AMSAT-NA/fox-plus/structure/3d_models/CommercialFrame/4.jpg

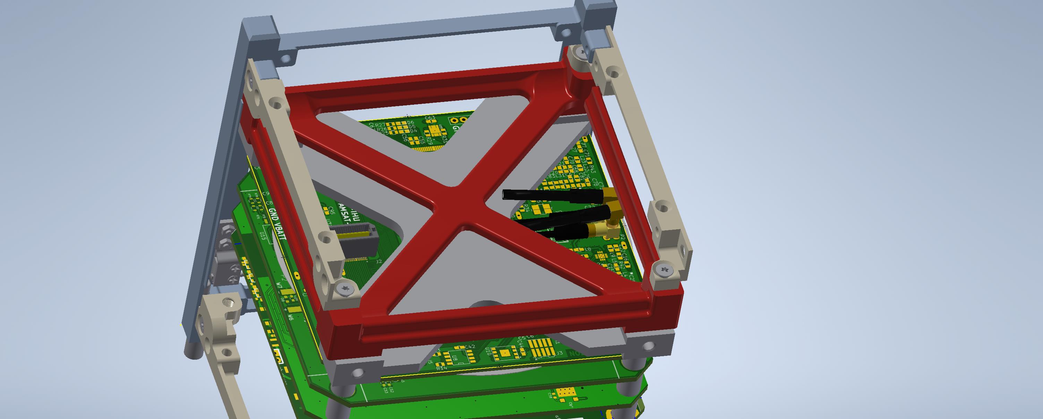
structure/3d_models/CommercialFrame/4.jpg
