AMSAT-NA/fox-plus/mechanical/README.md

# Fox-Plus Mechanical

This is the home for the Fox-Plus Mechanical Team. Here we store all mechanical models, drawings, spec sheets, presentations, and documents.

## Description

The Mechanical team is responsible for all mechanical aspects of the Fox-Plus line of Amateur Satellites. 

## Authors

Andrew Robinson
