AMSAT-NA/fox-plus/mechanical/presentations/FoxPlusA_Images.pptx

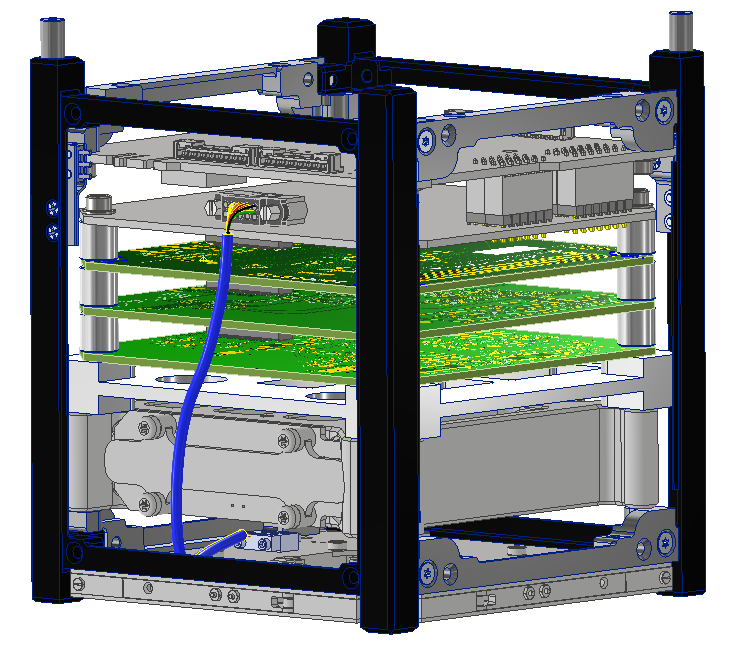
[picture p3: figure]

ISISpace 1U Frame

ISISpace Power Integration Unit (PIU)

FOX-ME-204 Power Signal Adapter (PSA)

LIHU

ICR

RXTX

FOX-ME-203 Mechanical Adapter

ISISpace Power Battery Pack (PBP)

ISISpace AntS

## Slide 2

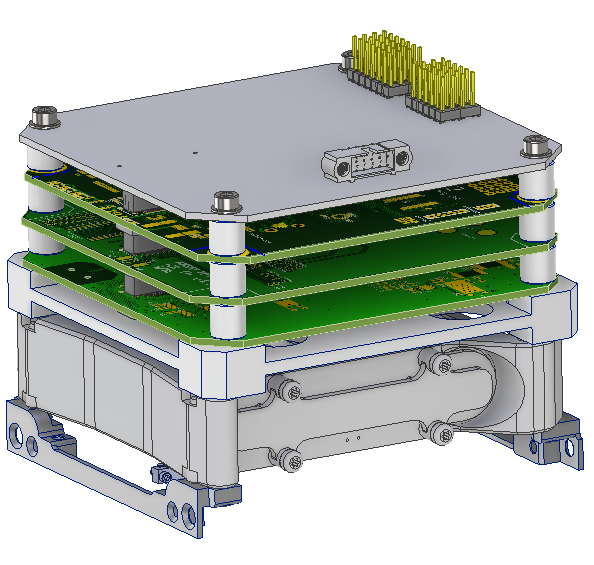
[picture p4: figure]
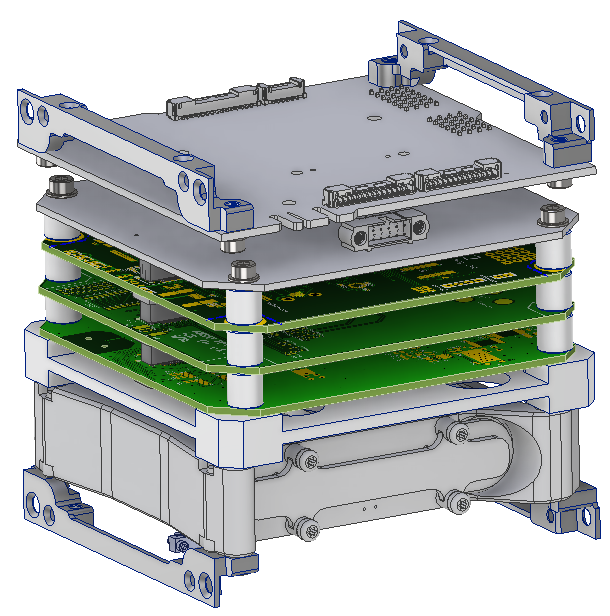
[picture p5: figure]
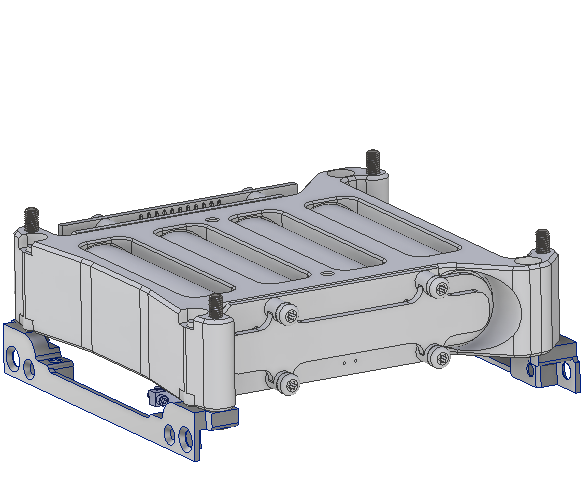
[picture p6: figure]
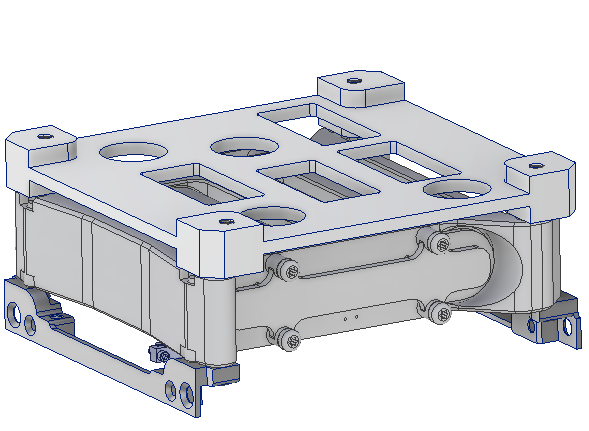
[picture p7: figure]

## Slide 3

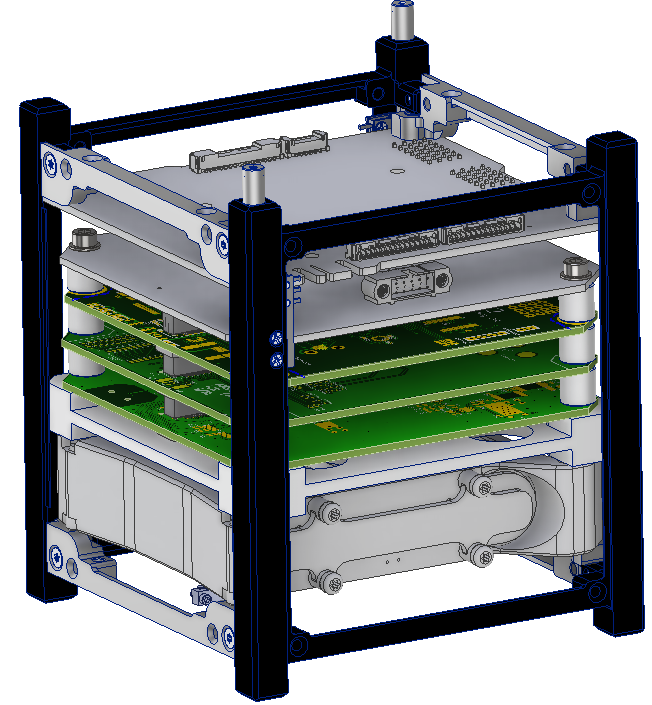
[picture p8: figure]
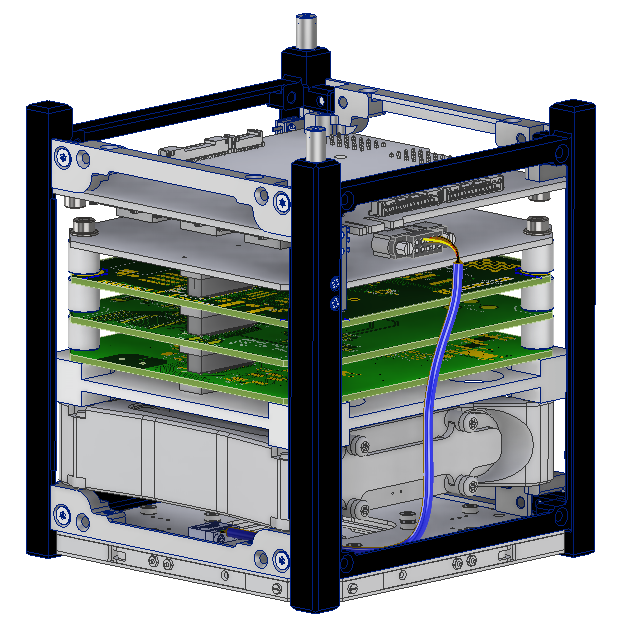
[picture p9: figure]

## Slide 4

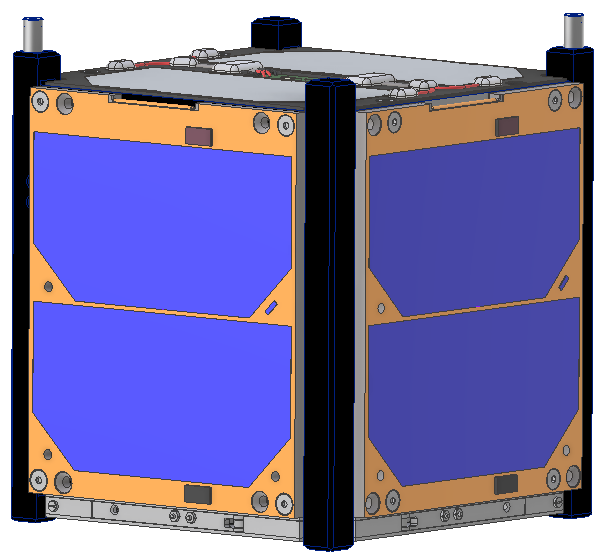
[picture p10: figure]

## Slide 5

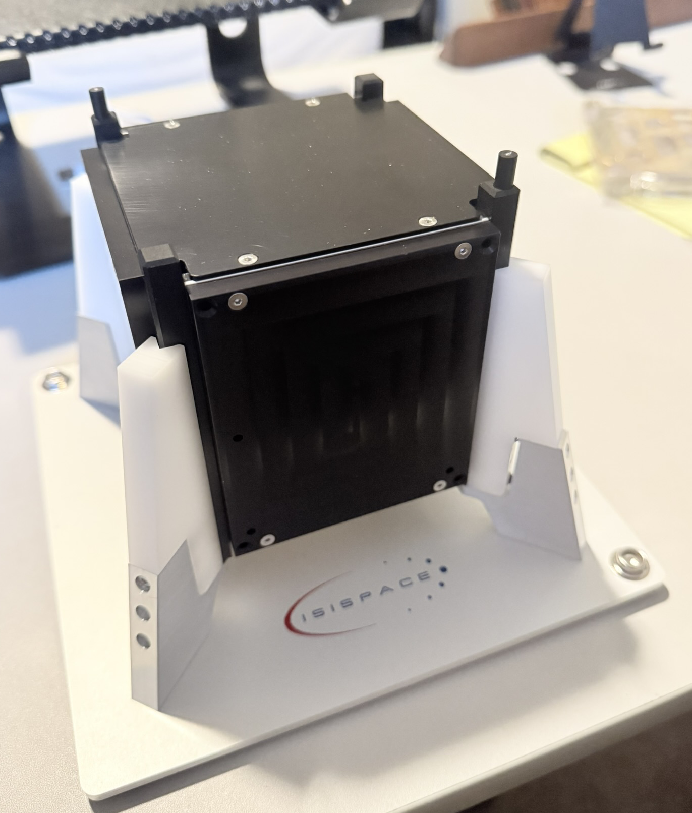
[picture p11: figure]
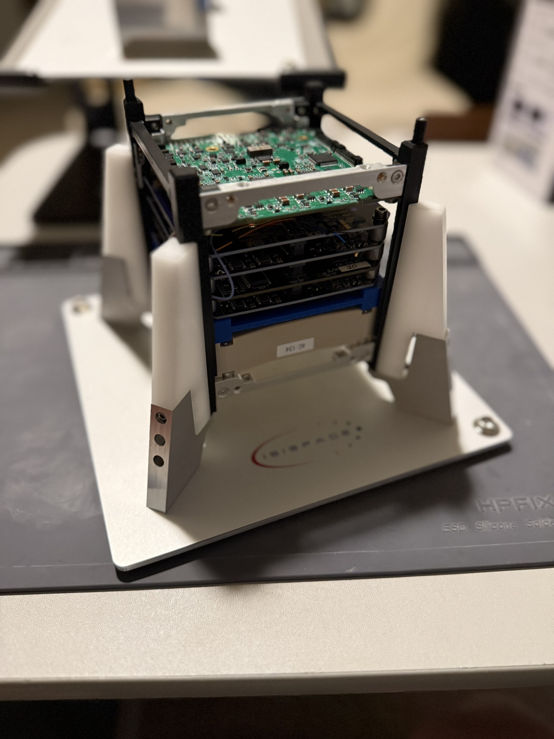
[picture p12: figure]

## Slide 6

## Slide 7

## Slide 8
