AMSAT-NA/fox-plus/mechanical/presentations/FoxPlusMechanical_20260218.pptx

## Fox Plus Mechanical

Topic: Umbilical Connector

Andrew Robinson
KA3WDW
18Feb2026

## Slide 2

FoxPlus-A Umbilical Concept

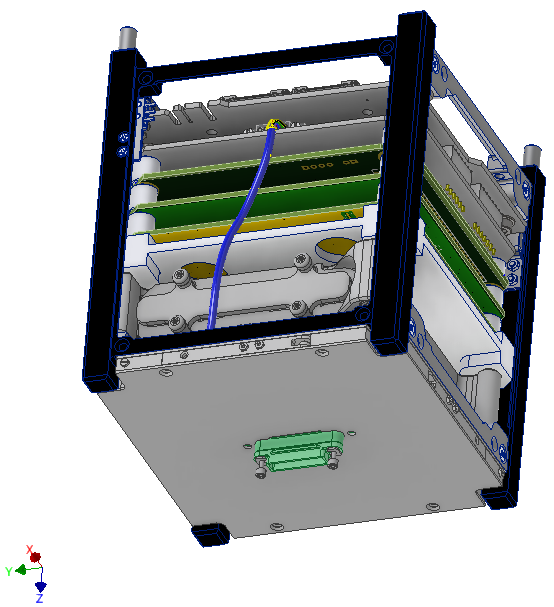
[picture p13: figure]

Harwin G125-3242696M5

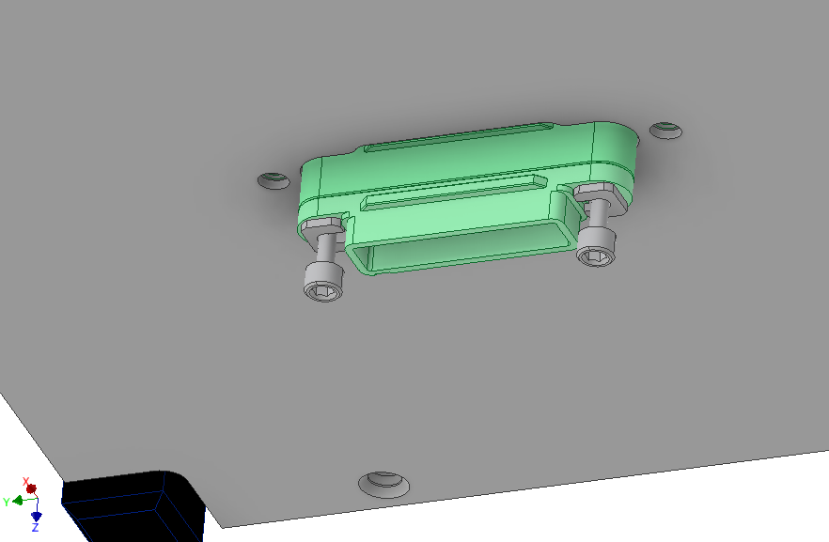
[picture p14: figure]

Harwin G125-2242696F1

## Slide 3

FoxPlus-A Umbilical Concept

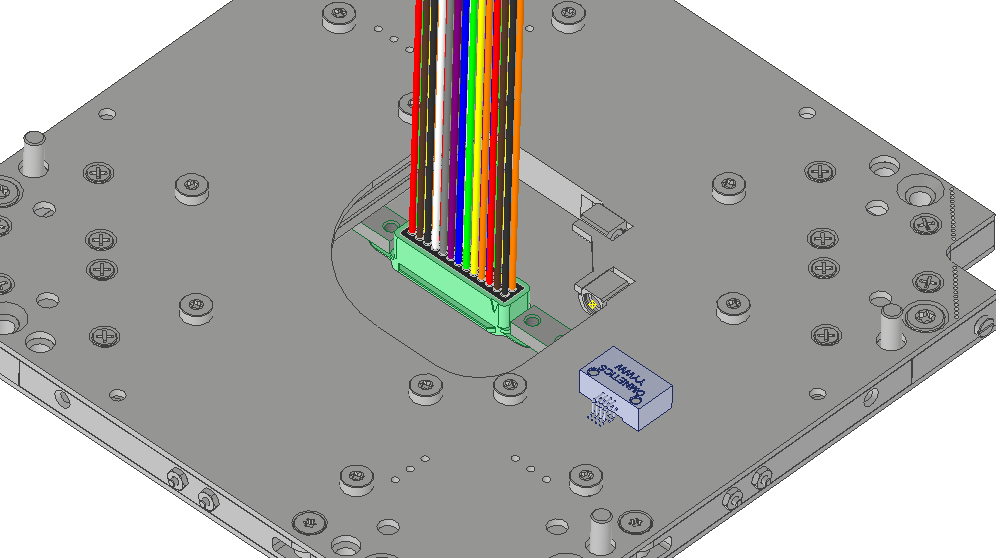
[picture p15: figure]

ISISpace AntS

## Slide 4

Umbilical Connector +Z-Face Protrusion

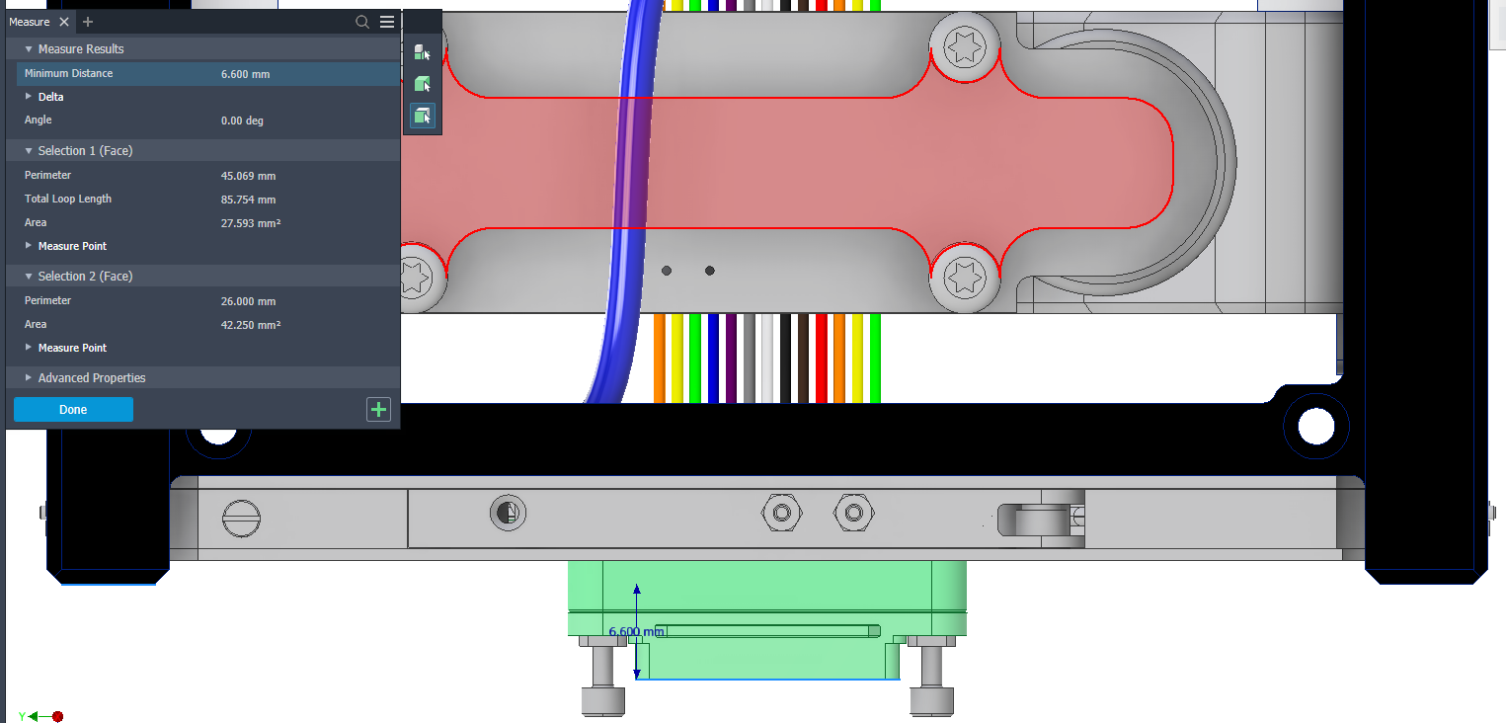
[picture p16: figure]

6.600 mm

## Slide 5

CubeSat Design Specification Rev. 14

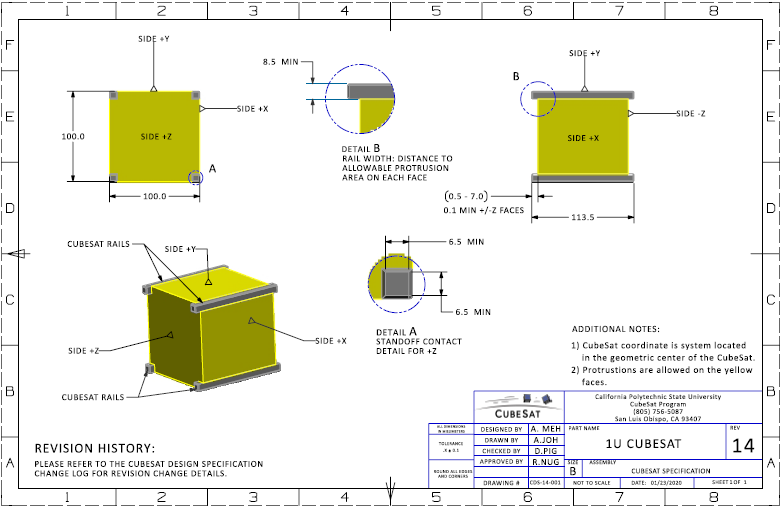
[picture p17: figure]

## Slide 6

Optional Connector – 34 Pin

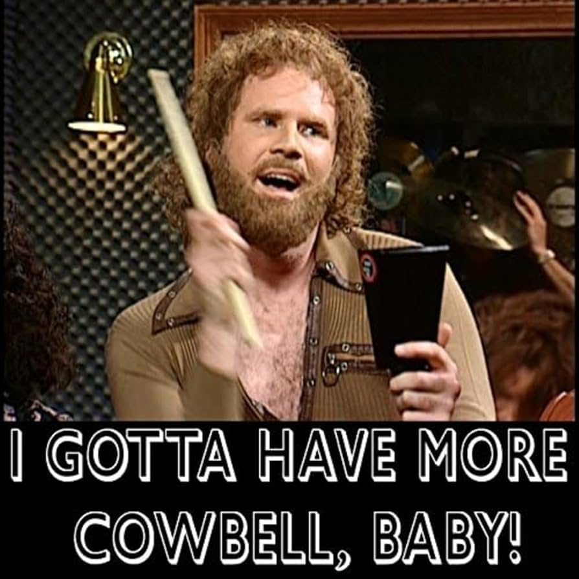
[picture p18: figure]
More Cowbell Decal "More Cowbell" Funny Bumper Sticker - Saturday Night Live SNL Skit Quote With Free Magnetizer Will Ferrell Novelty

PINS

Minor interference

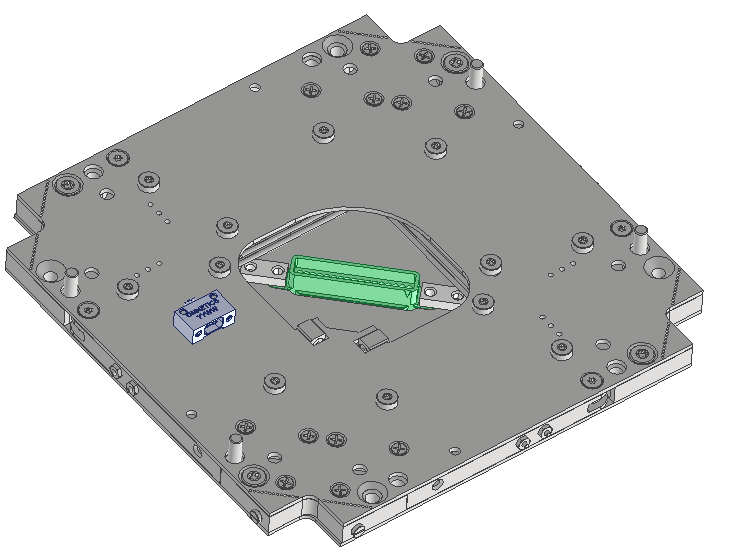
[picture p19: figure]
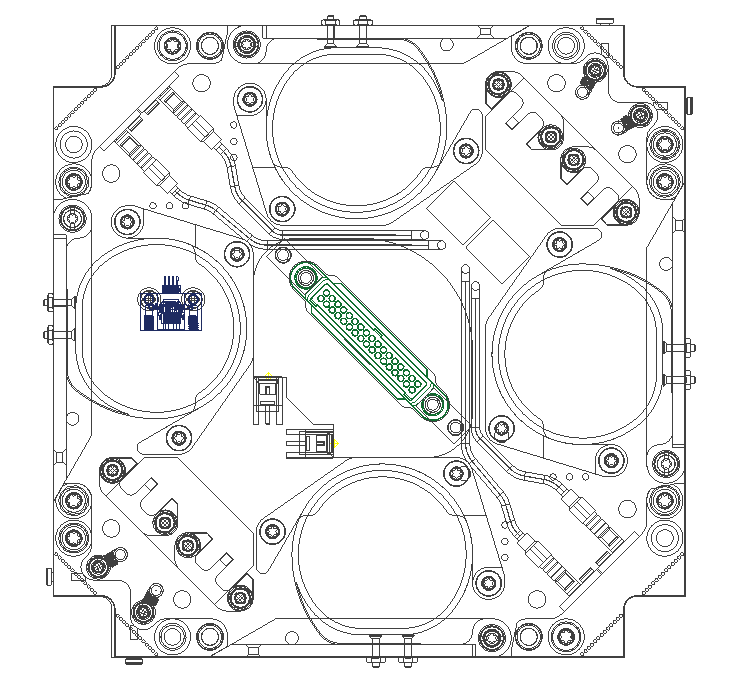
[picture p20: figure]

Harwin G125-3243496M5
