AMSAT-NA/fox-plus/mechanical/presentations/FoxPlusMechanical_20241211.pptx

## Fox+ Mechanical

Andrew Robinson
KA3WDW
11Dec2024

## Motivation

PC-104

CSKB

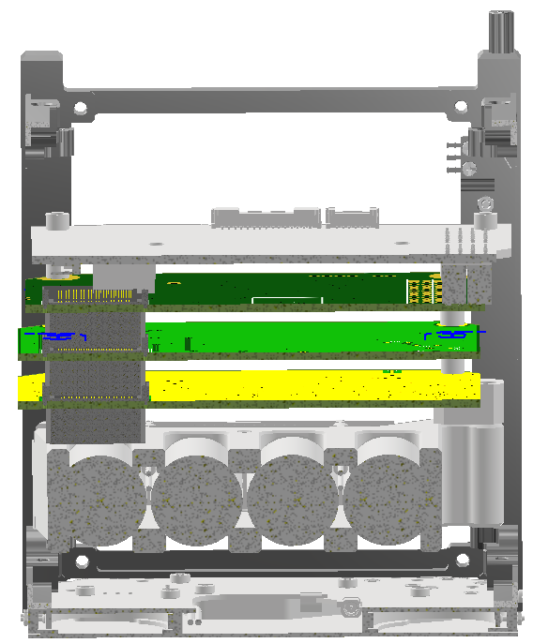
[picture p21: figure]

Unfavorable Alignment

X-Section

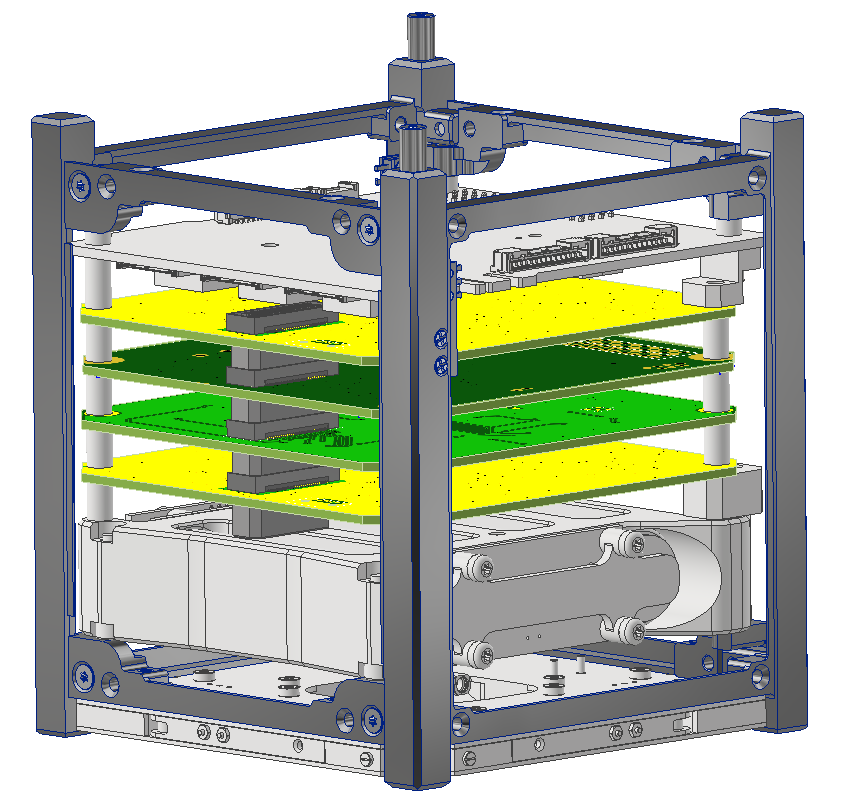
[picture p22: figure]

ISISpace PIU

Mate via PC-104 and CSKB

LIHU

REMOVED

## Idea

Is this correct?

Reposition PC-104 to mate with ISISpace EPS CSKB

95 mm

92 mm

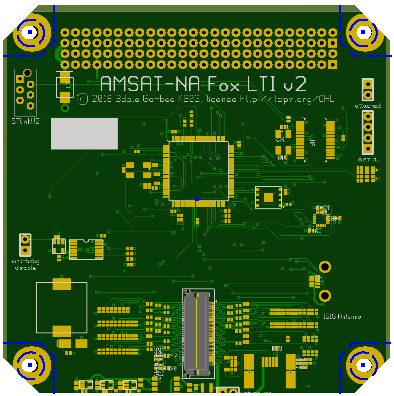
[picture p23: figure]
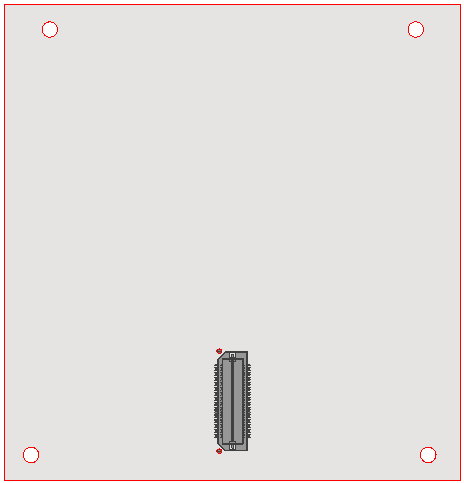
[picture p24: figure]

95 mm

TBD Modifications

96 mm

Maintain QxH location

ME-113 PCB

ISISpace PCB

Mounting thru holes (x4)
