AMSAT-NA/fox-plus/mechanical/presentations/FoxPlusMechanical_20241219.pptx

## Fox+ Mechanical

Andrew Robinson
KA3WDW
19Dec2024

## Slide 2

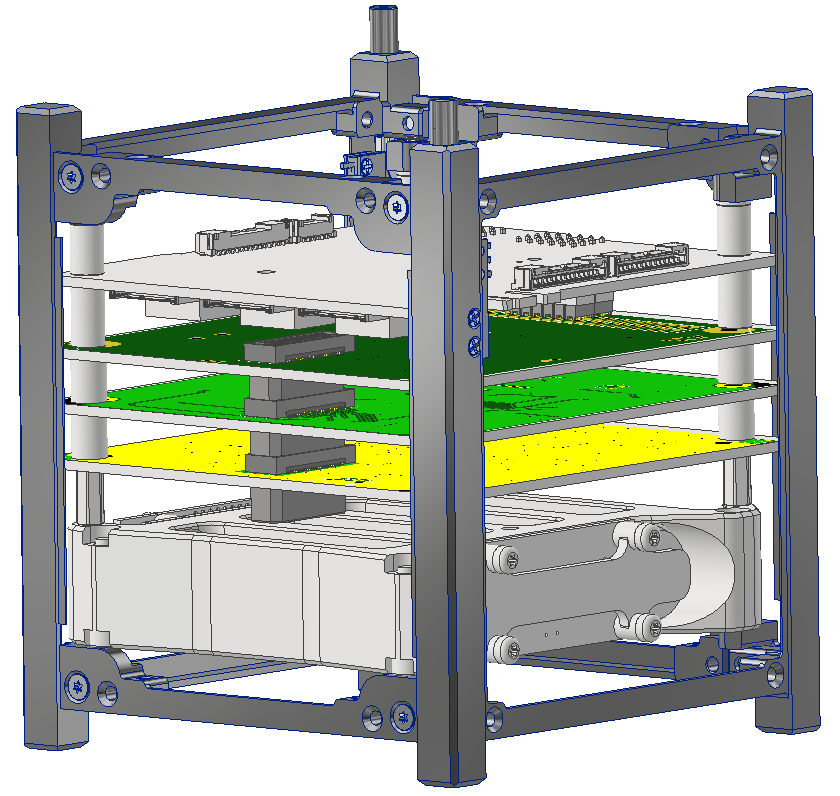
[picture p30: figure]

## Slide 3

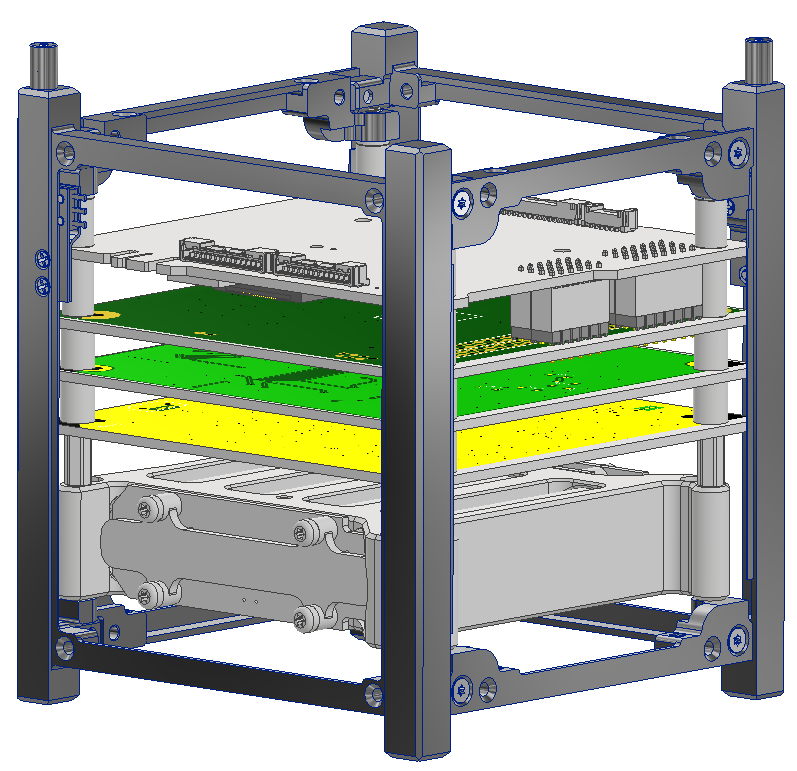
[picture p31: figure]

Only 9.761mm

(2) MTSW-107-08-L-D

(2) MTSW-106-08-L-D

## Slide 4

LIHU w/Header Pins

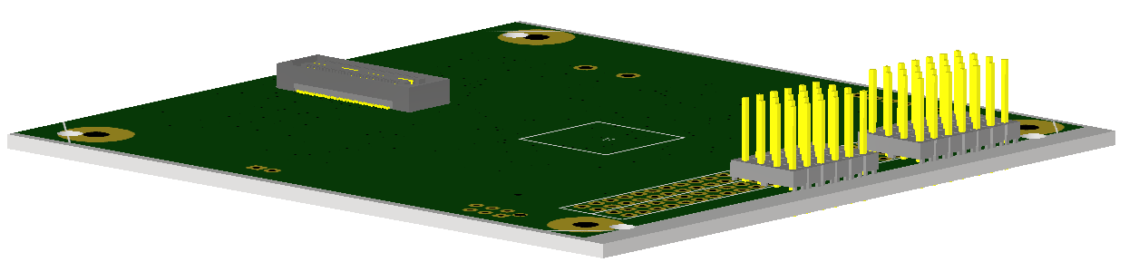
[picture p32: figure]

## Slide 5

Stack Up Hardware

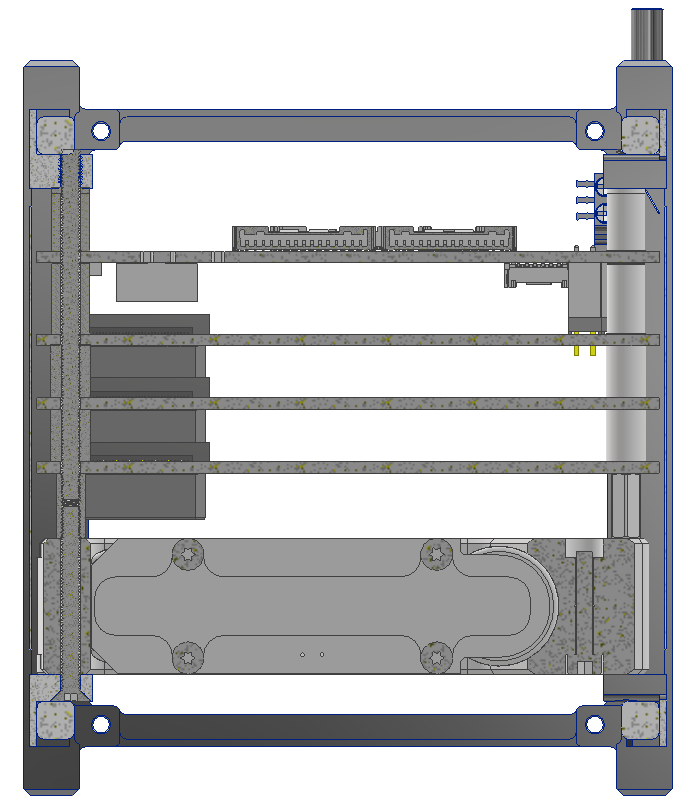
[picture p33: figure]

9mm Spacer + Shim (COTS)

M3 Threaded Rod (COTS + Machined to Length)

11mm Spacer (COTS)

FOX-ME-117-01 Spacers

M3x10mm Threaded Standoff (COTS)

(Made this 10mm instead of 8mm to enable sufficient thread engagement for M3x30 c’sunk and threaded rod)

M3x30mm C’Sunk Fastener (COTS)

X-Section View
