AMSAT-NA/fox-plus/mechanical/presentations/FoxPlusMechanical_20241221.pptx

## Fox+ Mechanical

Andrew Robinson
KA3WDW
21Dec2024

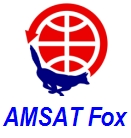
[picture p34: figure]

Topic: ISISpace EPS CSKB and LIHU PC-104 Alignment

## Slide 2

ISISpace EPS Board
(Transparent w/ outline)

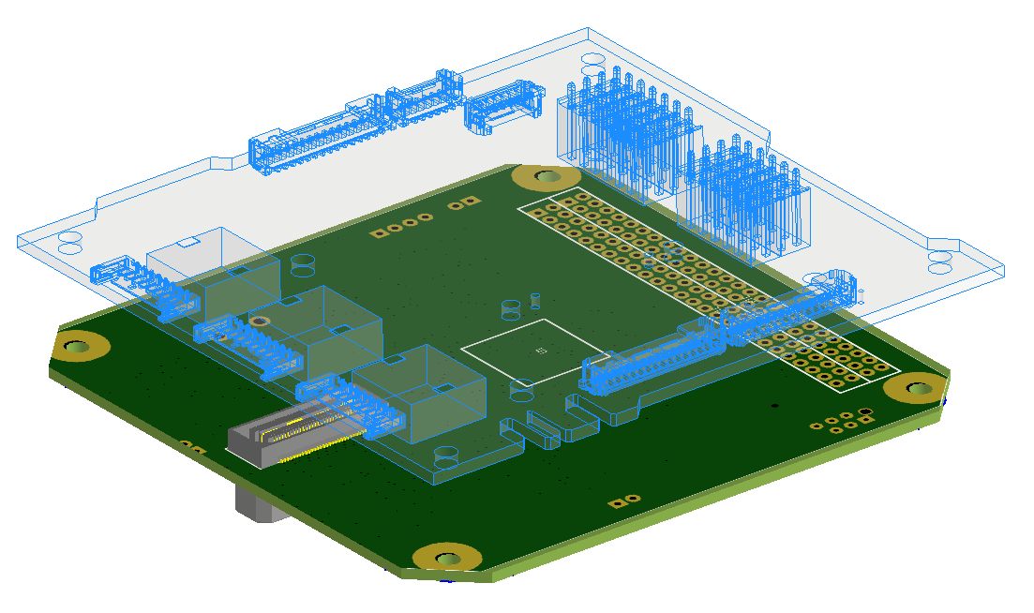
[picture p35: figure]

LIHU

## Slide 3

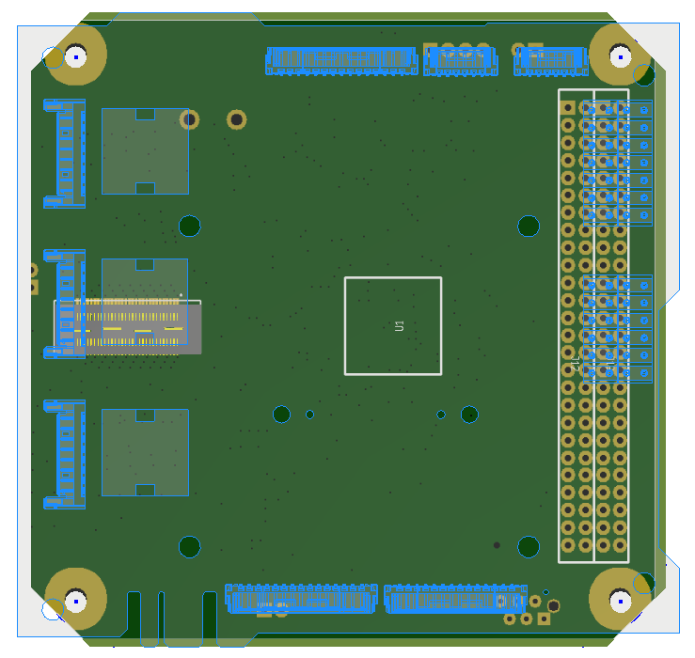
[picture p36: figure]

ISISpace EPS Board
(Transparent w/ outline)

LIHU

## Slide 4

92mm

Centered

The ISISpace EPS bolt holes must stay fixed (to align with the ISISpace frame) but the LIHU can slide to the left and to the right (by 2mm in each direction).

92mm

2mm

2mm

96mm

## Slide 5

LIHU Slid Right

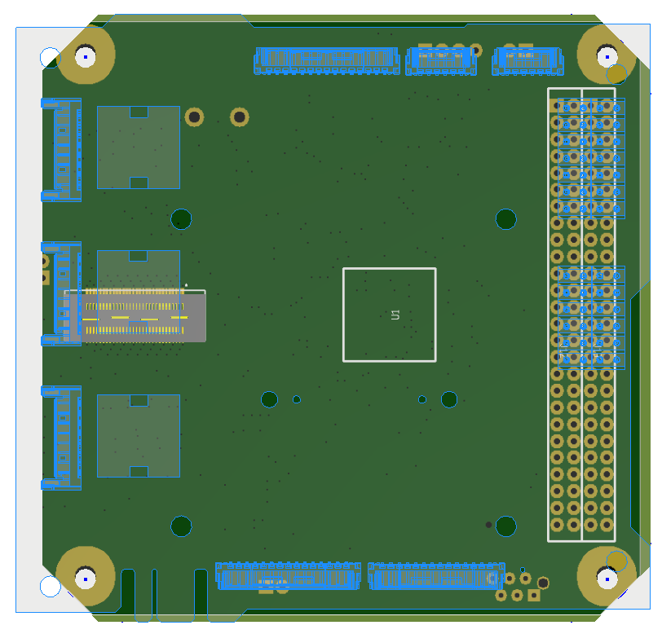
[picture p37: figure]

4mm

## Slide 6

LIHU Slid Left

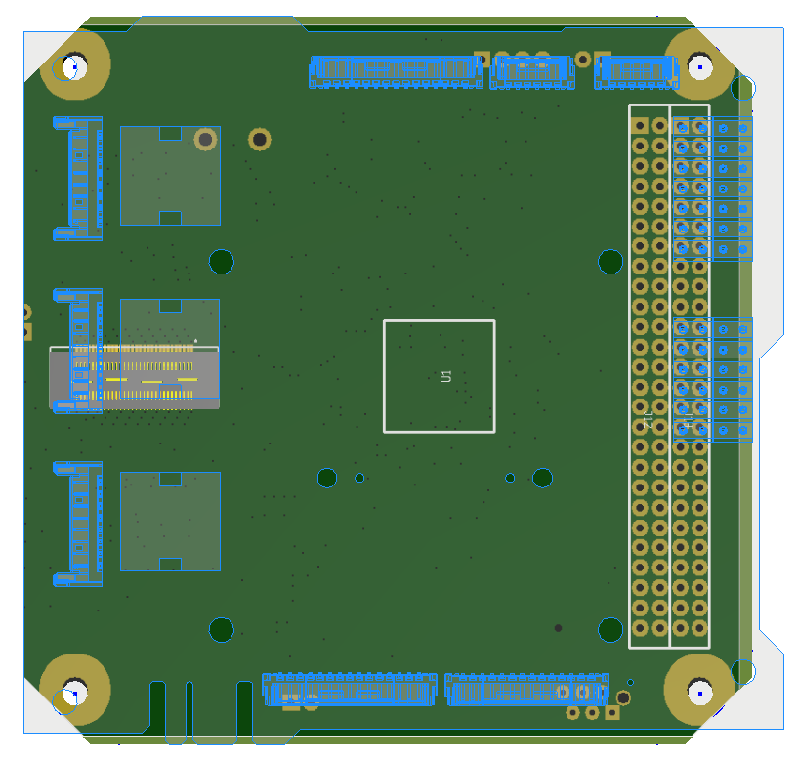
[picture p38: figure]

4mm
