AMSAT-NA/fox-plus/mechanical/presentations/FoxPlusMechanical_20250901.pptx

## Fox Plus Mechanical


Topic: Routing Cables Using Autodesk Inventor Cable and Harness

Andrew Robinson
KA3WDW
1Sept2025

## Slide 2

Model Screenshot


Note: Model currently Work In Progress (WIP)

Harwin M80-5301042 Connector on Power-Signal Adapter

Harwin M80-4611042 Connector

9 wires in user-defined “Segments” to route as desired

Omnetics A29100-009 Connector on AntS

Omnetics A28000-009 Connector

## Slide 3

Cable Drawing

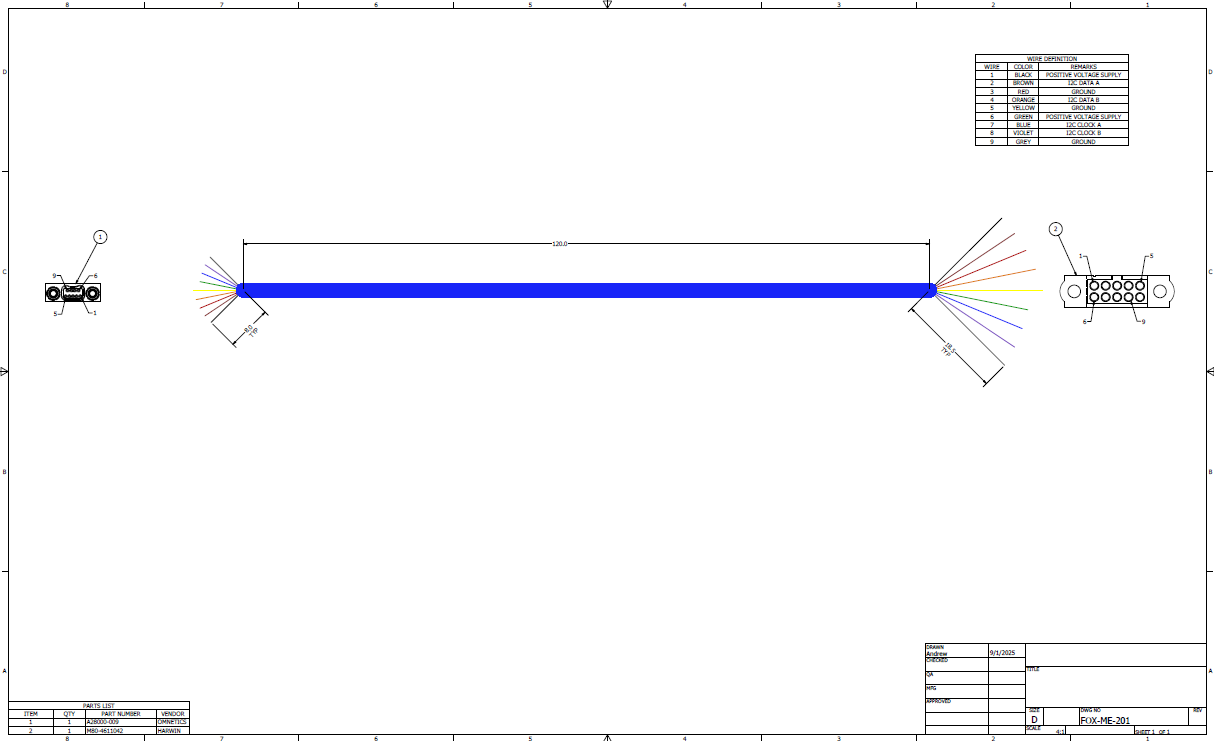
[picture p45: figure]

First cut at a drawing from cable layout

Wire details

Cable lengths

Connector
details

Connector
details

Model-driven BOM
