AMSAT-NA/fox-plus/block_diagram/high_level_block_diagram.pptx

## Fox-Plus-A High-Level Block Diagram

6 Solar
Panels

Power
Supply
Card

Battery
Card

Structure

70 cm
Antenna

Power bus

2 m
Antenna

Science
Payloads

IHU
Card

Magnetic Attitude
Control

RF TxRx
Card

Telemetry
