AMSAT-NA/fox-plus/weekly_engineering_meetings/2023-06-14/ASCENT-FOX+ Slide.odp

Fox-Plus A Block Diagram

1U Structure

Solar Panels

Power

Supply

Card

Battery

Card

6 Solar

Panels

70 cm

Antenna

Power bus

2 m

Antenna

Science

Payloads

IHU

Card

Passive

Magnetic Attitude

Control

Telemetry

RF TxRx

Card

## Slide 2

Fox-Plus-A

Minimum Viable Product

  - Commercial 1U frame (ISISpace)
  - Commercial EPS (ISISpace)
  - LTM
    - C&DH
    - TX/RX
  - RT-IHU (nice to have)
  - Passive attitude control (???)

## Slide 3

Recent Volunteers

## Slide 4

Job Jar

ICR EOL Replacement

Reaction Wheel Driver and Software

Fox-Plus A Launch Options Trade Study

ASCENT Leadership, Fox-Plus Leadership, and/or Volunteer Onboarding (share the fun!)

RT-IHU Board Checkout-Out Test Procedure

Golf-Tee Test Procedures

Thruster Working Group

Physical Golf-TEE Model

## Slide 5

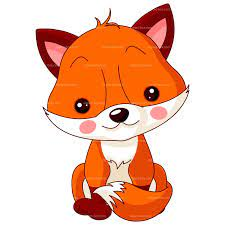
[picture p72: figure]

FOX+

What’s Happening?

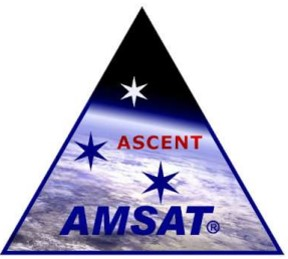
[picture p73: figure]

and

## Slide 6

GOLF-TEE

- Update CONOPS/PDR – Don Mills (present)
- Update SRS – Geoffrey Gentile (present)
- Radiation Research – Carl Wick

## Slide 7

Fox-Plus Systems Engineering

- Objective
  - Advance systems engineering tasks
- Team
  - Mike Moore (contacted)
- Current Activity
  - Frequency Coordination
  - Fox-Plus PDR
    - Jonathan action item: have posted ISISpace data sheets to AMSAT internal gitlab (yet another repository)

## Slide 8

Fox-Plus Structure

- Objective
  - Model the Fox-Plus stack
- Team
  - Thomas Wu (present)
  - Duane Moberg (present)
- Current Activity
  - Need to adapt Fox boards to 1U frame (Thomas, Duane)
  - Model the Fox-Plus stack with LTM and ISISpace EPS (Thomas, Duane)
  - Ordered with 5 – 6 month lead time: (Jonathan) – Our money finally made it to their bank!!!
    - 2 x 1U frame
    - 2 x assembly jig
    - 2 x EPS
    - 1 x Ground Power
    - 2 x Deployable Antenna

## Slide 9

Fox-Plus C&DH (aka IHU) Flight Software

- Objective
  - Fox-Plus flight software
- Team
  - Dave McCoy
  - Chris Grill (present)
  - Will Brozovic (contacted)
- Current Activity
  - Assemble prototype environment (Dave)
  - Bring up LTM (Chris)

## Slide 10

Fox-Plus C&DH (aka IHU) Hardware

- Objective
  - Order a whole stack of LTMs
- Team
  - Leandra MacLennan (present)
  - Arun Kumar
- Current Activity
  - Get me some LTM sets for development (Leandra)
    - Starting on LIHU BoM
  - Order ICR parts (Jonathan)
    - Done (almost)!
  - ICR Assembly (Arun Kumar)
    - Jonathan to pull together parts
  - RX/TX assembly
    - Assembling two more and dealing with EOL (Dan)

## Slide 11

ASCENT Structure

- Objective
  - Develop 3U space frame
- Team
  - Tom Karnauskas (contacted)
- Current Activity
  - Design 3U frame
    - Model cards in candidate frame (Tom)

## Slide 12

ASCENT Multi-Chan FM

- Objective
  - Develop multi-channel FM Transponder
- Team
  - Andrew Robinson
  - Joseph DiVerdi (present)
- Current Activity
  - Survey open source designs (Andrew)

## Slide 13

ASCENT SSTV TX

- Objective
  - Develop SSTV transmitter
- Team
  - Will Brozovic (contacted)
- Current Activity
  - Reviewing SSTV (Will)

## Slide 14

ASCENT SDR Plan B

- Objective
  - Develop SDR for Golf (i.e., five-and-dime)
- Team
  - Rich Gopstein (contacted)
  - Ray Roberge (present)
- Current Activity
  - Build of Linux for ZedBoard (Rich)
  - Design radio board (Ray & Rich)

## Slide 15

RT-IHU

- Objective
  - Assemble RT-IHU Payload
- Team
  - Heimir Sverrisson (present)
  - Cameron Castillo (present)
  - Chris Grill (present)
- Current Activities
  - AMCOM (Heimir)
  - Layout RT-IHU V1.2 (Cameron)
  - Reliable Debug Board (Chris)

## Slide 16

ASCENT PACSAT

- Objective
  - Develop digital packet communication payload
- Team (typically on this call)
  - Jim McCullers (present)

## Slide 17

ASCENT Deployable Solar Panels

- Objective
  - Develop deployable solar panels
- Team
  - Duane Moberg (present)
- Current Activity
  - Design solar panel and hinge solution
    - Result is a model of solar panels and hinges that fit in the pockets of the currently envisioned 3U structure.
    - Are we ready to prototype real hardware? Any luck getting cells?
    - If things are going to plan, we had a meeting with Mark Kanawati earlier today.

## Slide 18

ASCENT RF Chip Trade Study

- Objective
  - Identify AX5043 Replacement
  - Identify LNA Replacement
- Team
  - Dave Hartrum
- Current Activity

## Slide 19

ASCENT Environmental Sensors

- Objective
  - Identify environmental sensor for CubeSat Simulator use by KidzSat.
- Team
  - Joseph DiVerdi (present)
- Current Activity
