AMSAT-NA/fox-plus/weekly_engineering_meetings/2023-06-21/ASCENT-FOX+ Slide.odp

Fox-Plus A Block Diagram

1U Structure

Solar Panels

Power

Supply

Card

Battery

Card

6 Solar

Panels

70 cm

Antenna

Power bus

2 m

Antenna

Science

Payloads

IHU

Card

Passive

Magnetic Attitude

Control

Telemetry

RF TxRx

Card

## Slide 2

Fox-Plus-A

Minimum Viable Product

  - Commercial 1U frame (ISISpace)
  - Commercial EPS (ISISpace)
  - LTM
    - C&DH
    - TX/RX
  - RT-IHU (nice to have)
  - Passive attitude control (???)

## Slide 3

Job Jar

ICR EOL Replacement

ASCENT Leadership, Fox-Plus Leadership, and/or Volunteer Onboarding (share the fun!)

Fox-Plus A Launch Options Trade Study

Reaction Wheel Driver and Software

RT-IHU Board Checkout-Out Test Procedure

Golf-Tee Test Procedures

Thruster Working Group

Physical Golf-TEE Model

## Slide 4


FOX+

What’s Happening?


and

## Slide 5

GOLF-TEE

- Update CONOPS/PDR – Don Mills (present)
- Update SRS – Geoffrey Gentile (present)
- Radiation Research – Carl Wick

## Slide 6

Fox-Plus Systems Engineering

- Objective
  - Advance systems engineering tasks
- Team
  - Mike Moore (present)
- Current Activity
  - Frequency Coordination
  - Fox-Plus PDR
    - Jonathan action item: have posted ISISpace data sheets to AMSAT internal gitlab (yet another repository)

## Slide 7

Fox-Plus Structure

- Objective
  - Model the Fox-Plus stack
- Team
  - Thomas Wu (absent)
  - Duane Moberg (present)
- Current Activity
  - Model the Fox-Plus stack with LTM and ISISpace EPS (Thomas, Duane)
  - Ordered with 5 – 6 month lead time: (Jonathan) – Our money finally made it to their bank!!!
    - 2 x 1U frame
    - 2 x assembly jig
    - 2 x EPS
    - 1 x Ground Power
    - 2 x Deployable Antenna

## Slide 8

Fox-Plus C&DH (aka IHU) Flight Software

- Objective
  - Fox-Plus flight software
- Team
  - Dave McCoy (absent)
  - Chris Grill (absent)
  - Will Brozovic (absent)
- Current Activity
  - Assemble prototype environment (Dave)
  - Bring up LTM (Chris)

## Slide 9

Fox-Plus C&DH (aka IHU) Hardware

- Objective
  - Order a whole stack of LTMs
- Team
  - Leandra MacLennan (absent)
  - Arun Kumar
- Current Activity
  - Get me some LTM sets for development (Leandra)
    - Starting on LIHU BoM
  - Order ICR parts (Jonathan)
    - Done (almost)!
  - ICR Assembly (Arun Kumar)
    - Jonathan to pull together parts
  - RX/TX assembly
    - Assembling two more and dealing with EOL (Dan)

## Slide 10

ASCENT Structure

- Objective
  - Develop 3U space frame
- Team
  - Tom Karnauskas (present)
- Current Activity
  - Design 3U frame
    - Model cards in candidate frame (Tom)

## Slide 11

ASCENT Multi-Chan FM

- Objective
  - Develop multi-channel FM Transponder
- Team
  - Andrew Robinson (present)
  - Joseph DiVerdi (present)
- Current Activity
  - Survey open source designs (Andrew)

## Slide 12

ASCENT SSTV TX

- Objective
  - Develop SSTV transmitter
- Team
  - Will Brozovic (notified)
- Current Activity
  - Reviewing SSTV (Will)

## Slide 13

ASCENT SDR Plan B

- Objective
  - Develop SDR for Golf (i.e., five-and-dime)
- Team
  - Rich Gopstein (present)
  - Ray Roberge (present)
- Current Activity
  - Build of Linux for ZedBoard (Rich)
  - Design radio board (Ray & Rich)

## Slide 14

RT-IHU

- Objective
  - Assemble RT-IHU Payload
- Team
  - Heimir Sverrisson (present)
  - Cameron Castillo (present)
  - Chris Grill (absent)
- Current Activities
  - AMCOM (Heimir)
  - Layout RT-IHU V1.2 (Cameron)
  - Reliable Debug Board (Chris)

## Slide 15

ASCENT PACSAT

- Objective
  - Develop digital packet communication payload
- Team (typically on this call)
  - Jim McCullers (present)

## Slide 16

ASCENT Deployable Solar Panels

- Objective
  - Develop deployable solar panels
- Team
  - Duane Moberg (present)
- Current Activity
  - Design solar panel and hinge solution
    - Ordered prototype components

## Slide 17

ASCENT RF Chip Trade Study

- Objective
  - Identify AX5043 Replacement
  - Identify LNA Replacement
- Team
  - Dave Hartrum (present)
- Current Activity

## Slide 18

ASCENT Environmental Sensors

- Objective
  - Identify environmental sensor for CubeSat Simulator use by KidzSat.
- Team
  - Joseph DiVerdi (present)
- Current Activity
