AMSAT-NA/fox-plus/weekly_engineering_meetings/2023-06-28/ASCENT-FOX+ Slide.odp

Fox-Plus A Block Diagram

1U Structure

Solar Panels

Power

Supply

Card

Battery

Card

6 Solar

Panels

70 cm

Antenna

Power bus

2 m

Antenna

Science

Payloads

IHU

Card

Passive

Magnetic Attitude

Control

Telemetry

RF TxRx

Card

## Slide 2

Fox-Plus-A

Minimum Viable Product

  - Commercial 1U frame (ISISpace)
  - Commercial EPS (ISISpace)
  - LTM
    - C&DH
    - TX/RX
  - RT-IHU (nice to have)
  - Passive attitude control (???)

## Slide 3

Job Jar

ICR EOL Replacement

ASCENT Leadership, Fox-Plus Leadership, and/or Volunteer Onboarding (share the fun!)

Fox-Plus A Launch Options Trade Study

Reaction Wheel Driver and Software

RT-IHU Board Checkout-Out Test Procedure

Golf-Tee Test Procedures

Thruster Working Group

Physical Golf-TEE Model

## Slide 4


FOX+

What’s Happening?


and

## Slide 5

AMCOM

- Objective
  - Linux build (I think)
- Team
  - Heimir Sverrisson
- Current Activities
  - AMCOM (Heimir)

## Slide 6

ASCENT PACSAT

- Objective
  - Develop digital packet communication payload
- Team (typically on this call)
  - Jim McCullers

## Slide 7

ASCENT Deployable Solar Panels

- Objective
  - Develop deployable solar panels
- Team
  - Duane Moberg
- Current Activity
  - Design solar panel and hinge solution
    - Ordered prototype components

## Slide 8

ASCENT RF Chip Trade Study

- Objective
  - Identify AX5043 Replacement
  - Identify LNA Replacement
- Team
  - Dave Hartrum
- Current Activity

## Slide 9

ASCENT Environmental Sensors

- Objective
  - Identify environmental sensor for CubeSat Simulator use by KidzSat.
- Team
  - Joseph DiVerdi
- Current Activity

## Slide 10

ASCENT SSTV TX

- Objective
  - Develop SSTV transmitter
- Team
  - Will Brozovic
- Current Activity
  - Reviewing SSTV (Will)

## Slide 11

ASCENT SDR Plan B

- Objective
  - Develop SDR for Golf
- Team
  - Rich Gopstein
  - Ray Roberge
- Current Activity
  - Build of Linux for ZedBoard (Rich)
  - Design radio board (Ray & Rich)

## Slide 12

ASCENT Structure

- Objective
  - Develop 3U space frame
- Team
  - Tom Karnauskas
- Current Activity
  - Design 3U frame
    - Model cards in candidate frame (Tom)

## Slide 13

ASCENT Multi-Chan FM

- Objective
  - Develop multi-channel FM Transponder
- Team
  - Andrew Robinson
  - Joseph DiVerdi
- Current Activity
  - Survey open source designs (Andrew)

## Slide 14

RT-IHU

- Objective
  - Assemble RT-IHU Payload
- Team
  - Cameron Castillo
  - Chris Grill
- Current Activities
  - Layout RT-IHU V1.2 (Cameron)
  - Reliable Debug Board (Chris)

## Slide 15

Fox-Plus Systems Engineering

- Objective
  - Advance systems engineering tasks
- Team
  - Mike Moore
- Current Activity
  - Frequency Coordination
  - Fox-Plus PDR

## Slide 16

Fox-Plus Structure

- Objective
  - Model the Fox-Plus stack
- Team
  - Thomas Wu
  - Duane Moberg
- Current Activity
  - Model the Fox-Plus stack with LTM and ISISpace EPS (Thomas, Duane)
  - Ordered with 5 – 6 month lead time: (Jonathan) – Our money finally made it to their bank!!!
    - 2 x 1U frame
    - 2 x assembly jig
    - 2 x EPS
    - 1 x Ground Power
    - 2 x Deployable Antenna

## Slide 17

Fox-Plus C&DH (aka IHU) Hardware

- Objective
  - Order a whole stack of LTMs
- Team
  - Leandra MacLennan
  - Arun Kumar
- Current Activity
  - Get me some LTM sets for development (Leandra)
    - Starting on LIHU BoM
  - ICR Assembly (Arun Kumar)
    - Jonathan has all the parts and needs to kit them for Arun
  - RX/TX assembly
    - Assembling two more and dealing with EOL (Dan)

## Slide 18

GOLF-TEE

- Update CONOPS/PDR – Don Mills
- Update SRS – Geoffrey Gentile
- Radiation Research – Carl Wick
