AMSAT-NA/fox-plus/weekly_engineering_meetings/2023-05-03/ASCENT-FOX+ Slide.odp

Fox-Plus A Block Diagram

1U Structure

Solar Panels

Power

Supply

Card

Battery

Card

6 Solar

Panels

70 cm

Antenna

Power bus

2 m

Antenna

Science

Payloads

IHU

Card

Passive

Magnetic Attitude

Control

Telemetry

RF TxRx

Card

## Slide 2

Fox-Plus-A

Minimum Viable Product

  - Commercial 1U frame (ISISpace)
  - Commercial EPS (ISISpace)
  - LTM
    - C&DH
    - TX/RX
  - RT-IHU (nice to have)
  - Passive attitude control (???)

## Slide 3

Recent Volunteers

- Dr. Joseph DiVerdi
  - Team Lead and/or Hardware Design?
- Douglas Quagliana
  - Welcome back!
- Neil Heft
  - Reaction Wheel Driver

## Slide 4

Job Jar

Reaction Wheel Driver and Software (Neil?)

Fox-Plus A Launch Options Trade Study

ASCENT Leadership, Fox-Plus Leadership, and/or Volunteer Onboarding (share the fun!)

RT-IHU Board Checkout-Out Test Procedure

Golf-Tee Test Procedures

Thruster Working Group

## Slide 5


FOX+

What’s Happening?


and

## Slide 6

GOLF-TEE

- Update PDR – Don Mills
- Update SRS – Geoffrey Gentile
- Radiation Research – Carl Wick

## Slide 7

Fox-Plus Systems Engineering

- Objective
  - Advance systems engineering tasks
- Team
  - Mike Moore
- Current Activity
  - Frequency Coordination
  - Fox-Plus PDR

## Slide 8

Fox-Plus Structure

- Objective
  - Model the Fox-Plus stack
- Team
  - Thomas Wu
  - Duane Moberg
- Current Activity
  - Need to adapt Fox boards to 1U frame (Thomas, Duane)
  - Model the Fox-Plus stack with LTM and ISISpace EPS (Thomas, Duane)
  - Ordered with 5 – 6 month lead time: (Jonathan)
    - 2 x 1U frame
    - 2 x assembly jig
    - 2 x EPS
    - 1 x Ground Power
    - 2 x Deployable Antenna

## Slide 9

Fox-Plus C&DH (aka IHU) Flight Software

- Objective
  - Fox-Plus flight software
- Team
  - Dave McCoy
  - Chris Grill
  - Will Brozovic
- Current Activity
  - Assemble prototype environment (Dave)
  - Bring up LTM (Chris)

## Slide 10

Fox-Plus C&DH (aka IHU) Hardware

- Objective
  - Order a whole stack of LTMs
- Team
  - Leandra MacLennan
- Current Activity
  - Get me some LTM sets for development (Leandra)
    - Starting on LIHU BoM
  - Order ICR parts (Jonathan)
    - Done (almost)!
  - Order ICR boards (Jonathan)
    - Done
  - RX/TX assembly
    - Assembling two more and dealing with EOL (Dan)

## Slide 11

ASCENT Structure

- Objective
  - Develop 3U space frame
- Team
  - Tom Karnauskas
- Current Activity
  - Design 3U frame
    - Model cards in candidate frame (Tom)

## Slide 12

ASCENT Multi-Chan FM

- Objective
  - Develop multi-channel FM Transponder
- Team
  - Andrew Robinson
- Current Activity
  - Survey open source designs (Andrew)

## Slide 13

ASCENT SSTV TX

- Objective
  - Develop SSTV transmitter
- Team
  - Will Brozovic
- Current Activity
  - Reviewing SSTV (Will)

## Slide 14

ASCENT SDR Plan B

- Objective
  - Develop SDR for Golf (i.e., five-and-dime)
- Team
  - Rich Gopstein
  - Ray Roberge
- Current Activity
  - Build of Linux for ZedBoard (Rich)
  - Design radio board (Ray & Rich)
  - Obtain preliminary hardware (Jonathan)
    - Forwarded FMCOMMS3

## Slide 15

RT-IHU

- Objective
  - Assemble RT-IHU Payload
- Team
  - Zach Metzinger
  - Heimir Sverrisson
  - Cameron Castillo
  - Chris Grill
- Current Activities
  - Assemble V1.1 Development Boards (Zach)
    - Result is 5 more assembled V1.1 RT-IHU boards.
  - Flash Loader (Heimir)
    - Result is an updated flash loader to load the RT-IHU board
  - Layout RT-IHU V1.2 (Cameron)
  - Reliable Debug Board (Chris)

## Slide 16

ASCENT PACSAT

- Objective
  - Develop digital packet communication payload
- Team (typically on this call)
  - Jim McCullers

## Slide 17

ASCENT Deployable Solar Panels

- Objective
  - Develop deployable solar panels
- Team
  - Vincent Risalvato
  - Duane Moberg
- Current Activity
  - Design solar panel and hinge solution
    - Result is a model of solar panels and hinges that fit in the pockets of the currently envisioned 3U structure.
    - Are we ready to prototype real hardware? Any luck getting cells?
    - If things are going to plan, we had a meeting with Mark Kanawati earlier today.

## Slide 18

ASCENT RF Chip Trade Study

- Objective
  - Identify AX5043 Replacement
  - Identify LNA Replacement
- Team
  - Dave Hartrum
- Current Activity
