AMSAT-NA/fox-plus/weekly_engineering_meetings/2023-04-19/ASCENT-FOX+ Slide.odp

Fox-Plus A Block Diagram

1U Structure

Solar Panels

Power

Supply

Card

Battery

Card

6 Solar

Panels

70 cm

Antenna

Power bus

2 m

Antenna

Science

Payloads

IHU

Card

Passive

Magnetic Attitude

Control

Telemetry

RF TxRx

Card

## Slide 2

Fox-Plus-A

Minimum Viable Product

  - Commercial 1U frame (ISISpace???)
  - Commercial EPS (ISISpace?)
  - LTM
    - C&DH
    - TX/RX
  - RT-IHU (nice to have)
  - Passive attitude control

## Slide 3

Recent Volunteers

- Andrew Robinson - present
  - Hardware and/or RF?
  - Vendor Survey
- Geoffrey Gentile - present
  - Updating SRS
- Dr. Joseph DiVerdi
  - Team Lead and/or Hardware Design?
- Duane Moberg - present
  - Mechanical
  - Fox-Plus Structure
- Neil Heft
  - Reaction Wheel Driver and Slow-Scan Transmitter?
- Dave Lankinen
  - Board Layout?
- Will Brozovic - present
  - Flight Software, Slow-Scan Transmitter? IHU BoM?

## Slide 4

Job Jar

Fox-Plus A Research ISISpace Antenna Options

Fox-Plus A Launch Options Trade Study

ASCENT Design Multi-Channel FM Voice XCVR

Could be SDR or not

Slow-Scan Transmitter

New RF project

Test Procedures

I may have a volunteer coming

RT-IHU Board Checkout-Out Test Procedure

Reaction Wheel Driver and Software

Team Leadership (share the fun!)

## Slide 5


FOX+

What’s Happening?


and

## Slide 6

GOLF-TEE PDR

- Should this move to GOLF-TEE portion of this engineering meeting? - move to Golf presentation
- Objective
  - Coordinate updated PDR presentation.
  - Replace Ragnarok attitude determination and control system with commercial unit.
  - Other updates?
- Team
  - Don Mills
- Current Activity
  - Track down existing PDR examples and references

## Slide 7

Fox-Plus Systems Engineering

- Objective
  - Advance systems engineering tasks
- Team
  - Mike Moore
- Current Activity
  - List of Compliance Documents

## Slide 8

Fox-Plus Structure

- Objective
  - Model the Fox-Plus stack
- Team
  - Thomas Wu
  - Duane Moberg
- Current Activity
  - Need to adapt Fox boards to 1U frame (Thomas)
  - Model the Fox-Plus stack with LTM and ISISpace EPS
  - Trying to buy 1U frame and jig (Jonathan)
    - Having problems getting attention
    - NO LONGER LISTING FRAME AS AVAILABLE FOR SALE

## Slide 9

Fox-Plus EPS

- Objective
  - Buy the Fox-Plus EPS
- Team
  - Chris Grill
  - Jonathan Brandenburg – to review options
- Current Activity
  - Take ownership of the EPS options sheet after initial work
  - I think we’re almost there

## Slide 10

Fox-Plus C&DH (aka IHU) Flight Software

- Objective
  - Fox-Plus flight software
- Team
  - Dave McCoy
  - Chris Grill
- Current Activity
  - Assemble prototype environment (Dave)
  - Bring up LTM (Chris)

## Slide 11

Fox-Plus C&DH (aka IHU) Hardware

- Objective
  - Order a whole stack of LTMs
- Team
  - Leandra MacLennan
- Current Activity
  - Get me some LTM sets for development (Leandra)
    - Focusing on ICR – on to gerbers and such
    - Starting on LIHU
  - Order ICR parts (Jonathan)
    - I think I have all the parts ordered except the LOs
  - RX/TX assembly
    - Assembling two more and dealing with EOL (Dan)

## Slide 12

ASCENT Structure

- Objective
  - Develop 3U space frame
- Team
  - Tom Karnauskas
- Current Activity
  - Design 3U frame
    - Model cards in candidate frame (Tom)

## Slide 13

ASCENT SDR Plan B

- Objective
  - Develop SDR for Golf (i.e., five-and-dime)
- Team
  - Rich Gopstein
  - Ray Roberge
- Current Activity
  - Build of Linux for ZedBoard (Rich)
  - Design radio board (Ray & Rich)
  - Obtain preliminary hardware (Jonathan)
    - Received FMCOMMS3

## Slide 14

RT-IHU

- Objective
  - Assemble RT-IHU Payload
- Team
  - Zach Metzinger
  - Heimir Sverrisson
  - Cameron Castillo
  - Chris Grill
- Current Activities
  - Assemble V1.1 Development Boards (Zach)
    - Result is 5 more assembled V1.1 RT-IHU boards.
  - Flash Loader (Heimir)
    - Result is an updated flash loader to load the RT-IHU board
  - Layout RT-IHU V1.2 (Cameron)
  - Reliable Debug Board (Chris)

## Slide 15

ASCENT PACSAT

- Objective
  - Develop digital packet communication payload
- Team (typically on this call)
  - Jim McCullers

## Slide 16

ASCENT Deployable Solar Panels

- Objective
  - Develop deployable solar panels
- Team
  - Vincent Risalvato
- Current Activity
  - Design solar panel and hinge solution
    - Result is a model of solar panels and hinges that fit in the pockets of the currently envisioned 3U structure.
    - Are we ready to prototype real hardware? Any luck getting cells?
    - If things are going to plan, we had a meeting with Mark Kanawati earlier today.

## Slide 17

ASCENT RF Chip Trade Study

- Objective
  - Identify AX5043 Replacement
- Team
  - Dave Hartrum
- Current Activity
