AMSAT-NA/fox-plus/weekly_engineering_meetings/2023-02-08/ASCENT-FOX+ Slide.odp

Fox-Plus A Block Diagram

1U Structure

Solar Panels

Power

Supply

Card

Battery

Card

6 Solar

Panels

70 cm

Antenna

Power bus

2 m

Antenna

Science

Payloads

IHU

Card

Magnetic Attitude

Control

Telemetry

RF TxRx

Card

## Slide 2

Fox-Plus-A

Minimum Viable Product

  - Commercial 1U frame (ISISpace)
  - Commercial EPS (ISISpace?)
  - LTM
    - C&DH
    - TX/RX
  - RT-IHU (nice to have)
  - Passive attitude control

## Slide 3

Job Jar

Adapter for Fox boards in 1U frame

Build on previous work to adapt the Fox boards to the PC-104-based 1U frame

AX5043 Replacement

Find a replacement for the AX5043

Order 1U Frame

Order a 1U frame from ISISpace. What options?

## Slide 4

A

S

T

E

C

N


FOX+

What’s Happening?

and

## Slide 5

ASCENT Reaction Wheel

- Objective
  - Develop reaction wheels and motor control algorithms
- Team
  - Tom Davis
- Current Activity
  - Design Reaction Wheel controller board
- Keep in Mind
  - Possible Zero-G Flight

## Slide 6

Fox-Plus Systems Engineering

- Objective
  - Advance systems engineering tasks
- Team
  - Mike Moore
- Current Activity
  - Now moving on to high-level system design

## Slide 7

Fox-Plus Structure

- Objective
  - Buy the Fox-Plus Structure (and EPS)
- Team
  - Thomas Wu
- Current Activity
  - Select EPS so we can see how it fits into the 1U frame (Thomas)
  - We’re buying the structure ASAP (?)
  - Need to adapt Fox boards to 1U frame (?)

## Slide 8

Fox-Plus C&DH (aka IHU) Flight Software

- Objective
  - Fox-Plus flight software
- Team
  - Cameron Mahaffey
  - Dave McCoy
- Current Activity
  - Assemble prototype environment (Cameron & Dave)
  - Prototype slow scan transmitter (Cameron)
    - A slow scan transmitter developed on the TMS570 Launchpad using modified LTM build software stack

## Slide 9

Fox-Plus C&DH (aka IHU) Hardware

- Objective
  - Order a whole stack of LTMs
- Team
  - Leandra MacLennan
- Current Activity
  - Get me some LTM sets for development (Leandra)
    - Focusing on ICR
    - Picking up LIHU
  - One system on its way (Jonathan)
  - RX/TX assembly current by Dan

## Slide 10

ASCENT Structure

- Objective
  - Develop 3U space frame
- Team
  - Tom Karnauskas
- Current Activity
  - Design 3U frame
    - Looking into the options for an assembled frame

## Slide 11

ASCENT Deployable Solar Panels

- Objective
  - Develop deployable solar panels
- Team
  - Vincent Risalvato
- Current Activity
  - Design solar panel and hinge solution
    - Result is a model of solar panels and hinges that fit in the pockets of the currently envisioned 3U structure.
    - Are we ready to prototype real hardware? Any luck getting cells?

## Slide 12

ASCENT RF

- Objective
  - Develop radio-chip-based SDR
- Team
  - Mike Swiatkowski
- Current Activity
  - Design voice FM transponder board

## Slide 13

RT-IHU

- Objective
  - Assemble RT-IHU Payload
- Team
  - Zach Metzinger
  - Heimir Sverrisson
- Current Activities
  - Assemble V1.1 Development Boards (Zach)
    - Result is 5 more assembled V1.1 RT-IHU boards.
  - Flash Loader (Heimir)
    - Result is an updated flash loader to load the RT-IHU board

## Slide 14

ASCENT PACSAT

- Objective
  - Develop digital packet communication payload
- Team (typically on this call)
  - Bill Reed
  - Jim McCullers
