AMSAT-NA/fox-plus/weekly_engineering_meetings/2023-01-04/ASCENT-FOX+ Slide.odp

Fox-Plus A Block Diagram

1U Structure

Solar Panels

Power

Supply

Card

Battery

Card

6 Solar

Panels

70 cm

Antenna

Power bus

2 m

Antenna

Science

Payloads

IHU

Card

Magnetic Attitude

Control

Telemetry

RF TxRx

Card

## Slide 2

Job Jar

Prototype Slow-Scan Transmitter

Prototype a slow-scan transmitter using an embedded platform

LTM Hardware

Need somebody to manage the generation of additional LTM sets

## Slide 3

A

S

T

E

C

N


FOX+

What’s Happening?

and

## Slide 4

Fox-Plus Systems Engineering

- Objective
  - Advance systems engineering tasks
- Team
  - Mike Moore
- Current Activity
  - Begin working on power budget

## Slide 5

Fox-Plus Structure

- Objective
  - Fox-Plus Structure
- Team
  - Thomas Wu
  - Marwan Aylouche
- Current Activity
  - Research ISISpace component options for inclusion in 1U Fox-Plus (Thomas)
  - Model Fox boards plus EPS in ISISpace 1U frame (Marwan)

## Slide 6

Fox-Plus C&DH (aka IHU) Flight Software

- Objective
  - Fox-Plus flight software
- Team
  - Cameron Mahaffey
  - Dave McCoy
  - Chris Grill
- Current Activity
  - Assemble prototype environment
  - Identify Goals of Generalized LTM
    - Result is a list of desired changes in the LTM software better supporting the varying needs of different recipients.

## Slide 7

Fox-Plus C&DH (aka IHU) Hardware

- Objective
  - Fox-Plus LTM
- Team
  - TBD
- Current Activity
  - Get me some LTM sets for development
  - One system coming together now (Eric)

## Slide 8

ASCENT Structure

- Objective
  - Develop 3U space frame
- Team
  - Tom Karnauskas
- Current Activity
  - Design 3U frame
    - Looking into the options for an assembled frame

## Slide 9

ASCENT Deployable Solar Panels

- Objective
  - Develop deployable solar panels
- Team
  - Vincent Risalvato
- Current Activity
  - Design solar panel and hinge solution
    - Result is a model of solar panels and hinges that fit in the pockets of the currently envisioned 3U structure.
    - Are we ready to prototype real hardware? Any luck getting cells?

## Slide 10

ASCENT Reaction Wheel

- Objective
  - Develop reaction wheels and motor control algorithms
- Team
  - Tom Davis
- Current Activity
  - Design Reaction Wheel controller board
- Keep in Mind
  - Possible Zero-G Flight

## Slide 11

ASCENT RF

- Objective
  - Develop radio-chip-based SDR
- Team
  - Mike Swiatkowski
- Current Activity
  - Design voice FM transponder board

## Slide 12

ASCENT PACSAT

- Objective
  - Develop digital packet communication payload
- Team (typically on this call)
  - Bill Reed
  - Jim McCullers

## Slide 13

RT-IHU

- Objective
  - Assemble RT-IHU Payload
- Team
  - Zach Metzinger
  - Jim McCullers
  - Heimir Sverrisson
- Current Activities
  - Assemble V1.1 Development Boards (Zach)
    - Result is 5 more assembled V1.1 RT-IHU boards.
  - Assemble RT-IHU Breakout Board (Jim)
    - Result is two RT-IHU breakout boards
    - DONE!
  - Change connection on debug boards (Jim)
    - Result is 12 debug boards
    - DONE!!
  - Flash Loader (Heimir)
    - Result is an updated flash loader to load the RT-IHU board
