AMSAT-NA/fox-plus/weekly_engineering_meetings/2022-12-07/ASCENT-FOX+ Slide.odp

Fox-Plus A Block Diagram

1U Structure

Power

Supply

Card

Battery

Card

6 Solar

Panels

70 cm

Antenna

Power bus

2 m

Antenna

Science

Payloads

IHU

Card

MagneticAttitude

Control

Telemetry

RF TxRx

Card

## Slide 2

Status Board

a/o 7/13/2022

| Dev Sat
Flight Computer | Metzinger
Flight Software | McCoy, Grill, Severrisson
Flight TxRx | Swiatkowski
Structure | Karnauskas, Wu, Aylouche
Power Supply & Batts | Moravec
Sensors (various)
Ground System
Reaction Wheels | Davis
Deployable Solar Panels | Risalvato

| Dev Sat
Power Budget
CONOPS/PSAM/SRS | Moore
Thermal Budget
Link Budget
Launch Integration
Regulatory Approval
Operations
Vibration Test
Thermal & Vacuum Test
PACSAT | Reed, McCullers

## Slide 3

Job Jar

Design V/u FM Transponder

Design an analog U/v FM transponder using either novel design or based on simplifying Fox transceiver

Prototype Slow-Scan Transmitter

Prototype a slow-scan transmitter using an embedded platform

## Slide 4

A

S

T

E

C

N


FOX+

What’s Happening?

and

## Slide 5

RT-IHU (Zach Metzinger)

- Objective
  - Develop RT-IHU
- Current Activity
  - Assemble V1.1 Development Boards
    - Result is 5 more assembled V1.1 RT-IHU boards.

## Slide 6

ASCENT PACSAT (Bill Reed)

- Objective
  - Develop digital packet communication payload
- Current Activity
  - Team Lead

## Slide 7

ASCENT PACSAT (Jim McCullers)

- Objective
  - Software
- Current Activity
  - PACSAT
  - Assemble RT-IHU Breakout Board
    - Result is two RT-IHU breakout boards
    - Ordered headers
    - Hopefully progress this weekend
  - Change connection on debug boards
    - Result is 12 debug boards
    - DONE!!!

## Slide 8

ASCENT Structure (Tom Karnauskas)

- Objective
  - Develop 3U space frame
- Current Activity
  - Design 3U frame
    - Result is 3U open source frame (1st customer is Golf)
    - Sending model for evaluation by Prototyping shop

## Slide 9

Fox-Plus Structure (Thomas Wu)

- Objective
  - Fox-Plus Structure
- Current Activity
  - Research ISISpace component options

## Slide 10

Fox-Plus Systems Engineering (Mike Moore)

- Objective
  - Advance systems engineering tasks
- Current Activity
  - Begin working on power budget

## Slide 11

Fox-Plus RF (Mike Swiatkowski)

- Objective
  - Develop radio-chip-based SDR
- Current Activity
  - Examining existing Fox FM RF boards for end-of-life parts
    - Result is a list of components that require replacement and potential replacements.
    - Many EOL parts… likely can’t update the existing Fox-1 FM board
    - Next? SDR? Dual-conversion? Low-IF (from UK?)

## Slide 12

Fox-Plus Flight Software (Cameron Mahaffey)

- Objective
  - Fox-Plus flight software
- Current Activity
  - Get familiar with LTM materials (schematics, ICDs)
  - Get familiar with the flight software

## Slide 13

Fox-Plus Flight Software (Dave McCoy)

- Objective
  - Fox-Plus flight software
- Current Activity
  - Get familiar with flight software

## Slide 14

Fox-Plus Flight Software (Chris Grill)

- Objective
  - Fox-Plus flight software
- Current Activity
  - Identify Goals of Generalized LTM
    - Result is a list of desired changes in the LTM software better supporting the varying needs of different recipients.
  - RT-IHU Debug Cable
    - Result is a small board containing the debug circuitry and cabling for the TMS570

## Slide 15

Fox-Plus Flight Software (Heimir Sverrisson)

- Objective
  - Fox-Plus flight software
- Current Activity
  - Flash Loader
    - Result is an updated flash loader to load the RT-IHU board

## Slide 16

ASCENT Reaction Wheel (Tom Davis)

- Objective
  - Develop reaction wheels and motor control algorithms
- Current Activity
  - Clean up control algorithm code
    - Result is an algorithm on a prototype board controlling the wheels in a simulated pointing scenario.
  - Generate and update models
    - Results is Shapr3D models of the reaction wheel components, fixtures, and tools

## Slide 17

ASCENT Deployable Solar Panels (Vincent Risalvato)

- Objective
  - Develop deployable solar panels
- Current Activity
  - Design solar panel and hinge solution
    - Result is a model of solar panels and hinges that fit in the pockets of the currently envisioned 3U structure.
    - Are we ready to prototype real hardware? Any luck getting cells?

## Slide 18

Modeling (Marwan Aylouche)

- Objective
  - Develop Fox-Plus Models
- Current Activity
  - Develop models of commercial 1U structures?
    - Working with Thomas Wu, result are models of candidate commercial structures with Fox-1 boards?
