AMSAT-NA/fox-plus/weekly_engineering_meetings/2022-12-14/ASCENT-FOX+ Slide.odp

Fox-Plus A Block Diagram

1U Structure

Power

Supply

Card

Battery

Card

6 Solar

Panels

70 cm

Antenna

Power bus

2 m

Antenna

Science

Payloads

IHU

Card

MagneticAttitude

Control

Telemetry

RF TxRx

Card

## Slide 2

Job Jar

Prototype Slow-Scan Transmitter

Prototype a slow-scan transmitter using an embedded platform

## Slide 3

A

S

T

E

C

N


FOX+

What’s Happening?

and

## Slide 4

RT-IHU (Zach Metzinger)

- Objective
  - Develop RT-IHU
- Current Activity
  - Assemble V1.1 Development Boards
    - Result is 5 more assembled V1.1 RT-IHU boards.

## Slide 5

ASCENT PACSAT (Bill Reed)

- Objective
  - Develop digital packet communication payload
- Current Activity
  - Team Lead

## Slide 6

ASCENT PACSAT (Jim McCullers)

- Objective
  - Software
- Current Activity
  - PACSAT
  - Assemble RT-IHU Breakout Board
    - Result is two RT-IHU breakout boards
    - Ordered headers
    - Hopefully progress this weekend
  - Change connection on debug boards
    - Result is 12 debug boards
    - DONE!!!

## Slide 7

ASCENT Structure (Tom Karnauskas)

- Objective
  - Develop 3U space frame
- Current Activity
  - Design 3U frame
    - Looking into the options for an assembled frame

## Slide 8

Fox-Plus Structure (Thomas Wu)

- Objective
  - Fox-Plus Structure
- Current Activity
  - Research ISISpace component options for inclusion in 1U Fox-Plus

## Slide 9

Fox-Plus Systems Engineering (Mike Moore)

- Objective
  - Advance systems engineering tasks
- Current Activity
  - Begin working on power budget

## Slide 10

Fox-Plus RF (Mike Swiatkowski)

- Objective
  - Develop radio-chip-based SDR
- Current Activity
  - Design voice FM transponder board

## Slide 11

Fox-Plus Flight Software (Cameron Mahaffey)

- Objective
  - Fox-Plus flight software
- Current Activity
  - Get familiar with the flight software

## Slide 12

Fox-Plus Flight Software (Dave McCoy)

- Objective
  - Fox-Plus flight software
- Current Activity
  - Get familiar with flight software

## Slide 13

Fox-Plus Flight Software (Chris Grill)

- Objective
  - Fox-Plus flight software
- Current Activity
  - Identify Goals of Generalized LTM
    - Result is a list of desired changes in the LTM software better supporting the varying needs of different recipients.
  - RT-IHU Debug Cable
    - Result is a small board containing the debug circuitry and cabling for the TMS570

## Slide 14

Fox-Plus Flight Software (Heimir Sverrisson)

- Objective
  - Fox-Plus flight software
- Current Activity
  - Flash Loader
    - Result is an updated flash loader to load the RT-IHU board

## Slide 15

ASCENT Reaction Wheel (Tom Davis)

- Objective
  - Develop reaction wheels and motor control algorithms
- Current Activity
  - Design Reaction Wheel controller board

## Slide 16

ASCENT Deployable Solar Panels (Vincent Risalvato)

- Objective
  - Develop deployable solar panels
- Current Activity
  - Design solar panel and hinge solution
    - Result is a model of solar panels and hinges that fit in the pockets of the currently envisioned 3U structure.
    - Are we ready to prototype real hardware? Any luck getting cells?

## Slide 17

Modeling (Marwan Aylouche)

- Objective
  - Develop Fox-Plus Models
- Current Activity
  - Model Fox-Plus with ISISpace candidate components
  - Currently looking to reduce space required to mount AMSAT boards
