AMSAT-NA/fox-plus/weekly_engineering_meetings/2022-10-12/ASCENT-FOX+ Slide.odp

Fox-Plus A Block Diagram

1U Structure

6 Solar

Panels

Power

Supply

Card

Battery

Card

70 cm

Antenna

Power bus

2 m

Antenna

Science

Payloads

IHU

Card

MagneticAttitude

Control

Telemetry

RF TxRx

Card

## Slide 2

Status Board

a/o 7/13/2022

| Dev Sat
Flight Computer | Metzinger, Brandenburg
Flight Software | McCoy, Grill, Severrisson
Flight TxRx | Swiatkowski
Structure | Karnauskas, Wu, Aylouche
Power Supply & Batts | Moravec
Sensors (various)
Ground System
Reaction Wheels | Davis
Deployable Solar Panels | Risalvato

| Dev Sat
Power Budget | Moore
CONOPS/PSAM/SRS | Moore
Thermal Budget
Link Budget
Launch Integration
Regulatory Approval
Operations
Vibration Test
Thermal & Vacuum Test
PACSAT | Reed, McCullers

## Slide 3

Job Jar

Assemble RT-IHU Break-Out-Boards

I should let others have some fun. Have you wanted to use that inexpensive reflow oven you bought on Amazon? And maybe get some experience hand soldering some surface mount parts? It may sound intimidating but it’s not hard.

## Slide 4

A

S

T

E

C

N


FOX+

What’s Happening?

and

## Slide 5

Jonathan

- Flight Computer
  - A little hand assembly remaining
    - Zach is assembling remaining boards.
  - Debug cables
    - Will new cables make things easier? Depends on orientation.
  - Breakout boards
    - I’ve received the stencil. I should let others have some fun, too. Any volunteers?
- AX5043 Order
- Pacsat Dev Board Order
- Symposium Presentations
  - Helmholtz Cage (and Air Bearings)
  - Reaction Wheels?

## Slide 6

ASCENT PACSAT (Bill Reed)

- Objective
  - Develop digital packet communication payload
- Current Activity
  - Draft CONOPS
    - Result is a draft document for discussion. Document contains a high-level description of function, modes of operation and potentially a block diagram.

## Slide 7

ASCENT PACSAT (Jim McCullers)

- Objective
  - Software
- Current Activity
  - Assemble AX5043 board for prototyping
    - Result is a AX5043 board connecting to a SBC, potentially a Raspberry Pi, and programmed with sample software.

## Slide 8

ASCENT Structure (Tom Karnauskas)

- Objective
  - Develop 3U space frame
- Current Activity
  - Identify previous work
    - Result is a list of existing models previously created by Bob Davis that are relevant to the Golf frame.
  - Ready for 3D Modeling software?
    - Machine refresh for Inventor?
    - Use viewers for now?

## Slide 9

Fox-Plus Structure (Thomas Wu)

- Objective
  - Fox-Plus Structure
- Current Activity
  - Assemble a survey of commercial 1U space frames that could contain the Fox-1 board size.
    - Result is a list of commercially available 1U space frames with a concept of how existing Fox-1 boards would be assembled in each.

## Slide 10

Fox-Plus Systems Engineering (Mike Moore)

- Objective
  - Advance systems engineering tasks
- Current Activity
  - Draft Fox-Plus requirements specifications
    - Result is a draft SRS document, based on the Fox-1 SRSes, updated for the new modes expected on Fox-Plus.

## Slide 11

Fox-Plus RF (Mike Swiatkowski)

- Objective
  - Develop radio-chip-based SDR
- Current Activity
  - Examining existing Fox FM RF boards for end-of-life parts
    - Result is a list of components that require replacement and potential replacements.

## Slide 12

Fox-Plus Flight Software (Dave McCoy)

- Objective
  - Fox-Plus flight software
- Current Activity
  - ???

## Slide 13

Fox-Plus Flight Software (Chris Grill)

- Objective
  - Fox-Plus flight software
- Current Activity
  - Identify Goals of Generalized LTM
    - Result is a list of desired changes in the LTM software better supporting the varying needs of different recipients.
  - RT-IHU Debug Cable
    - Result is a small board containing the debug circuitry and cabling for the TMS570

## Slide 14

Fox-Plus Flight Software (Heimir Sverrisson)

- Objective
  - Fox-Plus flight software
- Current Activity
  - Flash Loader
    - Result is an updated flash loader to load the RT-IHU board

## Slide 15

ASCENT Reaction Wheel (Tom Davis)

- Objective
  - Develop reaction wheels and motor control algorithms
- Current Activity
  - Assemble remaining motors
    - Result is five more motors (I think it’s five)
  - Refine control algorithm
    - Result is an algorithm on a prototype board controlling the wheels in a simulated pointing scenario. Can it also detumble if necessary?

## Slide 16

ASCENT Deployable Solar Panels (Vincent Risalvato)

- Objective
  - Develop deployable solar panels
- Current Activity
  - Design solar panel and hinge solution
    - Result is a model of solar panels and hinges that fit in the pockets of the currently envisioned 3U structure.
    - Are we ready to prototype real hardware? Any luck getting cells?

## Slide 17

Modeling (Marwan Aylouche)

- Objective
  - Develop Fox-Plus Models
- Current Activity
  - Develop models of commercial 1U structures?
    - Working with Thomas Wu, result are models of candidate commercial structures with Fox-1 boards?

## Slide 18

Fox-Plus TBD (Pradipta Shrestha)

- Objective
  - TBD
- Current Activity
  - TBD
