AMSAT-NA/fox-plus/weekly_engineering_meetings/2022-10-05/ASCENT-FOX+ Slide.odp

Fox-Plus A Block Diagram

1U Structure

6 Solar

Panels

Power

Supply

Card

Battery

Card

70 cm

Antenna

Power bus

2 m

Antenna

Science

Payloads

IHU

Card

MagneticAttitude

Control

Telemetry

RF TxRx

Card

## Slide 2

Status Board

a/o 7/13/2022

| Dev Sat
Flight Computer | Metzinger, Brandenburg
Flight Software | McCoy, Grill , Severrisson
Flight TxRx | Koenig, Swiatkowski
Structure | Karnauskus
Power Supply & Batts | Moravec
Sensors (various)
Ground System
Reaction Wheels | Tom Davis
Deployable Solar Panels | Risalvato

| Dev Sat
Power Budget | Moore
CONOPS/PSAM | Moore
Thermal Budget
Link Budget
Launch Integration
Regulatory Approval
Operations
Vibration Test
Thermal & Vacuum Test
PACSAT | Bill Reed

## Slide 3

Job Jar

EPS ICD

Fox-Plus RF ICD

Golf Stack Modeling

Fox Stack Modeling

## Slide 4

A

S

T

E

C

N


FOX+

What’s Happening?

and

## Slide 5

Activities of Interest

- Flight Computer
  - A little hand assembly remaining
    - Zach has one board prepared. I’ll get it tomorrow.
  - Debug cables
    - I have the components. Need to do something with them.
    - Will see Zach tomorrow to discuss
  - Breakout boards
    - I have ordered a stencil. Thank you!

## Slide 6

ASCENT PACSAT (Bill Reed)

- Objective
  - Develop digital packet communication payload
- Current Activity
  - Develop CONOPS
- Question
  - Team activities?

## Slide 7

ASCENT PACSAT (Jim McCullers)

- Objective
  - TBD
- Current Activity
  - See above

## Slide 8

ASCENT Structure (Tom Karnauskas)

- Objective
  - Develop 3U space frame
- Current Activity
  - Identify previous work, requirements
  - Ready for 3D Modeling software?
    - Machine refresh for Inventory?
    - Use viewers for now?

## Slide 9

Fox-Plus TBD (Thomas Wu)

- Objective
  - Fox-Plus Structure
- Current Activity
  - Review existing 1-U structure from Fox

## Slide 10

Fox-Plus Systems Engineering (Mike Moore)

- Objective
  - Advance systems engineering tasks
- Current Activity
  - Fox-Plus requirements specifications
    - Version 0.3 by email

## Slide 11

Fox-Plus TBD (Pradipta Shrestha)

- Objective
  - TBD
- Current Activity
  - TBD

## Slide 12

Fox-Plus RF (Andrew Koenig)

- Objective
  - Develop FPGA-based SDR
- Current Activity
  - Inactive (for now)

## Slide 13

Fox-Plus RF (Mike Swiatkowski)

- Objective
  - Develop radio-chip-based SDR
- Current Activity
  - Examining existing RF boards for end-of-life parts

## Slide 14

Fox-Plus Flight Software (Dave McCoy)

- Objective
  - Fox-Plus flight software
- Current Activity
  - ???

## Slide 15

Fox-Plus Flight Software (Chris Grill)

- Objective
  - Fox-Plus flight software
- Current Activity
  - Generalize LTM
  - RT-IHU Debug Cable

## Slide 16

Fox-Plus Flight Software (Heimir Sverrisson)

- Objective
  - Fox-Plus flight software
- Current Activity
  - Flash Loader
  - Beginning to extend the Python host loader

## Slide 17

ASCENT Reaction Wheel (Tom Davis)

- Objective
  - Develop reaction wheels and motor control algorithms
- Current Activity
  - Refine motor control algorithms
  - Demonstrate four wheel prototype

## Slide 18

ASCENT Deployable Solar Panels (Vincent Risalvato)

- Objective
  - Develop deployable solar panels
- Current Activity
  - Provide information for ARDC update
  - Develop hinge solution
  - I need the artifacts!
