AMSAT-NA/fox-plus/weekly_engineering_meetings/2022-09-07/ASCENT-FOX+ Slide.odp

Fox-Plus A Block Diagram

1U Structure

6 Solar

Panels

Power

Supply

Card

Battery

Card

70 cm

Antenna

Power bus

2 m

Antenna

Science

Payloads

IHU

Card

MagneticAttitude

Control

Telemetry

RF TxRx

Card

## Slide 2

Status Board

a/o 7/13/2022

| Dev Sat
Flight Computer | Metzinger, Brandenburg
Flight Software | McCoy, Grill , Severrisson
Flight TxRx | Koenig, Swiatkowski
Structure | Karnauskus
Power Supply & Batts | Moravec
Sensors (various)
Ground System
Reaction Wheels | Tom Davis
Deployable Solar Panels | Risalvato

| Dev Sat
Power Budget | Moore
CONOPS/PSAM | Moore
Thermal Budget
Link Budget
Launch Integration
Regulatory Approval
Operations
Vibration Test
Thermal & Vacuum Test
PACSAT | Bill Reed

## Slide 3

A

S

T

E

C

N


FOX+

What’s Happening?

and

## Slide 4

Job Jar

Fox-Plus Structure

EPS ICD

Fox-Plus RF ICD

Golf Stack Modeling

Fox Stack Modeling

## Slide 5

Symposium!!!

launch.amsat.org

Don’t have to be a member on the site

A guest can be added to banquet as a separate transaction

## Slide 6

Activities of Interest

- 3D modeling software
  - Inventor
- Flight Computer
  - A little hand assembly remaining
  - Debug cables
  - Breakout boards

## Slide 7

Fox-Plus RF (Andrew Koenig)

- Objective
  - Develop FPGA-based SDR
- Current Activity
  - CaribouLite delayed
  - Investigating audio DAC/ADC

## Slide 8

Fox-Plus RF (Mike Swiatkowski)

- Objective
  - Develop radio-chip-based SDR
- Current Activity
  - Trade study of transceiver chips and amplifiers
  - Examining existing RF boards for end-of-life parts

## Slide 9

Fox-Plus Flight Software (Dave McCoy)

- Objective
  - Fox-Plus flight software
- Current Activity
  - ???

## Slide 10

Fox-Plus Flight Software (Chris Grill)

- Objective
  - Fox-Plus flight software
- Current Activity
  - Generalize LTM
  - RT-IHU Debug Cable

## Slide 11

Fox-Plus Flight Software (Heimir Sverrisson)

- Objective
  - Fox-Plus flight software
- Current Activity
  - Flash Loader
  - Beginning to extend the Python host loader

## Slide 12

ASCENT Reaction Wheel (Tom Davis)

- Objective
  - Develop reaction wheels and motor control algorithms
- Current Activity
  - Develop motor control algorithms
  - Assemble four wheel prototype

## Slide 13

ASCENT Deployable Solar Panels (Vincent Risalvato)

- Objective
  - Develop deployable solar panels
- Current Activity
  - Provide information for ARDC update
  - Develop hinge solution

## Slide 14

ASCENT PACSAT (Bill Reed)

- Objective
  - Develop digital packet communication payload
- Current Activity
  - Develop CONOPS

## Slide 15

ASCENT PACSAT (Jim McCullers)

- Objective
  - TBD
- Current Activity
  - Engage with Bill Reed

## Slide 16

ASCENT Structure (Tom Karnauskas)

- Objective
  - Develop 3U space frame
- Current Activity
  - Identify previous work, requirements
  - Ready for 3D Modeling software?

## Slide 17

Fox-Plus Systems Engineering (Mike Moore)

- Objective
  - Advance systems engineering tasks
- Current Activity
  - Fox-Plus requirements specifications

## Slide 18

Fox-Plus TBD (Pradipta Shrestha)

- Objective
  - TBD
- Current Activity
  - TBD

## Slide 19

Fox-Plus TBD (Thomas Wu)

- Objective
  - TBD
- Current Activity
  - TBD
