AMSAT-NA/fox-plus/weekly_engineering_meetings/2022-08-24/ASCENT-FOX+ Slide.odp

A

S

T

E

C

N


FOX+

What’s Happening?

and

## Slide 2

Fox-Plus A Block Diagram

1U Structure

6 Solar

Panels

Power

Supply

Card

Battery

Card

70 cm

Antenna

Power bus

2 m

Antenna

Science

Payloads

IHU

Card

MagneticAttitude

Control

Telemetry

RF TxRx

Card

## Slide 3

Status Board

a/o 7/13/2022

| Dev Sat
Flight Computer | Metzinger, Brandenburg
Flight Software | McCoy, Grill , Severrisson
Flight TxRx | Koenig, Swiatkowski
Structure | Reynoso, Karnauskus
Power Supply & Batts | Moravec
Sensors (various)
Ground System
Reaction Wheels | Tom Davis
GNC Algorithms | Almonte, Leonard
Deployable Solar Panels | Risalvato

| Dev Sat
Power Budget | Moore
CONOPS/PSAM | Moore
Thermal Budget
Link Budget
Launch Integration
Regulatory Approval
Operations
Vibration Test
Thermal & Vacuum Test
PACSAT | Bill Reed

## Slide 4

Job Jar

Fox-Plus Structure

Golf-Tee GNC Requirements

EPS ICD

Fox-Plus RF ICD

Golf Stack Modeling

Fox Stack Modeling

## Slide 5

Activities of Interest

- 3D modeling software
  - Solidworks
- Thermal modeling software
  - Thermal Desktop, Intel FORTRAN, AutoCAD, 3DS Max
- Flight Computer
  - For immediate development
  - V1.1 boards back from assembly house
  - A little hand assembly remaining

## Slide 6

ASCENT Reaction Wheel (Tom Davis)

- Objective
  - Develop reaction wheels and motor control algorithms
- Current Activity
  - Develop motor control algorithms
- Upcoming Activity
  - Assemble four wheel prototype

## Slide 7

ASCENT GNC (Peter Almonte)

- Objective
  - Develop MATLAB GNC simulation based on Carlos Montalvo
- Current Activity
  - Add simulated CubeSat

## Slide 8

ASCENT GNC (Matthew Leonard)

- Objective
  - Develop GOLF-TEE GNC algorithms
- Current Activity
  - Awaiting GNC requirements
- Upcoming Activity
  - ???

## Slide 9

ASCENT Deployable Solar Panels (Vincent Risalvato)

- Objective
  - Develop deployable solar panels
- Current Activity
  - Provide information for ARDC update
  - Develop hinge solution

## Slide 10

ASCENT PACSAT (Bill Reed)

- Objective
  - Develop digital packet communication payload
- Current Activity
  - Develop CONOPS

## Slide 11

ASCENT Structure (Tom Karnauskas)

- Objective
  - Develop 3U space frame
- Current Activity
  - Identify previous work, requirements

## Slide 12

Fox-Plus Systems Engineering (Mike Moore)

- Objective
  - Advance systems engineering tasks
- Current Activity
  - Fox-Plus requirements specifications

## Slide 13

Fox-Plus RF (Andrew Koenig)

- Objective
  - Develop SDR
- Current Activity
  - CaribouLite delayed
  - Investigating audio DAC/ADC

## Slide 14

Fox-Plus RF (Mike Swiatkowski)

- Objective
  - Develop radio-chip-based SDR
- Current Activity
  - Trade study of transceiver chips and amplifiers

## Slide 15

Mission Integration (Dan Gillies)

- Objective
  - Launch integration
- Current Activity
  - ???

## Slide 16

Fox-Plus Structure (Lucas Reynoso)

- Objective
  - Fox-Plus 1U structure (extensible)
- Current Activity
  - Knowledge transfer

## Slide 17

Fox-Plus Flight Software (Dave McCoy)

- Objective
  - Fox-Plus flight software
- Current Activity
  - ???

## Slide 18

Fox-Plus Flight Software (Chris Grill)

- Objective
  - Fox-Plus flight software
- Current Activity
  - Generalize LTM

## Slide 19

Fox-Plus Flight Software (Heimir Sverrisson)

- Objective
  - Fox-Plus flight software
- Current Activity
  - Bootloader
