AMSAT-NA/fox-plus/weekly_engineering_meetings/2022-07-27/ASCENT-FOX+ Slide.pptx

What’s Happening?

T

N

E

C

S

A

FOX+


and

## Slide 2

Block Diagram

1U Structure

6 Solar
Panels

Power
Supply
Card

Battery
Card

70 cm
Antenna

Power bus

2 m
Antenna

Science
Payloads

IHU
Card

MagneticAttitude
Control

RF TxRx
Card

Telemetry

## Slide 3

a/o 7/13/2022

| Dev Sat
Flight Computer | Metzinger, Brandenburg
Flight Software | McCoy, Grill , Severrisson
Flight TxRx | Koenig, Swiatkowski, Reed
Structure | Reynoso, Karnauskus
Power Supply & Batts | Moravec
Sensors (various)
Ground System
Reaction Wheels | Tom Davis
GNC Algorithms | Almonte, Leonard
Deployable Solar Panels | Risalvato

| Dev Sat
Power Budget | Moore
CONOPS/PSAM | Moore
Thermal Budget
Link Budget
Launch Integration
Regulatory Approval
Operations
Vibration Test
Thermal & Vacuum Test

Status Board

## Slide 4

ASCENT Reaction Wheel (Tom Davis)

ASCENT GNC (Peter Almonte, Matthew Leonard)

ASCENT Deployable Solar Panels (Vincent Risalvato)

ASCENT RF (Bill Reed)

ASCENT Structure (Tom Karnauskas)

Fox-Plus Systems Engineering (Mike Moore)

Fox-Plus RF (Andrew Koenig, Mike Swiatkowski)

Mission Integration (Dan Gillies)

Fox-Plus Structure (Lucas Reynoso)

Fox-Plus Flight Software (Dave McCoy, Chris Grill, Heimir Sverrisson)

Activities
