AMSAT-NA/fox-plus/weekly_engineering_meetings/2022-07-06/ASCENT-FOX+ Slide.pptx

What’s Happening?

T

N

E

C

S

A


FOX+

and

## Slide 2

Block Diagram

1U Structure

6 Solar
Panels

Power
Supply
Card

Battery
Card

70 cm
Antenna

Power bus

2 m
Antenna

Science
Payloads

IHU
Card

MagneticAttitude
Control

RF TxRx
Card

Telemetry

## Slide 3

| Dev Sat
Flight Computer | Metzinger, Brandenburg
Flight Software | McCoy, Grill , Severrisson
Flight TxRx | Koenig, Swiatkowski, Reed
Structure | Reynoso
Power Supply & Batts | Moravec
Sensors (various)
Ground System
Reaction Wheels | Tom Davis
GNC Algorithms | Almonte
Deployable Solar Panels | Risalvato

| Dev Sat
Power Budget | Moore
CONOPS/PSAM | Moore
Thermal Budget
Link Budget
Launch Integration
Regulatory Approval
Operations
Vibration Test
Thermal & Vacuum Test

Status Board

## Slide 4

ASCENT Reaction Wheel (T. Davis)

ASCENT Deployable Solar Panels (V. Risalvato)

ASCENT GNC (P. Almonte)

Fox-Plus Systems Engineering (M. Moore)

Fox-Plus Flight Software (D. McCoy, C. Grill, H. Sverrisson)

Fox-Plus RF (B. Reed, A. Koenig, M. Swiatkowski)

Fox-Plus Structure (L. Reynoso)

Mission Integration (D. Gillies)

Activities
