AMSAT-NA/fox-plus/weekly_engineering_meetings/2022-06-29/ASCENT-FOX+ Slide.pptx

What’s Happening?

T

N

E

C

S

A


FOX+

and

## Slide 2

Block Diagram

1U Structure

6 Solar
Panels

Power
Supply
Card

Battery
Card

70 cm
Antenna

Power bus

2 m
Antenna

Science
Payloads

IHU
Card

MagneticAttitude
Control

RF TxRx
Card

Telemetry

## Slide 3

ASCENT Reaction Wheel (T. Davis)

ASCENT Deployable Solar Panels (V. Risalvato)

ASCENT GNC (P. Almonte)

Fox-Plus Systems Engineering (M. Moore)

Fox-Plus Flight Software (B. Reed, D. McCoy, C. Grill, H. Sverrisson)

Fox-Plus RF (A. Koenig, M. Swiatkowski)

Fox-Plus Structure (L. Reynoso)

Mission Integration (D. Gillies)

Activities
