AMSAT-NA/fox-plus/weekly_engineering_meetings/2022-05-11/ASCENT-FOX+ Slide.pptx

What’s Happening?

T

N

E

C

S

A


FOX+

and

## Slide 2

Systems Engineering – Mike Moore
- CONOPS
- PSAM

RF System – Andrew Koenig
- Transceiver Concept

Reaction Wheel – Tom Davis
- Vibration Testing

Activities

## Slide 3

Daniel Gillies

Vincent Risalvato

Lucas Reynoso

Matthew Leonard

Tom Karnauskas (coming soon)

More New Faces!
