AMSAT-NA/fox-plus/systems_engineering/design/Fox-Plus-A Func Blk Diagram2.pdf

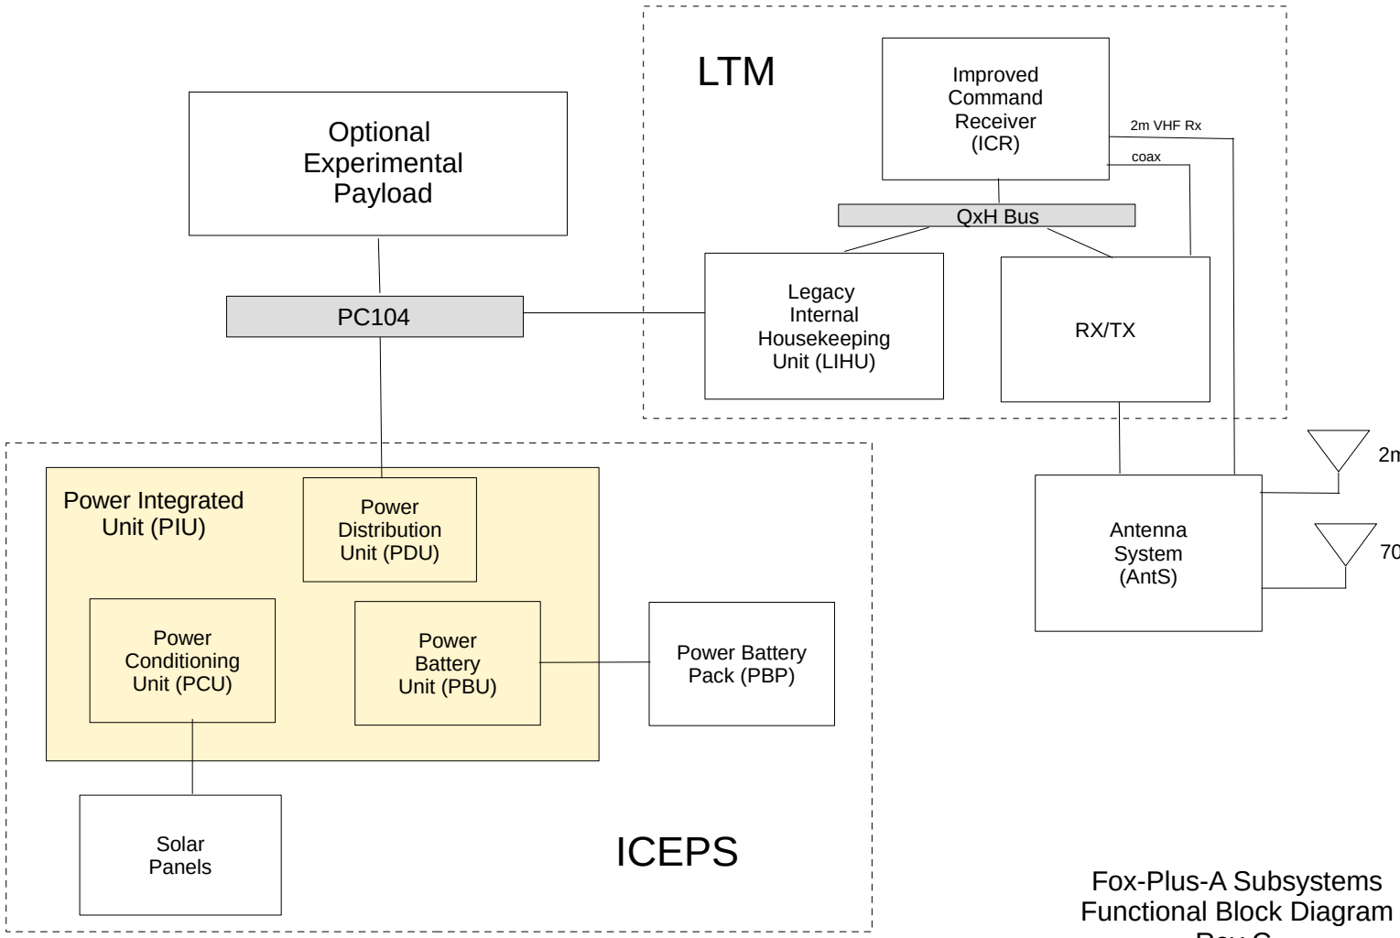
[picture p74: figure]
Power; Battery; Unit (PBU); Conditioning; Unit (PCU); Legacy; Internal; Housekeeping; Unit (LIHU); Solar; Panels; Antenna; System (AntS); ICEPS; Fox-Plus-A Subsystems; Functional Block Diagram; Improved; Command; Receiver (ICR); Power Battery; Pack (PBP); LTM; Power Integrated; Unit (PIU); Optional; Experimental; Payload; QxH Bus; Distribution; Unit (PDU); 2m VHF Rx; coax

70cm Antenna

2m Antenna

### Rev C

12/14/2023

# 1U Structure
