AMSAT-NA/fox-plus/cables & connectors/USB-C Interconnects r2.pdf

FoxPlus-A Umbilical Connector Last revision: 8/4/2026

USB-C Connector
Source | Desig | Sig Name | Termination | Pin# | Comments
EGSE | A1 | GND | PIU-J9 | 5,6,7,8,13 | Ground return
EGSE | B12 | GND | PIU-J9 | 5,6,7,8,13 | Ground return
EGSE | A4 | Batt+ | PIU-J9 | 1,2,3,4 | Batt+: : 2A max
EGSE | B9 | Batt+ | PIU-J9 | 1,2,3,4 | Batt+: : 2A max
EGSE | A5 | UART_RX | PIU-J9 | 9 | these UART signals to to the CSKB for i/f to IHU
EGSE | B8 | UART_TX | PIU-J9 | 10 | these UART signals to to the CSKB for i/f to IHU
EGSE | A6 | ENA_A | PSA-J8 | 4 | from J8, goes to K1 p3
EGSE | B7 | ENA_B | PSA-J8 | 10 | from J8, goes to K1 p10
EGSE | A7 | ENA_B | PSA-J8 | 10 | from J8, goes to K1 p10
EGSE | B6 | ENA_A | PSA-J8 | 4 | from J8, goes to K1 p3
EGSE | A8 | UART_TX | PIU-J9 | 10 | these UART signals to to the CSKB for i/f to IHU
EGSE | B5 | UART_RX | PIU-J9 | 9 | these UART signals to to the CSKB for i/f to IHU
EGSE | A9 | Batt+ | PIU-J9 | 1,2,3,4 | Batt+: : 2A max
EGSE | B4 | Batt+ | PIU-J9 | 1,2,3,4 | Batt+: : 2A max
EGSE | A12 | GND | PIU-J9 | 5,6,7,8,13 | Ground return
EGSE | B1 | GND | PIU-J9 | 5,6,7,8,13 | Ground return

Notes:
1) EGSE to USB-C is a DB-25 to USB-C connector.
2) PIU -J8 and J9 are ISISpace Molex connectors. See ISIS-ICEPS2-ICD Tables 4-4 & 4-5
3) PSA-J8 is currently a Harwin M80 connector. This may change.
Source | Desig | Sig Name | Termination | Pin# | Comments
PSA | J8 – 8 | ENAOUT_A | PIU-J10 | 4 | Active low. GND to activate
PSA | J8 – 9 | ENAOUT_B | PIU-J10 | 6 | Active low. GND to activate
PSA | J8 – 3 | Sep Sw A | Sep Sw A | - | Sep Switch on frame
PSA | J8 – 5 | Sep Sw B | Sep Sw B | - | Sep Switch on frame
