AMSAT-NA/fox-plus/PowerSig_Adapter/PC104 to CSKB_lite v1.2a.pdf

Power & Signals Used for FoxPlus-A (Sourced from ISIS EPS)

Signal Name | CSKB Light Pin# | FoxPlus Nom | Notes
5V_p | H2-25, 26 | v_sys | FoxP uses this as if unregulated voltage. It goes to the FP 5v regulator
3V3_p | H2-27,28 | v_3v3
GND | H2: 29-32, 39-42,44; H1: 27,28, 31,32, 39-42,44 | GND | ISIS CSKB Light grounds are not CSKB standard
Vbatt_p | H2: 45,46 | | Used for monitoring in FoxP
I2CSDA | H1: 41 | i2c1_sda | ISIS uses this as main comms with the EPS MCU
I2CSCL | H1: 43 | i2c1_scl
UART-Rx | H2: 21 | rx_3 | This is used for comms to LIHU via umbilical cable
UART-Tx | H2: 22 | tx_3
GPIO ABF[0] | H2: 50 | abf_placed | Low true. No power without this signal!
GPIOABF[1] | H2: 51 | abf_placed | Not used on v1.2 but should have been. Use this redundant signal on next version
