AMSAT-NA/fox-plus/block_diagram/Fox-Plus-A Func Blk Diagram3.pdf

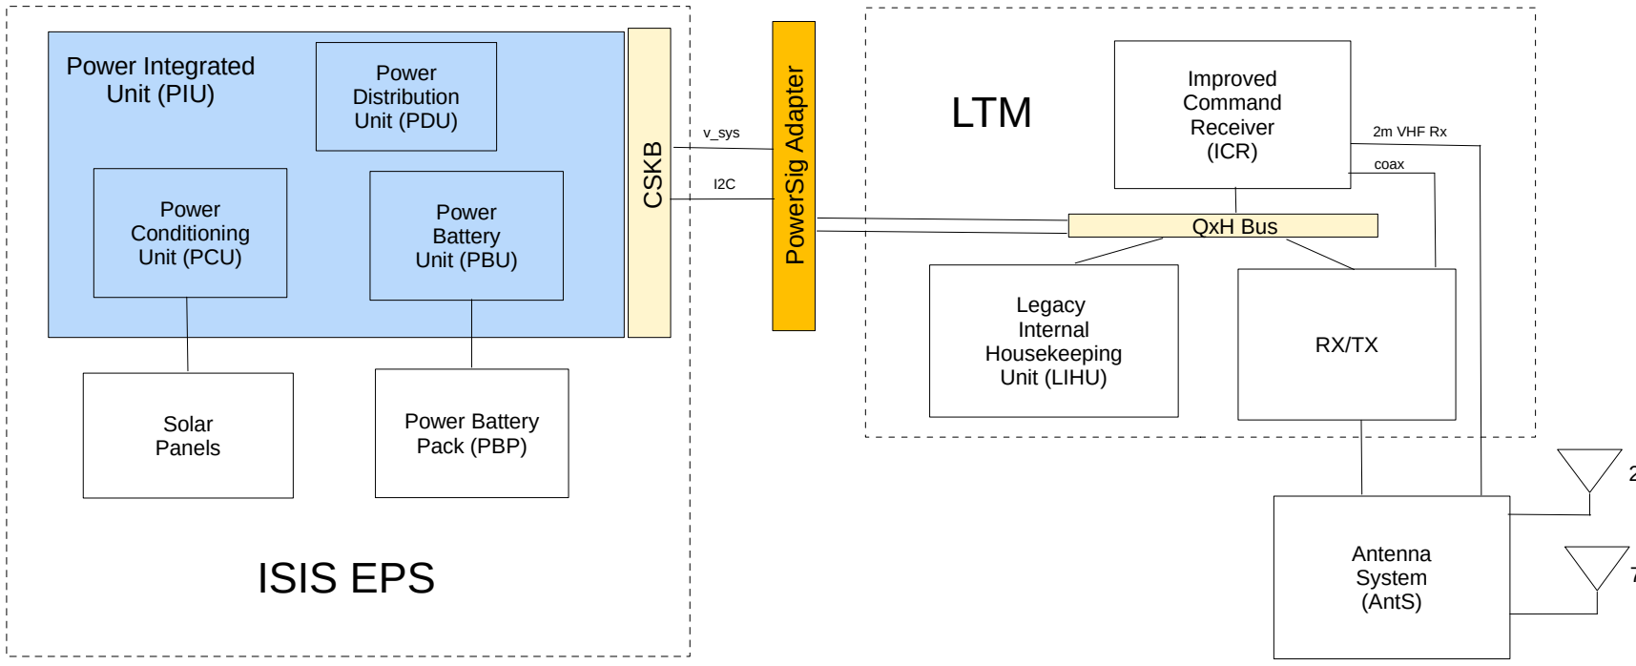
[picture p75: figure]
Power Battery Unit (PBU); Power Conditioning Unit (PCU); Legacy Internal Housekeeping Unit (LIHU); Solar Panels; Antenna System (AntS); ISIS EPS; Improved Command Receiver (ICR); Power Battery Pack (PBP); LTM; Power Integrated Unit (PIU); QxH Bus; Power Distribution; Unit (PDU); 2m VHF Rx; coax; erSig; pter; v_sys

70cm

2m

## Fox-Plus-A Subsystems Functional Block Diagram Rev D

08/27/2025

# Fox-Plus-A
