AMSAT-NA/fox-plus/presentations/2022-05 Hamvention/2022 Hamvention.pdf

# Fox+ and ASCENT

2022 HA MVE NT I ON

# Fox+

### - Vision

- Building on Fox
- LEO
- 1U+ → Increasing Size
- FM+ → Increasing Capability
- Open Source and Open Access
- Early Work
- Systems Engineering
- RF
- Structure

### - Shared with Golf

- Power System
- RF

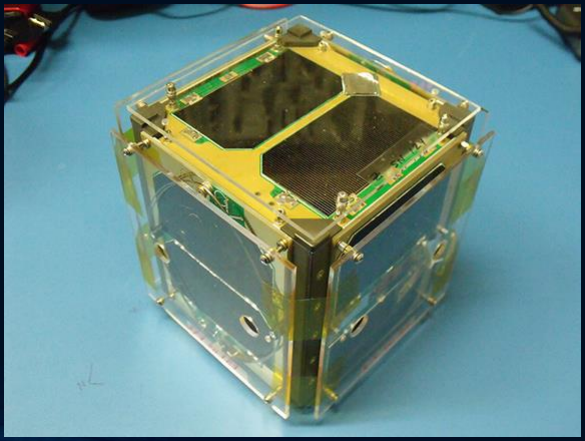
[picture p87: figure]
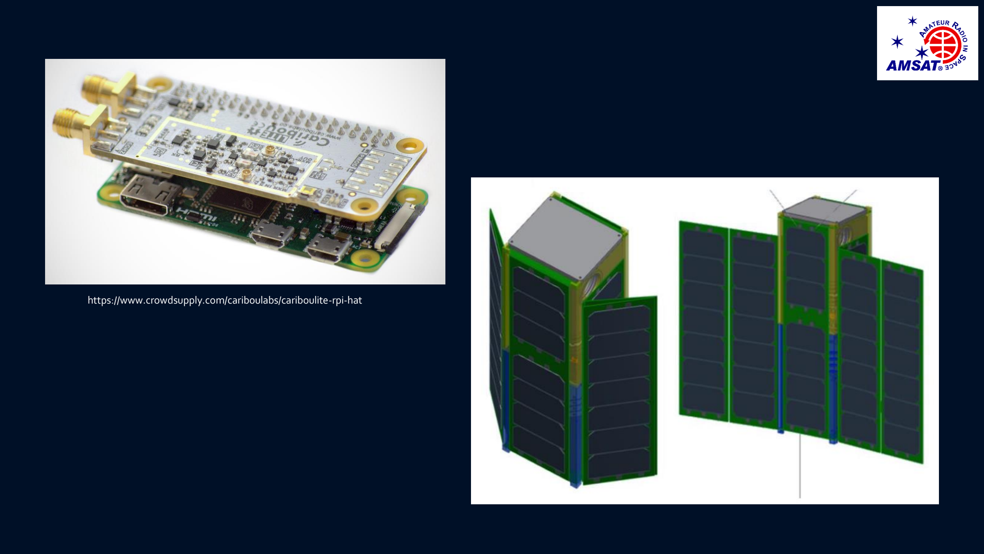
[picture p88: page 3]

https://www.crowdsupply.com/cariboulabs/cariboulite-rpi-hat

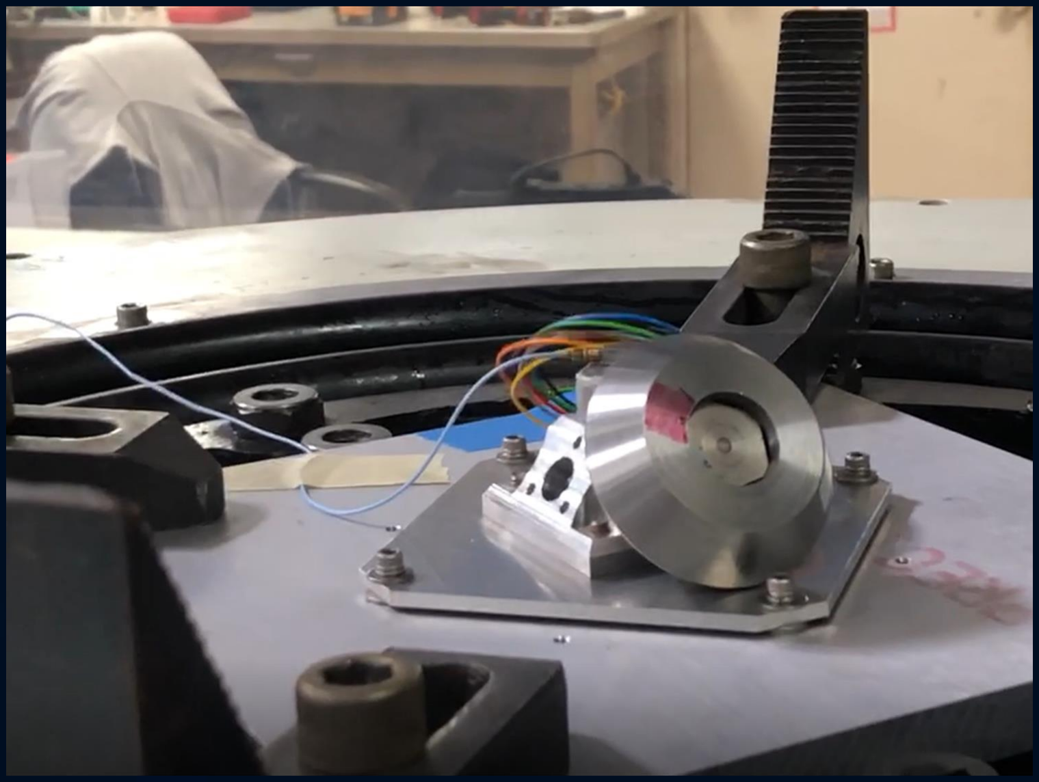
[picture p89: figure]

# ASCENT

### - Reaction Wheels

- Engineering
- Vibration Test

### - Deployable Solar Panels

- ARDC Grant

### - Open Source and Open Access

# Engineering Volunteers

### - Mechanical Engineering

### - RF Engineering

### - Flight Software Engineering

### - Stop by the Booth
