AMSAT-NA/fox-plus/mechanical/Drawings/Fox Mechanical List.xls

Sheet: Sheet1
Fox1 Mechanical Documents
P/N | Title | Status | Notes
FOX-ME-101 | 1U ENVELOPE | DRAFT 0.2, 2011-04-04 | uses old titleblock.
FOX-ME-102 | FOX-1A STOWED AND DEPLOYED
FOX-ME-103 | FOX-1A ASSEMBLY | DRAFT 0.1, 2012-08-15 | Did I place the +/-Y panels upside down?
FOX-ME-104
FOX-ME-105
FOX-ME-106
FOX-ME-107
FOX-ME-108
FOX-ME-109
FOX-ME-110
FOX-ME-111 | WALLS | DRAFT 0.3, 2012-08-15
FOX-ME-112 | FOX-1A PCB ASSEMBLY | DRAFT 0.3, 2012-08-15
FOX-ME-113 | FOX-1A PCB | DRAFT 0.5, 2012-08-15 | -10 ballast mounting? Sht1 pcb thickness should be reference. Sht1 yellow circle is almost invisible. Sht7 some holes not dim.
FOX-ME-114 | BATTERY ASSEMBLY | DRAFT 0.1, 2012-09-10 | Need to swap usb & mono?
FOX-ME-117 | PCB SPACER | DRAFT 0.1, 2012-08-02 | tooling radius not dim. Alodine?
FOX-ME-118 | PCB DELRIN MOUNT | DRAFT 0.3, 2012-08-10
FOX-ME-119 | X SIDE SOLAR PANEL | DRAFT 0.5, 2012-11-12 | swap label of holes? Mini-usb to square hole? Pcb thickness ref?
FOX-ME-120 | Z TOP/BOTTOM SOLAR PANEL | DRAFT 0.5, 2012-11-12 | Antenna Post hardware interferes with edge. Dick wants gold tape/plating. Need pcb thickness.
FOX-ME-121 | RAIL ENDS | DRAFT 0.1, 2012-08-15 | alodine/anodize. Dim the chamfers. -05 callout #0-80 tapped holes. -01 delete extra hole.
FOX-ME-122 | UTJ CELL ICD | DRAFT 0.1, 2012-07-18
FOX-ME-123 | PCB THREADED ROD | DRAFT 0.1, 2012-08-03
FOX-ME-124 | MAGNET |  | Not a priority so save for later.
FOX-ME-125 | HYSTERESIS ROD |  | Not a priority so save for later.
FOX-ME-126 | ANTENNA POST | DRAFT 0.1, 2012-08-15 | -01 BIG AL, -03 SM DELRIN, -05 SM AL. zoom in! "V" angle.
FOX-ME-127 | Y SIDE SOLAR PANEL | DRAFT 0.2, 2012-11-12
FOX-ME-128 | ANTENNA
FOX-ME-129 | ANTENNA STOP
FOX-ME-130 | SAFE RFB
FOX-ME-131 | RX SHIELD
FOX-ME-132 | TX SHIELD
FOX-ME-133 | CRYSTAL L STRIP
FOX-ME-134 | RX SHIM
FOX-ME-135 | HAT, THERMAL VACUUM BAKEOUT
FOX-ME-136 | PSU LEAD
FOX-ME-137 | PPOD CROSS-SECTION
FOX-ME-138 | JACKPOST
FOX-ME-139 | SOLAR PANEL COVER
FOX-ME-140 | VIBRATION ADAPTER
FOX-ME-141 | CENTRIFUGE ADAPTER
FOX-ME-142 | ISIS TESTPOD
FOX-ME-143 | 2U HAT, BAKEOUT
FOX-ME-144
FOX-ME-145
FOX-ME-146 | FOX-1B STOWED & DEPLOYED
FOX-ME-147 | FOX-1B ASSEMBLY
FOX-ME-148 | FOX-1B PCB STACK
FOX-ME-149 | FOX-1B PCB
FOX-ME-150
FOX-ME-151 | FOX-1C STOWED & DEPLOYED
FOX-ME-152 | FOX-1C ASSEMBLY
FOX-ME-153 | FOX-1C PCB STACK
FOX-ME-154 | FOX-1C PCB
FOX-ME-155
FOX-ME-156 | FOX-1D STOWED & DEPLOYED
FOX-ME-157 | FOX-1D ASSEMBLY
FOX-ME-158 | FOX-1D PCB STACK
FOX-ME-159 | FOX-1D PCB
FOX-ME-160
FOX-ME-161 | FOX-1E STOWED & DEPLOYED
FOX-ME-162 | FOX-1E ASSEMBLY
FOX-ME-163 | FOX-1E PCB STACK
FOX-ME-164 | FOX-1E PCB
FOX-ME-165
FOX-ME-166 | LT for DubSat-1
FOX-ME-167 | LT for DubSat-1 PCBs
FOX-ME-168 | PCB STANDOFF

Sheet: Fox Plus
Fox Plus Mechanical Documents
P/N | Title | Status | Notes
FOX-ME-201 | JUMPER ASSEMBLY | DRAFT 0.1, 10/14/2024
FOX-ME-202 | Assembly, FOX Plus Space Vehicle | DRAFT, 8/3/2025
FOX-ME-203 | Adapter, Mechanical | Not Started, 8/3/2025
FOX-ME-204 | Adapter, PCB | DRAFT, 8/31/2025
FOX-ME-205
FOX-ME-206
FOX-ME-207
FOX-ME-208
FOX-ME-209
FOX-ME-210
FOX-ME-211
FOX-ME-212
FOX-ME-213
FOX-ME-214
FOX-ME-215
FOX-ME-216
FOX-ME-217
FOX-ME-218
FOX-ME-219
FOX-ME-220
