AMSAT-NA/fox-plus/mechanical/Fox_Plus_SpaceVehicleCoordinateSystem.pptx

## Space Vehicle Coordinate System

Inventor
Views

Back

Zenith

Top

Right

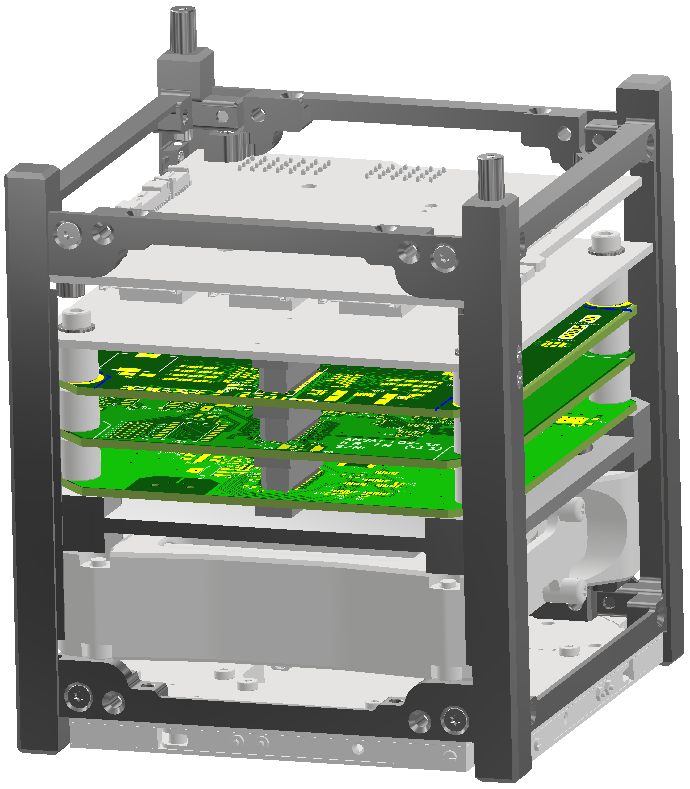
[picture p90: figure]

(0,0,0)

x

y

z

Y

Nadir

X

Z

## Refence Documents

- SBC = Satellite Body Coordinates
- CDS = Cubesat Design Specification

## Model Naming Convention
