AMSAT-NA/fox-plus/weekly_engineering_meetings/ASCENT-FOX+ Slide.pptx

What’s Happening?

T

N

E

C

S

A


FOX+

and
