AMSAT-NA/fox-plus/weekly_engineering_meetings/2022-05-18/ASCENT-FOX+ Slide.pptx

What’s Happening?

T

N

E

C

S

A


FOX+

and

## Slide 2

Reaction Wheel (T. Davis)

Deployable Solar Panels (V. Risalvato)

Systems Engineering (M. Moore)

RF (A. Koenig)

Mission Integration (D. Gillies)

Fox+ Structure (L. Reynoso)

Cntrl Algorithms, Structure (M. Leonard)

Activities

## Slide 3

Tom Karnauskas

More New Faces!

## Slide 4

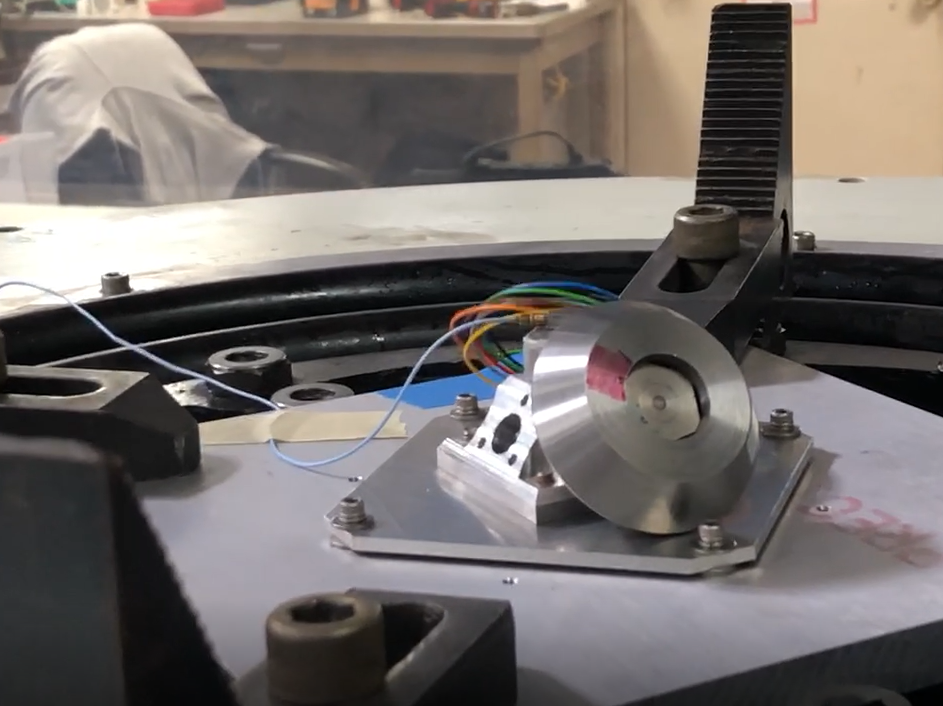
[picture p91: figure]
