AMSAT-NA/fox-plus/structure/3d_models/1U/Bat2 V3 decal bottom.png

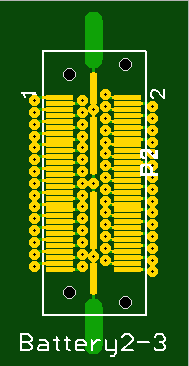
structure/3d_models/1U/Bat2 V3 decal bottom.png
