AMSAT-NA/fox-plus/structure/3d_models/1U/Camera_v7 SilkscreenSaysV3 decal top.png

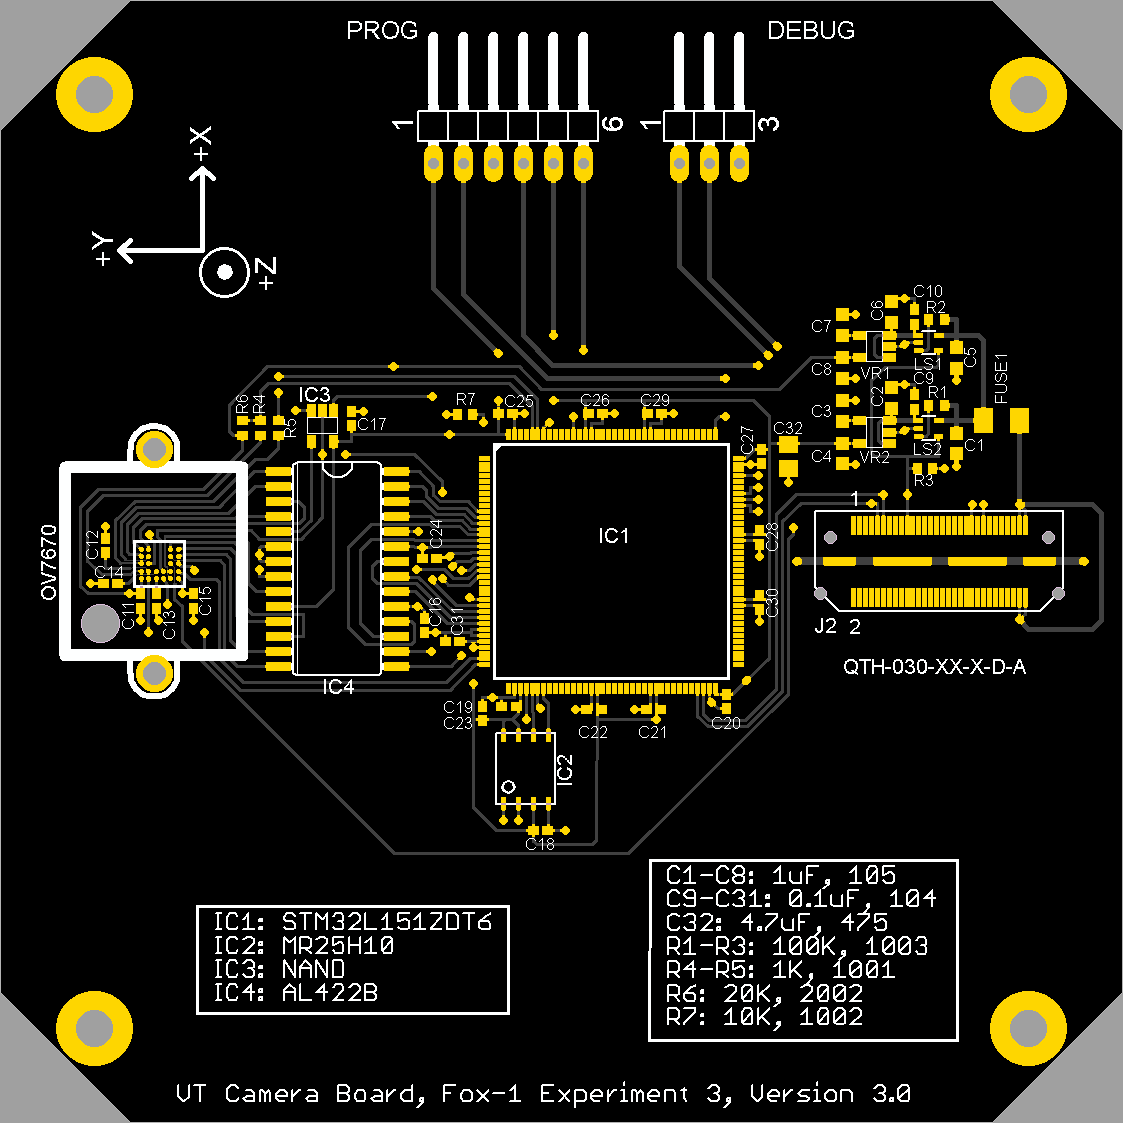
structure/3d_models/1U/Camera_v7 SilkscreenSaysV3 decal top.png
