AMSAT-NA/fox-plus/structure/3d_models/1U/cell.bmp

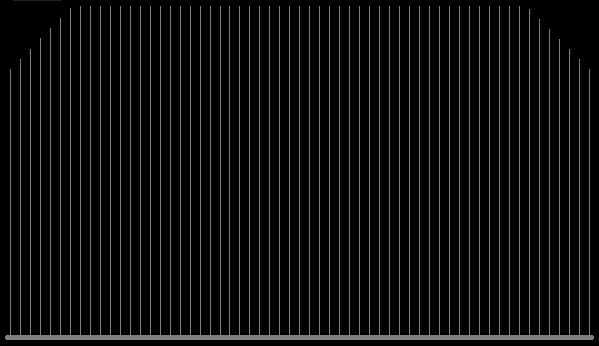
structure/3d_models/1U/cell.bmp
