AMSAT-NA/fox-plus/structure/3d_models/1U/Crystal L Strip.png

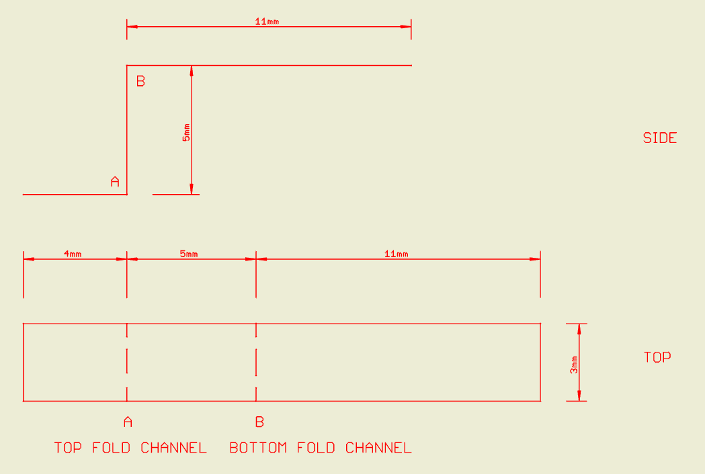
structure/3d_models/1U/Crystal L Strip.png
