AMSAT-NA/fox-plus/structure/3d_models/1U/Exp1 VUC top decal.PNG

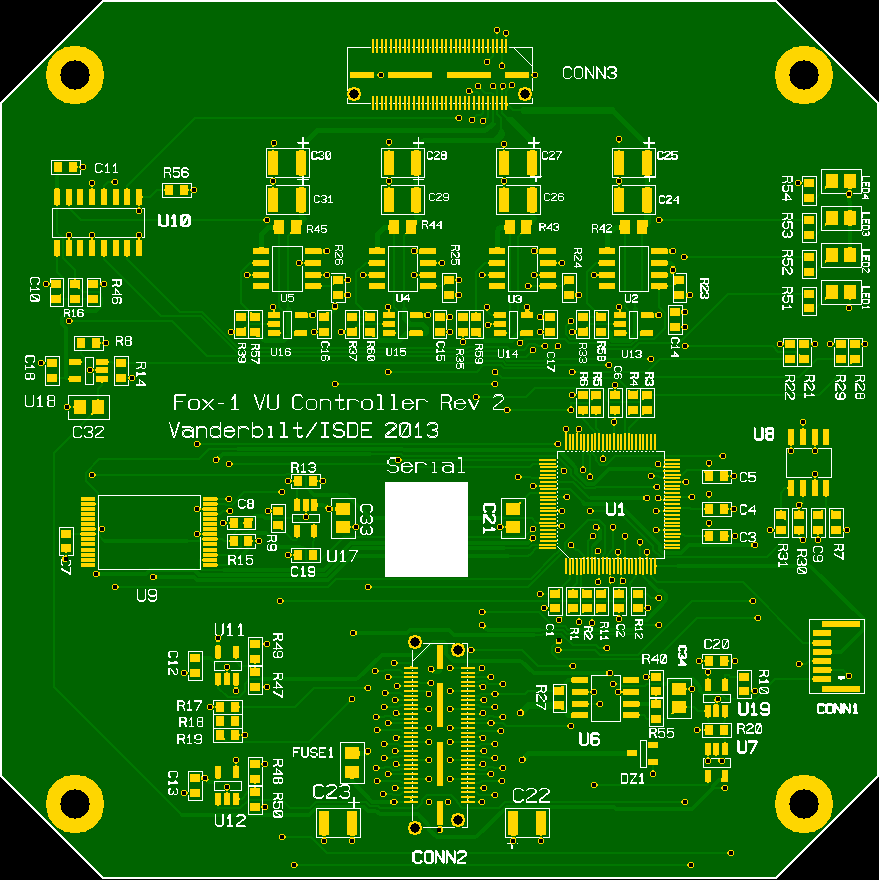
structure/3d_models/1U/Exp1 VUC top decal.PNG
