AMSAT-NA/fox-plus/structure/3d_models/1U/Exp2 LEP top decal.PNG

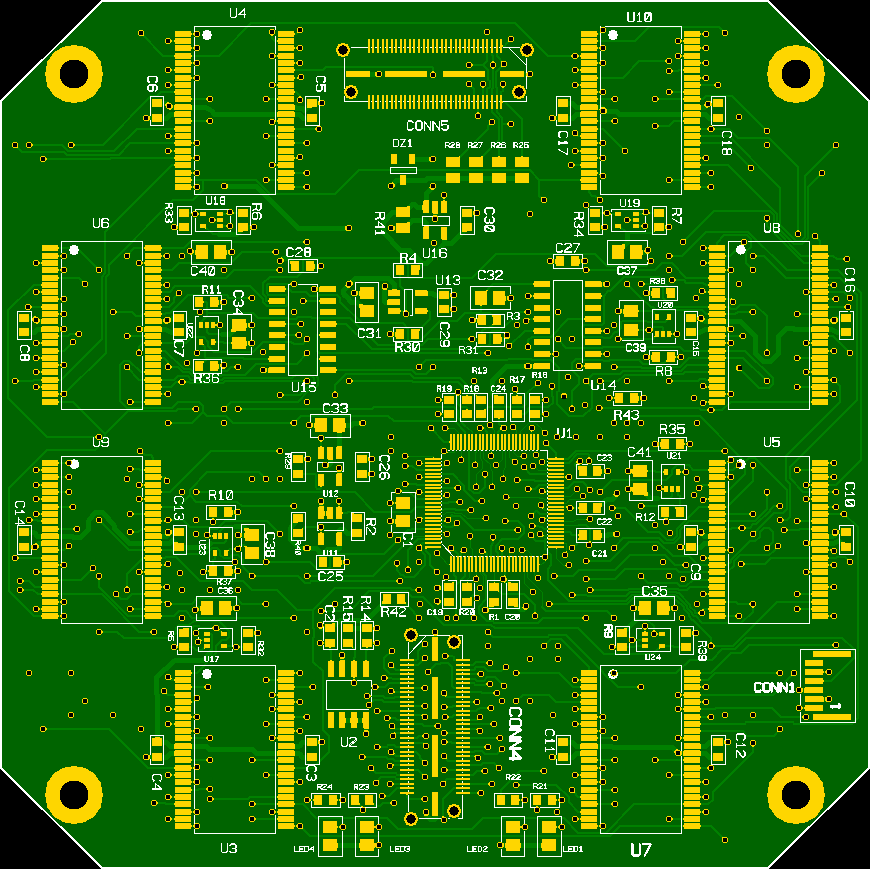
structure/3d_models/1U/Exp2 LEP top decal.PNG
