AMSAT-NA/fox-plus/structure/3d_models/1U/Exp4_V4 decal top.png

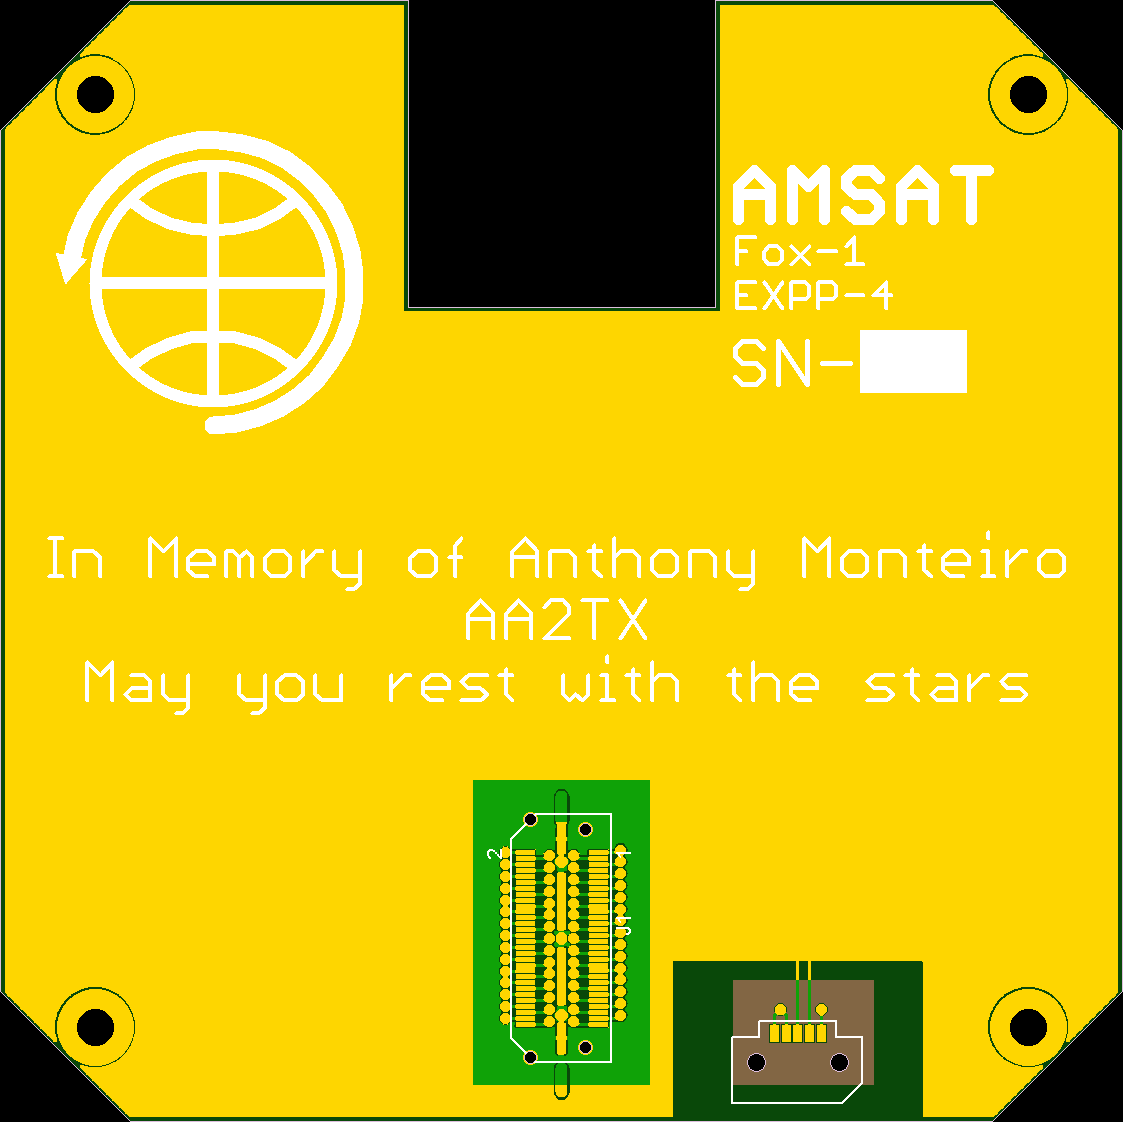
structure/3d_models/1U/Exp4_V4 decal top.png
