AMSAT-NA/fox-plus/structure/3d_models/1U/exp_v4 bottom.png

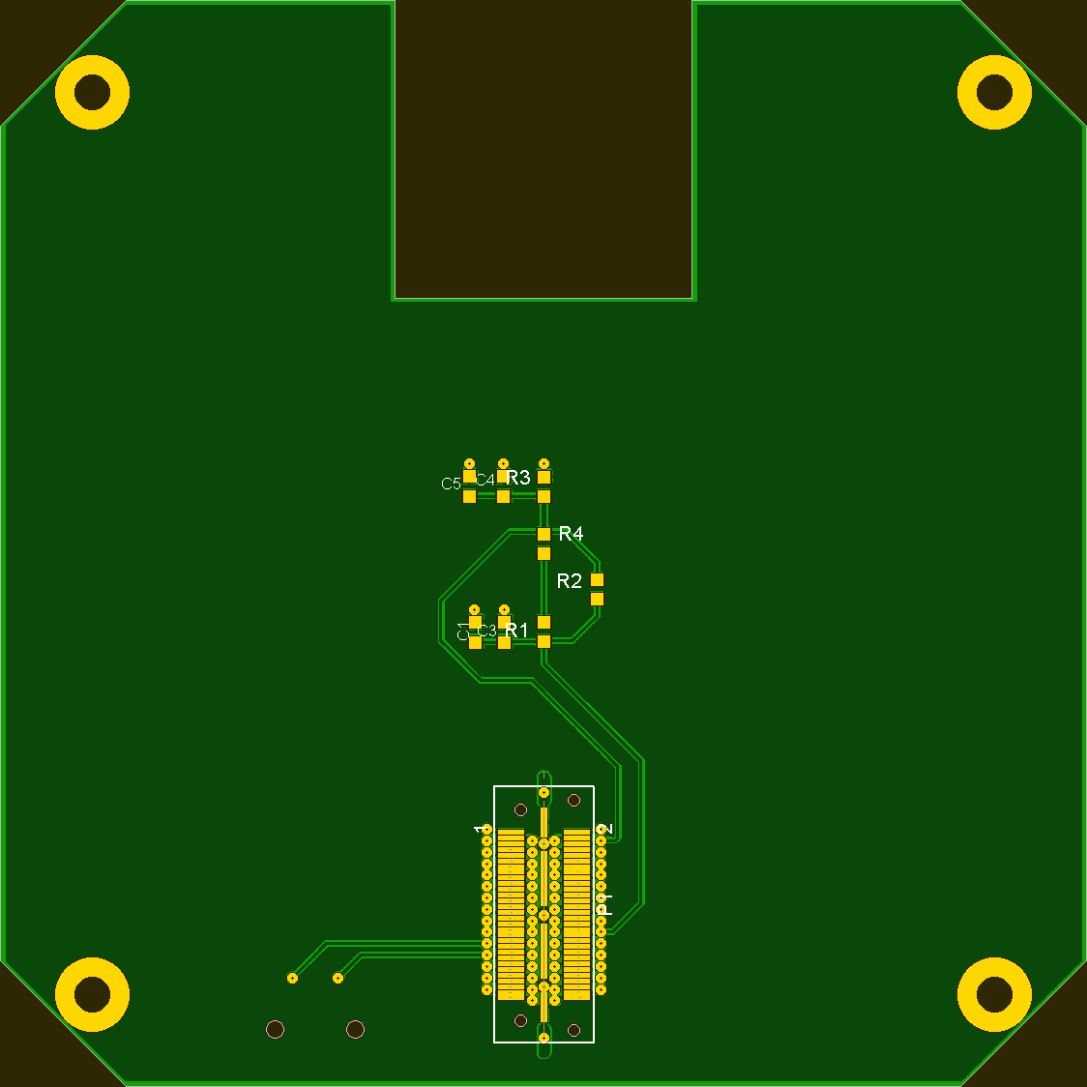
structure/3d_models/1U/exp_v4 bottom.png
