AMSAT-NA/fox-plus/structure/3d_models/1U/IHUv2_topdecal.PNG

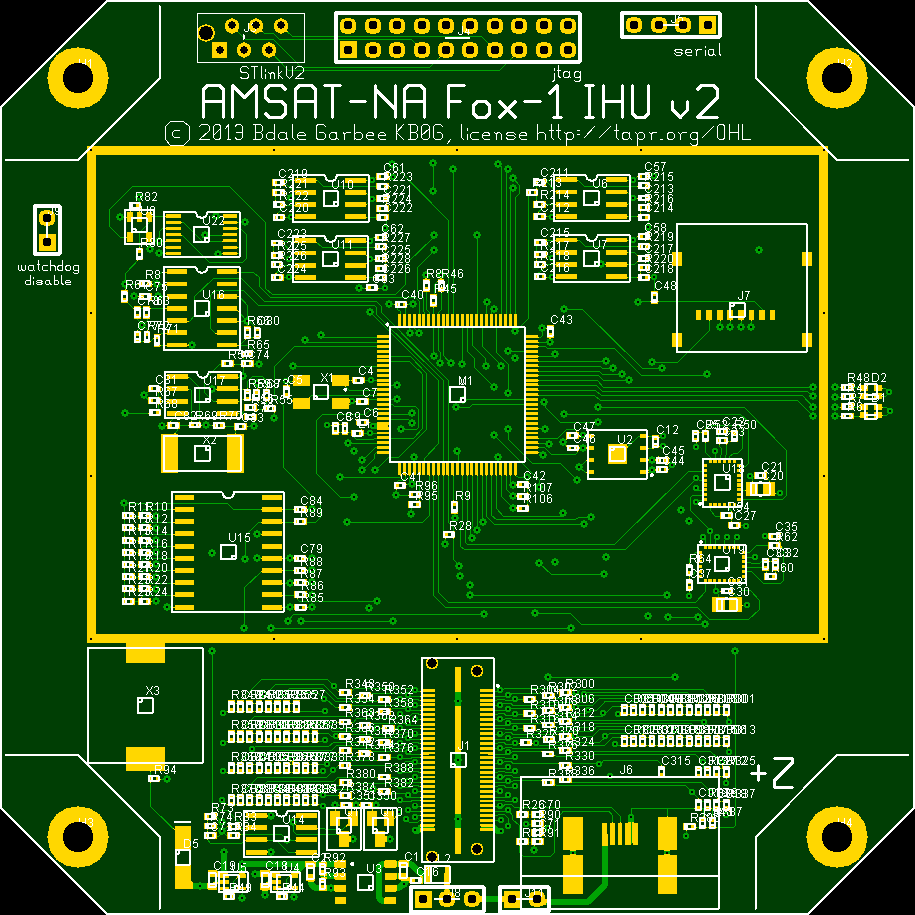
structure/3d_models/1U/IHUv2_topdecal.PNG
