AMSAT-NA/fox-plus/structure/3d_models/1U/lens_gear.PNG

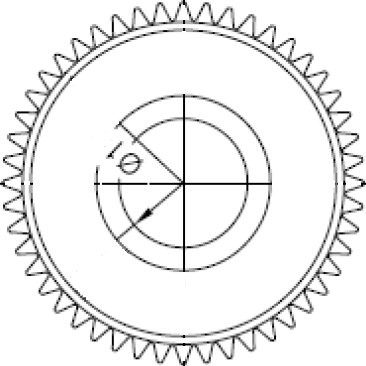
structure/3d_models/1U/lens_gear.PNG
