AMSAT-NA/fox-plus/structure/3d_models/1U/PSU bottom decal V1_07.png

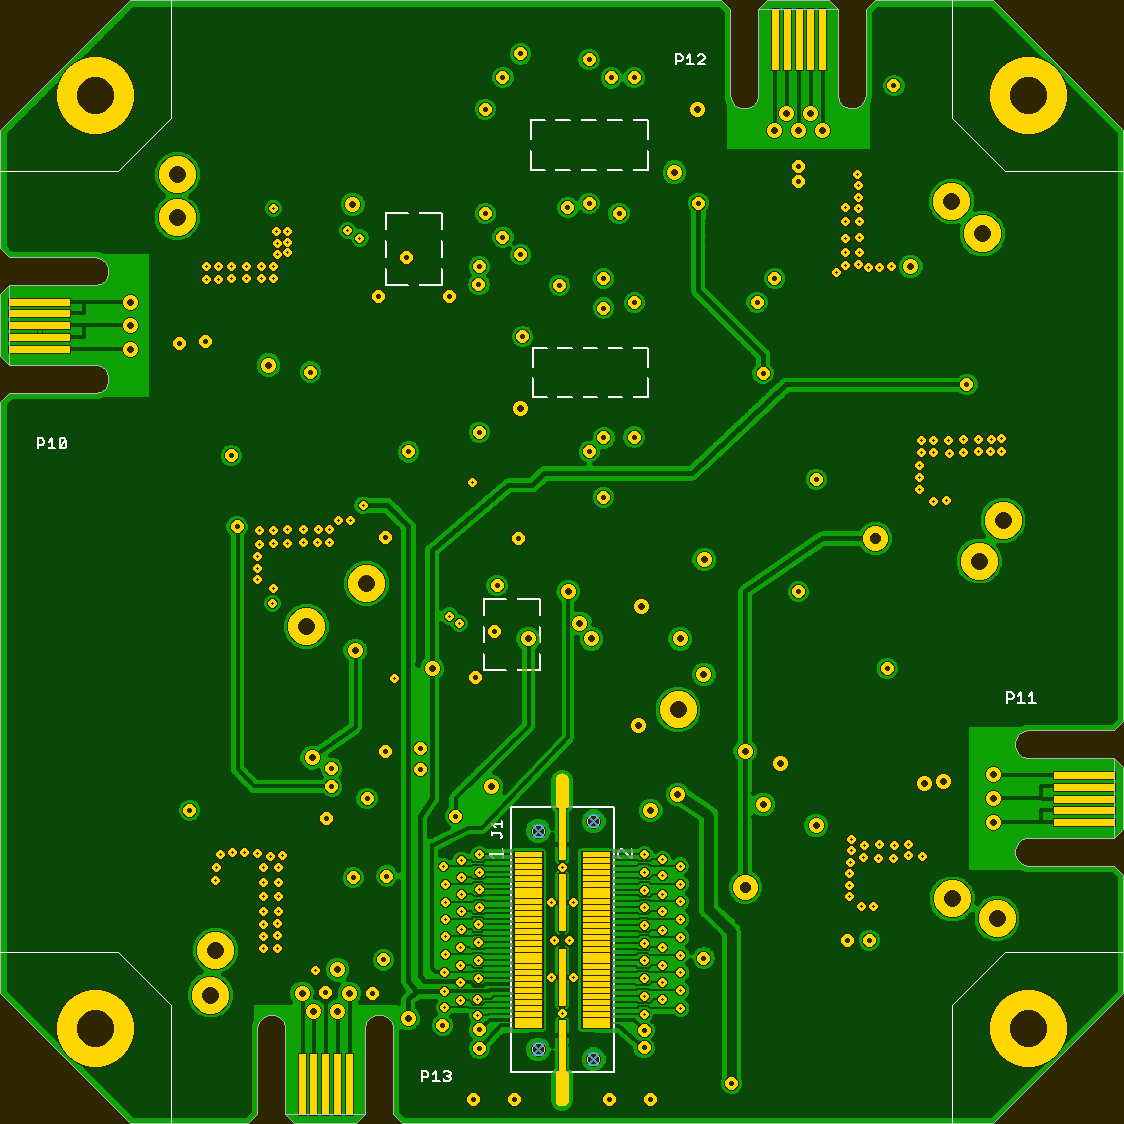
structure/3d_models/1U/PSU bottom decal V1_07.png
