AMSAT-NA/fox-plus/structure/3d_models/1U/PSU top decal V1_07.png

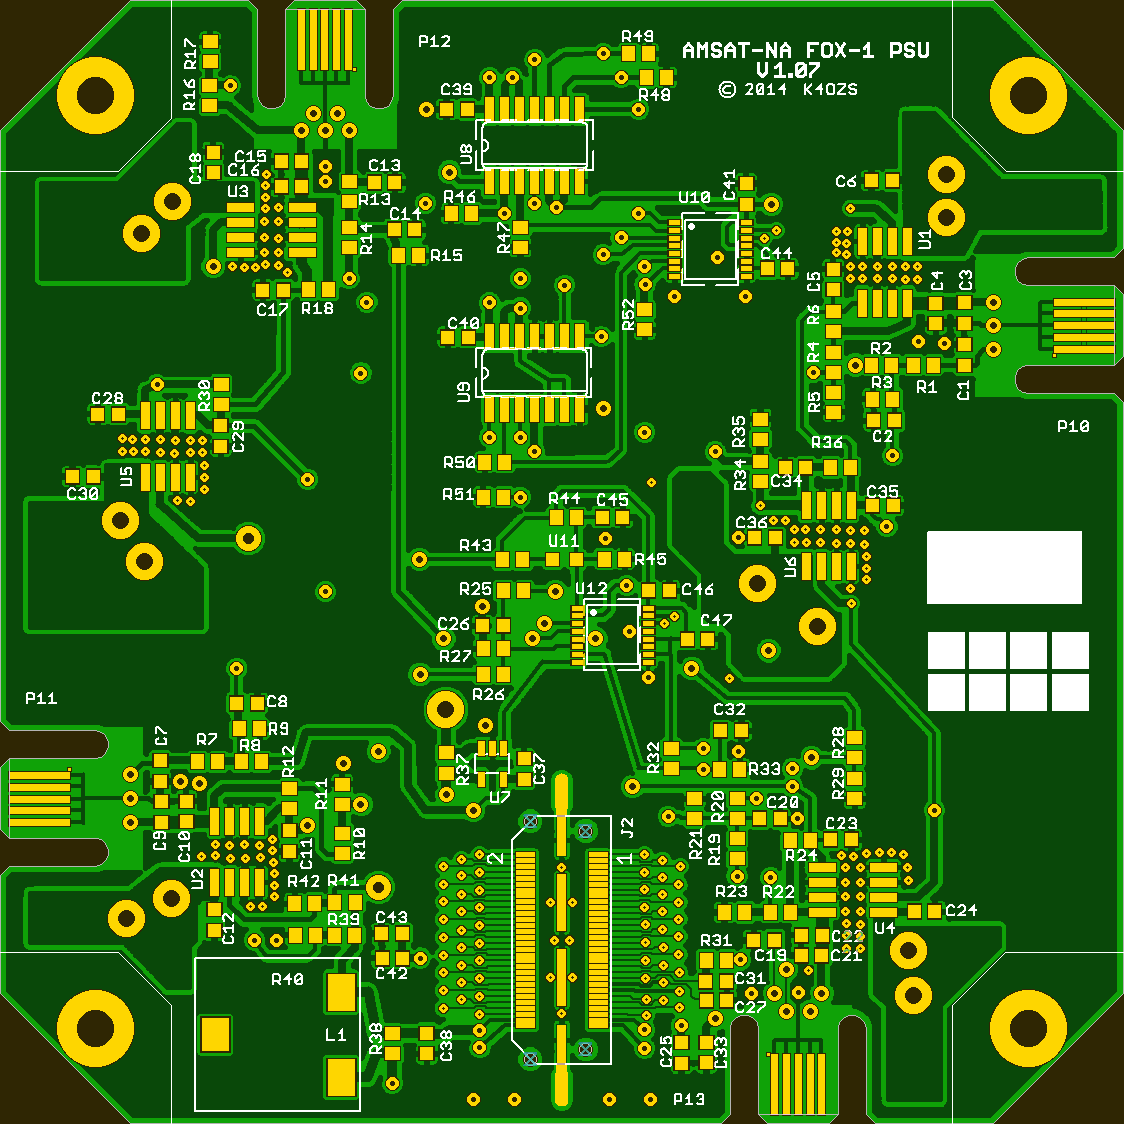
structure/3d_models/1U/PSU top decal V1_07.png
