AMSAT-NA/fox-plus/structure/3d_models/1U/RX shielded bottom.png

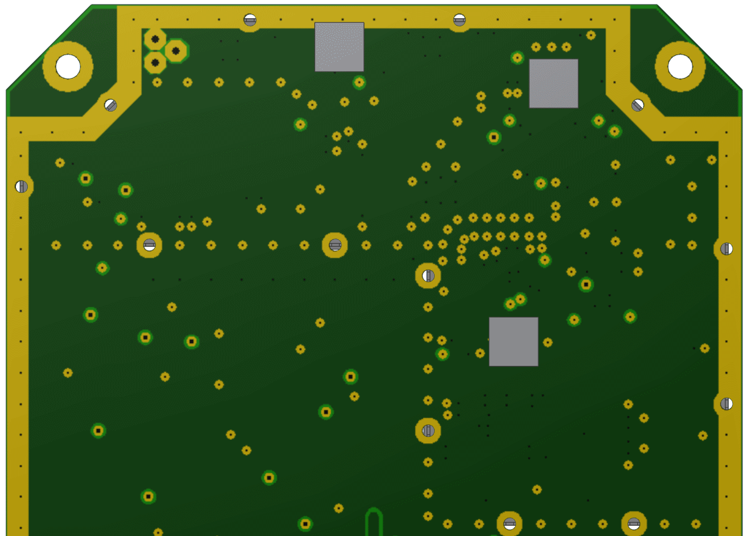
structure/3d_models/1U/RX shielded bottom.png
