AMSAT-NA/fox-plus/structure/3d_models/1U/RX V1.22 bottom decal.PNG

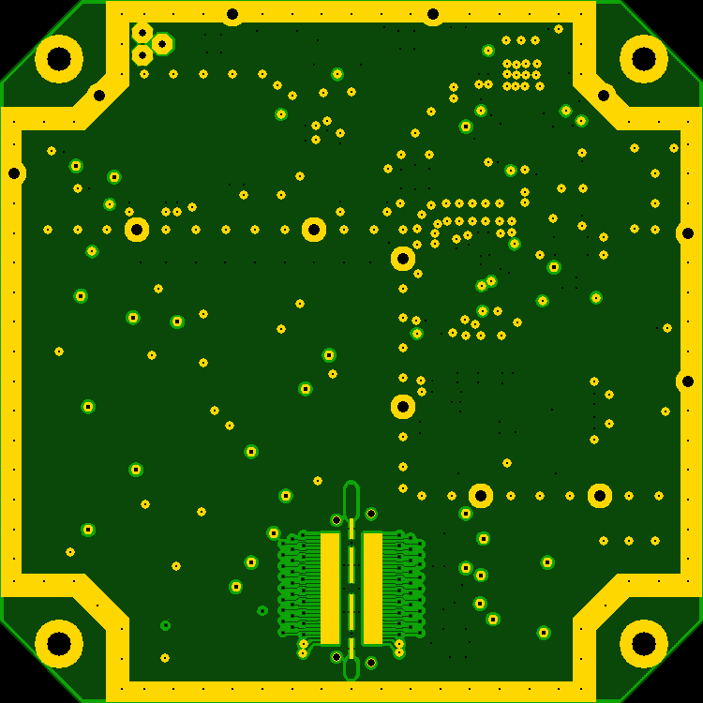
structure/3d_models/1U/RX V1.22 bottom decal.PNG
