AMSAT-NA/fox-plus/structure/3d_models/1U/TX V2.05 decal bottom.png

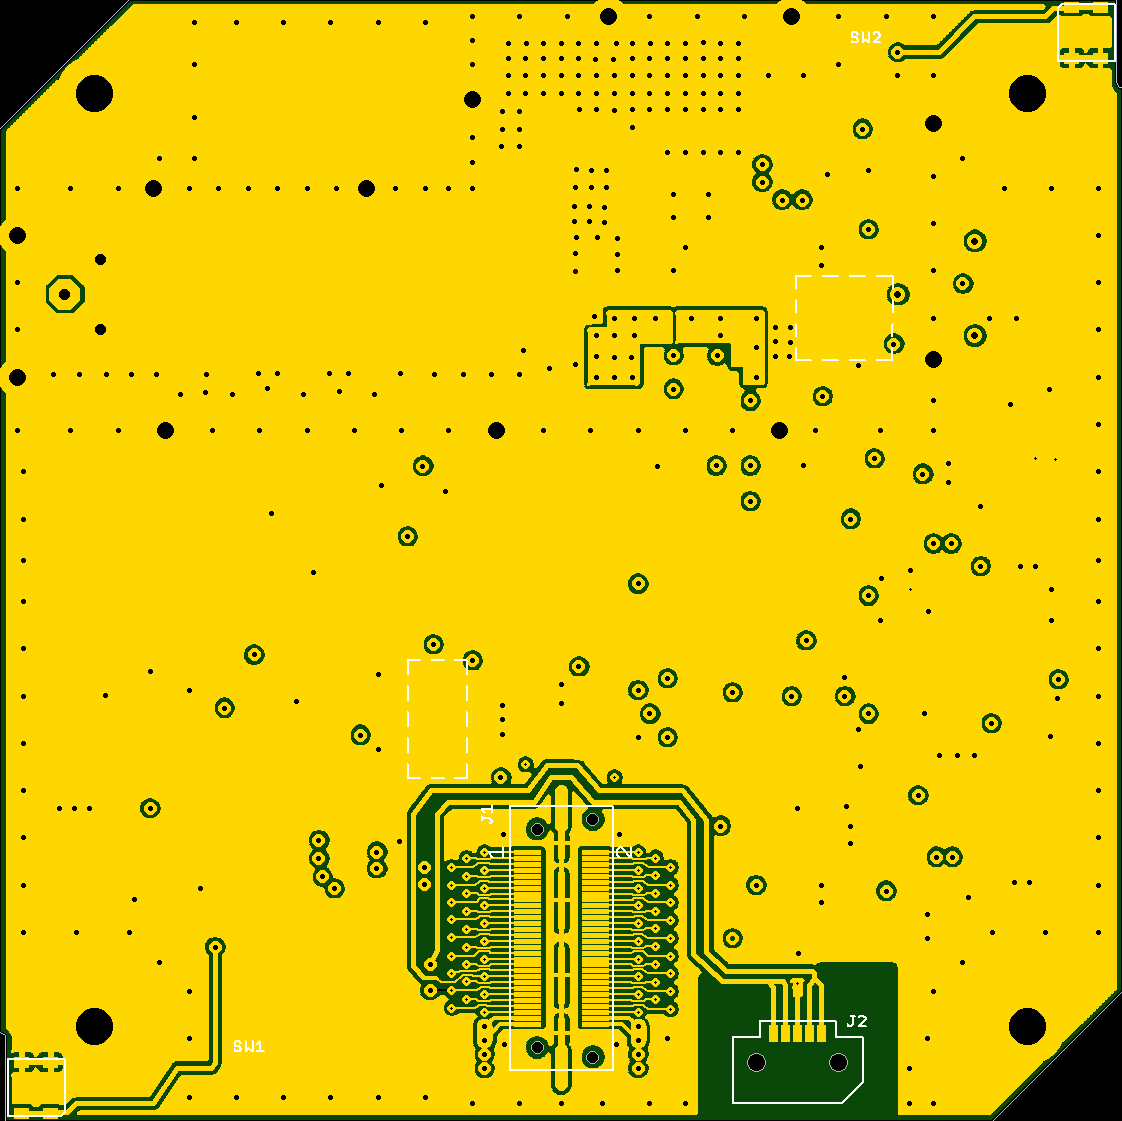
structure/3d_models/1U/TX V2.05 decal bottom.png
