AMSAT-NA/fox-plus/structure/3d_models/1U/X bottom decal.bmp

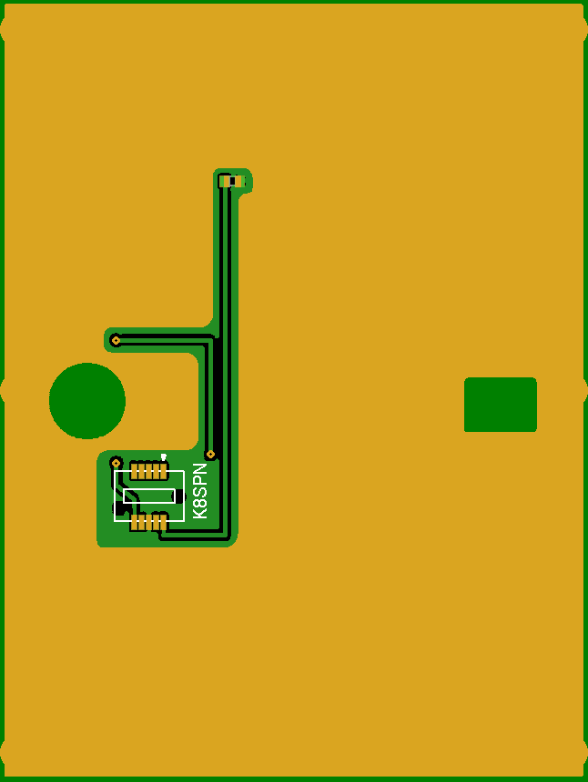
structure/3d_models/1U/X bottom decal.bmp
