AMSAT-NA/fox-plus/structure/3d_models/1U/Y bot decal rev1.PNG

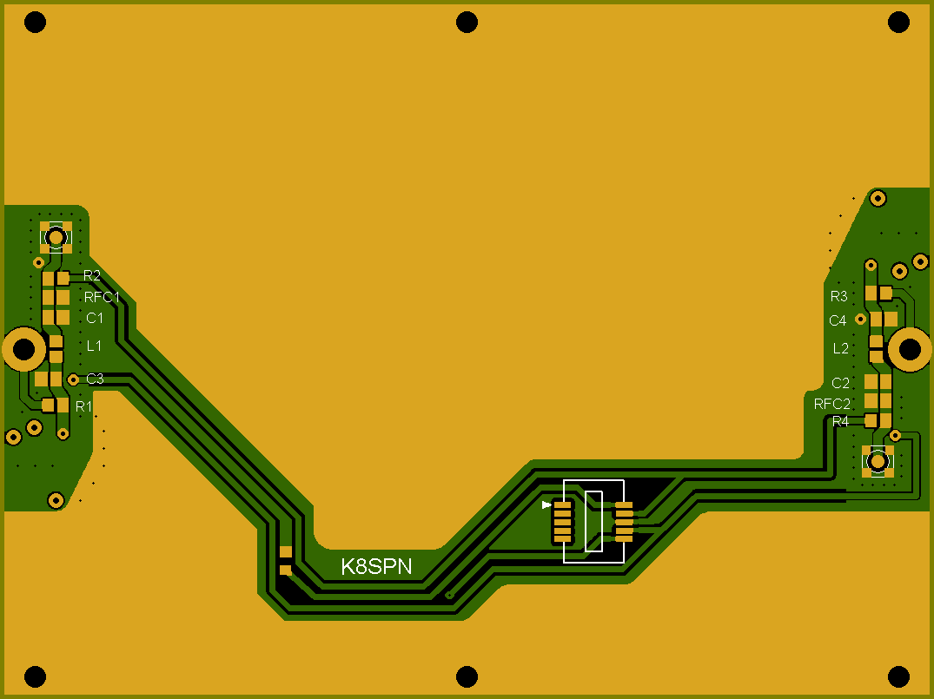
structure/3d_models/1U/Y bot decal rev1.PNG
