AMSAT-NA/fox-plus/structure/3d_models/1U/Y top decal rev1.PNG

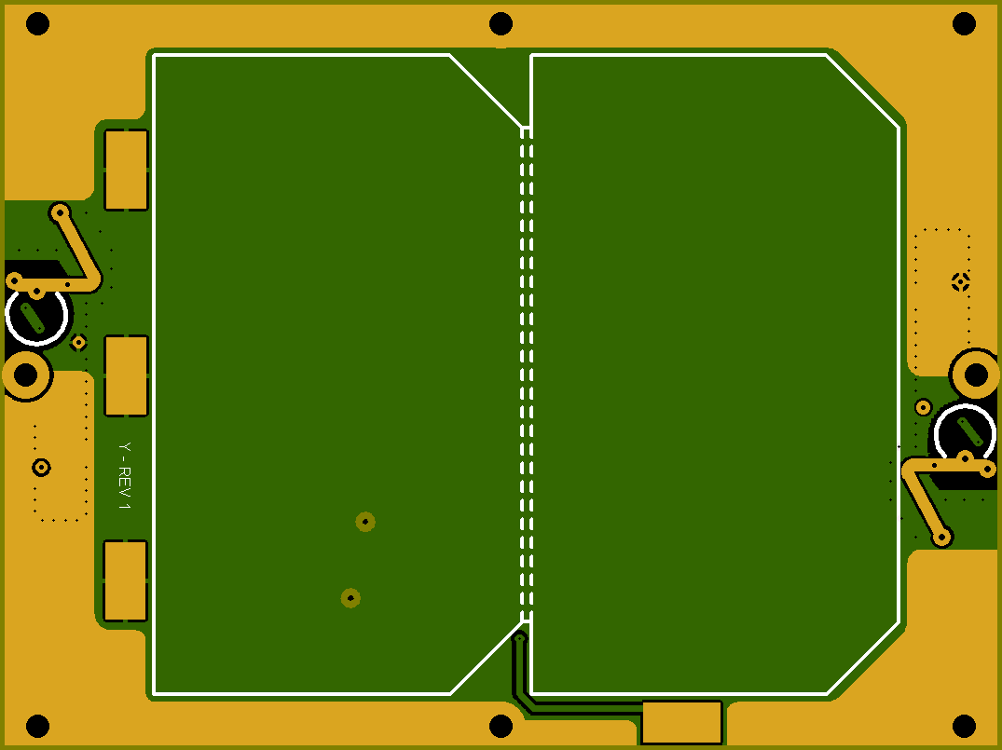
structure/3d_models/1U/Y top decal rev1.PNG
