AMSAT-NA/fox-plus/structure/3d_models/1U/Z bottom decal.bmp

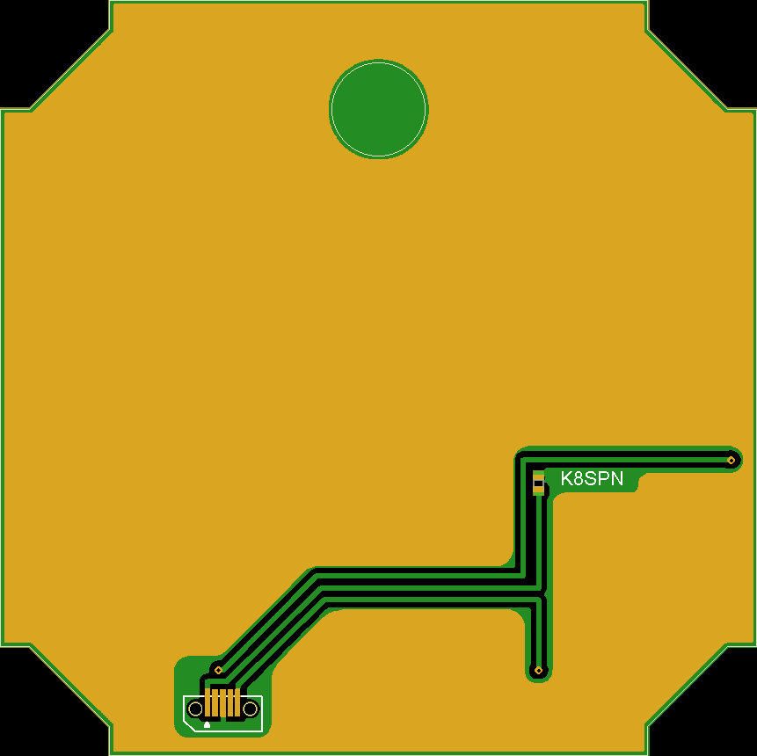
structure/3d_models/1U/Z bottom decal.bmp
