AMSAT-NA/fox-plus/structure/3d_models/CommercialFrame/1.jpg

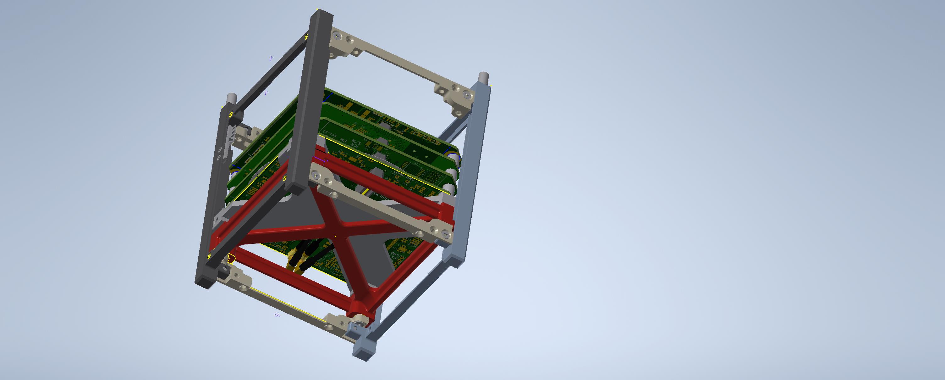
structure/3d_models/CommercialFrame/1.jpg
