AMSAT-NA/fox-plus/structure/3d_models/CommercialFrame/2.jpg

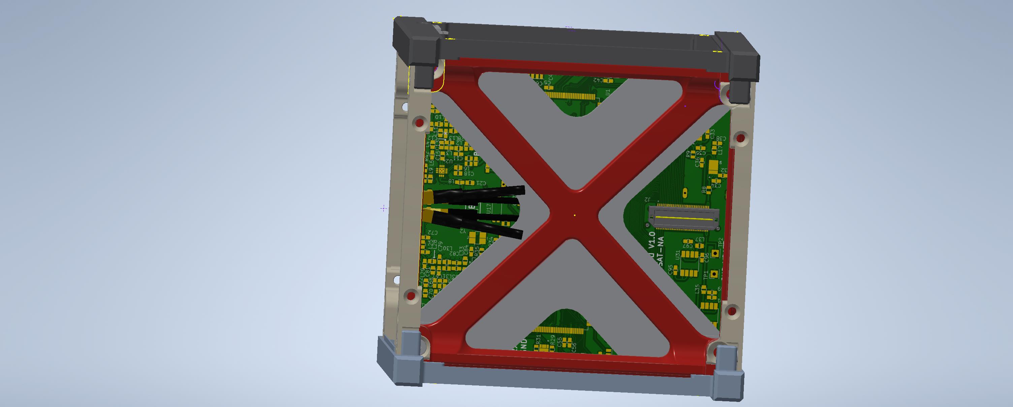
structure/3d_models/CommercialFrame/2.jpg
