AMSAT-NA/fox-plus/structure/3d_models/CommercialFrame/3.jpg

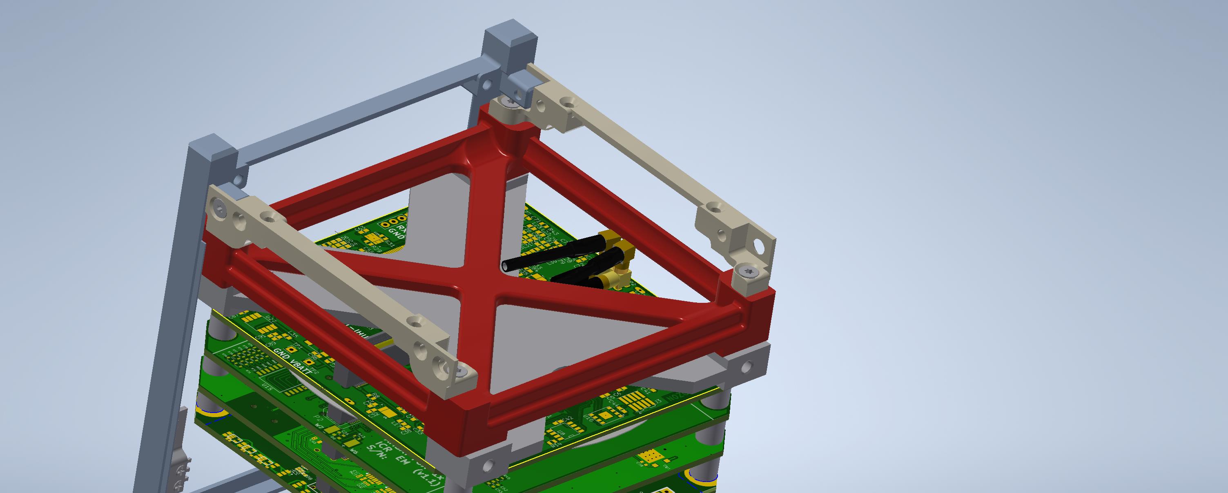
structure/3d_models/CommercialFrame/3.jpg
