AMSAT-NA/fox-plus/structure/Fox-Plus Model/2023-06-02/image.png

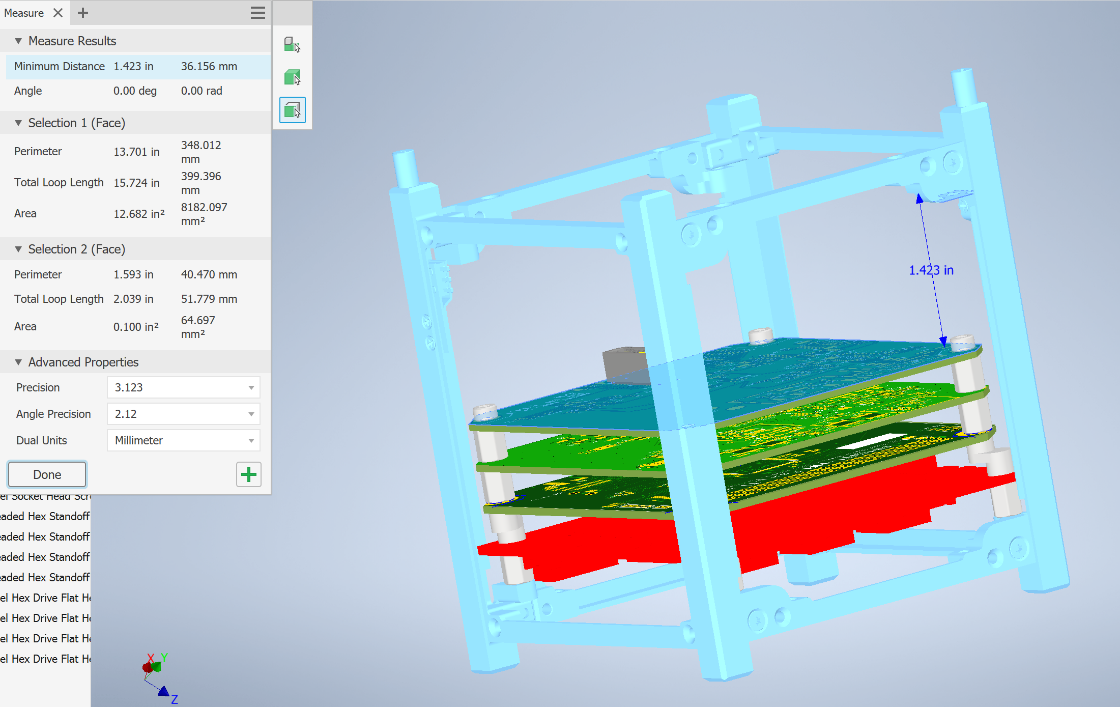
structure/Fox-Plus Model/2023-06-02/image.png
