AMSAT-NA/fox-plus/LTM/ICR FM v2.1 BOM (v1.5) ver LM Feb 15 2023.xls

Sheet: Board1
Component Designator | Value | Total QTY | Distributor | Distributor's Part Number | Manufacturer | Manufacturer's Part Number | Cost each for specified quantity | Total quantity cost | Buy quantity | Vendor quantity bin | Package | Notes | Stock Jan 25 2023 | Stock Feb 08 2023 | Stock Feb 14 2023 | Stock Feb 15 2023
C1, C2 | 8.2 pF ± 0.1 pF | 2 | Digikey | 399-8746-1-ND | Kemet | CBR06C829BAGAC | $0.33120 | $16.56 | 50 | 50 | 0603 | Ceramic COG/NPO; 250V | 3865
C3, C4, C24, C26, C29, C31, C33, C35, C37, C38, C39, C40, C43, C45, C46, C47, C50, C51, C56, C57, C62, C63, C67, C72, C73, C74 | 0.1 uF ± 5% | 26 | Digikey | 587-3468-1-ND | Taiyo Yuden | TMK107B7104KAHT | $0.01650 | $66.00 | 4000 | 4000 | 0603 | ±10%; 25V, X7R | 9167
C5, C6 | 1.5 pF ± 0.1 pF | 2 | Digikey | 712-1327-1-ND | Johnson Technology | 251R14S1R5BV4T | $0.10180 | $5.09 | 50 | 50 | 0603 | Ceramic COG/NPO; 250V | 79564
C8, C16 | 39 pF ± 1% | 2 | Digikey | 399-8824-1-ND | Kemet | CBR06C390FAGAC | $0.53860 | $26.93 | 50 | 50 | 0603 | Ceramic COG/NPO; 250V | 5377
C11 | 7 pF ± 0.1pF | 1 | Digikey | 399-8732-1-ND | Kemet | CBR06C709BAGAC | $0.33120 | $16.56 | 50 | 50 | 0603 | Ceramic COG/NPO; 250V | 1165
C13, C22 | 3.9 pF ± 0.25pF | 2 | Digikey | 399-C0603C399C5GACAUTO | Kemet | C0603C399C5GACAUTO | $0.17600 | $8.80 | 50 | 50 | 0603 | Ceramic COG/NPO 50V | 3515
C17, C18 | 6.8 pF ± 0.1pF | 2 | Digikey | 478-10274-1-ND | AVX Corporation | 06032U6R8BAT2A | $0.24240 | $12.12 | 50 | 50 | 0603 | Ceramic COG/NPO 200V | 4207
C19 | .001 uF ± 5% | 1 | Digikey | 490-1451-1-ND | MuRata Electronics North America | GRM1885C1H102JA01D | $0.02360 | $1.18 | 50 | 50 | 0603 | Ceramic COG/NPO 50V | 4796186
C20 | 12 pF ± 2% | 1 | Digikey | 712-1313-1-ND | Johanson Technology Inc. | 251R14S120GV4T | $0.23400 | $11.70 | 50 | 50 | 0603 | CAP CER 12PF 250V C0G/NP0 0603 | 73368
C21, C27, C32 | 24 pF ±1% | 3 | Digikey | 399-8798-1-ND | Kemet | CBR06C240FAGAC | $0.53860 | $26.93 | 50 | 50 | 0603 | Ceramic COG/NPO 50V | 26476
C23, C58, C64, C65, C71 | 1 uF ± 10% | 5 | Digikey | 311-1446-1-ND | YAGEO | CC0603KRX7R7BB105 | $0.04610 | $4.61 | 100 | 100 | 0603 | CAP CER 1UF 16V X7R 0603 | 10441159
C25 | 11 pF ± 1% | 1 | Digikey | 399-8787-1-ND | Kemet | CBR06C110FAGAC | $0.53860 | $26.93 | 50 | 50 | 0603 | CAP CER 11PF 250V C0G/NP0 0603 | 25254
C28, C30 | .002 uF ± 5% | 2 | Digikey | 490-1458-1-ND | MuRata Electronics North America | GRM1885C1H202JA01D | $0.04300 | $2.15 | 50 | 50 | 0603 | CAP CER 2000PF 50V C0G/NP0 0603 | 183604
C34, C66 | 10 uF ± 10% | 2 | Digikey | 1276-1948-1-ND | Samsung Electro-Mechanics | CL10B106MQ8NRNC | $0.41180 | $20.59 | 50 | 50 | 0603 | CAP CER 10UF 6.3V X7R 0603 | 2034
C36 | 47 pF ± 2% | 1 | Digikey | 399-8839-1-ND | KEMET | CBR06C470FAGAC | $0.53860 | $26.93 | 50 | 50 | 0603 | CAP CER 47PF 250V C0G/NP0 0603 | 25643
C41 | 10 pF ± 0.1pF | 1 | Digikey | 478-10285-1-ND | KYOCERA AVX | 06035A100FAT2A | $0.07900 | $3.95 | 50 | 50 | 0603 | CAP CER 10PF 50V C0G/NP0 0603 | 491342
C42, C44, C48, C49, C52, C55 | .01 uF ± 5% | 6 | Mouser | 81-GRM1885C1H103JA1D | MuRata Electronics North America | GRM1885C1H103JA01D | 0.05700 | $5.70 | 100 | 100 | 0603 | Multilayer Ceramic Capacitors MLCC - SMD/SMT .01UF 50V 5% 0603 |  | 692338
C53 | .33 uF ± 10% | 1 | Mouser | 81-GCM188R71C334KA7J | MuRata Electronics North America | GCM188R71C334KA37J |  | $0.00 | 50 | 50 | 0603 | ±10%; X7R; 16V; AEC-Q200; QTY 10 = $1.63 |  | no stock
C54 | .062 uF ± 5% | 1 | Mouser | 81-GRM31C5C1H623JA1K | MuRata Electronics North America | GRM31C5C1H623JA01K | 0.18400 | $18.40 | 100 | 100 | 0603 | Multilayer Ceramic Capacitors MLCC - SMD/SMT .062UF 50V 5% 1206 |  | 2985
C59, C60 | 180 pF ± 1% | 2 | Digikey | 399-C0603C181F5GAC7867CT-ND | Kemet | C0603C181F5GACTU | 0.55220 | $27.61 | 50 | 50 | 0603 | 180 pF ±1% 50V Ceramic Capacitor C0G, NP0 0603 (1608 Metric) |  |  |  | 14273
C61 | 100 pF ± 5% | 1 | Digikey | 399-16018-1-ND | Kemet | C0603C101J1GACAUTO | 0.04140 | $2.07 | 50 | 50 | 0603 | CAP CER 100PF 100V C0G/NP0 0603 | 56867
CX1c, P1c | VHF Antenna Cable, Inter-Board RF Cable | 1 | Digikey | J729-ND | Cinch Connectivity Solutions Johnson | 415-0066-012 | 16.83800 | $168.38 | 10 | 10 | NA | 12" MMCX coax plug cable, straight connector, male-male, RG-178, cut into two equal lengths | 577
D1 | LED (Green) | 1 | Mouser | 630-HSMG-C120 | Broadcom Limited | HSMG-C120 | 0.22600 | $22.60 | 100 | 100 |  | Standard LEDs - SMD GaP Green Grn |  | 44709
D2 | Small Signal Diode | 1 | Digikey | 112-BAS40-00-G3-08CT-ND | Vishay General Semiconductor - Diodes Division | BAS40-00-G3-08 | 0.14840 | $14.84 | 100 | 100 | NA | DIODE SCHOTTKY 40V 200MA SOT23-3 | 41176
F1, F2 | Ceramic Filter | 2 | Mouser | 81-SFECV10M7KA00-R0 | MuRata | SFECV10M7KA00-R0 |  | $0.00 |  |  |  | Ceramic Filters - SMD; Qty 10 = $15.50 |  | no stock
J1 | MMCX Female Jack | 1 | Digikey | CONMMCX002-SMD-ND | LINX Technologies, Inc. | CONMMCX002-SMD | 6.07000 | $60.70 | 10 | 10 |  | CONN MMCX RCPT R/A 50 OHM SMD |  |  | 3926
JP1 | 3-Pin Male Header | 1 | Digikey | A19340-ND | TE Connectivity AMP Connectors | 640453-3 | 0.30750 | $30.75 | 100 | 100 |  | CONN HEADER R/A 3POS 2.54MM |  |  | 1555
L1, L4, L5 | 82 nH ±2% | 3 | Coilcraft | 1515SQ-82NGEB | Coilcraft | 1515SQ-82NGEB | 1.29000 | $64.50 | 50 | 1 |  | air coil square inductor |  |  |  | 4015
L2, L3, L6 | 100 nH ±2% | 3 | Coilcraft | 0603HP-R10XGLU | Coilcraft | 0603HP-R10XGLU | 0.99000 | $49.50 | 50 | 1 |  | 0603 ceramic chip inductors |  |  |  | 9472
L7 | 270 nH | 1 | Digikey | 490-13392-1-ND | Murata | LQW18ANR27G80D | 0.12730 | $12.73 | 100 | 100 | 0603 | 270 nH Unshielded Wirewound Inductor 170 mA 2.3Ohm Max 0603 (1608 Metric) |  |  | 27075
P1 | QSH Connector | 1 | Digikey | SAM8180-ND | SAMTEC | QSH-030-01-L-D-A | 13.27520 | $331.88 | 25 | 25 |  | 60 Position Connector Receptacle, Center Strip Contacts Surface Mount Gold |  |  | 17843
P2 | QTH Connector | 1 | Mouser | 200-QTH03002LDA | SAMTEC | QTH-030-02-L-D-A | 10.30000 | $103.00 | 10 | 10 | N/A | +Z Top of ICR PCB Board to Board & Mezzanine Connectors 0.50 mm Q Strip High-Speed Ground Plane Terminal Strip |  | 4876
R1, R5, R6, R12 | SBT | 4 |  |  |  |  |  | $0.00
R2 | 24k | 1 | Digikey | P24.0KHCT-ND | Panasonic Electronic Components | ERJ-3EKF2402V | 0.02020 | $2.02 | 100 | 100 | 0603 | 24 kOhms ±1% 0.1W, 1/10W Chip Resistor 0603 (1608 Metric) Automotive AEC-Q200 Thick Film |  |  | 302592
R3, R19, R26, R27, R34, R37, R38 | 100k W | 7 | Digikey | YAG2120CT-ND | Yageo | AT0603FRE07100KL | 0.03480 | $17.40 | 500 | 500 | 0603 | 100 kOhms ±1% 0.1W, 1/10W Chip Resistor 0603 (1608 Metric) Anti-Sulfur, Automotive AEC-Q200, Moisture Resistant Thin Film |  |  | 44155
R4, R11, R42 | 0 W Jumper | 2 | Digikey | 311-270HRCT-ND | Yageo | RC0603FR-07270RL | 0.00345 | $3.45 | 1000 | 1000 | 0603 | 270 Ohms ±1% 0.1W, 1/10W Chip Resistor 0603 (1608 Metric) Moisture Resistant Thick Film - 0 ohm jumper or 270 ohm series resistor if employing a 5 dB L-Pad attenuator for the ceramic filter circuits. |  |  | 654341
R7 | 20k W | 1 | Digikey | MCT0603-20.0K-CFCT-ND | Vishay Beyschlag | MCT06030C2002FP500 | 0.05140 | $5.14 | 100 | 100 | 0603 | 20 kOhms ±1% 0.1W, 1/10W Chip Resistor 0603 (1608 Metric) Anti-Sulfur Thin Film |  |  | 48360
R8 | 68 W | 1 | Digikey | P68.0HCT-ND | Panasonic Electronic Components | ERJ-3EKF68R0V | 0.02020 | $2.02 | 100 | 100 | 0603 | 68 Ohms ±1% 0.1W, 1/10W Chip Resistor 0603 (1608 Metric) Automotive AEC-Q200 Thick Film |  |  | 460195
R9, R10 | 91 W | 2 | Digikey | P91.0HCT-ND | Panasonic Electronic Components | ERJ-3EKF91R0V | 0.02020 | $2.02 | 100 | 100 | 0603 | 91 Ohms ±1% 0.1W, 1/10W Chip Resistor 0603 (1608 Metric) Automotive AEC-Q200 Thick Film |  |  | 82601
R13 | 33k W | 1 | Digikey | YAG5959CT-ND | YAGEO | RT0603FRE0733KL | 0.02390 | $2.39 | 100 | 100 | 0603 | 33 kOhms ±1% 0.1W, 1/10W Chip Resistor 0603 (1608 Metric) Thin Film |  |  | 61558
R14 | 22k W | 1 | Digikey | YAG2126CT-ND | Yageo | AT0603FRE0722KL | 0.05760 | $5.76 | 100 | 100 | 0603 | 22 kOhms ±1% 0.1W, 1/10W Chip Resistor 0603 (1608 Metric) Anti-Sulfur, Automotive AEC-Q200, Moisture Resistant Thin Film |  |  | 120
R15 | 140 W | 1 | Digikey | 311-140HRCT-ND | Yageo | RC0603FR-07140RL | 0.00770 | $0.77 | 100 | 100 | 0603 | 140 Ohms ±1% 0.1W, 1/10W Chip Resistor 0603 (1608 Metric) Moisture Resistant Thick Film |  |  | 205951
R16 | 374k W | 1 | Digikey | P374KHCT-ND | Panasonic Electronic Components | ERJ-3EKF3743V | 0.02020 | $2.02 | 100 | 100 | 0603 | 374 kOhms ±1% 0.1W, 1/10W Chip Resistor 0603 (1608 Metric) Automotive AEC-Q200 Thick Film |  |  | 105544
R17 | 2.7k W | 1 | Digikey | YAG5955CT-ND | YAGEO | RT0603FRE072K7L | 0.02390 | $2.39 | 100 | 100 | 0603 | 2.7 kOhms ±1% 0.1W, 1/10W Chip Resistor 0603 (1608 Metric) Thin Film |  |  | 54908
R18 | 18k W | 1 | Digikey | 311-18.0KHRCT-ND | Yaego | RC0603FR-0718KL | 0.00770 | $0.77 | 100 | 100 | 0603 | 18 kOhms ±1% 0.1W, 1/10W Chip Resistor 0603 (1608 Metric) Moisture Resistant Thick Film |  |  | 823847
R20 | 887 kW | 1 | Digikey | P887KHCT-ND | Panasonic Electronic Components | ERJ-3EKF8873V | 0.02020 | $2.02 | 100 | 100 | 0603 | 887 kOhms ±1% 0.1W, 1/10W Chip Resistor 0603 (1608 Metric) Automotive AEC-Q200 Thick Film |  |  | 73218
R21 | 1 MW | 1 | Digikey | MCT0603-1.00M-CFCT-ND | Vishay Beyschlag | MCT06030C1004FP500 | 0.05140 | $5.14 | 100 | 100 | 0603 | 1 MOhms ±1% 0.1W, 1/10W Chip Resistor 0603 (1608 Metric) Anti-Sulfur Thin Film |  |  | 2151
R22 | 118 kW | 1 | Digikey | P118KHCT-ND | Panasonic Electronic Components | ERJ-3EKF1183V | 0.02020 | $2.02 | 100 | 100 | 0603 | 118 kOhms ±1% 0.1W, 1/10W Chip Resistor 0603 (1608 Metric) Automotive AEC-Q200 Thick Film |  |  | 55099
R23 | 576 kW | 1 | Digikey | P576KHCT-ND | Panasonic Electronic Components | ERJ-3EKF5763V | 0.02020 | $2.02 | 100 | 100 | 0603 | 576 kOhms ±1% 0.1W, 1/10W Chip Resistor 0603 (1608 Metric) Automotive AEC-Q200 Thick Film |  |  | 58067
R24, R25 | 100 kW | 2 | Digikey | P123902CT-ND | Panasonic Electronic Components | ERA-3AED104V | 0.10240 | $10.24 | 100 | 100 | 0603 | 100 kOhms ±0.5% 0.1W, 1/10W Chip Resistor 0603 (1608 Metric) Automotive AEC-Q200 Thin Film |  |  | 35000
R28 | 287 W | 1 | Digikey | 311-287HRCT-ND | Yaego | RC0603FR-07287RL | 0.00770 | $0.77 | 100 | 100 | 0603 | 287 Ohms ±1% 0.1W, 1/10W Chip Resistor 0603 (1608 Metric) Moisture Resistant Thick Film |  |  | 31391
R29 | 348 W | 1 | Mouser | 279-CPF0603F348RC1 | TE Connectivity / Neohm | CPF0603F348RC1 | 0.06300 | $6.30 | 100 | 100 | 0603 | Thin Film Resistors - SMD CPF 0603 348R 1% 50PPM |  | 1500
R30 | 715 W | 1 | Mouser | 279-CPF0603F715RC1 | TE Connectivity / Neohm | CPF0603F715RC1 | 0.06300 | $6.30 | 100 | 100 | 0603 | Thin Film Resistors - SMD CPF 0603 715R 1% 50PPM |  | 3432
R31 | 820 W | 1 | Mouser | 603-RT0603FRE07820RL | Yageo | RT0603FRE07820RL | 0.02300 | $2.30 | 100 | 100 | 0603 | Thin Film Resistors - SMD 1/10W 820 ohm 1% 50ppm |  | 31083
R32 | 1.54 kW | 1 | Mouser | 279-CPF0603F1K54C1 | TE Connectivity / Neohm | CPF0603F1K54C1 | 0.06300 | $6.30 | 100 | 100 | 0603 | Thin Film Resistors - SMD CPF 0603 1K54 1% 50PPM |  | 468
R33 | 3.65 kW | 1 | Mouser | 603-RT0603FRE073K65L | Yageo | RT0603FRE073K65L | 0.02300 | $2.30 | 100 | 100 | 0603 | Thin Film Resistors - SMD 1/10W 3.65K ohm 1% 50ppm |  | 2215
R35, R41, R47, R52, R55, R58, R60, R62, R64, R66, R68 | 10k W | 11 | Digikey | 118-CHP0603AFX-1002ELFCT-ND | Yageo | CHP0603AFX-1002ELF | 0.07776 | $77.76 | 1000 | 1000 | 0603 | 10 kOhms ±1% 0.333W, 1/3W Chip Resistor 0603 (1608 Metric) Anti-Sulfur, Automotive AEC-Q200, Moisture Resistant, Pulse Withstanding Thick Film |  |  | 14952
R36 | 169k W | 1 | Digikey | 311-169KHRCT-ND | Yaego | RC0603FR-07169KL | 0.00770 | $0.77 | 100 | 100 | 0603 | 169 kOhms ±1% 0.1W, 1/10W Chip Resistor 0603 (1608 Metric) Moisture Resistant Thick Film |  |  | 611802
R39 | 1k W | 1 | Digikey | MCT0603-1.00K-MFCT-ND | Vishay Beyschlag | MCT0603MC1001FP500 | 0.11290 | $11.29 | 100 | 100 | 0603 | 1 kOhms ±1% 0.1W, 1/10W Chip Resistor 0603 (1608 Metric) Anti-Sulfur, Automotive AEC-Q200 Thin Film |  |  | 38587
R40 | 47k W | 1 | Digikey | YAG3610CT-ND | Yageo | AC0603FR-0747KL | 0.01030 | $1.03 | 100 | 100 | 0603 | 47 kOhms ±1% 0.1W, 1/10W Chip Resistor 0603 (1608 Metric) Automotive AEC-Q200, Moisture Resistant Thick Film |  |  | 209466
R43 | 1.8M W | 1 | Digikey | P1.80MHCT-ND | Panasonic Electronic Components | ERJ-3EKF1804V | 0.01880 | $1.88 | 100 | 100 | 0603 | 1.8 MOhms ±1% 0.1W, 1/10W Chip Resistor 0603 (1608 Metric) Automotive AEC-Q200 Thick Film |  |  | 251196
R44 | 160k W | 1 | Digikey | P160KHCT-ND | Panasonic Electronic Components | ERJ-3EKF1603V | 0.02020 | $2.02 | 100 | 100 | 0603 | 160 kOhms ±1% 0.1W, 1/10W Chip Resistor 0603 (1608 Metric) Automotive AEC-Q200 Thick Film |  |  | 71262
R50, R54, R56, R59, R61, R63, R65, R67 | 4.42k W | 8 | Digikey | P4.42KHCT-ND | Panasonic Electronic Components | ERJ-3EKF4421V | 0.00907 | $9.07 | 1000 | 1000 | 0603 | 4.42 kOhms ±1% 0.1W, 1/10W Chip Resistor 0603 (1608 Metric) Automotive AEC-Q200 Thick Film |  |  | 136534
R69 | 165k W | 1 | Mouser | 279-RP73D1J165KBTDG | TE Connectivity Passive Product | RP73D1J165KBTDG | 0.94000 | $94.00 | 100 | 100 | 603 | Thin Film Resistors - SMD 165 kOhms .1% 15ppm .10 Watt 0603 |  | 36
R70, R87 | 301k W | 1 | Digikey | P301KHCT-ND | Panasonic Electronic Components | ERJ-3EKF3013V | 0.02020 | $2.02 | 100 | 100 | 0603 | 301 kOhms ±1% 0.1W, 1/10W Chip Resistor 0603 (1608 Metric) Automotive AEC-Q200 Thick Film |  |  | 95005
R71 TO R86 | DNP | 16 |  |  |  |  |  | $0.00 |  |  |  | Actual Command Channel address is SENSITIVE schematic information. {U17 Address selection via 0 ohm jumpers or DNPs)
RF1 | BPF RF Shield | 2 | Digikey | 903-1010-1-ND | Laird Technologies EMI | BMI-S-105 | 2.96080 | $74.02 | 25 | 25 |  | RF Shield Shield, 1-Piece 1.000" (25.40mm) X 1.500" (38.10mm) Vent Holes in Pattern Surface Mount |  |  | 3568
T1 | 4-Pin Test Point | 1 | Digikey | 732-5460-5-ND | Wurth | 61000421121 | 0.52704 | $65.88 | 125 | 125 |  | Connector Header Surface Mount 4 position 0.100" (2.54mm) - 4-Pin Test Point (initial testing only - then replaced with 0 ohm jumper) (in library) |  |  | 3609
U1 | Pwr Splitter | 1 | Mouser | 139-ADP-2-10 | Mini-Circuits | ADP-2-10+ | 17.86000 | $178.60 | 10 | 10 |  | Signal Conditioning PWR SPLTR CMBD / SURF MT/ RoHS |  | 619
U2 | VHF LNA | 1 | Digikey | 576-4341-1-ND | MicroChip Technologies | MICRF300YC6-TR |  | $0.00 |  |  |  | EOL - OBSOLETE
U3 | Rcvr L.O. | 1 | Mercury | VMQF326T25-135.135-2.5/-30+85 | Mercury United Electronics, Inc. | VMQF326T25 |  | $0.00 |  |  |  | SA636DK Local Oscillator (VCTCXO); On Hand - 1(1E) & 1(HS) Freqs; six 3.3V parts tested to only 2.5V |  |  |  | Choose Alternate part
U4 | FM Receiver | 1 | Mouser | 771-SA636DK/01-T | NXP Semiconductor/Phillips | SA636DK/01,118 |  | $0.00 |  |  |  | FM IF System |  | not available
U5 | Quad OP AMP | 1 | Digikey | 296-35226-1-ND | Texas Instruments | LM6144BIMX/NOPB | 6.98600 | $174.65 | 25 | 25 | SOIC-14 | General Purpose Amplifier 4 Circuit Rail-to-Rail 14-SOIC |  |  |  | 7036
U6 | Dual Input AND Gate | 1 | Digikey | 296-22344-1-ND | Texas Instruments | SN74LVC1G08IDCKREP | 1.56600 | $39.15 | 25 | 25 | SC70-5 | AND Gate IC 1 Channel SC-70-5 |  |  |  | 6291
U7 | LTC6994-1 | 1 | Mouser | 584-C6994IS6-1TRMPBF | Linear Technology/Analog Devices | LTC6994IS6-1#TRMPBF |  | $0.00 |  |  |  | Delay Block (SOT 23-6); Qty 10 = $38.40 |  | no stock
U8 | CMOS Osc. | 1 | Mouser | 774-CB3LV3I3M579545 | CTS Electronic Components | CB3LV-3I-3M579545 | 1.58000 | $47.40 | 30 | 10 |  | Standard Clock Oscillator 3.579545.0MHz 3.3V -40C +85C 50ppm NEW FOOTPRINT NEEDED? |  |  |  | 2970
U9 | Bell 202 Modem | 1 | Digikey | 2032-1021-ND | CML Microcircuits (USA), Inc. | MX614DW | 12.26440 | $306.61 | 25 | 25 | 16-SOIC | 1.8k Modem FSK 16-SOIC |  |  |  | 1321
U10 | Quad 2-Input NAND Gate | 1 | Digikey | 74VHC132MTCXCT-ND | Fairchild (ON Semiconductor) | 74VHC132MTCX | 0.48600 | $12.15 | 25 | 25 | TSSOP-14 | NAND Gate IC 4 Channel Schmitt Trigger 14-TSSOP |  |  |  | 9057
U11 | Load Mgr IC | 1 | Digikey | FPF2004CT-ND | Fairchild (ON Semiconductor) | FPF2004 |  | $0.00 |  |  |  | Advanced Load Management Switch |  |  |  | no stock
U12 | 3.3V LDO Regulator | 1 | Digikey | LT1963AES8-3.3#PBF-ND | Linear Technology | LT1963AES8-3.3PBF | 5.60480 | $140.12 | 25 | 25 | 8-SOIC | IC REG LINEAR 3.3V 1.5A 8SOIC |  |  |  | 8054
U13 | Temp Sensor | 1 | Digikey | 505-TMP36GRTZ-REEL7CT-ND | Analog Devices Inc. | TMP36GRTZ-REEL7 | 1.71000 | $42.75 | 25 | 25 | SOT23-5 | Temperature Sensor Analog, Local -40°C ~ 125°C 10mV/°C SOT-23-5 |  |  |  | 39
U15 | 12-Bit 8-Channel ADC | 1 | Digikey | 296-38856-1-ND | Texas Instruments | ADS7828E/2K5 | 5.97560 | $149.39 | 25 | 25 | 16-TSSOP | 12 Bit Analog to Digital Converter 8 Input 1 SAR 16-TSSOP |  |  |  | 19174
U16 | Decoder Oscillator | 1 | Digikey | LTC6906IS6#TRMPBFCT-ND | Linear Technology | LTC6906IS6#TRMPBF |  | $0.00 | 25 | 25 | TSOP-23-6 | Oscillator, Silicon IC 10kHz ~ 1MHz TSOT-23-6 |  | Can we use the LTC6907? |  | no stock
U17 | 212 Decoder | 1 | Newark | 53M7832 | Holtek | HT12D-20SOPLF |  | $0.00 |  |  |  | SOP20 package |  |  |  | EOL
U18 | FET Switch | 1 | Digikey | 296-19150-1-ND | Texas Instruments | SN74CB3T1G125DBVR | 0.77760 | $19.44 | 25 | 25 | SOT23-5 | IC BUS SWITCH 1 X 1:1 SOT23-5 |  |  |  | 34394
U19 | Inverter | 1 | Digikey | 296-11599-1-ND | Texas Instruments | SN74LVC1G04DBVR | 0.23760 | $5.94 | 25 | 25 | SOT23-5 | IC INVERTER 1CH 1-INP SOT23-5 |  |  |  | 82135
W1-W9 | PCB Test Points | 9 | Digikey | 36-5017CT-ND | Keystone Electronics | 5017 | 0.25260 | $126.30 | 500 | 500 | N/A | PC Test Point, Miniature Phosphor Bronze Silver Plating Surface Mount Mounting Type |  |  |  | 525576
X1 | Discriminator | 1 | EIS Ltd | PI#EIS160921E-6 | MuRata | CDSCB10M7GA096-R0 |  | $0.00 |  |  |  | Ceramic Discriminator |  |  |  | Choose an alternate part
 |  | 190

Sheet: Revision Date
Rev date
Feb 15 2023
