AMSAT-NA/fox-plus/mechanical/Documents/FoxPlusMEL.xlsx

 | Mission Name: |  | UNIT MASS | NUMBER OF UNITS |  |  |  |  |  | FLIGHT HARDWARE MASS |  |  | NOMINAL FLIGHT HARDWARE POWER |  |  |  | PEAK FLIGHT HARDWARE POWER |  |  |  | QUIESCENT
Level | Subassembly / Component | Dimensions | Unit Mass | Cold Units | Hot Units | Flight Units | Flight Spares | ETU/Qual Units | EM/EDU/Prototype | Total Mass | Contingency | Total Mass w/ Contingency | Unit Power | Total Power | Contingency | Total Power with Contingency | Unit Power | Total Power | Contingency | Total Power with Contingency | Total Power | Compostiion | Vendor | Part Number | Other Description
 |  | L x W x H | [g] |  |  |  |  |  |  | [g] | [%] | [g] | [W] | [W] | [%] | [W] | [W] | [W] | [%] | [W] | [W]
