AMSAT-NA/fox-plus/systems_engineering/bus_diagrams/Fox-Plus Bus.ods

Sheet: BUS
 | Fox-Plus Bus | 03/12/23
Fox-Plus QxH Connector |  |  |  |  |  |  |  | Fox-1E | Golf-Tee
Pin | Name | Type | Voltage | Source System | Load Z | Load System | Notes
1 | L1 | Digital |  | LIHU |  | EXP 1-4 | SPI Standard, IHU Master | SPI1 NSS | L1, LIHU, digi; Who’s in control - L1 line to RT-IHU
2 | TX_PA_CURRENT | Analog | 0 - 3.0 V | TX | 30 - 60 kΩ | IHU |  | / | /
3 | SCK1 | Digital | Note¹ | LIHU |  | EXP 1-4 | SPI Standard, IHU Master | SPI1 SCK, EXP 1-4 | /
4 | TX_TEMP | Analog | 0 - 3.0 V | TX | 30 - 60 kΩ | IHU | Thermistor Circuit | / | / Rx/Tx LT Power Amp
5 | MISO1 | Digital |  | LIHU, RX/TX, CAN control |  | EXP 1-4 | SPI Standard, IHU Master | SPI1 MISO, EXP 1-4 | / SPI bus Master In, Slave Out
6 | RX3 | Analog | N/A | EXP 4 | N/A | LIHU | LIHU Console Serial Rcv Chan; Mark High | Experiment 4 Thermistor, EXP 4 | RX3, Digi, LIHU RX Chan, ASYNC, Mark High
7 | MOSI1 | Digital |  | LIHU |  | RX/TX, CAN Control | MOSI1: SPI Bus Master Out, Slave Into RX-TX’s TLM modulator and CAN Control/Xcvr | SPI MOSI, EXP 1-4 | MOSI1: SPI Bus Master Out, Slave Into RX-TX’s TLM modulator and CAN Control/Xcvr
8 | VGA Control | Analog | 0 - 3.3 V | RX/TX |  | LIHU | RX/TX internally generated Voltage control from the LT Power Amp’s VGA | RX Temperature | /, copied from Golf-Tee as same
9 | RX2 (Available) | Digital | 3.0 V |  |  |  | Async, Mark High (Not Used) | Serial2 RXD | RX2, OBC’s Rcv Chan form ADAC flight Computer; ASYNC, Mark High
10 | RSSI | Analog | 0 - 3.0 V | ICR | 30 - 60 kΩ | LIHU | Received Signal Strength Indication | / | Analog Received Signal Strength Indicator (RSSI) from the ICR Cmd Rcvr
11 | TX2 (Available) | Digital | 3.0 V |  |  |  | Async, Mark High (Not Used) | Serial2 TXD, EXP 1-4
12 | TLM_Data | Digital | 0-3.3 | LIHU | RX/TX | RX/TX | Telemetry data to be transmitted by the RX/TX card on the TLM downlink channel. | Telemetry Data, analog? | Telemetry data to be transmitted by the RX/TX card on the TLM downlink channel.
13 | EXP1_Enable | Digital | 0 & 3 Volts |  |  | EXP 1 | HIGH = Enable EXP 1 | Experiment Enable 1
14 | TX3 (Available) | Digital | 0 & 3 Volts | LIHU |  |  | s | Not Used
15 | RO | Digital | 0 & 3 Volts | RT-IHU |  | LIHU | OBCs' Who's In-Control Coordination—R0 line from RT-IHU | Experiment Enable 2 | OBCs' Who's In-Control Coordination—R0 line from RT-IHU
16 | CMD_H/W_Bit_0 | Digital | 0 & 3 Volts |  |  |  | Hardware Command Bit #0 (LSB) | RX Command Data 0
17 | LO | Digital | 0 & 3 Volts | LIHU |  | RT-IHU | OBCs' Who's In-Control Coordination—L0 line to RT-IHU | Experiment Enable 3 | OBCs' Who's In-Control Coordination—L0 line to RT-IHU
18 | CMD_H/W_Bit_1 | Digital | 0 & 3 Volts |  |  | RT-IHU | Hardware Command Bit #1: HIGH = Primary and Secondary RT- IHU/DCT OBC OFF | RX Command Data 1 | Hardware Command Bit #1: HIGH = Primary and Secondary RT- IHU/DCT OBC OFF
19 | R1 | Digital | 0 & 3 Volts | RT-IHU |  | LIHU | OBCs' Who's In-Control Coordination—R1 line from RT-IHU | Experiment Enable 4 | OBCs' Who's In-Control Coordination—R1 line from RT-IHU
20 | CMD_H/W_Bit_2 | Digital | 0 & 3 Volts |  |  | LIHU | Hardware Command Bit #2: HIGH = LIHU OFF; LOW = LIHU ON | RX Command Data 2 | Hardware Command Bit #2: HIGH = LIHU OFF; LOW = LIHU ON
21 | Not Used |  |  |  |  |  |  | SER RXD | RX1: OBC's Serial Receive Channel from the SDR; ASYNC, Mark High
22 | CMD_H/W_Bit_3 | Digital | 0 & 3 Volts |  |  | OBCs and all Transmitters | Hardware Command Bit #3 (MSB): HIGH = Inhibit ALL transmitters | RX Command Data 3 | Hardware Command Bit #3 (MSB): HIGH = Inhibit ALL transmitters
23 | I2C1_SCK | Digital | 0 & 3 Volts | OBCs |  | Various | I2C Standard Bus #1 Clock (Bidirectional): in-control OBC Master | I²C1 SCL | I2C Standard Bus #1 Clock (Bidirectional): in-control OBC Master
24 | CMD_H/W_Strobe | Digital | 0 & 3 Volts |  |  | OBCs | HIGH = Command Data Valid | RX Command Strobe | HIGH = Command Data Valid
25 | I2CI_SDA | Digital | 0 & 3 Volts | OBCs |  | Various | I2C Standard Bus #1 Data (Bidirectional): in-control OBC Master | I²C1 SDA | I2C Standard Bus #1 Data (Bidirectional): in-control OBC Master
26 | RX/TX_CNTL | Digital | 0 & 3 Volts | OBCs |  | RX/TX | HIGH = LIHU Controls RF LOW = Standalone Analog Transponder | IHU RF Control | HIGH = the in-control OBC is functioning properly; LOW = NO operational OBC, therefore the LT's RX/TX functions "Autonomously" (i.e., the LT's transponder is enabled, but NO telemetry transmissions)
27 | TX1 (Available) |  |  |  |  |  |  | Not Used | OBCs Serial Transmit Channel to the SDR; ASYNC, Mark High
28 | SPI1_SS | Digital | 0 & 3 Volts | LIHU |  | RxTx | Slave select for SPI to modulator | Modulator SS | SPI1 Slave Select to RX/TX Card's TLM Modulator IC for register access
29 | LT_RF_PWR_CNTL | Digital | 0 & 3 Volts | OBCs |  | RX/TX | LT RF Pwr Output: Logic level High = High power TX (TLM and/or PB); Logic level Low = Low power TX (TLM and/or PB). | Solar Safe N: N.O. for Operation | LT RF Pwr Output: Logic level High = High power TX (TLM and/or PB); Logic level Low = Low power TX (TLM and/or PB).
30 | PB_Enable | Digital | 0 & 3 Volts | OBCs |  | RX/TX | Linear Transponder (LT) User Passband PB) Transmissions Enable Signal | RF TX Active: High = RF TX on | Linear Transponder (LT) User Passband PB) Transmissions Enable Signal
31 | Alert Signal | Digital |  | IHU |  | BATT |  | / | Alert_Inhibit: Inhibit, enable or cycle the CIU's power alert buzzer & LED (HIGH to Inhibit)
32 | TX_FWD_PWR | Analog |  | RX/TX |  | OBCs | LT Power Amplifier (FORWARD) Transmit Power | Tx Fwd Power | LT Power Amplifier (FORWARD) Transmit Power
33 | -Z Deploy Switch 1 | Switch | N/A | TX | N/A | PSU/BATT | N.O. when deployed | / | Bus_NC_33: Available
34 | CMD_Serial_ Data | Digital | 0 & 3 Volts | ICR |  | LIHU | Uplinked Software Commands Serial Data Stream | / | Uplinked Software Commands Serial Data Stream
35 | -Z Deploy Switch 2 | Switch | N/A | TX | N/A | PSU/BATT | N.O. when deployed | / | Bus_NC_35: Available
36 | I2C1_Reset | Digital | 0 & 3 Volts | OBCs |  | Various | An OBC pulsing this line high to low to high resets or power cycles any connected I2C1 and load management devices. | Not Used | An OBC pulsing this line high to low to high resets or power cycles any connected I2C1 and load management devices.
37 | I2C2_SCK | Digital | 0 & 3 Volts | OBCs |  | Various | I2C Bus #2 Clock (Bidirectional): in-control OBC Master | I²C2 SCL: I2C Standard, IHU Master | I2C Bus #2 Clock (Bidirectional): in-control OBC Master
38 | I2C2_Reset | Digital | 0 & 3 Volts | OBCs |  | Various | An OBC pulsing this line high to low to high resets or power cycles any connected I2C2 and load management devices. | Sensor Power: Power for analog telemetry sensors | An OBC pulsing this line high to low to high resets or power cycles any connected I2C2 and load management devices.
39 | I2C2_SDA | Digital | 0 & 3 Volts | OBCs |  | Various | I2C Bus #2 Data (Bidirectional): in-control OBC Master | I²C2 SDA | I2C Bus #2 Data (Bidirectional): in-control OBC Master
40 | TLM_Enable | Digital | 0 & 3 Volts | LIHU |  | Various | Enable Telemetry and/or Experiment Data transmission on the TLM Downlink channel. | Telemetry Enable | Enable Telemetry and/or Experiment Data transmission on the TLM Downlink channel.
41 | Bus_CANH | Digital | 2.5 or 4 V | OBCs and CAN Devices | 120 Ω resistor | OBCs and CAN Devices | System CAN Bus High Signals | +Z Thermistor | GOLF-Tee System CAN Bus High Signals; 120 ohm termination
42 | Modem_CXR_Valid | Digital | 0 & 3 Volts | ICR |  | LIHU | ICR CMD Channel Modem CXR vaild; High = valid command data detected on CMD channel (gated by RSSI level) | Modem Carrier Detect | ICR CMD Channel Modem CXR vaild; High = valid command data detected on CMD channel (gated by RSSI level)
43 | Bus_CANL | Digital | 2.5 or 4 V | OBCs and CAN Devices | 120 Ω resistor | OBCs and CAN Devices | System CAN Bus High Signals | -Z Thermistor | GOLF-Tee System CAN Bus High Signals; 120 ohm termination
44 | -Y Antenna Deploy | Analog | Vbatt | LIHU | 7 Ω resistor | PSU |  | / | Available; Bus_NC_44
45 | +Z CIC | Power | N/A | EXP 4 | N/A | PSU |  | / | Available; Bus_NC_45
46 | -Y Antenna Sensor | Switch | N/A | PSU | N.O. | LIHU | N.O. when deployed | / | Available; Bus_NC_46
47 | -Z CIC | Power | N/A | TX | N/A | PSU |  | / | Available; Bus_NC_47
48 | +Y Antenna Sensor | Switch | N/A | PSU | N.O. | LIHU | N.O. when deployed | / | OBC logic level manipulations to emulate the ETTUS E310 ONB line control actions. [RT-IHU access in v1.2]
49 | RT-IHU1_Console_TX | Digital | 0 & 3 Volts | RT-IHU1 |  |  | RT-IHU1 (Primary) Console Serial Transmit Channel; ASYNC, Mark High | Umbilical USBP | RT-IHU1 (Primary) Console Serial Transmit Channel; ASYNC, Mark High
50 | +Y Antenna Deploy | Analog | Vbatt | LIHU | 7 Ω resistor | PSU |  | / | GBT_CHGR_Attached: HIGH = GOLF Btry Tender (GBT) Charge Cable Attached. [RT-IHU access in v1.2]
51 | RT-IHU1_Console_RX | Digital | 0 & 3 Volts |  |  | LIHU | RT-IHU1 (Primary) Console Serial Receive Channel; ASYNC, Mark High | Umbilical USBM | RT-IHU1 (Primary) Console Serial Receive Channel; ASYNC, Mark High
52 | TX_PWR_RFLT | Analog | 0 to 3 Volts | RX/TX |  | OBCs via I2C2 | RX/TX PA (REFLECTED) Transmit Power; carried by Fox Plus Bus (Line #52) to the ICR card's A to D Converter and then on to the OBCs via the I2C2 bus. | Tx Reflected Power | RX/TX PA (REFLECTED) Transmit Power; carried by GOLF Bus (Line #52) to the ICR card's A to D Converter and then on to the OBCs via the I2C2 bus.
53 | Umbilical_Attached | Digital | 0 & 3 Volts | USB |  | LIHU | High = Umbilical Cable Attached (with USB +5V source) | Umbilical Power Active: HIGH = Running on Umbilical Port Power
54 | Not Used |  |  |  |  |  |  | /
55 | Solar Power A | Power | Vbatt | PSU |  | BATT |  | /
56 | Solar Power B | Power | Vbatt | PSU |  | BATT |  | /
57 | Vbatt | Power Bus | 3.3 - 4.2 VDC | BATT/PSU |  | ALL |  | /
58 | Vbatt | Power Bus | 3.3 - 4.2 VDC | BATT/PSU |  | ALL |  | /
59 | Vbatt | Power Bus | 3.3 - 4.2 VDC | BATT/PSU |  | ALL |  | /
60 | Vbatt | Power Bus | 3.3 - 4.2 VDC | BATT/PSU |  | ALL |  | /
 | Note¹ All SPI and I2C signals are 3.0 V levels |  |  | All Digital signals are 3.0 V CMOS logic levels high impedance load unless otherwise noted

Sheet: External +X
Pin | Nomenclature | Type | Voltage | Source System | Load Z | Bus Pin
1 | N/C
2 | +X Solar Panel Thermistor | Analog | N/A | N/A | N/A | N/A
3 | N/C
4 | N/C
5 | N/C
6 | +X Solar Panel Common |  |  |  |  | Ground Plane
7 | N/C
8 | N/C
9 | N/C
10 | +X Solar Panel CIC (+) | Power | N/A | N/A | N/A | N/A

Sheet: External -X
Pin | Nomenclature | Type | Voltage | Source System | Load Z | Bus Pin
1 | N/C
2 | -X Solar Panel Thermistor | Analog | N/A | N/A | N/A | N/A
3 | N/C
4 | N/C
5 | N/C
6 | -X Solar Panel Common |  |  |  |  | Ground Plane
7 | N/C
8 | N/C
9 | N/C
10 | -X Solar Panel CIC (+) | Power | N/A | N/A | N/A | N/A

Sheet: External +Y
Pin | Nomenclature | Type | Voltage | Source System | Load Z | Bus Pin
1 | N/C
2 | +Y Solar Panel Thermistor | Analog | N/A | N/A | N/A | N/A
3 | N/C
4 | +Y Antenna Sensor | Switch | N/A | PSU | N.O. | 48
5 | N/C
6 | +Y Solar Panel Common |  |  |  |  | Ground Plane
7 | N/C
8 | +Y Antenna Deploy | Analog | Vbatt | LIHU | 7 Ω resistor | 50
9 | N/C
10 | +Y Solar Panel CIC (+) | Power | N/A | N/A | N/A | N/A

Sheet: External -Y
Pin | Nomenclature | Type | Voltage | Source System | Load Z | Bus Pin
1 | N/C
2 | -Y Solar Panel Thermistor | Analog | N/A | N/A | N/A | N/A
3 | N/C
4 | -Y Antenna Sensor | Switch | N/A | PSU | N.O. | 46
5 | N/C
6 | -Y Solar Panel Common |  |  |  |  | Ground Plane
7 | N/C
8 | -Y Antenna Deploy | Analog | Vbatt | LIHU | 7 Ω resistor | 44
9 | N/C
10 | -Y Solar Panel CIC (+) | Power | N/A | N/A | N/A | N/A

Sheet: External +Z
Pin | Nomenclature | Type | Voltage | Source System | Load Z | Load System | Bus Pin
1 | Bus_CANH | Digital | 2.5 or 4 V | N/A | 120 Ω resistor | OBCs and CAN Devices | 41
2 | N/C
3 | +Z Solar Panel Common |  |  |  |  |  | Ground Plane
4 | N/C
5 | +Z CIC | Power | N/A | N/A | N/A | PSU | 45

Sheet: External -Z
Pin | Nomenclature | Type | Voltage | Source System | Load Z | Load System | Bus Pin
1 | Bus_CANL | Digital | 2.5 or 4 V | N/A | 120 Ω resistor | OBCs and CAN Devices | 43
2 | N/C
3 | -Z Solar Panel Common |  |  |  |  |  | Ground Plane
4 | N/C
5 | -Z CIC | Power | N/A | N/A | N/A | PSU | 47

Sheet: External TX
External Connection | Nomenclature | Type | Voltage/Power | Source System | Load Z | Bus Pin
Coaxial Cable | 2 meter Antenna ≈ 145.9 MHz | RF | 0 to +30 dBm | 2 meter Antenna | 50 Ω unbal. | N/A

Sheet: External RX
External Connection | Nomenclature | Type | Voltage/Power | Source System | Load Z | Bus Pin
Coaxial Cable | 70 cm RF Input 437 MHz | RF | -60 dBm to -140 dBm | 70 cm Antenna | 50 Ω unbal. | N/A

Sheet: External BATT1
External Connection | Nomenclature | Type | Voltage/Power | Source System | Load Z | Bus Pin
USB 1 | USB +5 VDC | Analog | 5 VDC | USB CONNECTOR | N/A | N/A
USB 2 | USB Data - (USBM) | Digital | 3.0 V CMOS logic | USB CONNECTOR | N/A | 51
USB 3 | USB Data + (USBP) | Digital | 3.0 V CMOS logic | USB CONNECTOR | N/A | 49
USB 4 | Ground |  |  | USB CONNECTOR | N/A | Ground Plane
RBF 1 | Solar Safe N | Analog | N/A | 3.5mm N.O. TS jack | N/A | 40

Sheet: RF ICD
Pin | Nomenclature | Type | Voltage | Source System | Load Z | Load System | Notes
2 | TX_PA_CURRENT | Analog | 0 - 3.0 V | TX | 30 - 60 kΩ | IHU | 0
4 | TX_TEMP | Analog | 0 - 3.0 V | TX | 30 - 60 kΩ | IHU | Thermistor Circuit
8 | VGA Control | Analog | 0 - 3.3 V | RX/TX | 0 | LIHU | RX/TX internally generated Voltage control from the LT Power Amp’s VGA
Pin | Nomenclature | Type | Voltage | Source System | Load Z | Load System | Notes
12 | TLM_Data | Digital | 0-3.3 | LIHU | RX/TX | RX/TX | Telemetry data to be transmitted by the RX/TX card on the TLM downlink channel.
26 | RX/TX_CNTL | Digital |  | OBCs | 0 | RX/TX | HIGH = LIHU Controls RF LOW = Standalone Analog Transponder
28 | SPI1_SS | Digital |  | LIHU | 0 | RxTx | Slave select for SPI to modulator
Pin | Nomenclature | Type | Voltage | Source System | Load Z | Load System | Notes
22 | CMD_H/W_Bit_3 | Digital |  | 0 | 0 | OBCs and all Transmitters | Hardware Command Bit #3 (MSB): HIGH = Inhibit ALL transmitters
Pin | Nomenclature | Type | Voltage | Source System | Load Z | Load System | Notes
10 | RSSI | Analog | 0 - 3.0 V | ICR | 30 - 60 kΩ | LIHU | Received Signal Strength Indication
30 | PB_Enable | Digital |  | OBCs |  | RX/TX | Linear Transponder (LT) User Passband PB) Transmissions Enable Signal
32 | TX_FWD_PWR | Analog | 0 | RX/TX | 0 | OBCs | LT Power Amplifier (FORWARD) Transmit Power
34 | CMD_Serial_ Data | Digital | 0 & 3 Volts | ICR | 0 | LIHU | Uplinked Software Commands Serial Data Stream
