AMSAT-NA/fox-plus/systems_engineering/bus_diagrams/LIHU FM v2.1 PC-104 Pin Assignments.ods

LIHU FM v2.1 PC-104 Pin Assignments
Connector / Pin# | Designator | Usage | Input / Output | Description
H1 / 20 | tlm4 | Telemetry line 4 | I | These 4 lines may be used to place analog voltages 0 – 3.3v to the A/D converter to be converted to digital signals and sent to ground stations as telemetry data
H1 / 21 | tlm3 | Telemetry line 3 | I
H1 / 22 | tlm2 | Telemetry line 2 | I
H1 / 23 | tlm1 | Telemetry line 1 | I
H1 / 27 | L1 | ? | ? | Unidentified at this time
H1 / 29 | I2c1_reset | I2C Reset | I | This line is normally High. When lowered and raised, all I2C devices reset
H1 / 39 | Tx3 | STx | O | UART line Transmit for possible use as umbilical
H1 / 40 | Rx3 | SRx | O | UART line Receive, mate with Stx
H1 / 41 | I2c1_sda | I2C Serial Data | I/O | Inter-Integrated Circuit (I2C) bus. Slower and less capable than CAN bus but may be used for direct connection to several I2C chips.
H1 / 43 | I2c1_sck | I2C Serial Clock | I
H1 / 51 | dminus | USB Negative | O | USB bus signals interface provided for optional Umbilical
H1 / 52 | dplus | USB Positive | O
H2 / 13 | umbilical attached | Umbilical Attached Input | I | High indicates umbilical attached to spacecraft or USB with power is in USB mini-B connector on LTM board
H2 / 14 | gpl04 | Digital Input | I | May be used for sensors to indicate deployables have been released LOW=stowed, HIGH = released
H2 / 15 | gpl03 |  | I
H2 / 16 | gpl02 | Digital Output | O | May be used to release antennas or other deployables
H2 / 17 | gpl01 |  | O
H2 / 27 | Vsys | LTM Power | I | Power for the LTM to be supplied by host platform. Vsys Range = 5.2 – 6 vdc
H2 / 28 | Vsys | LTM Power | I
H2 / 29 | GND | LTM Ground | I
H2 / 30 | GND | LTM Ground | I
H2 / 31
H2 / 32 | GND | LTM Ground | I
H2 / 51 | bus_canh | CAN Bus High | I/O | main data interface between LTM and host platform. 3.3v or 5v
H2 / 52 | bus_canl | CAN Bus Low | I/O
