AMSAT-NA/fox-plus/structure/3d_models/CommercialFrame/Design Data/GOST/en-US/PartsListTemplate.xls

Sheet: Лист 1
 | Формат | Зона |  | Поз. |  | Обозначение |  |  |  | Наименование |  |  |  | Кол. | Приме-чание
Подп. и дата
Инв. № дубл.
Взам. инв. №
Подп. и дата
 | Изм. |  | Лист |  | № докум |  | Подпись | Дата
Инв. № подл | Разраб. |  |  |  |  |  |  |  |  |  | Литера |  | Лист |  |  | Листов
 | Пров.
 | Н.контр
 | Утв.
 |  |  |  |  |  |  |  |  | Копировал |  |  | Формат А4

Sheet: Лист 2
 | Формат | Зона |  | Поз. |  | Обозначение |  |  |  | Наименование |  | Кол. | Приме-чание
Подп. и дата
Инв. № дубл.
Взам. инв. №
Подп. и дата
Инв. № подл
 | Изм. |  | Лист |  | № докум. |  | Подп. |  | Дата
 |  |  |  |  |  |  |  | Копировал |  |  | Формат А4
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
