AMSAT-NA/fox-plus/mechanical/Fabrication/FoxPlusFabricationTracker.xlsx

# | Part Number | Description | Vendor | Website | Order Number | Placed Order | QTY | Total Cost | Estimated Ship | Notes / Status
1 | FOX-ME-203 | Mechanical Adapter | eMachineShop | https://www.emachineshop.com/ | 380594 | 2025-08-27 | 3 | $579.11 | 2025-10-01
2 | N/A | Solar Array Panel, Side | Parts Badger | https://parts-badger.com/ | KG20807NZ | 2025-08-26 | 5 | $272.08 | 2025-09-08 | Received 11Sept2025
3 | N/A | Solar Array Panel, Top | Parts Badger | https://parts-badger.com/ | KG20845N | 2025-08-26 | 2 | $217.14 | 2025-09-25
4
5
6
7
8
9
10
