AMSAT-NA/fox-plus/systems_engineering/Compliance + Testing/Compliance Docs List.ods

Fox-Plus Compliance and Testing Requirements and Documents
Last update: | 04/17/23
This spreadsheet is intended to organize compliance and testing documents for Fox-Plus with descriptions
Checklist
Task Areas | Comments
 | Compliance Task Areas / Examples “Launch Compliance Task Areas”
Outgassing
Venting Analysis
Frequency Coordination
Mass Properties
Electrical Report
Orbital Debris Assessment Report
Materials List
Mission Readiness Review
Environmental Test Plan
CubeSat Acceptance Checklist (CAC) | dimensional verification
Missle Sys Prelaunch Safety Package | often required on USSF launches
Certification of Flight Worthiness
NOAA Imaging Approval Licensing
Battery Report
Vibration & Shock Test Report
Transmitter Survey
Day-in-the-Life (DITL) Test / Report
Thermal Vacuum – Bakeout Test / Report
Compliance Letter
Payload Readiness Review | often required on USSF launches
Compliance
Compliance Task Area | Document | Source Location(s) | Comments
 | NASA Standards and Test Documents | Note: these docs are only a sampling of what’s available on svn
CubeSat Acceptance Checklist (CAC) | cubesatdesignspecificationrev14_12022-02-09.pdf (https://github.com/AMSAT-NA/fox-plus/blob/main/systems_engineering/Compliance%20%2B%20Testing/cubesatdesignspecificationrev14_12022-02-09.pdf) | Svn > Golf-Tee\ Mechanical \ reference \ NASA
CubeSat Acceptance Checklist (CAC) | 1U++ CubeSat Checklist | Svn > Golf-Tee\ Mechanical \ reference \ NASA
Environmental Test Plan | NASA HDBK 7008 | Svn > Golf-Tee\ Mechanical \ reference \ NASA | Spacecraft Dynamic Environments Testing
Outgassing | NASA STD 6001B | Svn > Golf-Tee\ Mechanical \ reference \ NASA | Flamability, Offgassing Compatability & Test
Environmental Test Plan | NASA ENV GSFC-STD-7000B (2021).pdf (https://github.com/AMSAT-NA/fox-plus/blob/main/systems_engineering/Compliance%20%2B%20Testing/NASA%20ENV%20GSFC-STD-7000B%20(2021).pdf) | Svn > Golf-Tee\ Mechanical \ reference \ NASA | General Environmental Verification Standard (GEVS) for GSFC Flight Programs and Projects
Vibration & Shock Test Report | NASA STD 7001B | Svn > Golf-Tee\ Mechanical \ reference \ NASA | Payload VibroAcoustic Test Criteria
Orbital Debris Assessment Report | NASA NPR 8715 | Svn > Golf-Tee\ Mechanical \ reference \ NASA | Procedural Requirements for limiting Orbital Space Debris
Frequency Coordination | NASA Spectrum Guidance for Small Sat Missions | Svn > Golf-Tee\ Mechanical \ reference \ NASA
Frequency Coordination | FCC License DA-13-445A1.pdf (https://github.com/AMSAT-NA/fox-plus/blob/main/systems_engineering/Compliance%20%2B%20Testing/FCC%20License%20DA-13-445A1.pdf) | Svn > Golf-Tee\ Mechanical \ reference \ NASA
Payload Readiness Review | NASA Launch Services Program.pdf (https://github.com/AMSAT-NA/fox-plus/blob/main/systems_engineering/Compliance%20%2B%20Testing/NASA%20Launch%20Services%20Program.pdf) | Svn > Golf-Tee\ Mechanical \ reference \ NASA
Mass Properties | NASA VCLS ELaNa XX Mass Properties.xlsx | Svn > Golf-Tee\ Mechanical \ reference \ NASA
Payload Readiness Review | 2014-01-30_LSP-REQ-317_REV_B_Final.pdf | Svn > Golf-Tee\ launch | Launch Services Program Dispenser & CubeSat Requirements Doc
 | Fox 1E Procedures and Actuals
Thermal Vacuum – Bakeout Test / Report | RadFxSat-2 Bakeout manual log.xlsx | svn > Fox-1E\ Test \ Launch
Thermal Vacuum – Bakeout Test / Report | RadFxSat-2 Bakeout Test Procedure.docx | svn > Fox-1E\ Test \ Launch
Mission Readiness Review | RadFxSat-2 Launch Acceptance and Approval.docx | svn > Fox-1E\ Test \ Launch
Mass Properties | RadFxSat-2 mass measurements.xlsx | svn > Fox-1E\ Test \ Launch
Mass Properties | RadFxSat-2 Mass Properties Report.docx | svn > Fox-1E\ Test \ Launch
Vibration & Shock Test Report | RadFxSat-2 Random Vibration Test Procedure.docx | svn > Fox-1E\ Test \ Launch
Vibration & Shock Test Report | RadFxSat-2 shock.xlsx | svn > Fox-1E\ Test \ Launch
Vibration & Shock Test Report | RadFxSat-2 Shock Analysis.docx | svn > Fox-1E\ Test \ Launch
Venting Analysis | RadFxSat-2 Venting.xls | svn > Fox-1E\ Test \ Launch
Venting Analysis | RadFxSat-2 Venting Analysis Report.docx | svn > Fox-1E\ Test \ Launch
Thermal Vacuum – Bakeout Test / Report | RadFXSat-2 Bakeout Test Report.docx | svn > Fox-1E\ Test \ Launch
Mission Readiness Review | RadFXSat-2 Preflight Init Procedure pre-frame.docx | svn > Fox-1E\ Test \ Launch
Vibration & Shock Test Report | RadFXSat-2 SFT Subset for post-stack testing pre-frame.docx | svn > Fox-1E\ Test \ Launch
Vibration & Shock Test Report | RadFXSat-2 Vibration Test Report.docx | svn > Fox-1E\ Test \ Launch
 | ELaNa and Other
CubeSat Acceptance Checklist (CAC) | VCLS ELaNa XX CubeSat Description - RadFXSat-2.docx | svn > Fox-1E\ Test \ Launch
Materials List | Fox 1C Materials List | Svn > Golf-Tee\ Mechanical \ requirements
Payload Readiness Review | P-Pod_MKIIIRevE_UserGuide_CP_PPODUG-1.0-1_Rev1.pdf | Svn > Golf-Tee\ Mechanical \ requirements
Mass Properties | spec_dwgs_rev13cds.pdf | Svn > Golf-Tee\ Mechanical \ requirements
Radiation Testing | Fox_Radiation(Tony Monteiro).pdf
Radiation Testing | TID for CubeSat Components |  | Total Ionizing Dose (TID) for CS Components
