AMSAT-NA/fox-plus/structure/3d_models/1U/1U_CubeSat_Specficiation-A.SLDASM

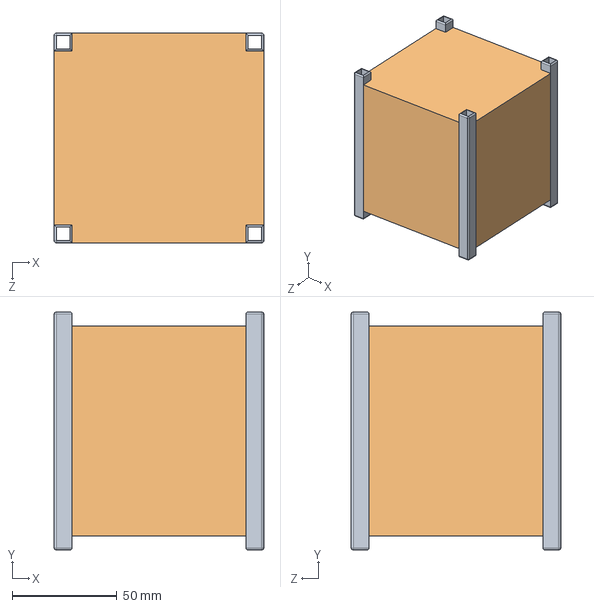
[picture p132: CAD file, 2022-09-29]
structure/3d_models/1U/1U_CubeSat_Specficiation-A.SLDASM
100.0 x 113.5 x 100.0 mm
1UEnvelopePt1_A x 4
1UEnvelopePt2_A
