AMSAT-NA/fox-plus/structure/3d_models/1U/Updated_PCB_Assembly.SLDASM

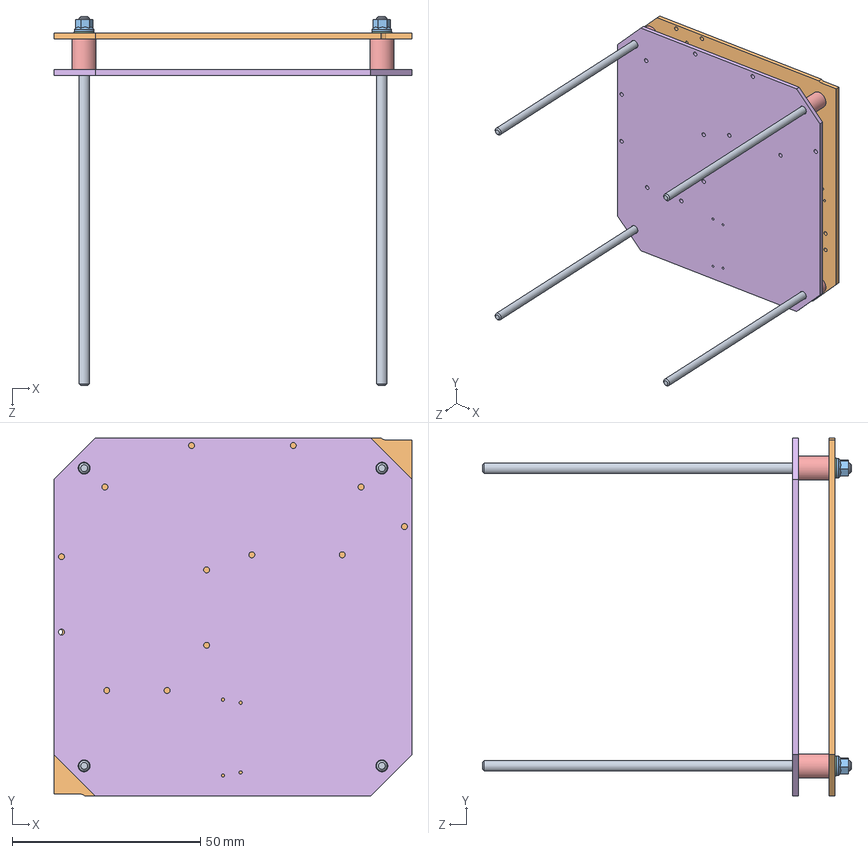
[picture p133: CAD file, 2022-09-02]
structure/3d_models/1U/Updated_PCB_Assembly.SLDASM
95.0 x 95.0 x 98.0 mm
threaded_rod x 4
PCB_TX
MS21043-04.ipt x 4
NAS620-4L.ipt x 4
standoff815mm.ipt x 4
PCB_RX.ipt
