AMSAT-NA/fox-plus/structure/3d_models/2U/2U_CubeSat_Specification.SLDASM

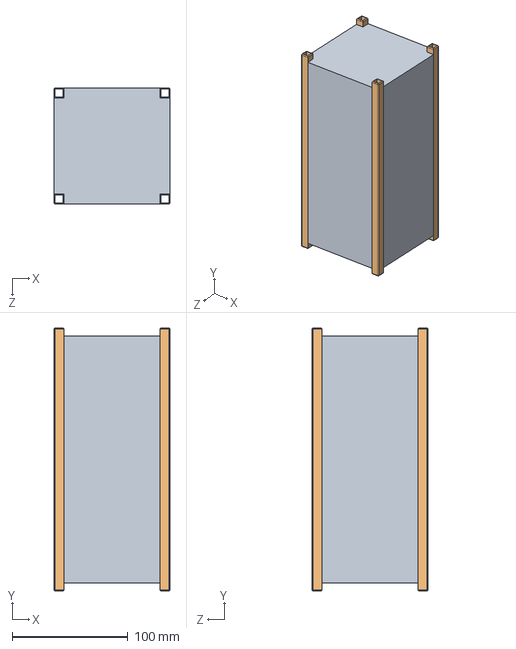
[picture p134: CAD file, 2022-09-02]
structure/3d_models/2U/2U_CubeSat_Specification.SLDASM
100.0 x 227.0 x 100.0 mm
2U_Volume
2U_RailSystem x 4
