AMSAT-NA/fox-plus/structure/3d_models/1.5U/1.5U_CubeSat_Specification.SLDASM

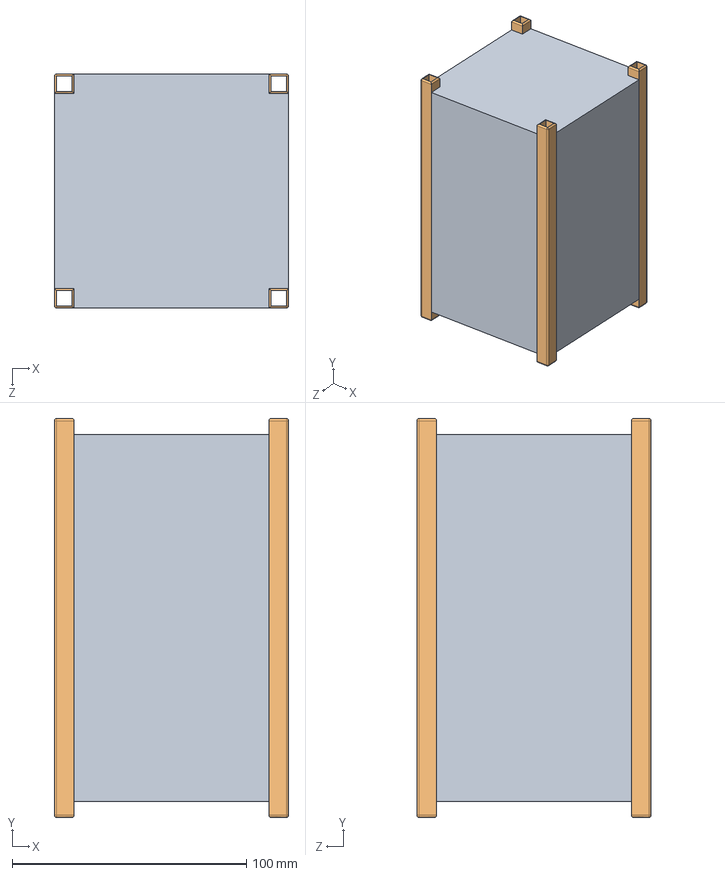
[picture p135: CAD file, 2022-09-02]
structure/3d_models/1.5U/1.5U_CubeSat_Specification.SLDASM
100.0 x 170.2 x 100.0 mm
1.5U_Volume
1.5U_RailSystem x 4
