AMSAT-NA/fox-plus/structure/3d_models/Hardware/shields_panelized.SLDASM

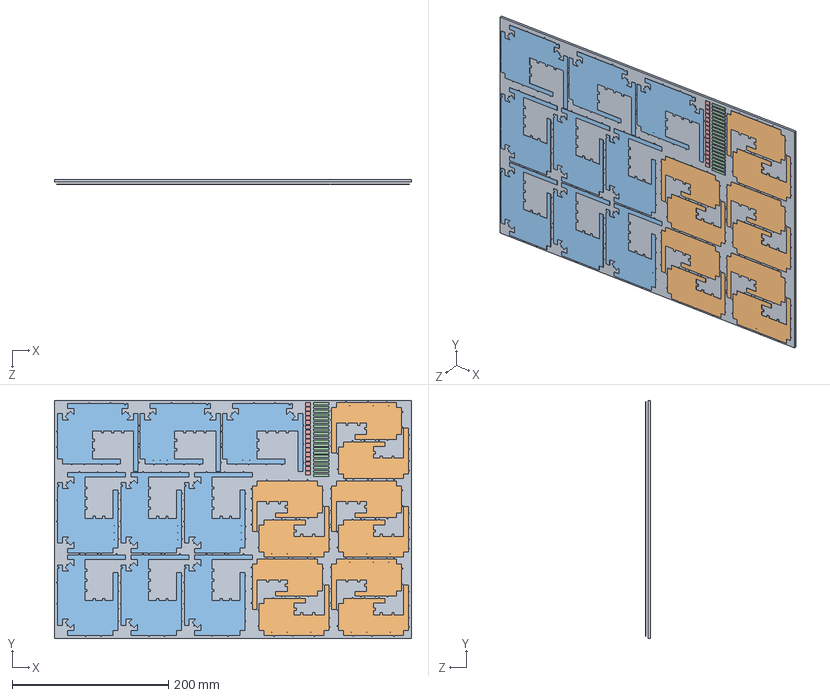
[picture p136: CAD file, 2022-09-02]
structure/3d_models/Hardware/shields_panelized.SLDASM
457.2 x 304.8 x 5.97 mm
Fotofab_panel_18x12in.ipt
tx_v2_04_cu_shield_no-folds.ipt x 10
rx_v1_23_cu_shield_no-folds.ipt x 9
Crystal_L_Strip_no-folds.ipt x 20
RX_Shim.ipt x 16
