AMSAT-NA/fox-plus/structure/3d_models/Hardware/SP_-X.SLDASM

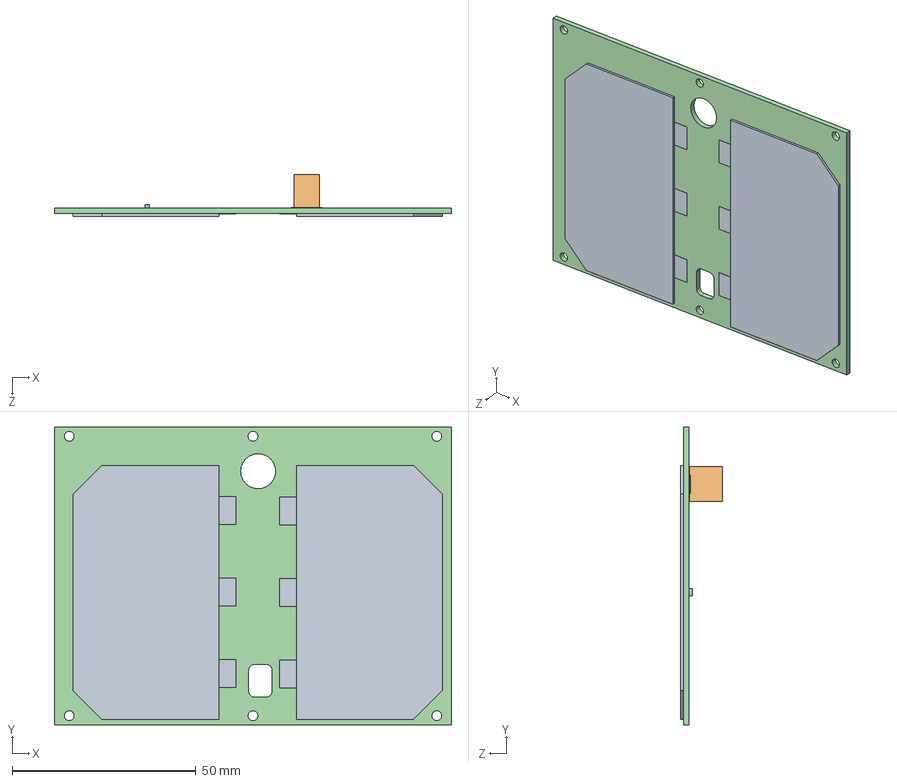
[picture p137: CAD file, 2022-09-02]
structure/3d_models/Hardware/SP_-X.SLDASM
108.0 x 81.0 x 11.4 mm
SpaceQuest_UTJ.ipt x 2
Samtec_MEC1-105-02-X-D-NP.ipt
Murata_NCP21XM472J03RA.ipt
SP_X.ipt
