AMSAT-NA/fox-plus/structure/3d_models/1U/FOX+1UAssembly.SLDASM

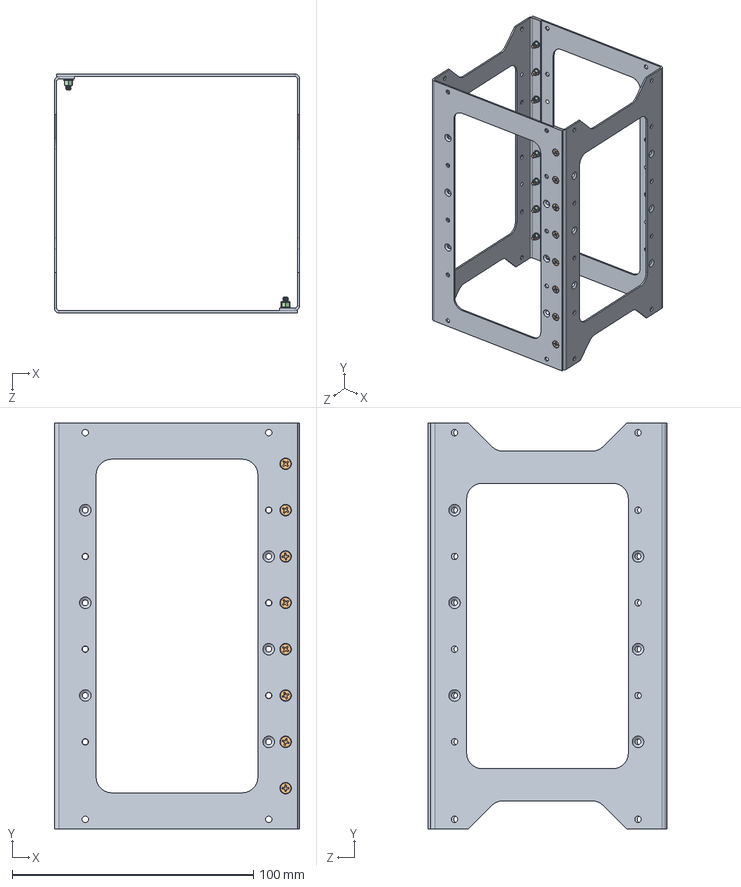
[picture p138: CAD file, 2022-09-02]
structure/3d_models/1U/FOX+1UAssembly.SLDASM
101.6 x 168.2 x 99.0 mm
1.5U - Fox+ x 2
93085A017_Mil. Spec. Stainless Steel Phillips Flat Head Screws x 16
90945A705_18-8 Stainless Steel Mil. Spec. Washer x 16
95307A800_Mil. Spec. Distorted-Thread Flange Locknut x 16
