AMSAT-NA/fox-plus/structure/3d_models/1.5U/92x92 RX PCB.SLDPRT

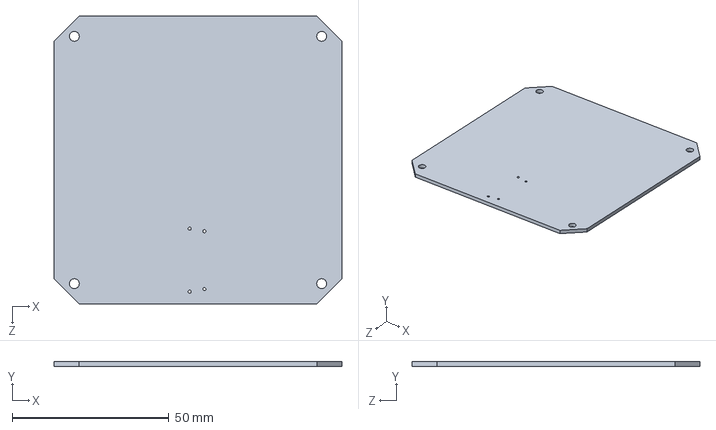
[picture p139: CAD file, 2022-09-02]
structure/3d_models/1.5U/92x92 RX PCB.SLDPRT
92.0 x 1.59 x 92.0 mm
