AMSAT-NA/fox-plus/structure/3d_models/2U/2U_Volume.SLDPRT

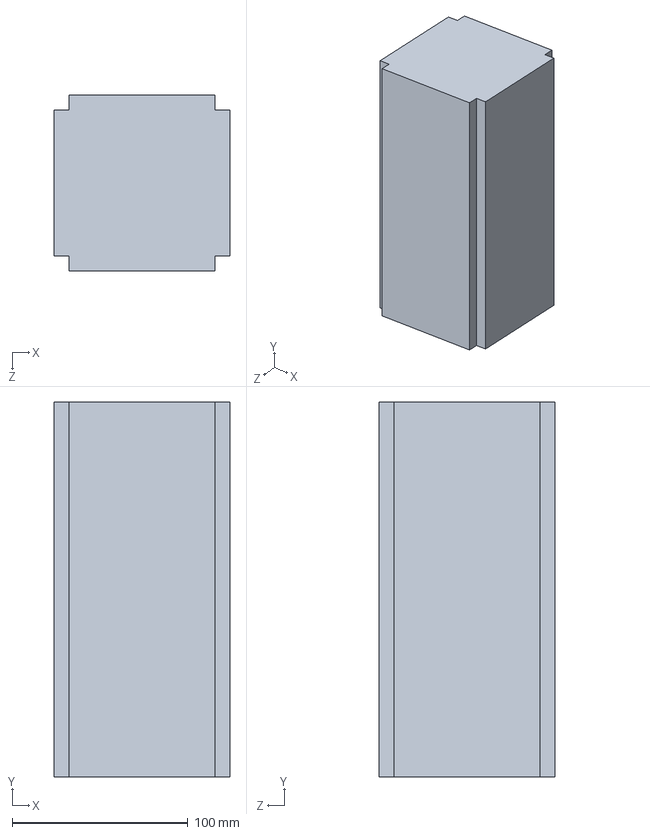
[picture p140: CAD file, 2022-09-02]
structure/3d_models/2U/2U_Volume.SLDPRT
100.0 x 213.5 x 100.0 mm
