AMSAT-NA/fox-plus/structure/3d_models/Hardware/delrin_pcb_mount4_magnet.SLDPRT

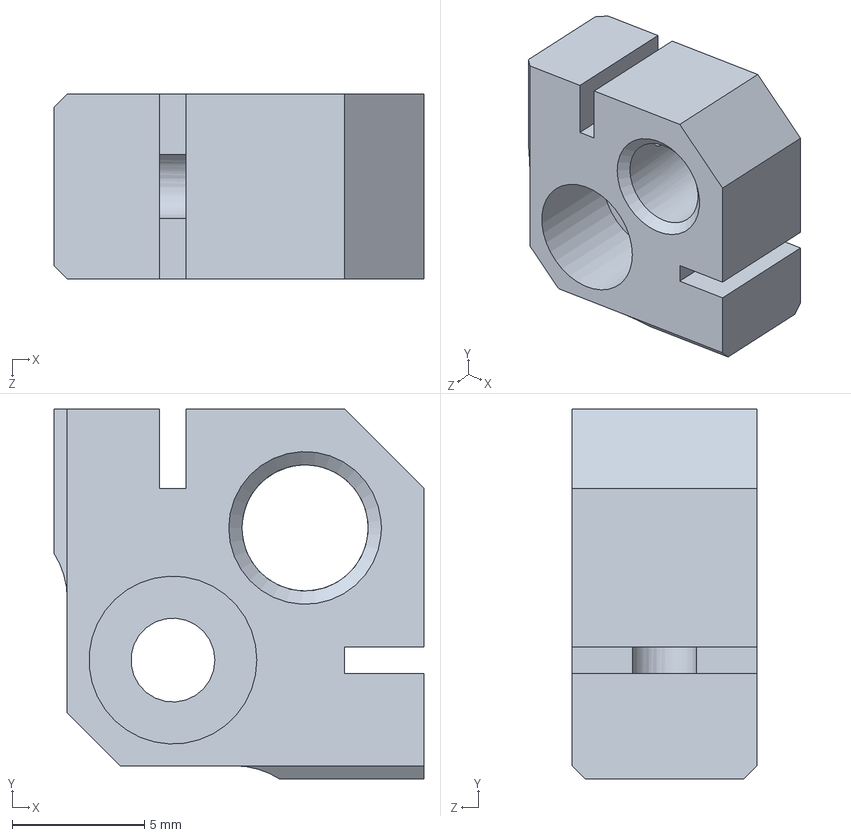
[picture p141: CAD file, 2022-09-02]
structure/3d_models/Hardware/delrin_pcb_mount4_magnet.SLDPRT
14.0 x 14.0 x 7.00 mm
