AMSAT-NA/fox-plus/structure/3d_models/PCB/92x75 RF Matrix (GOLF-ME-113).SLDPRT

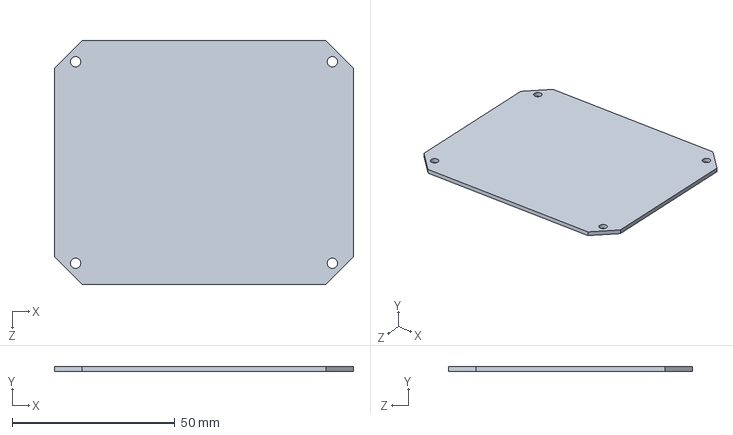
[picture p142: CAD file, 2022-09-02]
structure/3d_models/PCB/92x75 RF Matrix (GOLF-ME-113).SLDPRT
92.0 x 1.59 x 75.0 mm
