AMSAT-NA/fox-plus/structure/3d_models/2U/2U_RailSystem.SLDPRT

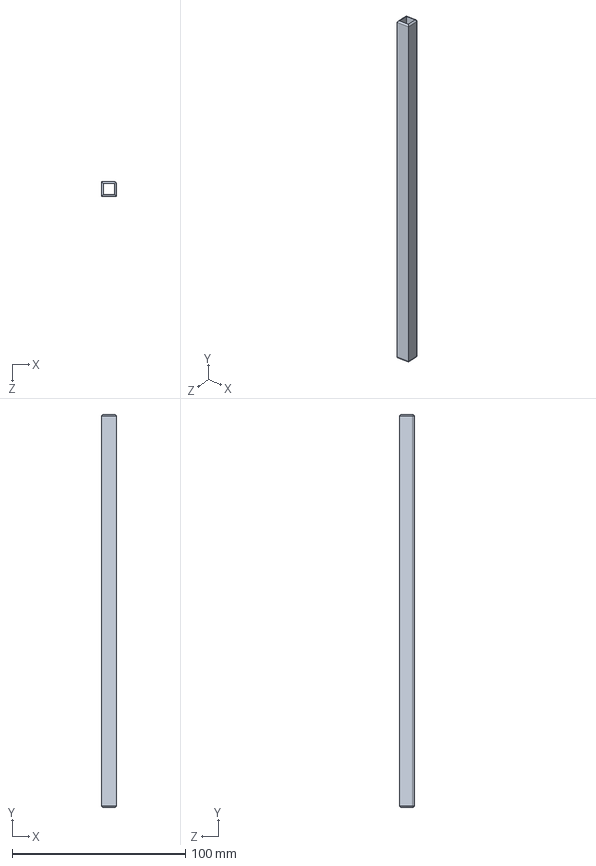
[picture p143: CAD file, 2022-09-02]
structure/3d_models/2U/2U_RailSystem.SLDPRT
8.50 x 227.0 x 8.50 mm
