AMSAT-NA/fox-plus/structure/3d_models/Hardware/battery_heater.SLDPRT

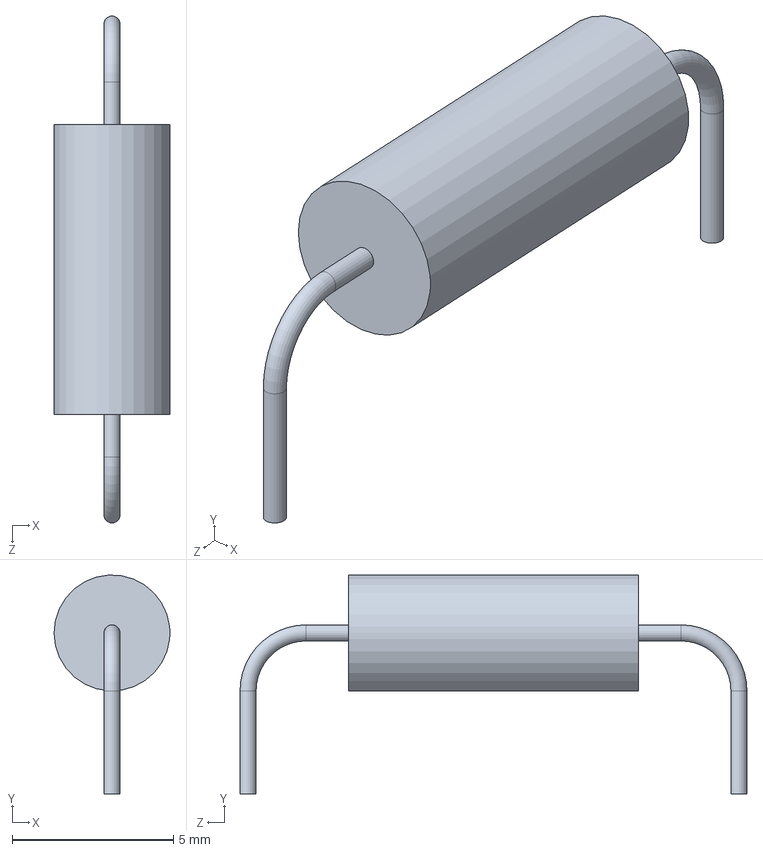
[picture p144: CAD file, 2022-09-02]
structure/3d_models/Hardware/battery_heater.SLDPRT
3.60 x 6.80 x 15.7 mm
