AMSAT-NA/fox-plus/structure/3d_models/PCB/95x95 TX PCB - No Connectors.SLDPRT

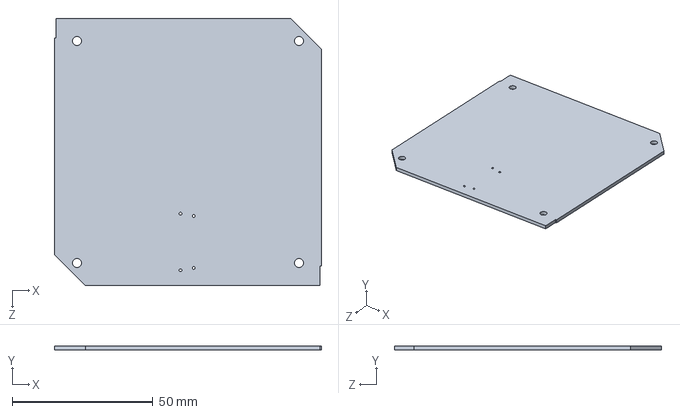
[picture p145: CAD file, 2022-09-02]
structure/3d_models/PCB/95x95 TX PCB - No Connectors.SLDPRT
95.0 x 1.59 x 95.0 mm
