AMSAT-NA/fox-plus/structure/3d_models/1.5U/1.5U_Volume.SLDPRT

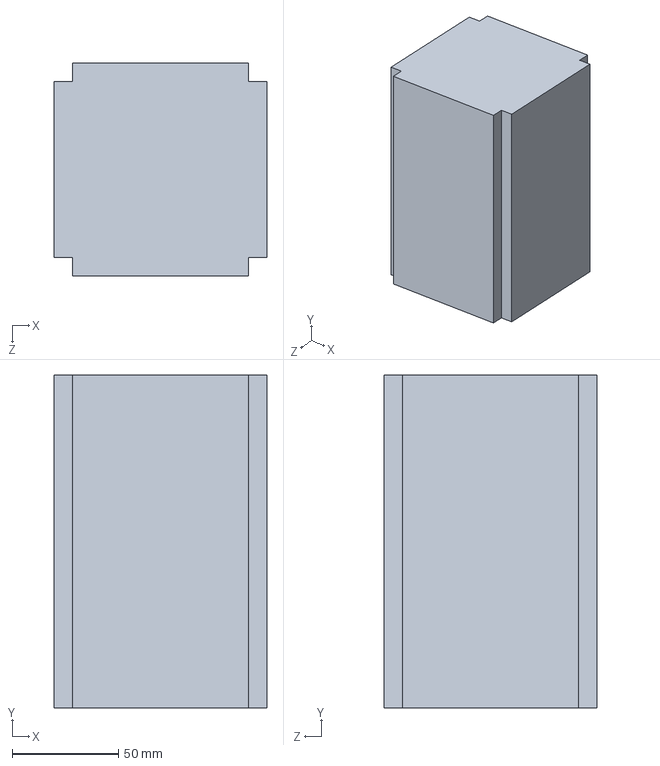
[picture p146: CAD file, 2022-09-02]
structure/3d_models/1.5U/1.5U_Volume.SLDPRT
100.0 x 156.7 x 100.0 mm
