AMSAT-NA/fox-plus/structure/3d_models/Hardware/signal_relay_panasonic_tx.SLDPRT

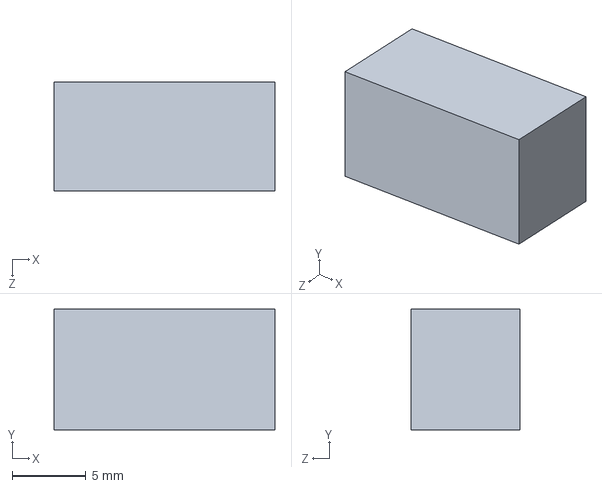
[picture p147: CAD file, 2022-09-02]
structure/3d_models/Hardware/signal_relay_panasonic_tx.SLDPRT
15.0 x 8.20 x 7.40 mm
