AMSAT-NA/fox-plus/structure/3d_models/1.5U/1.5U - Fox+.SLDPRT

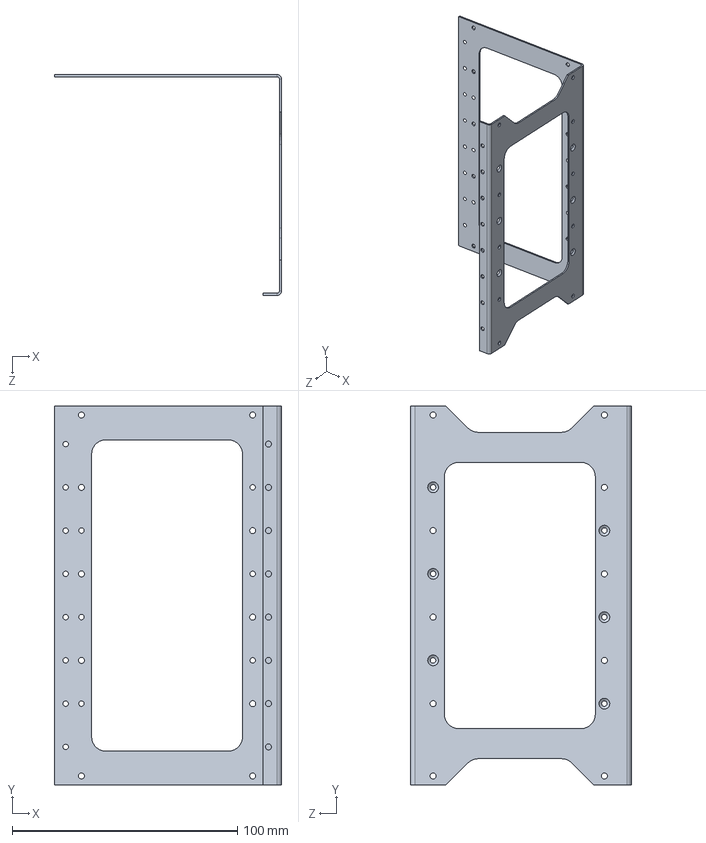
[picture p149: CAD file, 2022-09-02]
structure/3d_models/1.5U/1.5U - Fox+.SLDPRT
100.8 x 168.2 x 98.0 mm
