AMSAT-NA/fox-plus/structure/3d_models/1U/Crystal L Strip.dxf

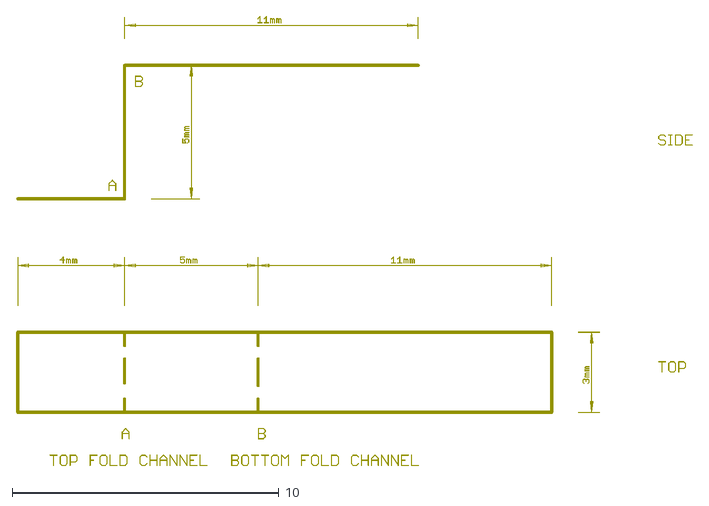
[picture p150: CAD file, 2022-09-02]
structure/3d_models/1U/Crystal L Strip.dxf
25.3 x 16.8
