AMSAT-NA/fox-plus/structure/3d_models/1.5U/1.5U_RailSystem.SLDPRT

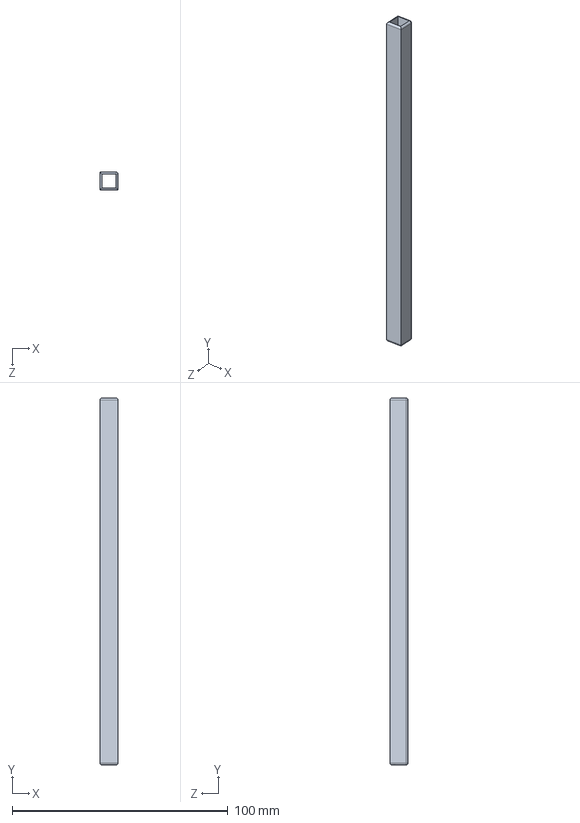
[picture p151: CAD file, 2022-09-02]
structure/3d_models/1.5U/1.5U_RailSystem.SLDPRT
8.50 x 170.2 x 8.50 mm
