AMSAT-NA/fox-plus/structure/3d_models/1U/1UEnvelopePt1_A.SLDPRT

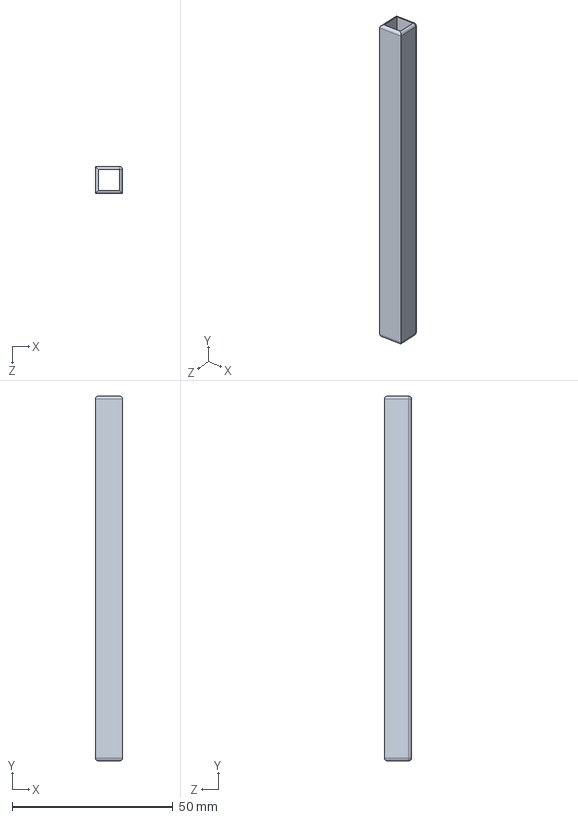
[picture p152: CAD file, 2022-09-02]
structure/3d_models/1U/1UEnvelopePt1_A.SLDPRT
8.50 x 113.5 x 8.50 mm
