AMSAT-NA/fox-plus/structure/3d_models/1U/kapton_wrap_battery.SLDPRT

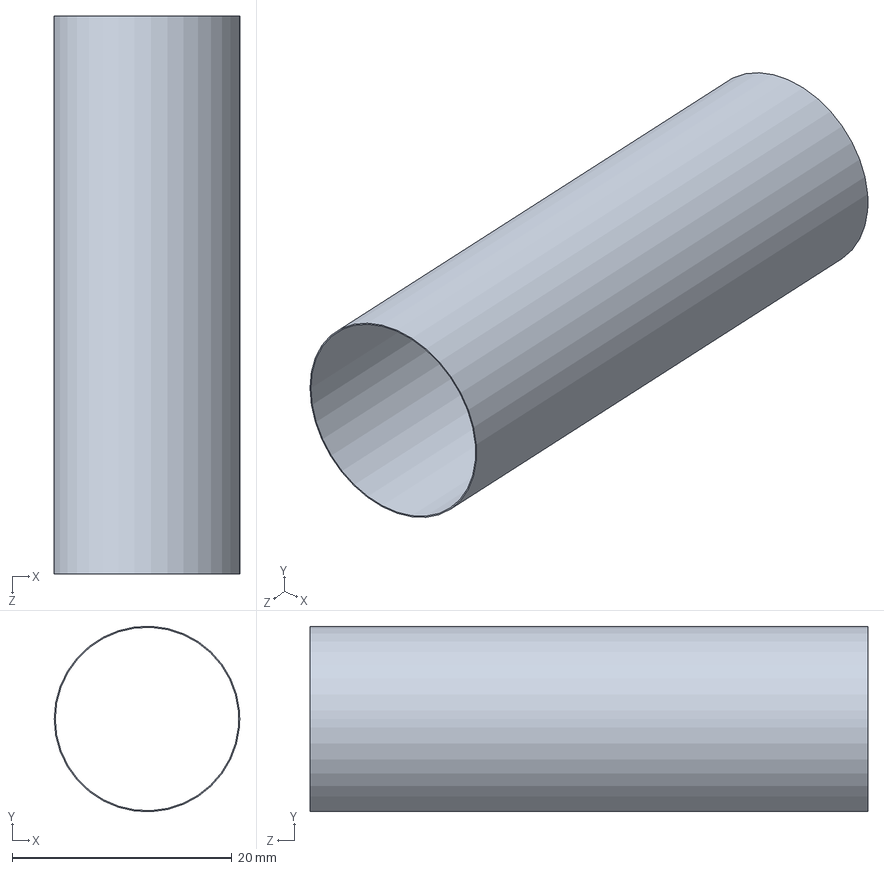
[picture p154: CAD file, 2022-09-02]
structure/3d_models/1U/kapton_wrap_battery.SLDPRT
16.9 x 16.9 x 50.8 mm
