AMSAT-NA/fox-plus/structure/3d_models/Hardware/shielded_power_inductor_CC1360.SLDPRT

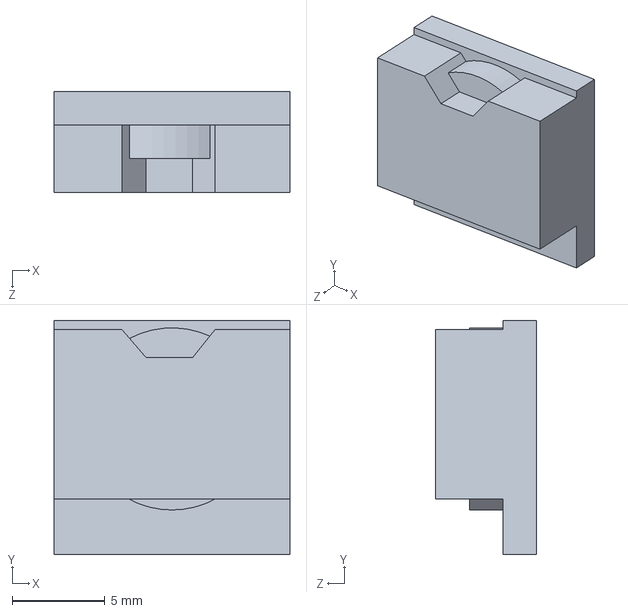
[picture p155: CAD file, 2022-09-02]
structure/3d_models/Hardware/shielded_power_inductor_CC1360.SLDPRT
12.7 x 12.6 x 5.45 mm
