AMSAT-NA/fox-plus/structure/3d_models/1U/FOX_ME_111_Walls.SLDPRT

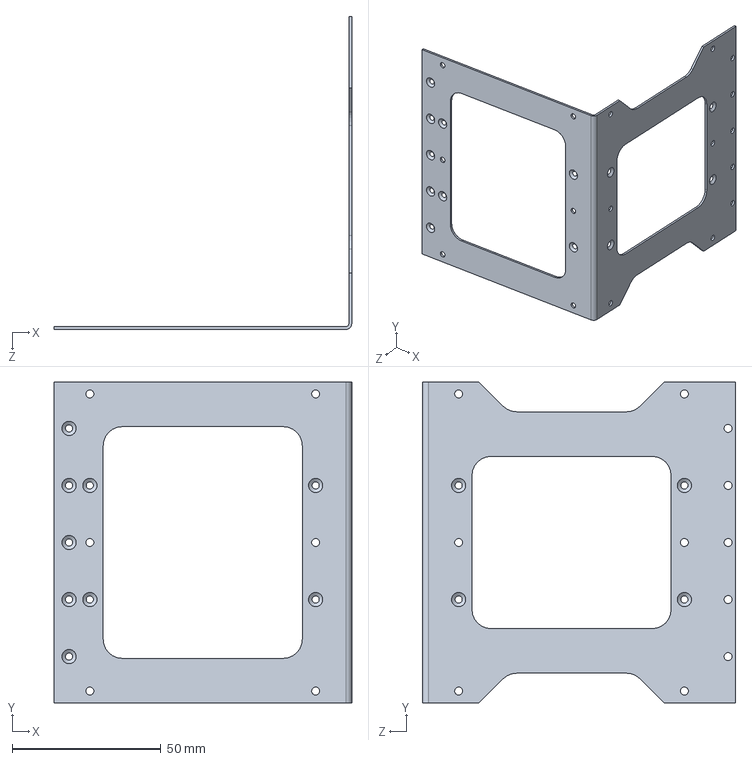
[picture p156: CAD file, 2022-09-02]
structure/3d_models/1U/FOX_ME_111_Walls.SLDPRT
100.2 x 108.0 x 105.4 mm
