AMSAT-NA/fox-plus/structure/3d_models/1U/threaded_rod.SLDPRT

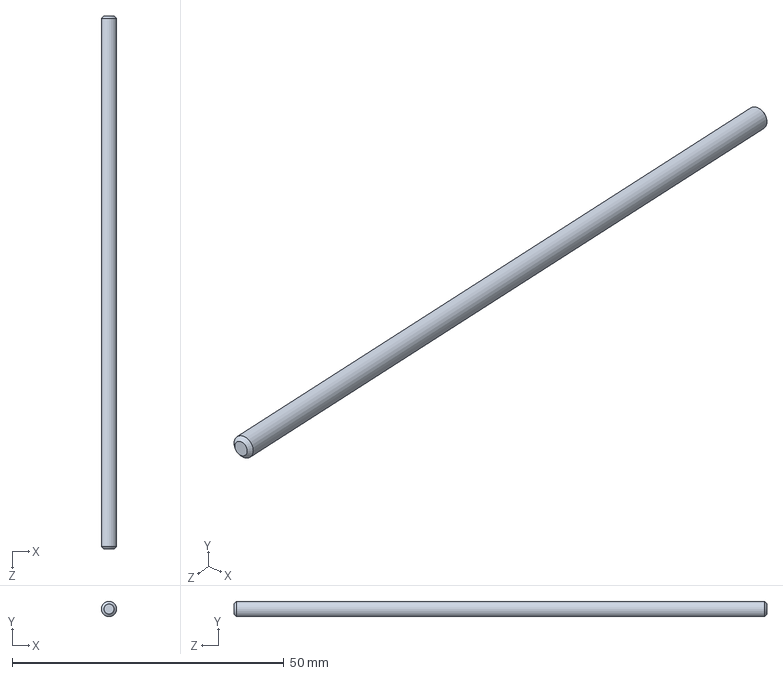
[picture p157: CAD file, 2022-09-02]
structure/3d_models/1U/threaded_rod.SLDPRT
2.84 x 2.84 x 98.0 mm
