AMSAT-NA/fox-plus/structure/3d_models/PCB/PCB_Batt2.SLDPRT

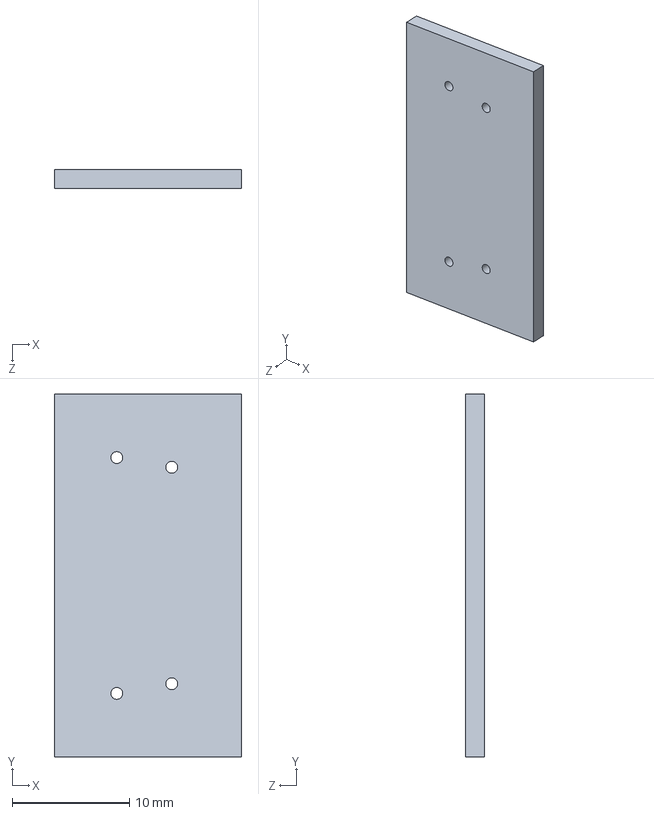
[picture p158: CAD file, 2022-09-02]
structure/3d_models/PCB/PCB_Batt2.SLDPRT
16.0 x 31.0 x 1.59 mm
