AMSAT-NA/fox-plus/structure/3d_models/1U/1UEnvelopePt2_A.SLDPRT

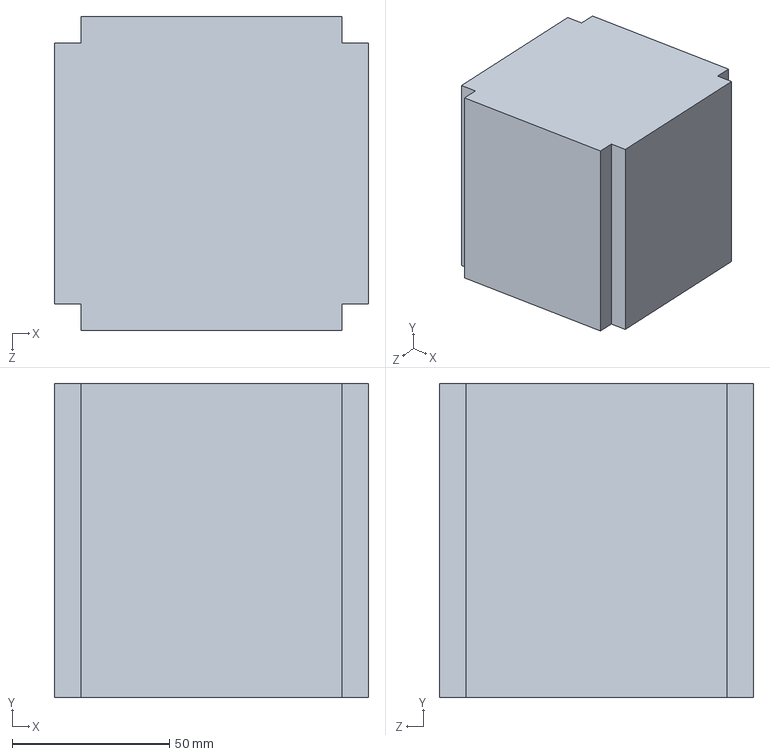
[picture p159: CAD file, 2022-09-02]
structure/3d_models/1U/1UEnvelopePt2_A.SLDPRT
100.0 x 100.0 x 100.0 mm
