AMSAT-NA/fox-plus/(list of files, cad)

Other CAD files:
structure/3d_models/1U/1U_CubeSat_Specification-broken.SLDASM
structure/3d_models/CommercialFrame/Templates/English/ANSI (in).dwg
structure/3d_models/CommercialFrame/Templates/Metric/ANSI (mm).dwg
structure/3d_models/CommercialFrame/Templates/Standard.dwg
structure/3d_models/1.5U/92x92 IHU PCB - No Connectors.SLDPRT
structure/3d_models/CommercialFrame/Templates/Metric/GOST.dwg
structure/3d_models/CommercialFrame/Templates/Metric/BSI.dwg
structure/3d_models/1U/PCB_TX.SLDPRT
structure/3d_models/CommercialFrame/Templates/Metric/JIS.dwg
structure/3d_models/CommercialFrame/Templates/Metric/ISO.dwg
structure/3d_models/PCB/92x92 PCB (GOLF-ME-113).SLDPRT
structure/3d_models/CommercialFrame/Templates/Metric/GB.dwg
structure/3d_models/CommercialFrame/Templates/Metric/DIN.dwg
structure/3d_models/PCB/95x95 Typical PCB.SLDPRT
structure/3d_models/PCB/PCB_TX.SLDPRT
structure/3d_models/PCB/PCB_Batt1.SLDPRT
structure/3d_models/1U/0805_generic.ipt
structure/3d_models/1U/1U_envelope.ipt
structure/3d_models/1U/84985A760_sep_spring.ipt
structure/3d_models/1U/84985A76_sep_spring.ipt
structure/3d_models/1U/90792A312_shimwasher.ipt
structure/3d_models/1U/90945A705_NAS620C2.ipt
structure/3d_models/1U/91240A003.ipt
structure/3d_models/1U/91772A065_1-72x3-16_pan.ipt
structure/3d_models/1U/91831A002.ipt
structure/3d_models/1U/91831A002_locknut_2-56.ipt
structure/3d_models/1U/91839A105.ipt
structure/3d_models/1U/92141A211_1-72_washer.ipt
structure/3d_models/1U/92196A066_shcs_1-72_1-4.ipt
structure/3d_models/1U/92200A077_2-56_1-4_shcs.ipt
structure/3d_models/1U/92200A079_2-56x3-8.ipt
structure/3d_models/1U/92217A350_washer_2.ipt
structure/3d_models/1U/92949A052_0-80_3-16_bhcs.ipt
structure/3d_models/1U/92949A054_0-80_1-4_bhcs.ipt
structure/3d_models/1U/92949A077_button_2-56_1-4.ipt
structure/3d_models/1U/93085A015_2-56x3-16Phillips100Flat.ipt
structure/3d_models/1U/93085A017_2-56_1-4_Phillips100Flat.ipt
structure/3d_models/1U/ANTENNA_STOP_WIRE.ipt
structure/3d_models/1U/C&K_HDT0004.ipt
structure/3d_models/1U/C&K_HDT0004_blade.ipt
structure/3d_models/1U/C&K_switch_KSU213WLFG.ipt
structure/3d_models/1U/CICgeneric.ipt
structure/3d_models/1U/CUI_audio_SJ1-42536-SMT.ipt
structure/3d_models/1U/Crystal_L_Strip.ipt
structure/3d_models/1U/Crystal_L_Strip_no-folds.ipt
structure/3d_models/1U/Emerson_UMC_128-0711-201.ipt
structure/3d_models/1U/FSI-105-06-L-S-AD.ipt
structure/3d_models/1U/Fotofab_panel_16x12in.ipt
structure/3d_models/1U/Fotofab_panel_18x12in.ipt
structure/3d_models/1U/LED_LTST-S270KFKT.ipt
structure/3d_models/1U/MMCX.ipt
structure/3d_models/1U/MS21042-02.ipt
structure/3d_models/1U/MiniUSB-B_Molex548190519.ipt
structure/3d_models/1U/Murata_NCP21XM472J03RA.ipt
structure/3d_models/1U/OMRON-D2JW_01K1A1.ipt
structure/3d_models/1U/PCB_Batt1.ipt
structure/3d_models/1U/PCB_Batt2.ipt
structure/3d_models/1U/PCB_Exp1.ipt
structure/3d_models/1U/PCB_Exp2.ipt
structure/3d_models/1U/PCB_Exp3.ipt
structure/3d_models/1U/PCB_Exp4.ipt
structure/3d_models/1U/PCB_GENERIC.ipt
structure/3d_models/1U/PCB_IHU.ipt
structure/3d_models/1U/PCB_PSU.ipt
structure/3d_models/1U/PCB_RX.ipt
structure/3d_models/1U/PCB_TX.ipt
structure/3d_models/1U/PSU_V107_holes.ipt
structure/3d_models/1U/Part2.ipt
structure/3d_models/1U/Pb_TX_bot.ipt
structure/3d_models/1U/RF shield simple corner.ipt
structure/3d_models/1U/RX_Shim.ipt
structure/3d_models/1U/RX_U7_MBC13917.ipt
structure/3d_models/1U/RX_tan_U10_SA607.ipt
structure/3d_models/1U/RX_tan_U7_MBC13917.ipt
structure/3d_models/1U/RX_tan_U9_SA601.ipt
structure/3d_models/1U/SP_-Z.ipt
structure/3d_models/1U/SP_X.ipt
structure/3d_models/1U/SP_Zplus.ipt
structure/3d_models/1U/SP_y.ipt
structure/3d_models/1U/SPgenericbody.ipt
structure/3d_models/1U/SPgenericbottom.ipt
structure/3d_models/1U/Samtec_FSI-105-06-D-L-AD.ipt
structure/3d_models/1U/Samtec_FSI-105-06-L-S-AD.ipt
structure/3d_models/1U/Samtec_MEC1-105-02-X-D-NP.ipt
structure/3d_models/1U/Samtec_QSH-030-01-L-D-A.ipt
structure/3d_models/1U/Samtec_QTH-030-02-L-D-A.ipt
structure/3d_models/1U/Samtec_TSM-104-04-L-SH-A.ipt
structure/3d_models/1U/SpaceQuest_UTJ.ipt
structure/3d_models/1U/SpaceQuest_UTJ_2.ipt
structure/3d_models/1U/SpaceQuest_interconnect.ipt
structure/3d_models/1U/SpaceQuest_interconnect_2.ipt
structure/3d_models/1U/SpaceQuest_interconnect_2_pad.ipt
structure/3d_models/1U/SpaceQuest_interconnect_3.ipt
structure/3d_models/1U/T1M-02-XX-S-RA.ipt
structure/3d_models/1U/Tant_Exp4_top.ipt
structure/3d_models/1U/Tant_TX_bot.ipt
structure/3d_models/1U/Tantalum_4x9.ipt
structure/3d_models/1U/Tantalum_4x9x1.ipt
structure/3d_models/1U/Tantalum_5x7x1.ipt
structure/3d_models/1U/Test sweep 2012.ipt
structure/3d_models/1U/Umbilicals_Tape.ipt
structure/3d_models/1U/Umbilicals_Tape_Safe.ipt
structure/3d_models/1U/Umbilicals_Tape_USB.ipt
structure/3d_models/1U/ant_length_stowed_full.ipt
structure/3d_models/1U/ant_length_stowed_short.ipt
structure/3d_models/1U/antenna9000.ipt
structure/3d_models/1U/antenna9000_2.ipt
structure/3d_models/1U/antenna9000_2deployed.ipt
structure/3d_models/1U/antenna9000_2free.ipt
structure/3d_models/1U/antenna9000_2stowed.ipt
structure/3d_models/1U/antenna_nitinol.ipt
structure/3d_models/1U/antenna_nitinol_longTX.ipt
structure/3d_models/1U/antenna_nitinol_shortRX.ipt
structure/3d_models/1U/antenna_nitinol_shortRXstow.ipt
structure/3d_models/1U/antenna_post_copper.ipt
structure/3d_models/1U/antenna_post_delrin.ipt
structure/3d_models/1U/antenna_rx_deploy.ipt
structure/3d_models/1U/antenna_shaft.ipt
structure/3d_models/1U/antenna_shaft_aluminum.ipt
structure/3d_models/1U/antenna_shaft_delrin.ipt
structure/3d_models/1U/antenna_stop.ipt
structure/3d_models/1U/antenna_stop_3.ipt
structure/3d_models/1U/antenna_stop_staple.ipt
structure/3d_models/1U/antenna_stop_staple2.ipt
structure/3d_models/1U/antenna_tx_deploy.ipt
structure/3d_models/1U/battery_A2.ipt
structure/3d_models/1U/battery_A_SanyoKR1700AU.ipt
structure/3d_models/1U/battery_cord_1x.ipt
structure/3d_models/1U/battery_cord_2x.ipt
structure/3d_models/1U/battery_heater.ipt
structure/3d_models/1U/battery_mount_1.ipt
structure/3d_models/1U/battery_tab_folded.ipt
structure/3d_models/1U/battery_tab_kapton.ipt
structure/3d_models/1U/battery_tab_straight.ipt
structure/3d_models/1U/burn_wire.ipt
structure/3d_models/1U/burn_wire_2.ipt
structure/3d_models/1U/camera_hole_filter.ipt
structure/3d_models/1U/camera_hole_tape.ipt
structure/3d_models/1U/camera_volume.ipt
structure/3d_models/1U/cameramount2.ipt
structure/3d_models/1U/cherry_switch.ipt
structure/3d_models/1U/cherry_switch_lever.ipt
structure/3d_models/1U/coax_tx.ipt
structure/3d_models/1U/emcore_21659-1.ipt
structure/3d_models/1U/epoxy_between-batteries.ipt
structure/3d_models/1U/epoxy_under-battery.ipt
structure/3d_models/1U/epoxy_under-battery_short.ipt
structure/3d_models/1U/hysteresis_cord.ipt
structure/3d_models/1U/hysteresis_rod.ipt
structure/3d_models/1U/kapton_battery_tab.ipt
structure/3d_models/1U/kapton_wrap_battery.ipt
structure/3d_models/1U/kaptonheater_OmegaKHLV102.ipt
structure/3d_models/1U/led_2wide.ipt
structure/3d_models/1U/lens.ipt
structure/3d_models/1U/magnet.ipt
structure/3d_models/1U/magnet_spacer.ipt
structure/3d_models/1U/mini-usb_molex_548190572.ipt
structure/3d_models/1U/mini_usb_molex_513870530.ipt
structure/3d_models/1U/nub.ipt
structure/3d_models/1U/nub_minusZ_3_no_switch.ipt
structure/3d_models/1U/nub_minusZ_3_plunger.ipt
structure/3d_models/1U/nub_minusZ_3_spring.ipt
structure/3d_models/1U/nub_minusZ_3_switch.ipt
structure/3d_models/1U/nub_minusZ_4_switch.ipt
structure/3d_models/1U/nub_minusZ_5_switch.ipt
structure/3d_models/1U/nub_minusZ_generic.ipt
structure/3d_models/1U/nub_minusZ_spring.ipt
structure/3d_models/1U/nub_minusZ_switch.ipt
structure/3d_models/1U/nub_plusZ_.ipt
structure/3d_models/1U/nub_plusZ_2.ipt
structure/3d_models/1U/nub_plusZ_3.ipt
structure/3d_models/1U/nub_plusZ_generic.ipt
structure/3d_models/1U/nub_plusZ_original.ipt
structure/3d_models/1U/pcb_thermostat.ipt
structure/3d_models/1U/piezo_sounder_PKLCS.ipt
structure/3d_models/1U/rx_coax.ipt
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
