AMSAT-NA/fox-plus/structure/Fox-Plus Model/2023-06-02/Assembling the 1U Frame.pptx

## Assembling the 1U Frame

Thomas Wu
05/26/2023

## Unscrew the side screws from each corner to remove the side frame

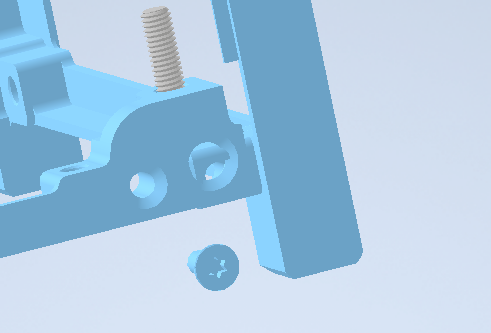
[picture p160: figure]

## Attach the 4 flat head screws to the bottom frame

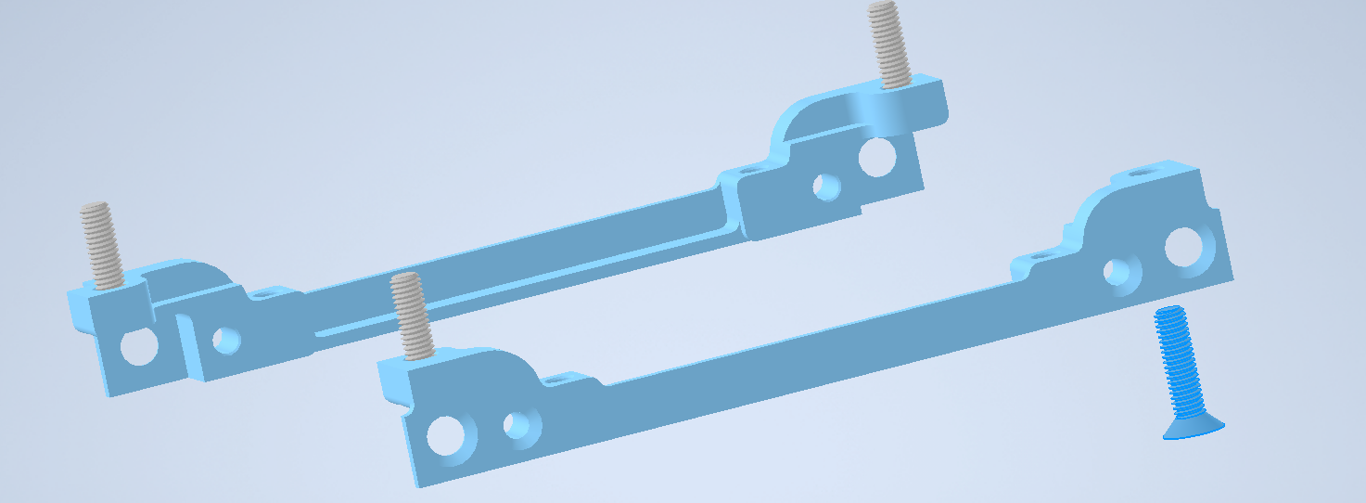
[picture p161: figure]

## Screw 4 standoffs to the flat head screws

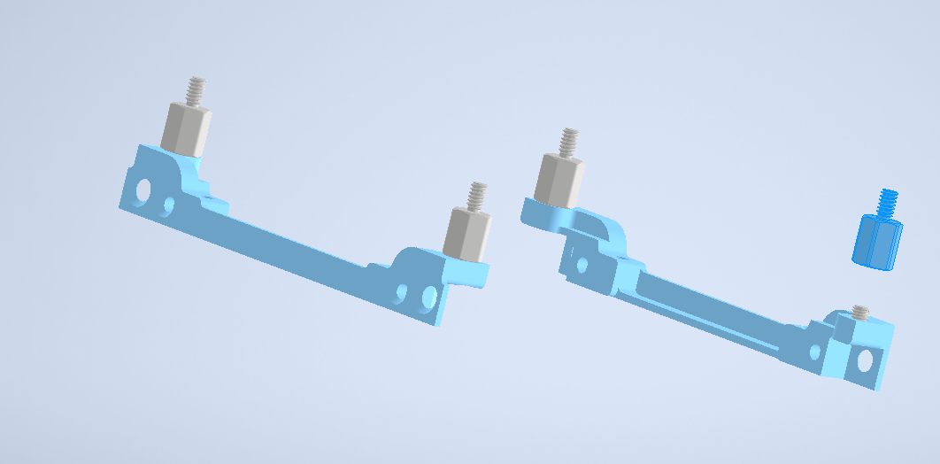
[picture p162: figure]

## Align the adapter standoffs and power board as shown in the picture (battery will go below the power board)

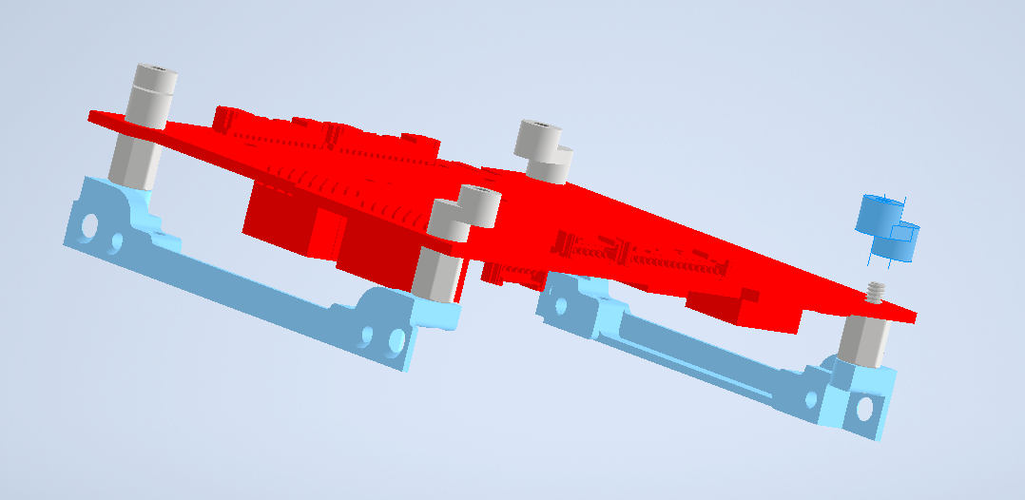
[picture p163: figure]

## Align LIHU and fasten with 4 standoffs

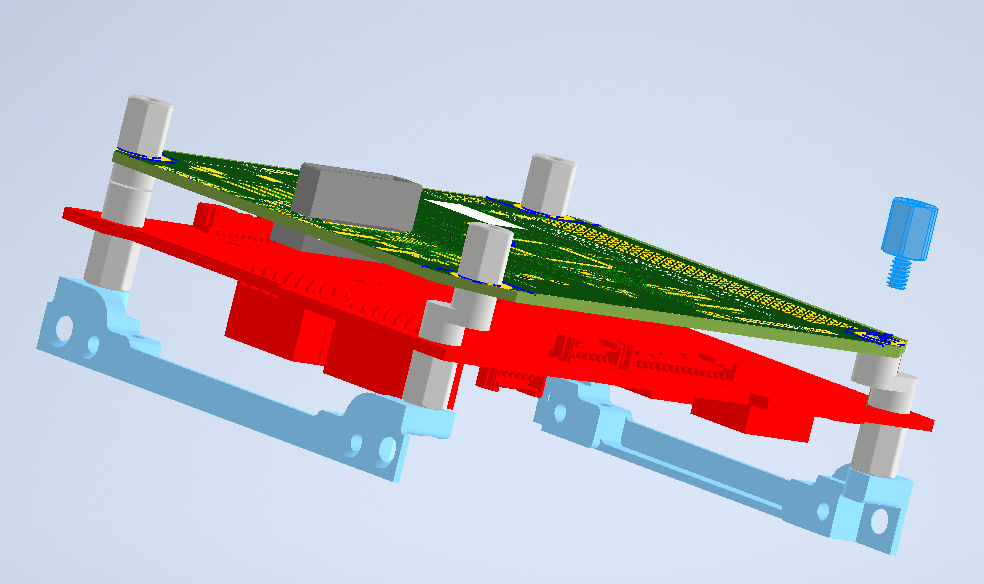
[picture p164: figure]

## Align LT RT-TX and again fasten with 4 standoffs

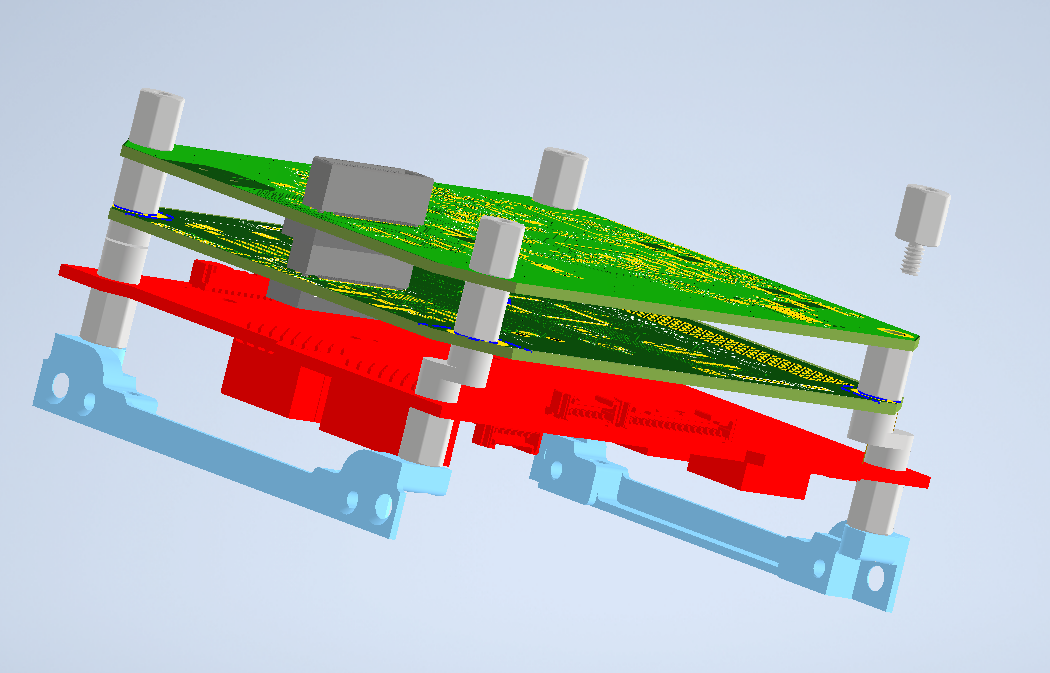
[picture p165: figure]

## Align LT ICR and fasten with 4 socket head screw

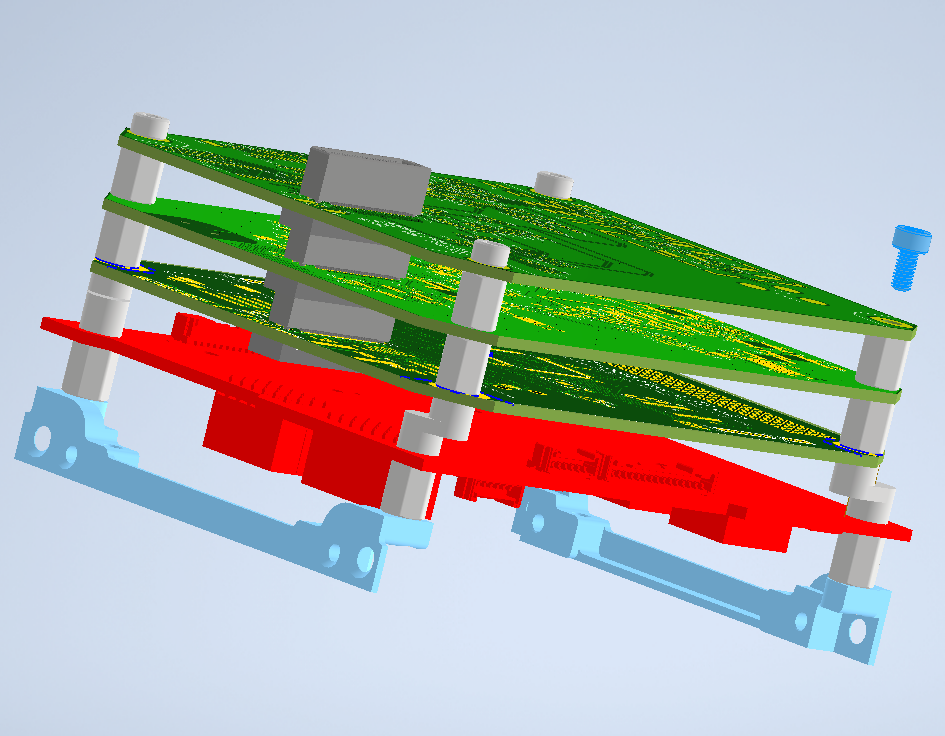
[picture p166: figure]

## Reattach the side frame and screw in the side screws

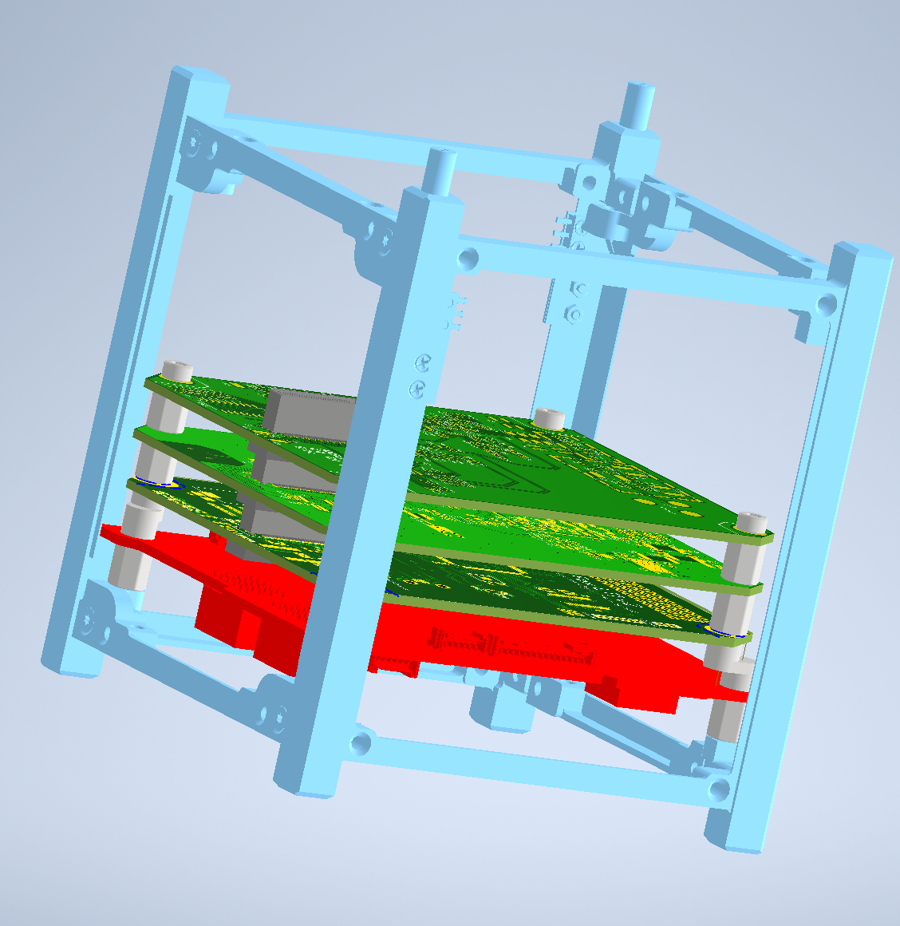
[picture p167: figure]

## Complete Model

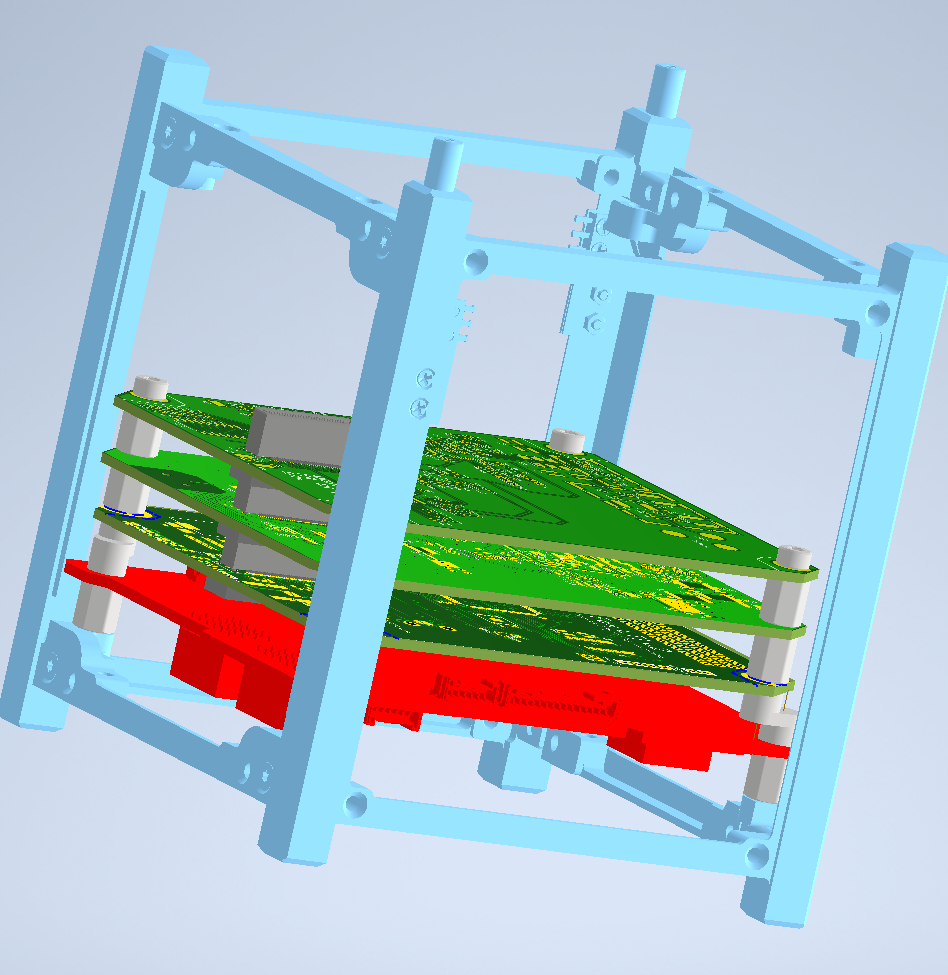
[picture p168: figure]
