AMSAT-NA/fox-plus/systems_engineering/Compliance + Testing/RadFxSat-2 Bakeout manual log.xlsx

Sheet: Summary
 | from | to | (h:mm)
Chamber was attended | 2018-06-20 10:04 | 2018-06-20 17:50 | 7:46:00
Pressure requirement met | 2018-06-20 10:30 | 2018-06-21 08:10 | 21:40:00
Temp #1 requirement met | 2018-06-20 11:42 | 2018-06-20 18:53 | 7:10:35
Temp #2 requirement met | 2018-06-20 11:37 | 2018-06-20 18:46 | 7:08:35
Attended, Press & Temp met | 2018-06-20 11:42 | 2018-06-20 17:50 | 6:07:32
Unattended, Press & Temp met | 2018-06-20 17:50 | 2018-06-20 18:46 | 0:56:13

Sheet: Manual Log
RadFxSat-2 Bakeout at NTS Boxborough. Six hour plateau achieved.
Time | T1, °C | T2, °C | Pressure, Torr
2018-06-20 10:30 |  |  | 9.5e-05
2018-06-20 10:50 |  |  | 5.6e-05
2018-06-20 11:30 | 56.3 | 58.4
2018-06-20 11:35 | 58.3 | 60.4
2018-06-20 11:40 | 60.0 | 62.5
2018-06-20 11:50 | 62.0 | 63.0 | 1.9e-05
2018-06-20 12:10 | 63.3 | 64.5
2018-06-20 12:20 | 63.4 | 64.3
2018-06-20 12:30 | 63.1 | 63.7
2018-06-20 12:40 | 63.3 | 63.9
2018-06-20 12:50 | 63.7 | 64.4
2018-06-20 13:00 | 63.6 | 64.0 | 1.3e-05
2018-06-20 13:10 | 63.4 | 63.7
2018-06-20 13:20 | 63.6 | 63.9
2018-06-20 13:30 | 64.0 | 64.4
2018-06-20 13:40 | 63.8 | 64.0 | 1.2e-05
2018-06-20 13:50 | 63.6 | 63.8
2018-06-20 14:00 | 63.7 | 63.8
2018-06-20 14:10 | 63.7 | 63.8
2018-06-20 14:20 | 63.6 | 63.7
2018-06-20 14:30 | 63.4 | 63.4 | 1.1e-05
2018-06-20 14:40 | 63.5 | 63.5
2018-06-20 14:50 | 63.7 | 63.7 | 1e-05
2018-06-20 15:00 | 63.7 | 63.7
2018-06-20 15:10 | 63.6 | 63.5
2018-06-20 15:20 | 63.5 | 63.3
2018-06-20 15:30 | 63.5 | 63.4 | 1e-05
2018-06-20 15:40 | 63.6 | 63.5 | 9.5e-06
2018-06-20 15:50 | 63.4 | 63.3
2018-06-20 16:00 | 63.5 | 63.5
2018-06-20 16:15 | 63.4 | 63.3
2018-06-20 16:30 | 63.4 | 63.2
2018-06-20 16:40 | 63.3 | 63.2
2018-06-20 16:50 | 63.5 | 63.3
2018-06-20 17:00 | 63.3 | 63.2
2018-06-20 17:10 | 63.1 | 62.9 | 9e-06
2018-06-20 17:20 | 63.1 | 62.9
2018-06-20 17:30 | 63.1 | 62.9
2018-06-20 17:40 | 63.1 | 63.0
2018-06-20 17:50 | 63.3 | 63.0 | 9e-06
2018-06-21 08:10 | 25.0 | 25.0 | 9e-06

Sheet: Manual just Pressure
RadFxSat-2 Bakeout at NTS Boxborough. Six hour plateau achieved.
Time | T1, °C | T2, °C | Pressure, Torr
2018-06-20 10:30 |  |  | 9.5e-05
2018-06-20 10:50 |  |  | 5.6e-05
2018-06-20 11:50 | 62.0 | 63.0 | 1.9e-05
2018-06-20 13:00 | 63.6 | 64.0 | 1.3e-05
2018-06-20 13:40 | 63.8 | 64.0 | 1.2e-05
2018-06-20 14:30 | 63.4 | 63.4 | 1.1e-05
2018-06-20 14:50 | 63.7 | 63.7 | 1e-05
2018-06-20 15:40 | 63.6 | 63.5 | 9.5e-06
2018-06-20 17:10 | 63.1 | 62.9 | 9e-06
2018-06-20 17:50 | 63.3 | 63.0 | 9e-06
2018-06-21 08:10 | 25.0 | 25.0 | 9e-06

Sheet: DAQ Temperature
RadFxSat-2 Bakeout at NTS Boxborough. Six hour plateau achieved.
Time | T1, °C | T2, °C
2018-06-20 11:37 | 57.94 | 60.04
2018-06-20 11:37 | 57.96 | 60.06
2018-06-20 11:37 | 58.01 | 60.10
2018-06-20 11:37 | 58.05 | 60.16
2018-06-20 11:37 | 58.09 | 60.18
2018-06-20 11:38 | 58.12 | 60.21
2018-06-20 11:38 | 58.15 | 60.26
2018-06-20 11:38 | 58.26 | 60.33
2018-06-20 11:38 | 58.27 | 60.35
2018-06-20 11:38 | 58.33 | 60.41
2018-06-20 11:38 | 58.39 | 60.48
2018-06-20 11:38 | 58.43 | 60.50
2018-06-20 11:38 | 58.47 | 60.54
2018-06-20 11:38 | 58.54 | 60.59
2018-06-20 11:38 | 58.54 | 60.63
2018-06-20 11:38 | 58.61 | 60.66
2018-06-20 11:38 | 58.64 | 60.70
2018-06-20 11:39 | 58.66 | 60.75
2018-06-20 11:39 | 58.70 | 60.77
2018-06-20 11:39 | 58.72 | 60.81
2018-06-20 11:39 | 58.78 | 60.85
2018-06-20 11:39 | 58.80 | 60.87
2018-06-20 11:39 | 58.83 | 60.90
2018-06-20 11:39 | 58.88 | 60.93
2018-06-20 11:39 | 58.92 | 60.98
2018-06-20 11:39 | 58.94 | 61.01
2018-06-20 11:39 | 58.96 | 61.04
2018-06-20 11:39 | 59.02 | 61.06
2018-06-20 11:39 | 59.06 | 61.10
2018-06-20 11:40 | 59.08 | 61.16
2018-06-20 11:40 | 59.10 | 61.17
2018-06-20 11:40 | 59.16 | 61.20
2018-06-20 11:40 | 59.19 | 61.24
2018-06-20 11:40 | 59.22 | 61.28
2018-06-20 11:40 | 59.27 | 61.32
2018-06-20 11:40 | 59.30 | 61.32
2018-06-20 11:40 | 59.32 | 61.36
2018-06-20 11:40 | 59.36 | 61.39
2018-06-20 11:40 | 59.39 | 61.41
2018-06-20 11:40 | 59.43 | 61.46
2018-06-20 11:40 | 59.44 | 61.47
2018-06-20 11:41 | 59.49 | 61.52
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
2018-06-20 16:33 | 63.39 | 63.22
2018-06-20 16:33 | 63.40 | 63.21
2018-06-20 16:33 | 63.40 | 63.22
2018-06-20 16:33 | 63.41 | 63.24
2018-06-20 16:33 | 63.41 | 63.23
2018-06-20 16:33 | 63.41 | 63.22
2018-06-20 16:33 | 63.43 | 63.24
2018-06-20 16:33 | 63.38 | 63.24
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
