AMSAT-NA/fox-plus/systems_engineering/Compliance + Testing/Fox_Radiation (Tony Monteiro).pdf

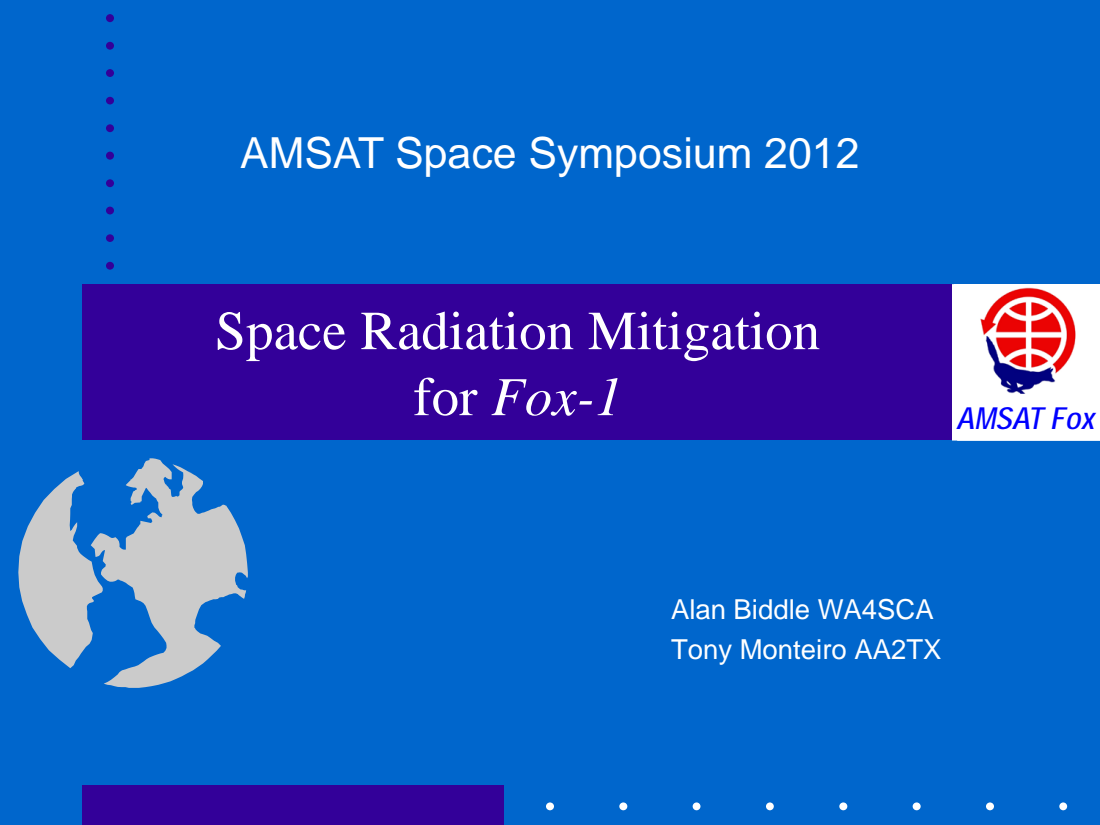
[picture p195: page 1]
AMSAT Fox; Alan Biddle WA4SCA Tony Monteiro AA2TX

AMSAT Space Symposium 2012

Space Radiation Mitigation
for Fox-1

AMSAT Fox

## Space Radiation Components

Type | Source | Composition
Trapped Particles in Van Allen Belts | Solar Wind | High Energy Protons (+ Anti-protons!) High Energy Electrons Bremsstrahlung (X-Rays)
Galactic Cosmic Radiation | Cosmic Rays | Hydrogen to Uranium Nuclei Low Flux, but Very High Energies
Solar Particle Events | Solar Flares and Coronal Mass Ejections | Energetic Electrons, Protons, Alpha Particles

## Radiation in Orbit

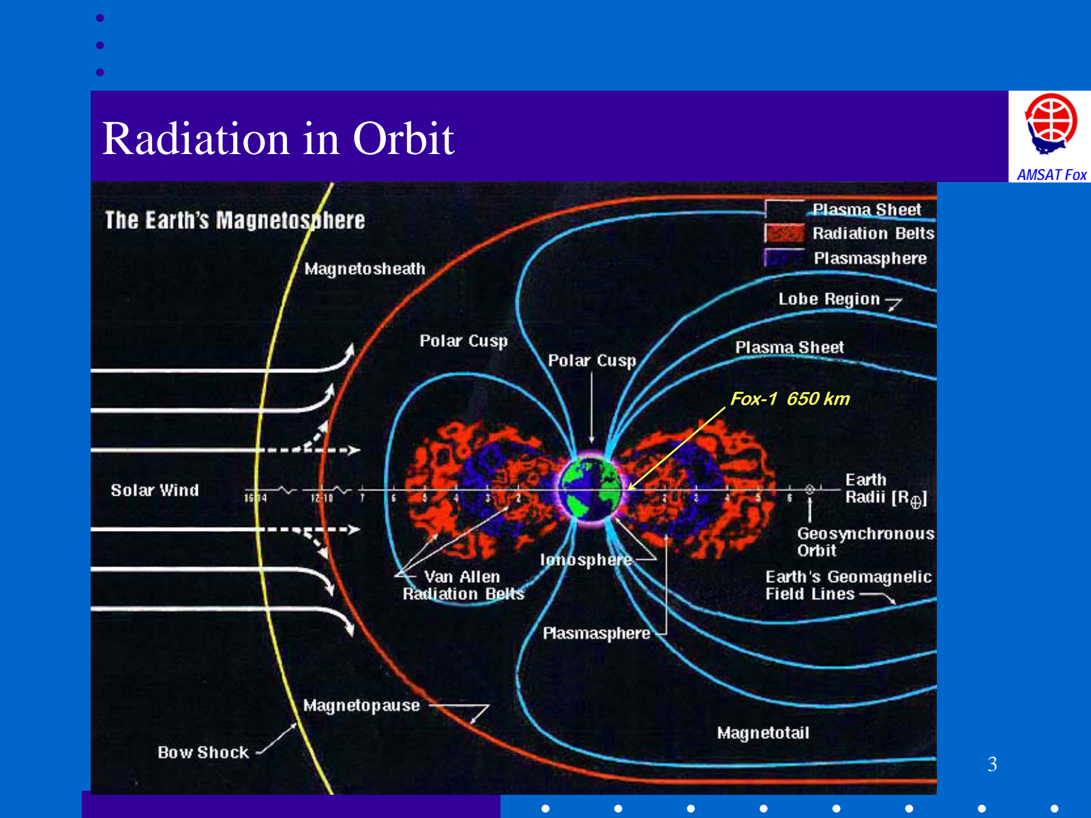
[picture p196: page 3]

AMSAT Fox

Fox-1 650 km

## South Atlantic Anomaly

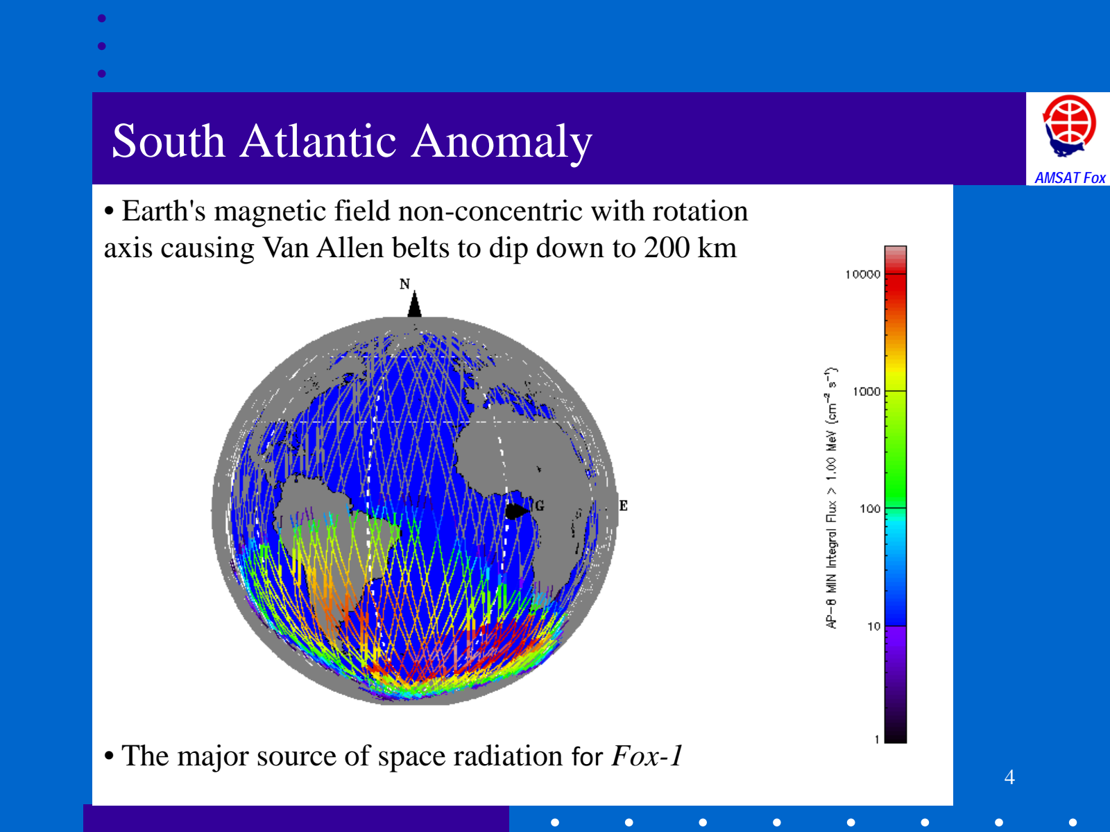
[picture p197: page 4]

AMSAT Fox
- Earth's magnetic field non-concentric with rotation axis causing Van Allen belts to dip down to 200 km
- The major source of space radiation for Fox-1

AMSAT Fox

## Space Radiation Effects

- Total Ionizing Dose (TID) The result of all of the radiation that is absorbed by a component over time. Non-deterministic but expected ranges can be effectively modeled.
- Single Event Effects (SEE) The result of high energy particles. Can happen at any time - on first day or after many years in orbit.

AMSAT Fox

## Radiation Effects on Components

- Total Ionizing Dose (TID) causes components to gradually deteriorate like wear on a tire
– Parameter drift
– Electrical leakage in insulators
- Single Event Effects (SEE) cause immediate failure like a tire blowout from a sharp object
– Failure can be temporary or permanent
– Transient signals
– Stuck-bits in logic devices
– MOS gate rupture
– CMOS latchup (SEL)

AMSAT Fox

## TID Modeling

- The radiation source model
Various models applicable to different particles and solar conditions which each give significantly different results - picking the right one is part art and part science.
- The orbit, and expected solar activity
Solar activity varies significantly over the short and long term - a Coronal Mass Ejection (CME) can deliver a years worth of radiation in a few days.
- The radiation absorption model used for the spacecraft components

AMSAT Fox

## Spacecraft Absorption Models

1. Semi-infinite slab - models components near surface of spacecraft.
2. Finite slab - models spot shielded components.
3. Solid spherical shell - models components deep within
spacecraft.

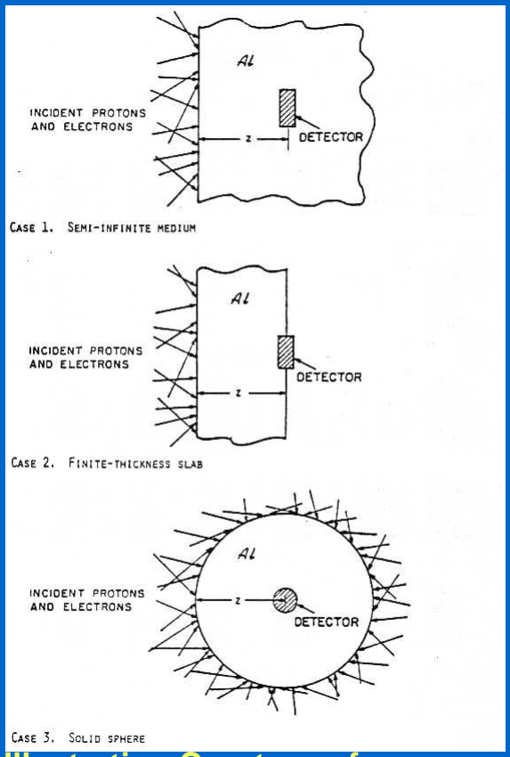
[picture p198: figure]

Illustration Courtesy of ESA/SPENVIS

No publically available models for a complete, general spacecraft. There are three basic geometries available.

AMSAT Fox

Calculation of TID Radiation

- None of these models closely resembles a CubeSat. In order to develop a semi-quantitative profile for radiation deposition, select a radiation source profile and:
– Pick the deposition model most appropriate to the satellite face.
– Convert the component substances to the equivalent thickness of aluminum.
– Calculate the radiation deposition between each surface and the opposite surface.
– Superimpose the radiation contributions from each surface to get an approximate 3D image.

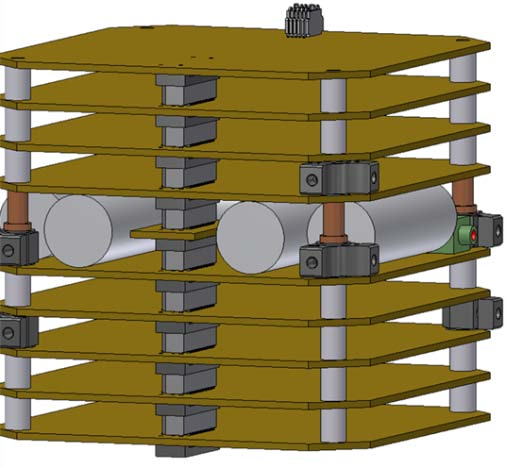
[picture p199: figure]

Given the many
approximations,
the spherical shell
model is
surprisingly
applicable to most
configurations.

## Fox-1 Effective Shielding

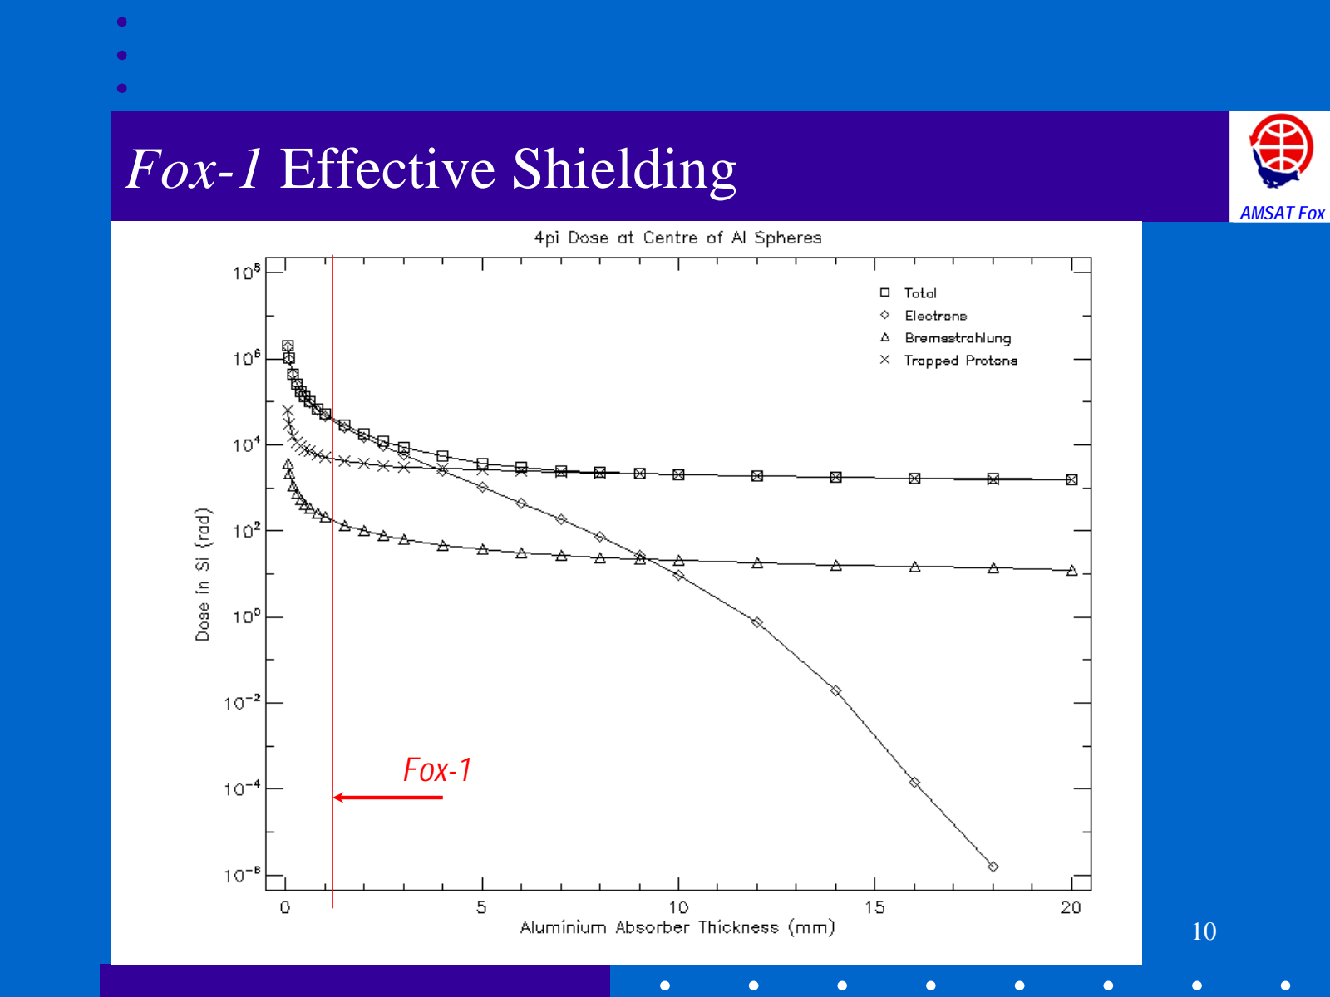
[picture p200: page 10]

AMSAT Fox

Fox-1

AMSAT Fox

## Component Spot Shielding

- Tantalum or lead traditionally used for spot shielding of sensitive components to reduce TID
- A little bit of shielding can be worse than no shielding!
- Spot shielding can create additional radiation due to Bremsstrahlung
- Reductions in TID can result in an increase in SEE
- Use limited spot shielding of specific components if warranted

AMSAT Fox

## ESA SPENVIS TID Model

- 5 year mission lifetime
- 650 km polar orbit
- Include average contribution of shielding from structure and PCBs
- Spherical shell model
- Median radiation dose ~ 2 kRAD / year
- Model shows total expected dose < 30 kRAD over 5 year interval with 90% confidence

AMSAT Fox

## SEE Modeling

- Need to calculate the Linear Energy Transfer (LET) of a particle as it passes though components leaving a “contrail” of energy along its path.
- Single event effect occurs when energy deposited by a particle is above the component's LETthreshold
- Computer models require detailed component internal structure information - not a practical approach for AMSAT
- NASA data for smilar orbit shows low event probability above ~ 37 MeV-cm²/mg

AMSAT Fox

## Overall Radiation Mitigation Strategy

- Satellite based on COTS parts
- Use radiation tested parts where possible
- Employ system-level radiation tolerance
- Very limited use of rad-hard parts
– Solar cells are rad-hard
- Limited radiation spot shielding of specific components if warranted

AMSAT Fox

## Radiation Mitigation Reality

- It is not possible to eliminate all risks
- It is not possible to use only proven, tested components
- Reduce risks where possible
- Use conservative circuit design approaches
- Design for fault tolerance

AMSAT Fox

## Engineering Guidelines

- Prefer components that have been rad-tested
– TID > 30 kRAD
– No latchups > 37 MeV-cm2/mg
- Do not use parts that have tested poorly
- Space flight heritage - better than nothing
- Prefer discrete semiconductors to ICs
- ICs from TI tend to test well
- Untested or sensitive CMOS parts must have latchup protection circuitry (use FPF20xx)
- Passive components can generally be considered safe

AMSAT Fox

## Low Risks

- U310 J-FETs
- 2N2222 type transistors
- LM139 comparators
- LM6142 op amps
- LT6233 low noise op amps
- TMP36 temp sensors
- DS1631 I²C digital thermometers
- CD4000 & 74HCxxx logic generally OK

AMSAT Fox

## High Risks

- Any version of 555 timer
- Any part with an internal charge pump
- All low-dropout voltage regulators and high-side switches with N-channel or NPN pass transistors
– LP2941 - LP2953
- BiCMOS linear components (op amps)
– LTC2052
- Active temperature sensors
– AD590
- Untested microprocessors & microcontrollers

AMSAT Fox

## NASA Derating Guidelines

PART TYPE | RECOMMENDED DERATING LEVEL
Capacitors | Max. of 60% of rated voltage
Resistors | Max. of 60% of rated power
Semiconductor Devices | Max. of 50% of rated power Max. of 75% of rated voltage Max. junction temperature of 110°C
Microcircuits | Max. supply voltage of 80% of rated voltage Max. of 75% of rated power Max. junction temperature of 100°
Inductive Devices | Max. of 50% of rated voltage Max. of 60% of rated temperature
Relays and Connectors | Max. of 50% of rated current

NOTE: Maximum junction temperature levels should not be exceeded at any time or during any ground, test, or flight exposure. Thermal design characteristics should preclude exceeding the stated temperature levels.

AMSAT Fox

## Component Radiation Tests

- MPPT & Battery card components
- PLL for receiver LO
- Command decoder
- STM32L microcontroller

AMSAT Fox

## Space Radiation Resources

- NASA JPL: radcentral.jpl.nasa.gov
- NASA Goddard: radhome.gsfc.nasa.gov
- ESA : escies.org/labreport/radiationList
- IEEE Nuclear and Plasma Sciences Society
- IEEE papers
- NSREC conference papers
- Alan Biddle WA4SCA - consulting radiation physicist

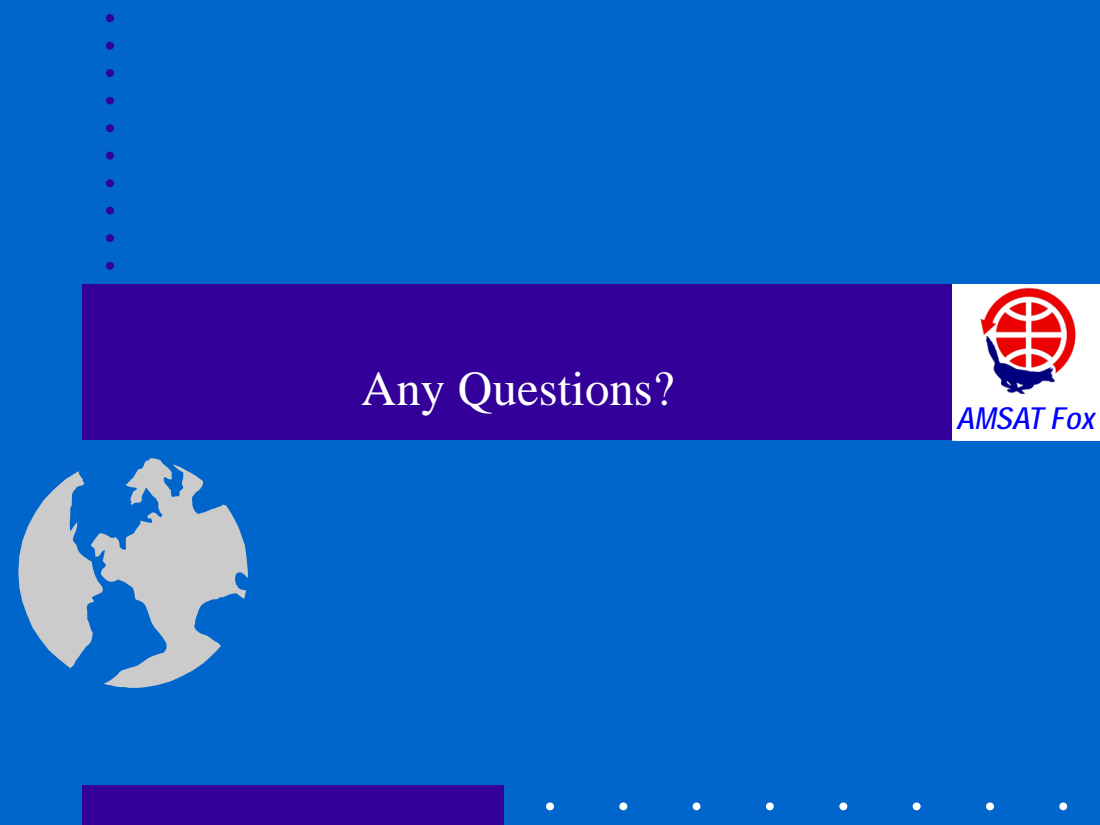
[picture p201: page 22]
AMSAT Fox Any Questions?; AMSAT Fox
