AMSAT-NA/fox-plus/systems_engineering/Compliance + Testing/NASA VCLS ELaNa XX Mass Properties.xlsx

ELaNa XX Manifest Mass Properties table
Payload Name | Dispenser | Type | #U | Mass Properties (kg) |  | Dimensions (cm) Stowed |  |  |  |  |  | Dimensions (cm) Deployed |  |  |  |  |  | CG (cm) Deployables Constrained Launch Configuration
 |  |  |  | Mass |  | L (Z-Axis) |  | W (X-Axis) |  | H (Y-Axis) |  | L (Z-Axis) |  | W (X-Axis) |  | H (Y-Axis) |  | X |  | Y |  | Z
CACTUS-1 | FR-T | Tab | 3U | 2.8 | kg | 36.6 | cm | 10.3 | cm | 11 | cm |  | cm |  | cm |  | cm | 0 | cm | 0 | cm | 15 | cm
Prometheus - 04 | FR-R | Rail | 1.5U | 2.68 | kg | 17.05 | cm | 10.03 | cm | 10.5 | cm |  | cm |  | cm |  | cm | -0.12 | cm | -0.50 | cm | 3.43 | cm
Prometheus - 05 | FR-R | Rail | 1.5U | 2.69 | kg | 17.06 | cm | 10.01 | cm | 10.08 | cm |  | cm |  | cm |  | cm | -0.12 | cm | -0.50 | cm | 3.43 | cm
PICS | FR-R | Rail | 1U (2) | 2.7 | kg | 11.2 | cm | 11.2 | cm | 11.2 | cm |  | cm |  | cm |  | cm | 0 | cm | 0 | cm | -1 | cm
Cape-3 | FR-R | Rail | 1U | 1.3 | kg | 11.35 | cm | 10 | cm | 10 | cm |  | cm |  | cm |  | cm |  | cm |  | cm |  | cm
Q-PACE | FR-R | Rail | 3U | 4.2 | kg | 30 | cm | 10 | cm | 10 | cm |  | cm |  | cm |  | cm | 0 | cm | 0 | cm | 0 | cm
MiTEE | FR-R | Rail | 3U | 4.0 | kg | 34 | cm | 10 | cm | 10 | cm |  | cm |  | cm |  | cm | 0 | cm | 0 | cm | 0.5 | cm
RadFXSat-2 | FR-R | Rail | 1U | 1.3 | kg | 11.35 | cm | 11.12 | cm | 11.12 | cm |  | cm |  | cm |  | cm | 0 | cm | 0.2 | cm | -0.5 | cm
TEchEdSat-7 | FR-R | Rail | 2U | 2.49 | kg | 21.75 | cm | 10.64 | cm | 10.64 | cm |  | cm |  | cm |  | cm | -0.17 | cm | 7.5 | cm | -0.59 | cm
INCA | FR-R | Rail | 3U | 3.83 | kg | 37.5 | cm | 11.5 | cm | 11.5 | cm |  | cm |  | cm |  | cm | 0.22 | cm | 0.3 | cm | -5.16 | cm
MicroMas-2b | FR-R | Rail | 3U | 4.5 | kg | 34.05 | cm | 10 | cm | 10 | cm |  | cm |  | cm |  | cm | 0.04 | cm | 0.42 | cm | 1.56 | cm
EXOCUBE | FR-R | Rail | 3U | 3.2 | kg | 35.05 | cm | 10 | cm | 10 | cm |  | cm |  | cm |  | cm | 1.08 | cm | 2.19 | cm | 9.31 | cm
PolarCube | FR-R | Rail | 3U | 3.9 | kg | 34 | cm | 10.1 | cm | 10.5 | cm |  | cm |  | cm |  | cm | 1 | cm | -1 | cm | 5 | cm
