AMSAT-NA/fox-plus/systems_engineering/Compliance + Testing/RadFxSat-2 mass measurements.xlsx

rods,nuts | 15.4
VU REM SN3 | 41.7
4x spacers | 2
LEP SNCHF1 | 41
4x spacers | 2
LEPF SNF2 | 52.7
Delrin mounts | 7.9
VUC SN CHF2 | 40
4x standoffs | 3.2
4x spacers+mag | 9.4
Batt2 | 3.7
Batt1 SN200 | 284.3 | 272 before hysteresis
4x spacers | 1.4
MPPT SN8 | 281.2 | 46.4 before lead
4x delrin spacers | 7.7
IHU SN14 | 41.9
4x spacers | 2
ICR SN TWO | 49.1
4x spacers | 2
RXTX SN2 | 53.7 |  | RXTX SN 1 | 54.9
PCB Stack | 944.6
Walls | 63
+X SN 202 | 42.3
-X SN 203 | 42.7
+Z SN 204 | 39.4
-Z SN 205 | 42.8
+Y SN 206 | 45.6
-Y SN 207 | 46.3
fasteners | 10
total | 1276.7
lead needed | 43.3
 |  |  | a stop sign | 114 | used 2 stop signs. unknown large epoxy.
 |  |  | epoxy | 53.2 | (must be)
CAC 3/30/'18 | 1.321 | kg, +/- 1g | with RBF Pin (1.3 grams without elaborate flags), but without AL tape (0.6 grams).
actual | 1.3203 | kg +/- 1g
CAC 4/10/'18 |  |  | Actual Flight Configuration: without RBF Pin and with AL tape.
