AMSAT-NA/fox-plus/systems_engineering/Compliance + Testing/RadFxSat-2 shock.xlsx

Sheet: Sheet1
LauncherOne Payload Shock MPE, Table 3.19
 |  | -30% | -50%
Freq (Hz) | Source (g) | -30% 1st Joint | -50% 2nd Joint | 0
100 | 20 | 14.0 | 7.0 | 7.0
1000 | 1755 | 1228.5 | 614.2 | 614.2
1955 | 4000 | 2800.0 | 1400.0 | 1400.0
10000 | 4000 | 2800.0 | 1400.0 | 1400.0
 |  | -3.1 dB | -9.1 dB | -9.1 dB
 |  |  | 1st Joint -30%, 2nd Joint -50%, -9.1dB total
LauncherOne Payload Shock MPE, Figure 3.19
Freq (Hz) | SRS (g)
100 | 60
1000 | 3500
1800 | 3500
2000 | 4000
10000 | 4000
Factor | +3.0 | dB
RadFxSat-2 ProtoQual Shock Response (Q=10)
Freq (Hz) | SRS (g)
100 | 84.75225268
1000 | 4943.881406
1950 | 5650.150178
10000 | 5650.150178
GSFC-STD-7000A Fig 2.4-1 SRS for assessing Component Test Requirements
Page 2.4-25 "If the flight shock environment as shown on a SRS plot (Q=10) is enveloped by the appropriate curve shown in Figure 2.4-1, then the shock environment can be considered benign and there is low risk in deferring the shock test.
Freq (Hz) | GSFC-STD-7000A Fig 2.4-1 SRS (g) Other Hardware | GSFC-STD-7000A Fig 2.4-1 SRS (g) Standard Electronics
100 | 80 | 80
500 | 500 | 500
10000 | 500 | 8000
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
