AMSAT-NA/fox-plus/systems_engineering/Compliance + Testing/RadFxSat-2 Venting.xls

Sheet: Fox1 venting tree
 | +Z Solar Panel
structure and side solar panels
 |  | Exp4
 |  | LEP
 |  | VUC
 |  | Battery
 |  | PSU
 |  | IHU
 | -Z Solar Panel
 |  |  | Component | Gas Volume (in^3) | Venting Area (in^2) | Volume/Area (in) | V/A <2000 in?
 |  |  | Lens Housing | 0.04 | 0.0121 | 3.451754051 | Yes
 |  |  | Rx Shield | 1.32 | 0.0009 | 1445.477776 | Yes
 |  |  | Tx Shield | 0.78 | 0.0009 | 852.1681992 | Yes
 |  |  | around each of 9 PCBs | ≤6.76 | ≥0.811 | <25 | Yes
 |  |  | Fox1 Main Body | #REF! | 0.3472 | #REF! | Yes
 |  |  | Lens Housing, and three Shields have drilled holes in thin walls.
 |  |  | IHU Shield and Tx Shield assumed similar to Rx Shield.
 |  |  | All 9 internal stacked Printed Circuit Boards vent around edges.
 |  |  | Fox1 Main Body vents around edges of +Z and -Z solar panels.

Sheet: Fox1 venting diagram
Board |  |  |  |  |  |  | 4 peri slots | Cumulative
 |  | Vol (in^3) | Area (in^2) | V/A (in) |  |  | Area (in^2) | Vol (in^3) | V/A (in)
+Z solar |  |  |  |  |  | ▲ | 0.1736 |  | 137.2421732 |  | Goal Seek
 |  | 3.5775 |  |  |  |  |  | 23.8253 |  | 0.0000 | "Set cell" "To value" 0
REM |  |  |  |  |  | ▲ | 1.8170 |  | 11.14343745
 |  | 4.8527 |  |  |  |  |  | 20.2478
LEP |  |  |  |  |  | ▲ | 1.8170 |  | 8.472721026
 |  | 4.8527 |  |  | ► |  |  | 15.3951
LEPF | Spacers | 0.01011438971 | 0.001963495408 | 5.15121638 | ► | ▲ | 1.0424 |  | 10.10420512
 |  | 4.8527 |  |  |  |  |  | 10.5322
VUC |  |  |  |  |  | ▲ | 1.0424 |  | 5.448679441
 |  |  |  |  |  |  |  | 5.6795 |  | 85.768% | "By changing cell"
-X/-Y Solar |  | 6.6219 |  |  |  |  | +X/+Y Solar |  |  | goes +Z
 |  |  |  |  |  |  |  | 0.9424
Battery |  |  |  |  |  | ▼ | 0.9428 |  | 0.9996193246
 |  | 4.8527 |  |  |  |  |  | 5.7951
MPPT |  |  |  |  |  | ▼ | 0.9544 |  | 6.071990894
 |  | 4.8527 |  |  | ► |  |  | 10.6644
IHU | Spacers | 0.0165 | 0.0020 | 8.407252666 | ► | ▼ | 0.9544 |  | 11.17385056
 |  | 4.8527 |  |  |  |  |  | 15.5171
ICR |  |  |  |  |  | ▼ | 1.0540 |  | 14.72211388
 |  | 4.8527 |  |  |  |  |  | 20.3699
RXTX |  |  |  |  |  | ▼ | 0.8665 |  | 23.50953857
 |  | 3.516 |  |  |  |  |  | 23.8863
-Z Solar |  |  |  |  |  | ▼ | 0.1736 |  | 137.5936918
 |  | Total Vol (in^3)
 |  | 47.71

Sheet: box volume
int vol | 970004 | mm3 | 59.2 | in3
PCBs vol | 239143 | mm3 | 14.6 | in3
venting volume |  |  | 44.6 | in3 | no greater than
vent slots | 8
slot width | 0.5 | mm
slot length | 56 | mm
vent area | 224 | mm2 | 0.347 | in2
V / A |  |  | 128.4556032 | in
req'd (this or lower) |  |  | 2000 | in

Sheet: TX shield
Assume same as RX shield
If we simplify planform area of RX RF shield:
 | x | y | area
base | 35 | 77 | 2695 | mm2
Up Rt corner | 15 | 38 | -570 | mm2
Total area |  |  | 2125 | mm2 | similar to CAD area meas.
shield interior height |  |  | 6.0 | mm
Volume under shield |  |  | 12750 | mm3 | 0.78 | in3 | assumes no components
vent hole qty | 3
diameter | 0.50 | mm
vent area total |  |  | 0.59 | mm2 | 0.00091 | in2
 |  |  |  | Volume / Area | 852.1681992 | in
 |  |  |  | Req'd less than | 2000 | in

Sheet: RX shield
If we simplify planform area of RX RF shield:
 | x | y | area
base | 91 | 65 | 5915 | mm2
Lo Rt corner | 52.5 | 36 | -1890 | mm2
Up Rt corner | 14.5 | 14.5 | -210.25 | mm2
Up Lft corner | 14.5 | 14.5 | -210.25 | mm2 | approximation
Total area |  |  | 3604.5 | mm2 | similar to CAD area meas.
shield interior height |  |  | 6.0 | mm
Volume under shield |  |  | 21627 | mm3 | 1.32 | in3 | assumes no components
vent hole qty | 3
diameter | 0.50 | mm
vent area total |  |  | 0.59 | mm2 | 0.00091 | in2
 |  |  |  | Volume / Area | 1445.477776 | in
 |  |  |  | Req'd less than | 2000 | in

Sheet: IHUshield
Assume same as RX shield
If we simplify planform area of RX RF shield:
 | x | y | area
base | 91 | 65 | 5915 | mm2
Lo Rt corner | 52.5 | 36 | -1890 | mm2
Up Rt corner | 14.5 | 14.5 | -210.25 | mm2
Up Lft corner | 14.5 | 14.5 | -210.25 | mm2 | approximation
Total area |  |  | 3604.5 | mm2 | similar to CAD area meas.
shield interior height |  |  | 6.0 | mm
Volume under shield |  |  | 21627 | mm3 | 1.32 | in3 | assumes no components
vent hole qty | 3
diameter | 0.50 | mm
vent area total |  |  | 0.59 | mm2 | 0.00091 | in2
 |  |  |  | Volume / Area | 1445.477776 | in
 |  |  |  | Req'd less than | 2000 | in

Sheet: venting around PCBs
 | qty | width | length | area (mm2) | area (in^2)
four edges PCB to Walls | 4 | 1.5 | 73 | 438 | 0.68
four holes in Walls to Side SP | 4 | 1 | 60 | 240 |  | Do not count so we can add ballast on rear of any solar panel.
per corner crops |  | 11 | 11 | 60.5 | 0.09
per Delrin radius |  | 8.5 |  | 56.74501731 | 0.09
camera cutout (camera in middle) |  |  | 25 | 492.2677104 | 0.76
Z solar panels | 4 | 0.5 | 56 | 112 | 0.17
