AMSAT-NA/fox-plus/systems_engineering/Compliance + Testing/README

This folder to contain copies of documents from other sources
See "Compliance Docs List" for documents by Task Area
