AMSAT-NA/fox-plus/presentations/2026_Jan PDR/PDR Open Issues .pdf

Issues / concerns from FoxPlus-A PDR that need follow up | 02/06/26
ISSUE / Concern | Status | Assignee | Remediation / Clarification
1 | New | Mike / Burns
| | | Highest priority. Biggest piece missing in the PDR.

2

New | Mike

3

New | Mike

4

New | Mike

Apply Before Flight (ABF) logic v Remove Before Flight
a) Need to know exactly how the ABF works compared to RBF. This determines the sat startup for on orbit.
b) Need to determine umbilical connector for pre-flight tests and battery charging. c) Connector needs to withstand vibration, etc.
Antenna System: antenna deployment
Although this was tested previously, the software has changed and it needs to be tested again.
RF Tuning. The dipole antennas purchased from ISISpace were pre-tuned to a lower freq than what will be used. Need to assign engineers or outside consultant to trim and fine tune for our assigned frequency
Research whether anyone using ISISpace has published orbital charts on charge / discharge
