AMSAT-NA/fox-plus/mechanical/SpecificationSheets/90965A130_316 Stainless Steel Washer.pdf

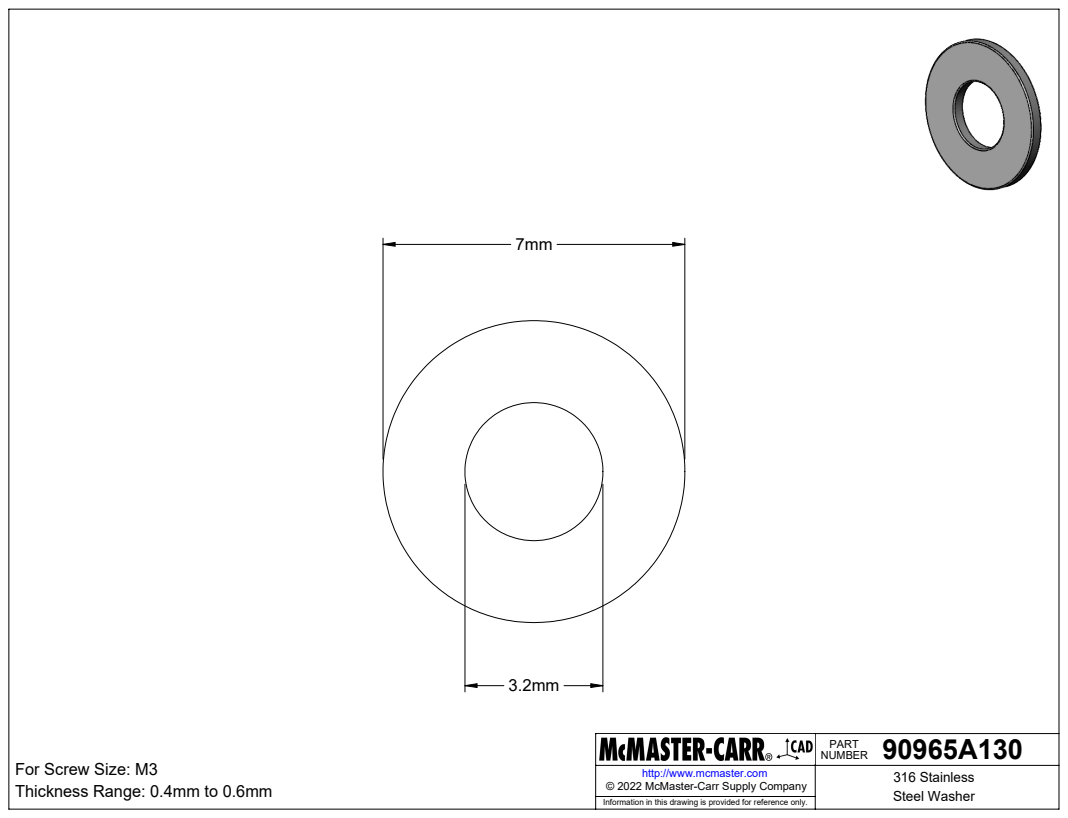
[picture p206: page 1]
Thickness Range: 0.4mm to 0.6mm; Steel Washer © 2022 McMaster-Carr Supply Company

90965A130 PART NUMBER

316 Stainless For Screw Size: M3

http://www.mcmaster.com

Information in this drawing is provided for reference only.
