AMSAT-NA/fox-plus/mechanical/SpecificationSheets/92290A763_Super-Corrosion-Resistant 316 Stainless Steel Socket Head Screw.pdf

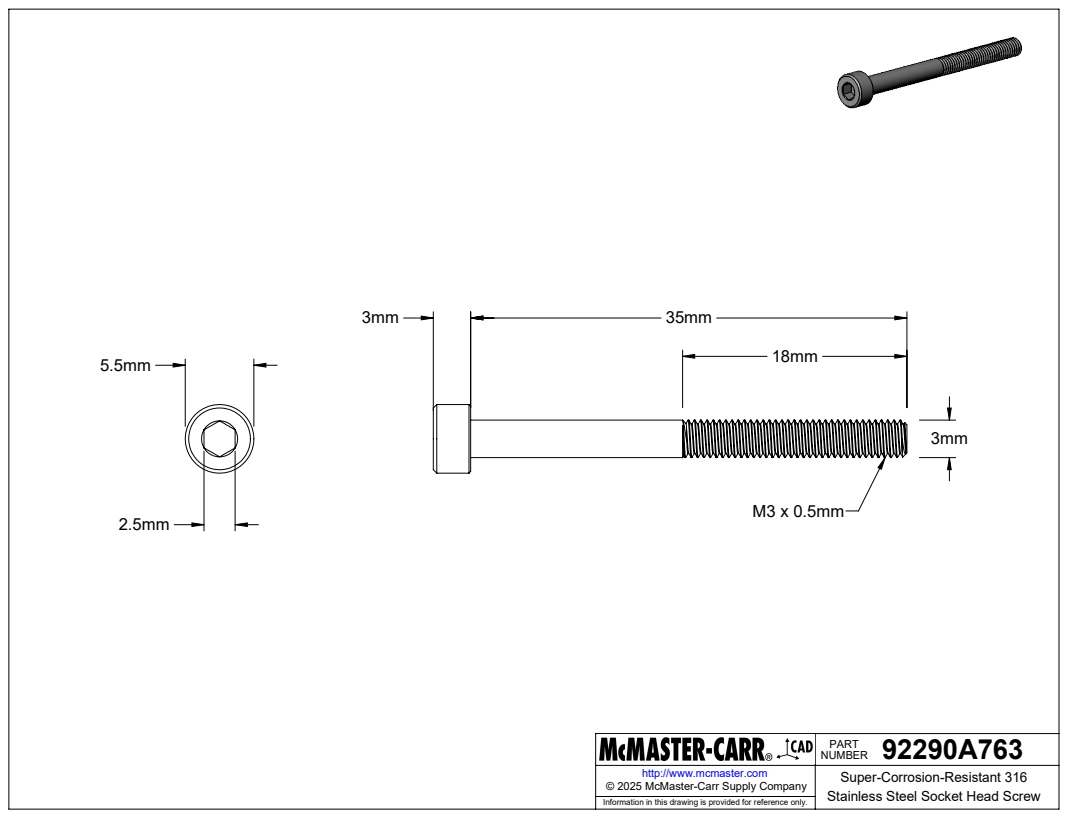
[picture p207: page 1]

92290A763 PART NUMBER

http://www.mcmaster.com | Super-Corrosion-Resistant 316 Stainless Steel Socket Head Screw © 2025 McMaster-Carr Supply Company

Information in this drawing is provided for reference only.
