AMSAT-NA/fox-plus/mechanical/SpecificationSheets/93395A217_316 Stainless Steel Hex Drive Flat Head Screw.pdf

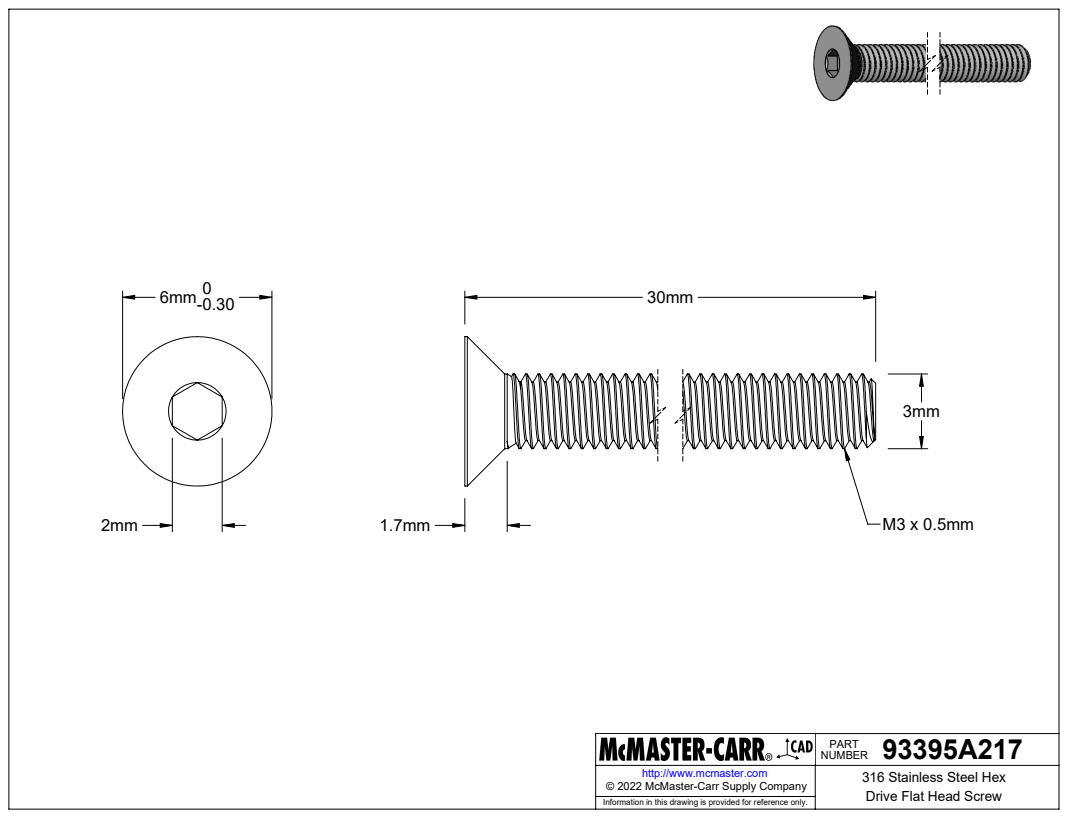
[picture p208: page 1]

93395A217 PART NUMBER

http://www.mcmaster.com | 316 Stainless Steel Hex Drive Flat Head Screw © 2022 McMaster-Carr Supply Company

Information in this drawing is provided for reference only.
