AMSAT-NA/fox-plus/mechanical/SpecificationSheets/94669A043_Aluminum Unthreaded Spacer.pdf

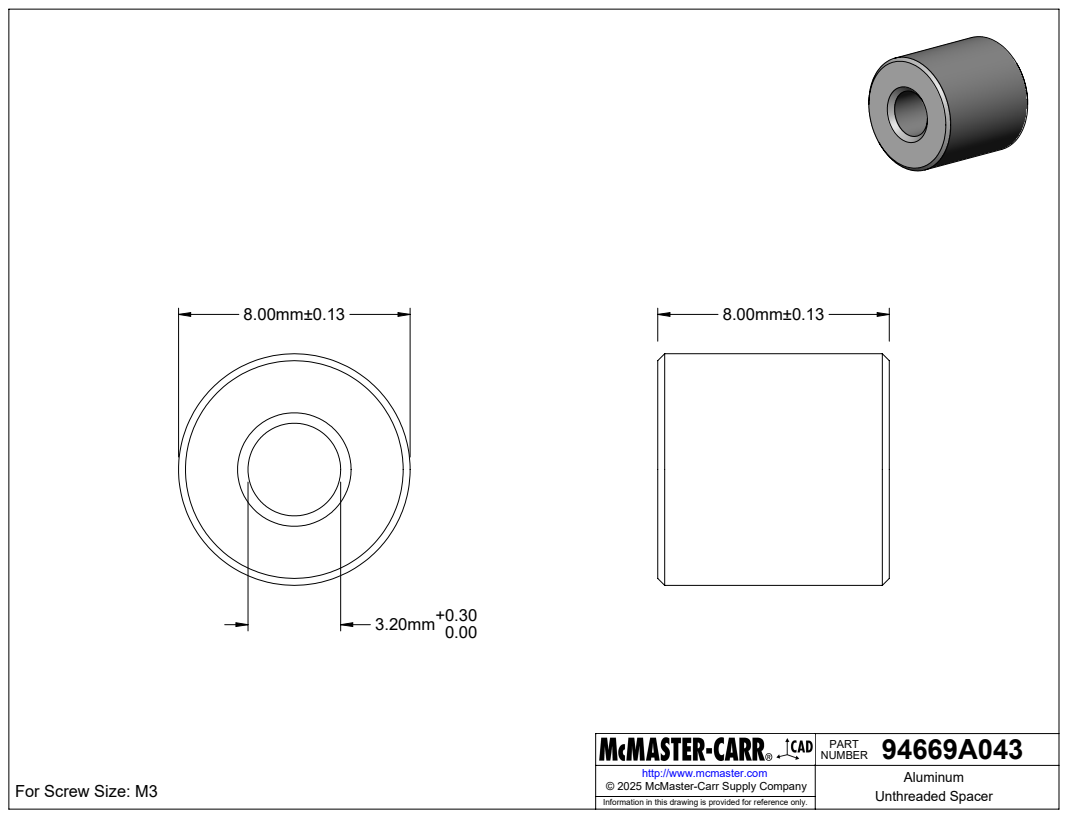
[picture p209: page 1]
For Screw Size: M3; Unthreaded Spacer © 2025 McMaster-Carr Supply Company

94669A043 PART NUMBER

http://www.mcmaster.com | Aluminum

Information in this drawing is provided for reference only.
