AMSAT-NA/fox-plus/mechanical/Drawings/FOX-ME-201_Jumper Assembly.pdf

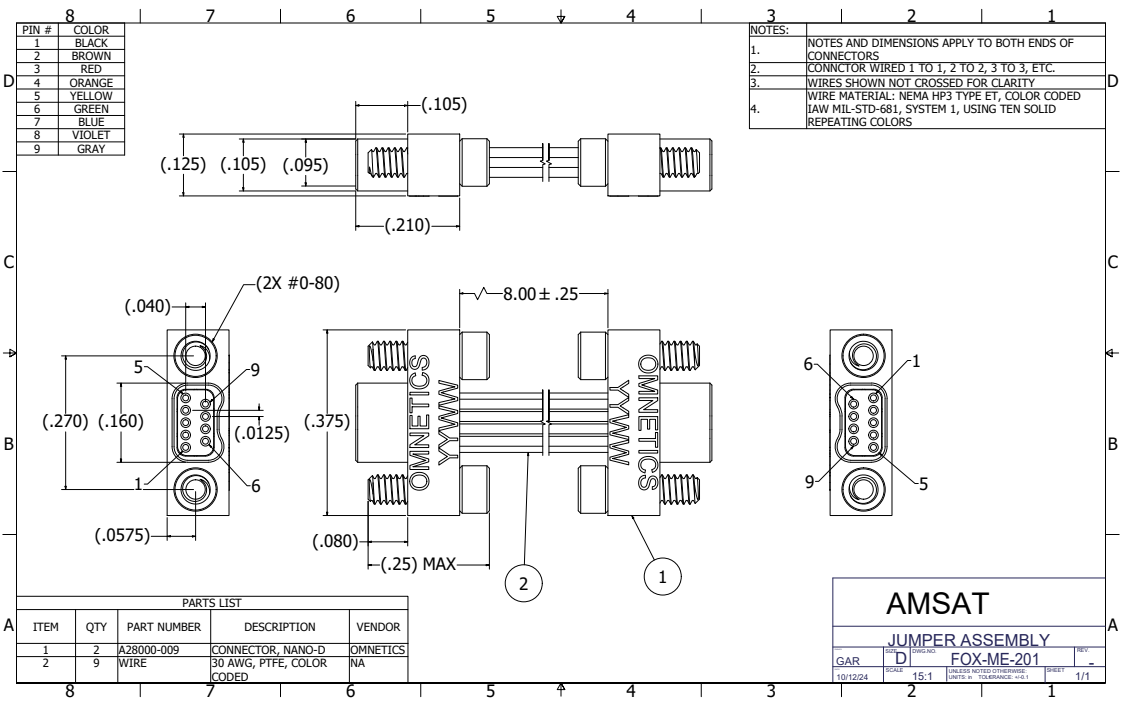
[picture p210: page 1]
PARTS LIST; JUMPER ASSEMBLY; UNITS: in; TOLERANCE: +/-0.1; (.25) MAX

PIN # | COLOR | NOTES:
1 | BLACK | 1. | NOTES AND DIMENSIONS APPLY TO BOTH ENDS OF CONNECTORS
2 | BROWN
3 | RED | 2. CONNCTOR WIRED 1 TO 1, 2 TO 2, 3 TO 3, ETC.
4 | ORANGE | 3. WIRES SHOWN NOT CROSSED FOR CLARITY
5 | YELLOW | 4. | WIRE MATERIAL: NEMA HP3 TYPE ET, COLOR CODED IAW MIL-STD-681, SYSTEM 1, USING TEN SOLID REPEATING COLORS
6 | GREEN
7 | BLUE
8 | VIOLET
9 | GRAY

ITEM | QTY | PART NUMBER | DESCRIPTION | VENDOR

1 | 2 | A28000-009 | CONNECTOR, NANO-D | OMNETICS
2 | 9 | WIRE | 30 AWG, PTFE, COLOR CODED | NA

DWN BY: GAR | SIZE D | DWG.NO. FOX -ME-201 | REV. -

DATE: 10/12/24

UNLESS NOTED OTHERWISE:
