AMSAT-NA/fox-plus/PowerSig_Adapter/PowerSigAdapter.pdf

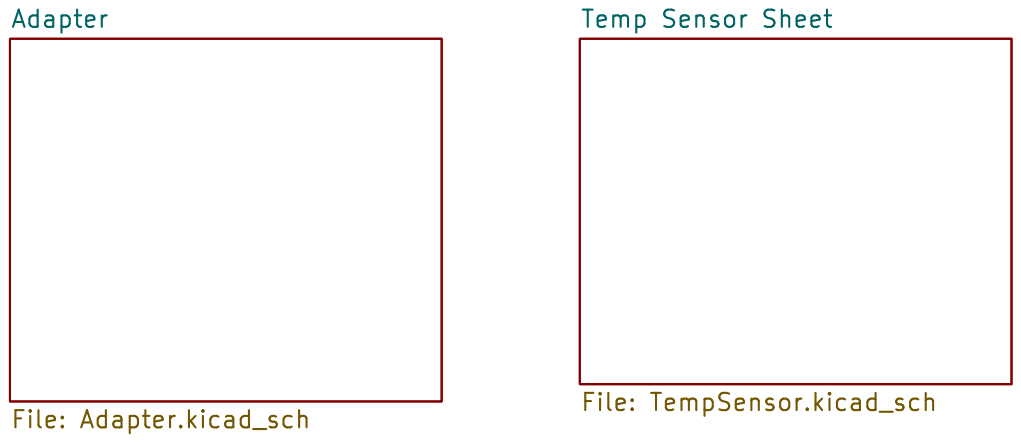
[picture p211: page 1]

Temp Sensor Sheet File: TempSensor.kicad_sch

Id: 1/3 Title: ISIS Power Signal Adapter v1.2

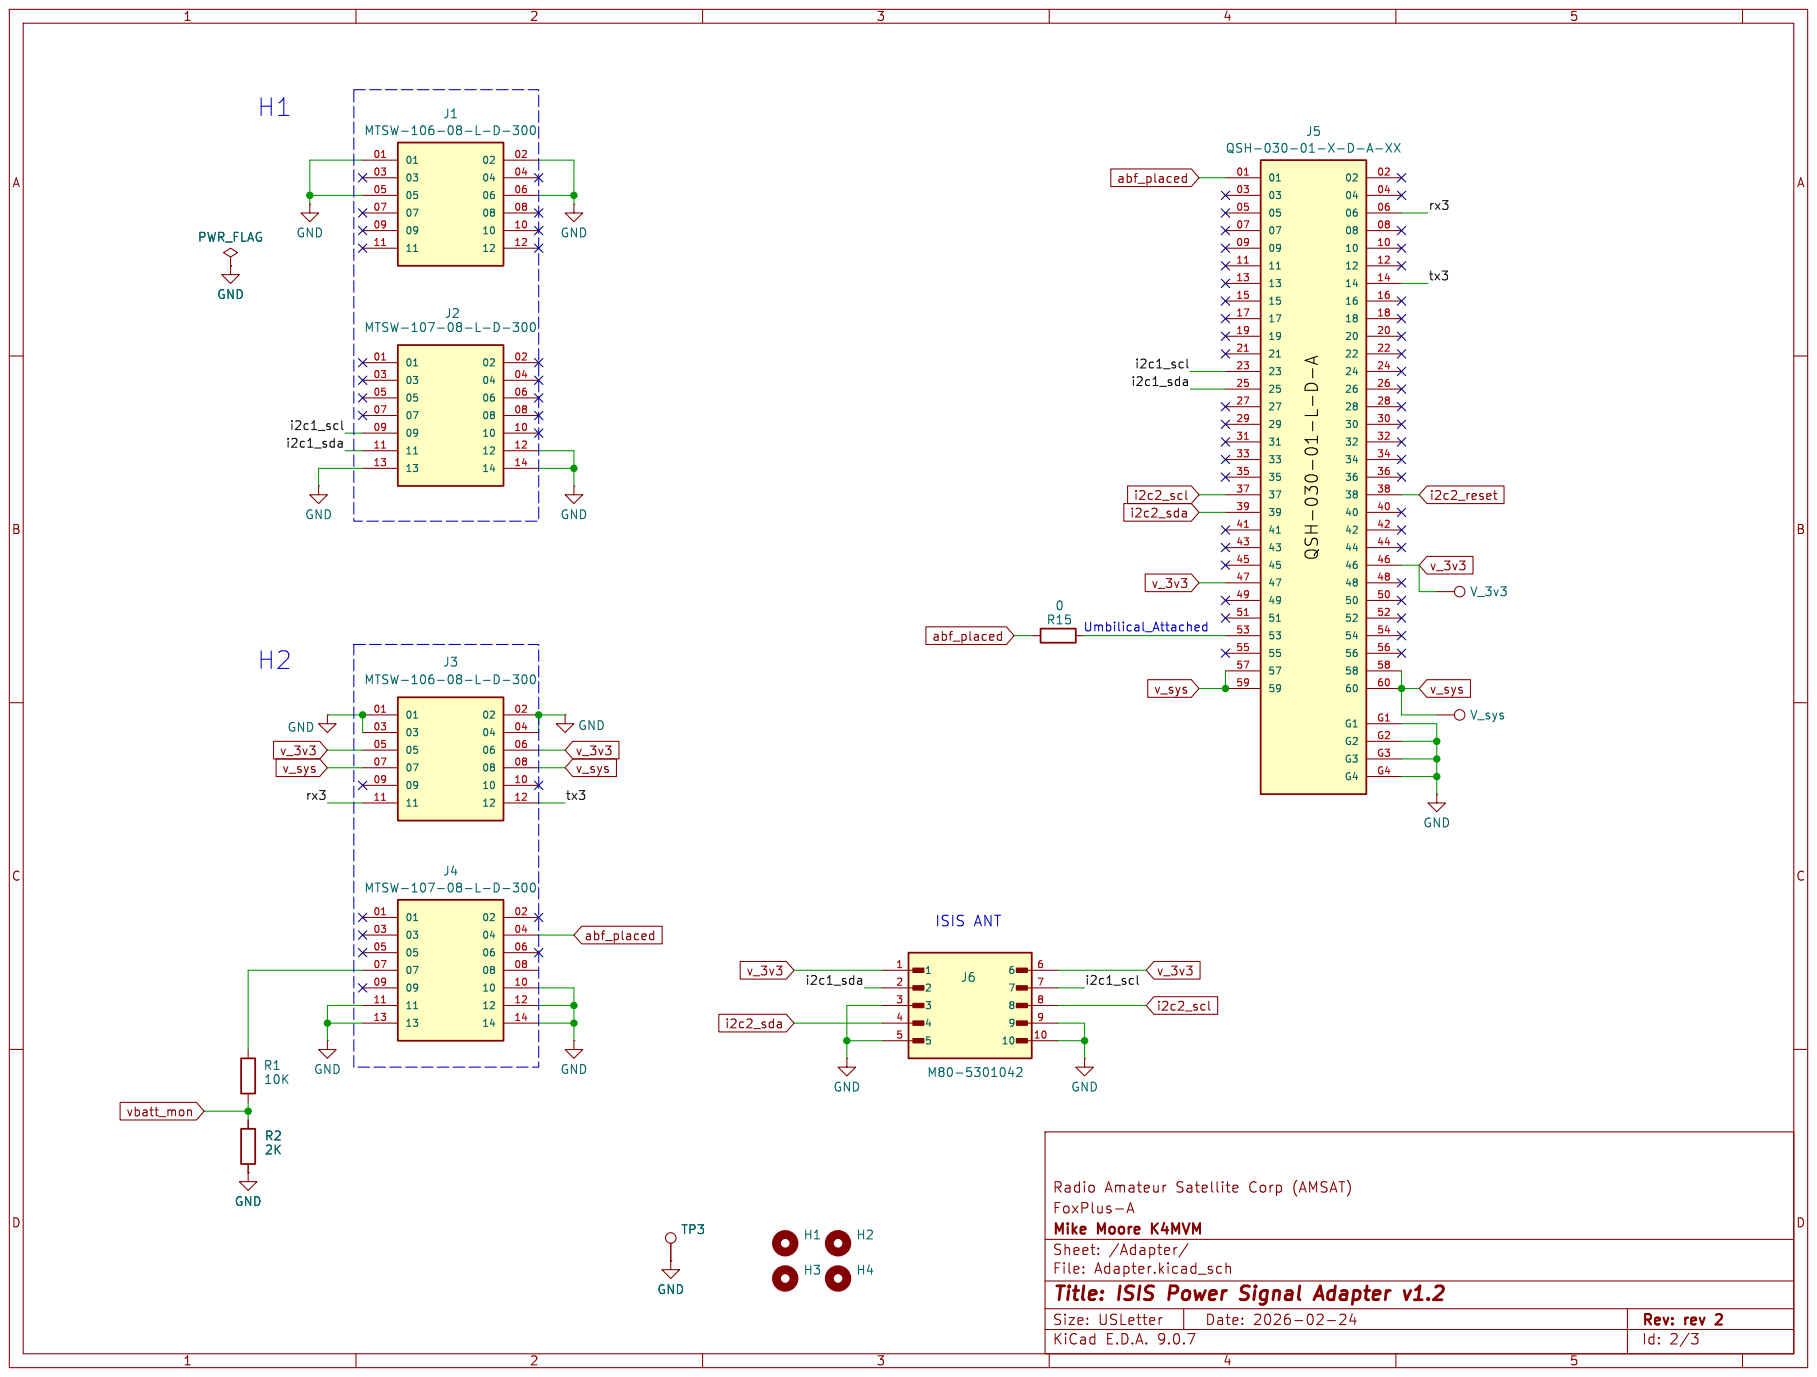
[picture p212: page 2]

Id: 2/3 Title: ISIS Power Signal Adapter v1.2

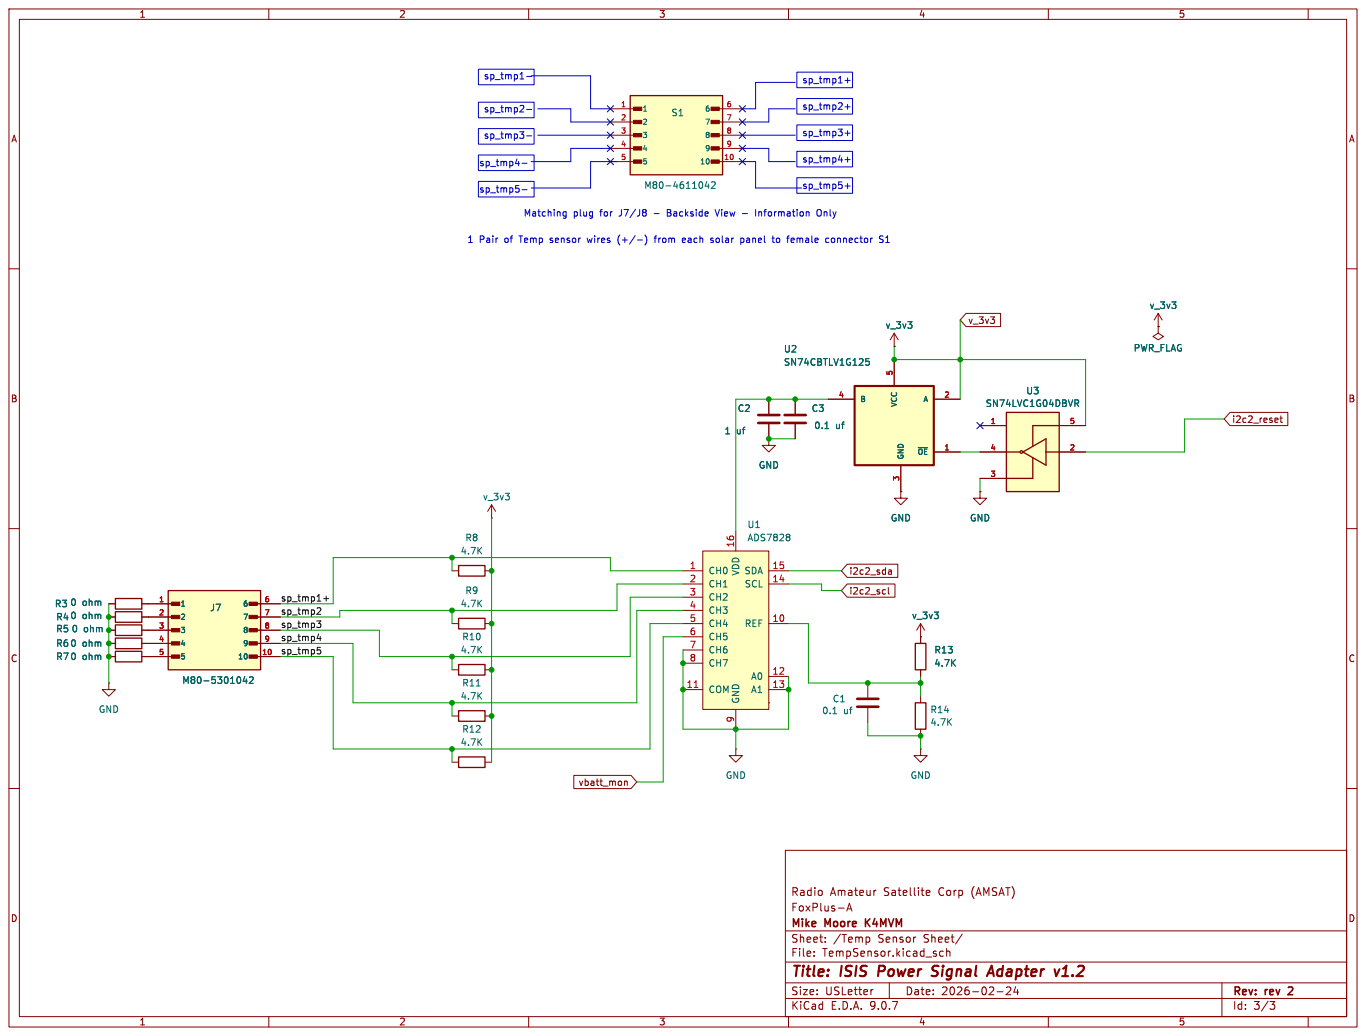
[picture p213: page 3]

FoxPlus-A Radio Amateur Satellite | Corp (AMSAT)

E.D.A. 9.0.7 Size: USLetter | Rev: rev 2 | D Date: 2026-02-24 KiCad

Id: 3/3 Title: ISIS Power Signal Adapter v1.2
