AMSAT-NA/fox-plus/LTM/lihu-sch.pdf

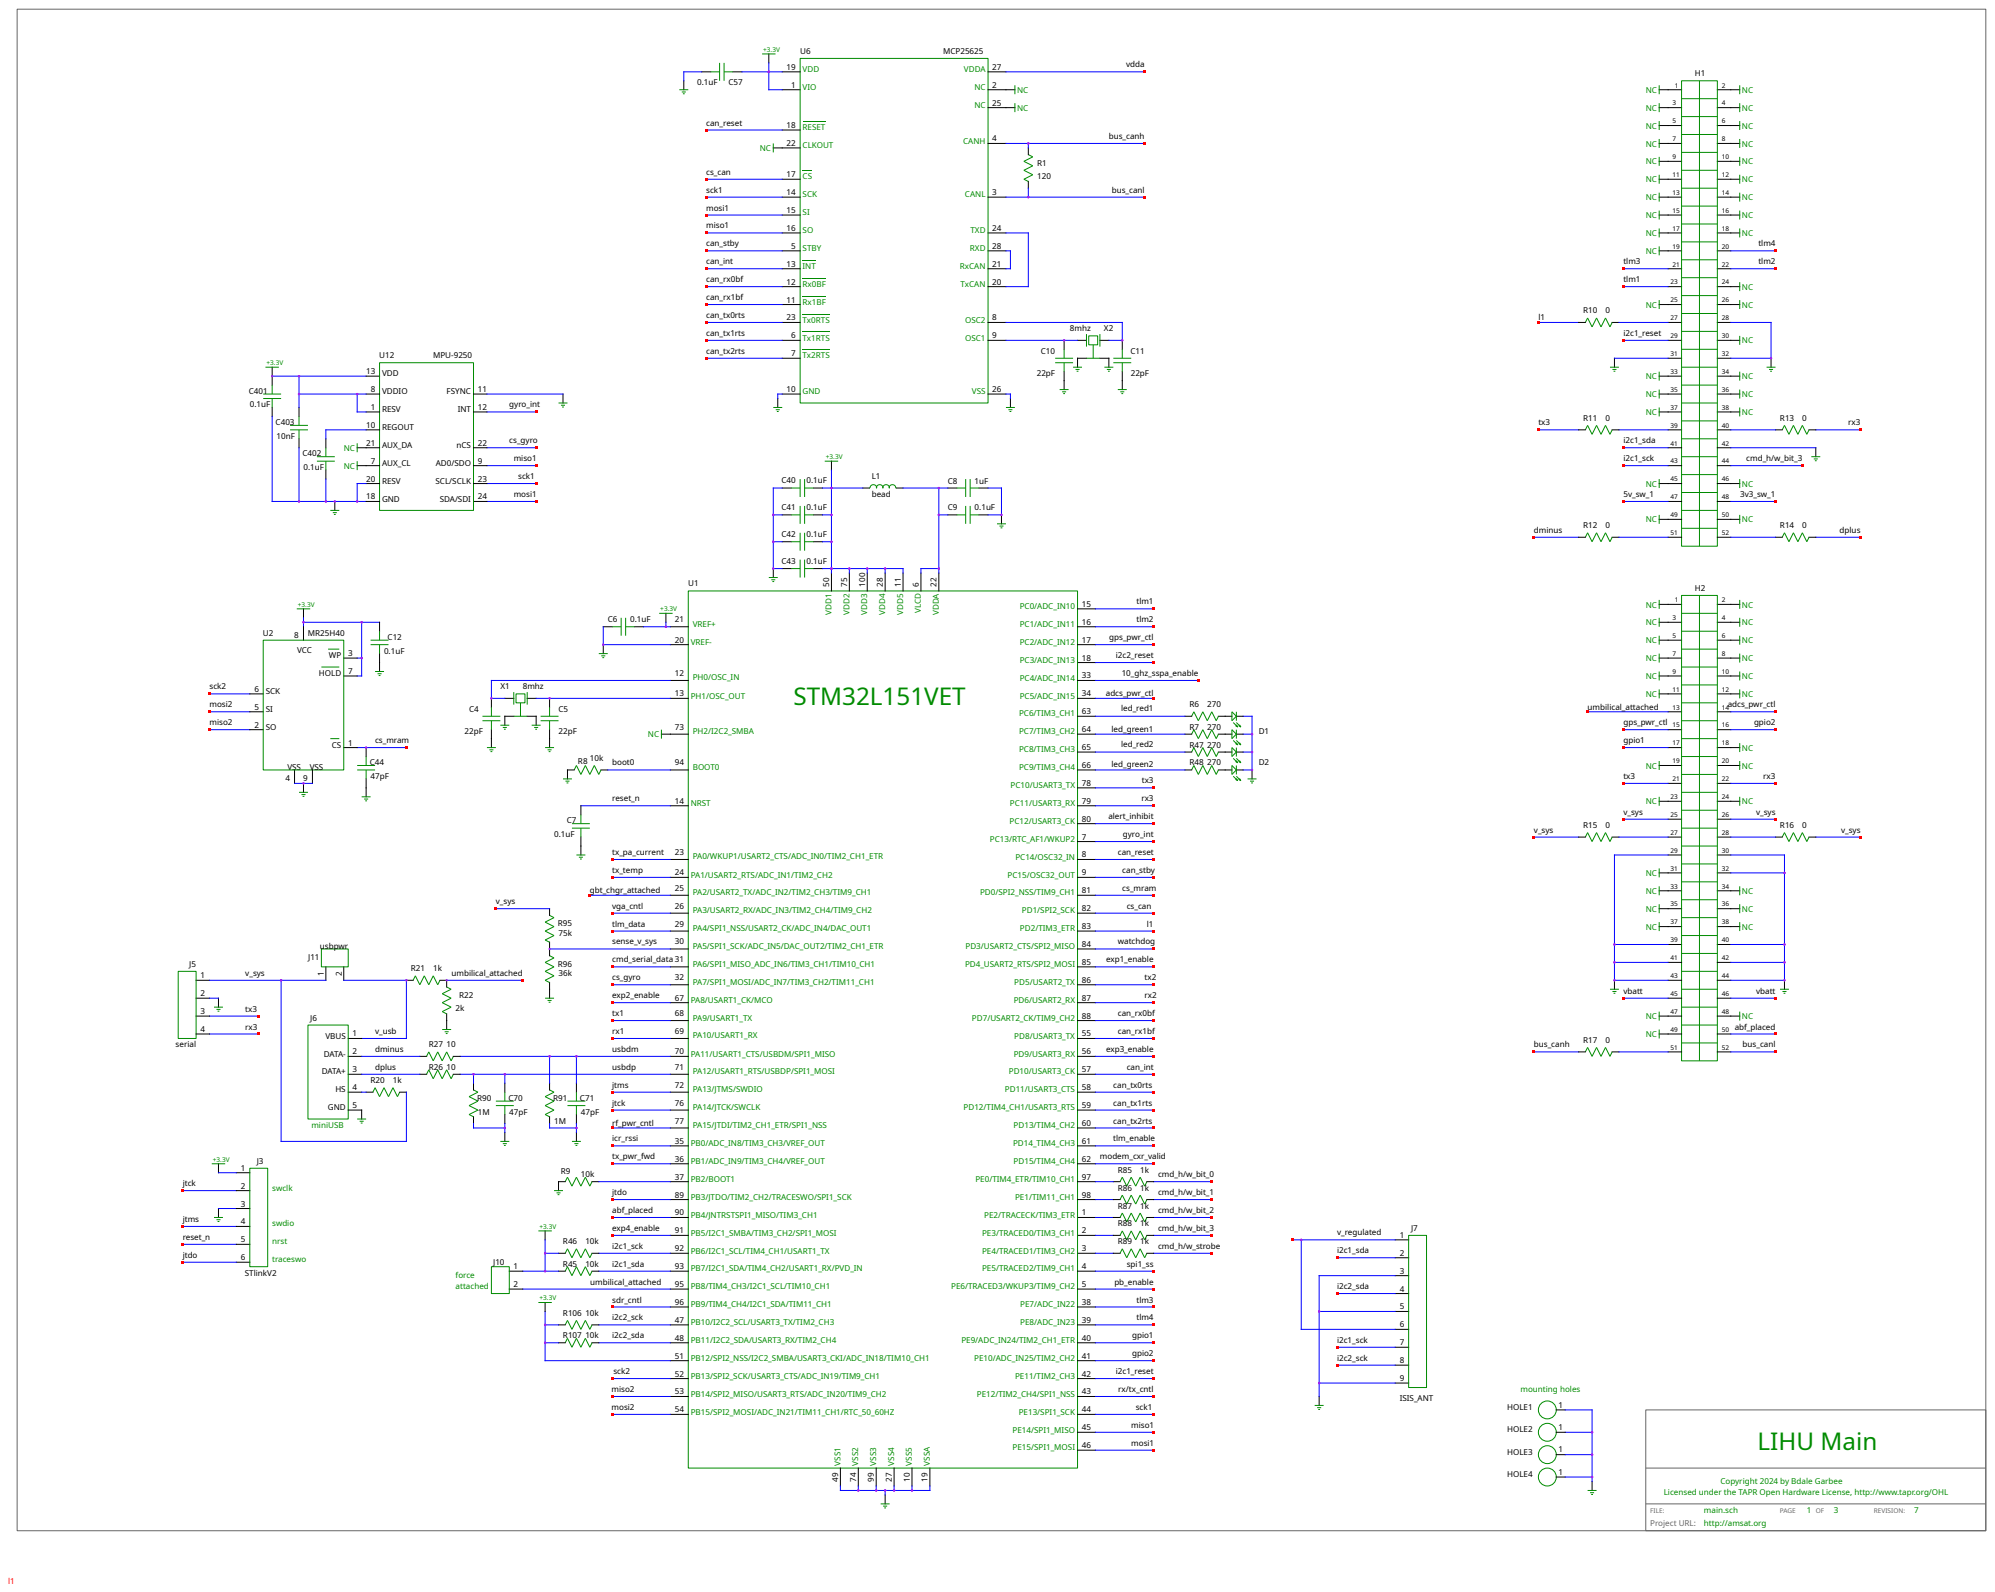
[picture p214: page 1]

Copyright 2024 by Bdale Garbee

Licensed under the TAPR Open Hardware License, http://www.tapr.org/OHL

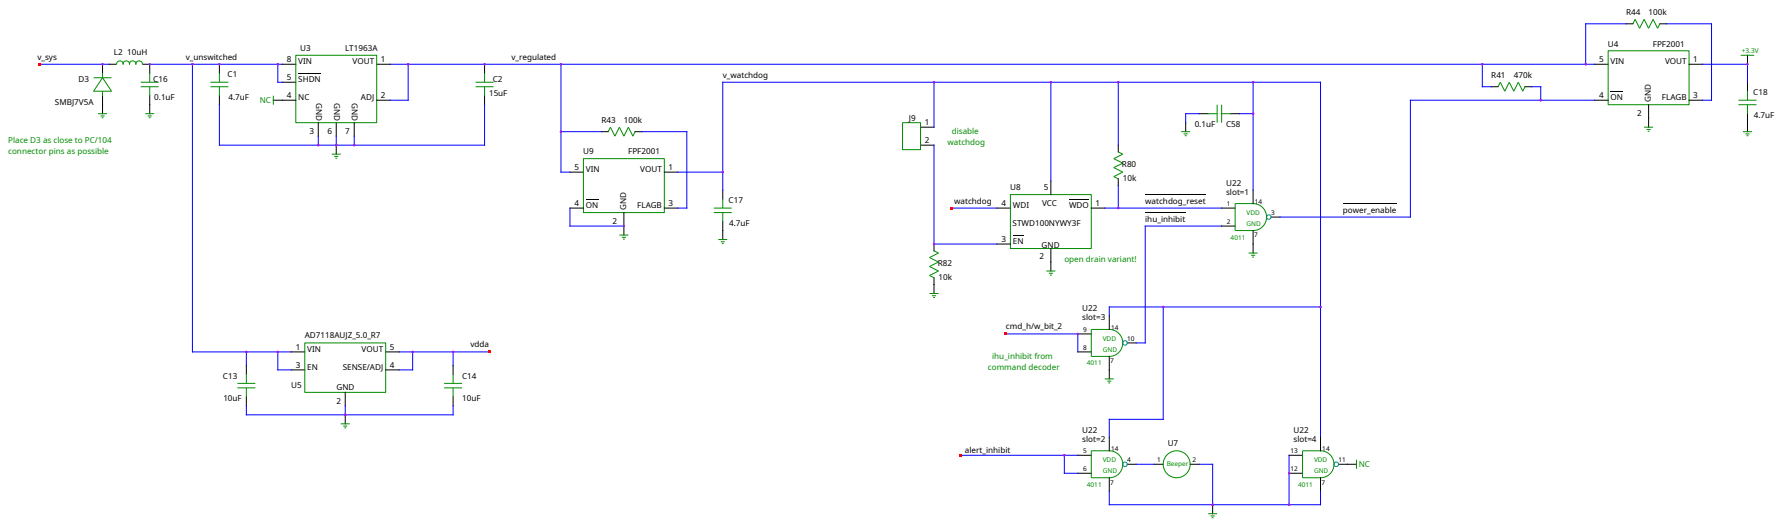
[picture p215: page 2]

Place D3 as close to PC/104
connector pins as possible

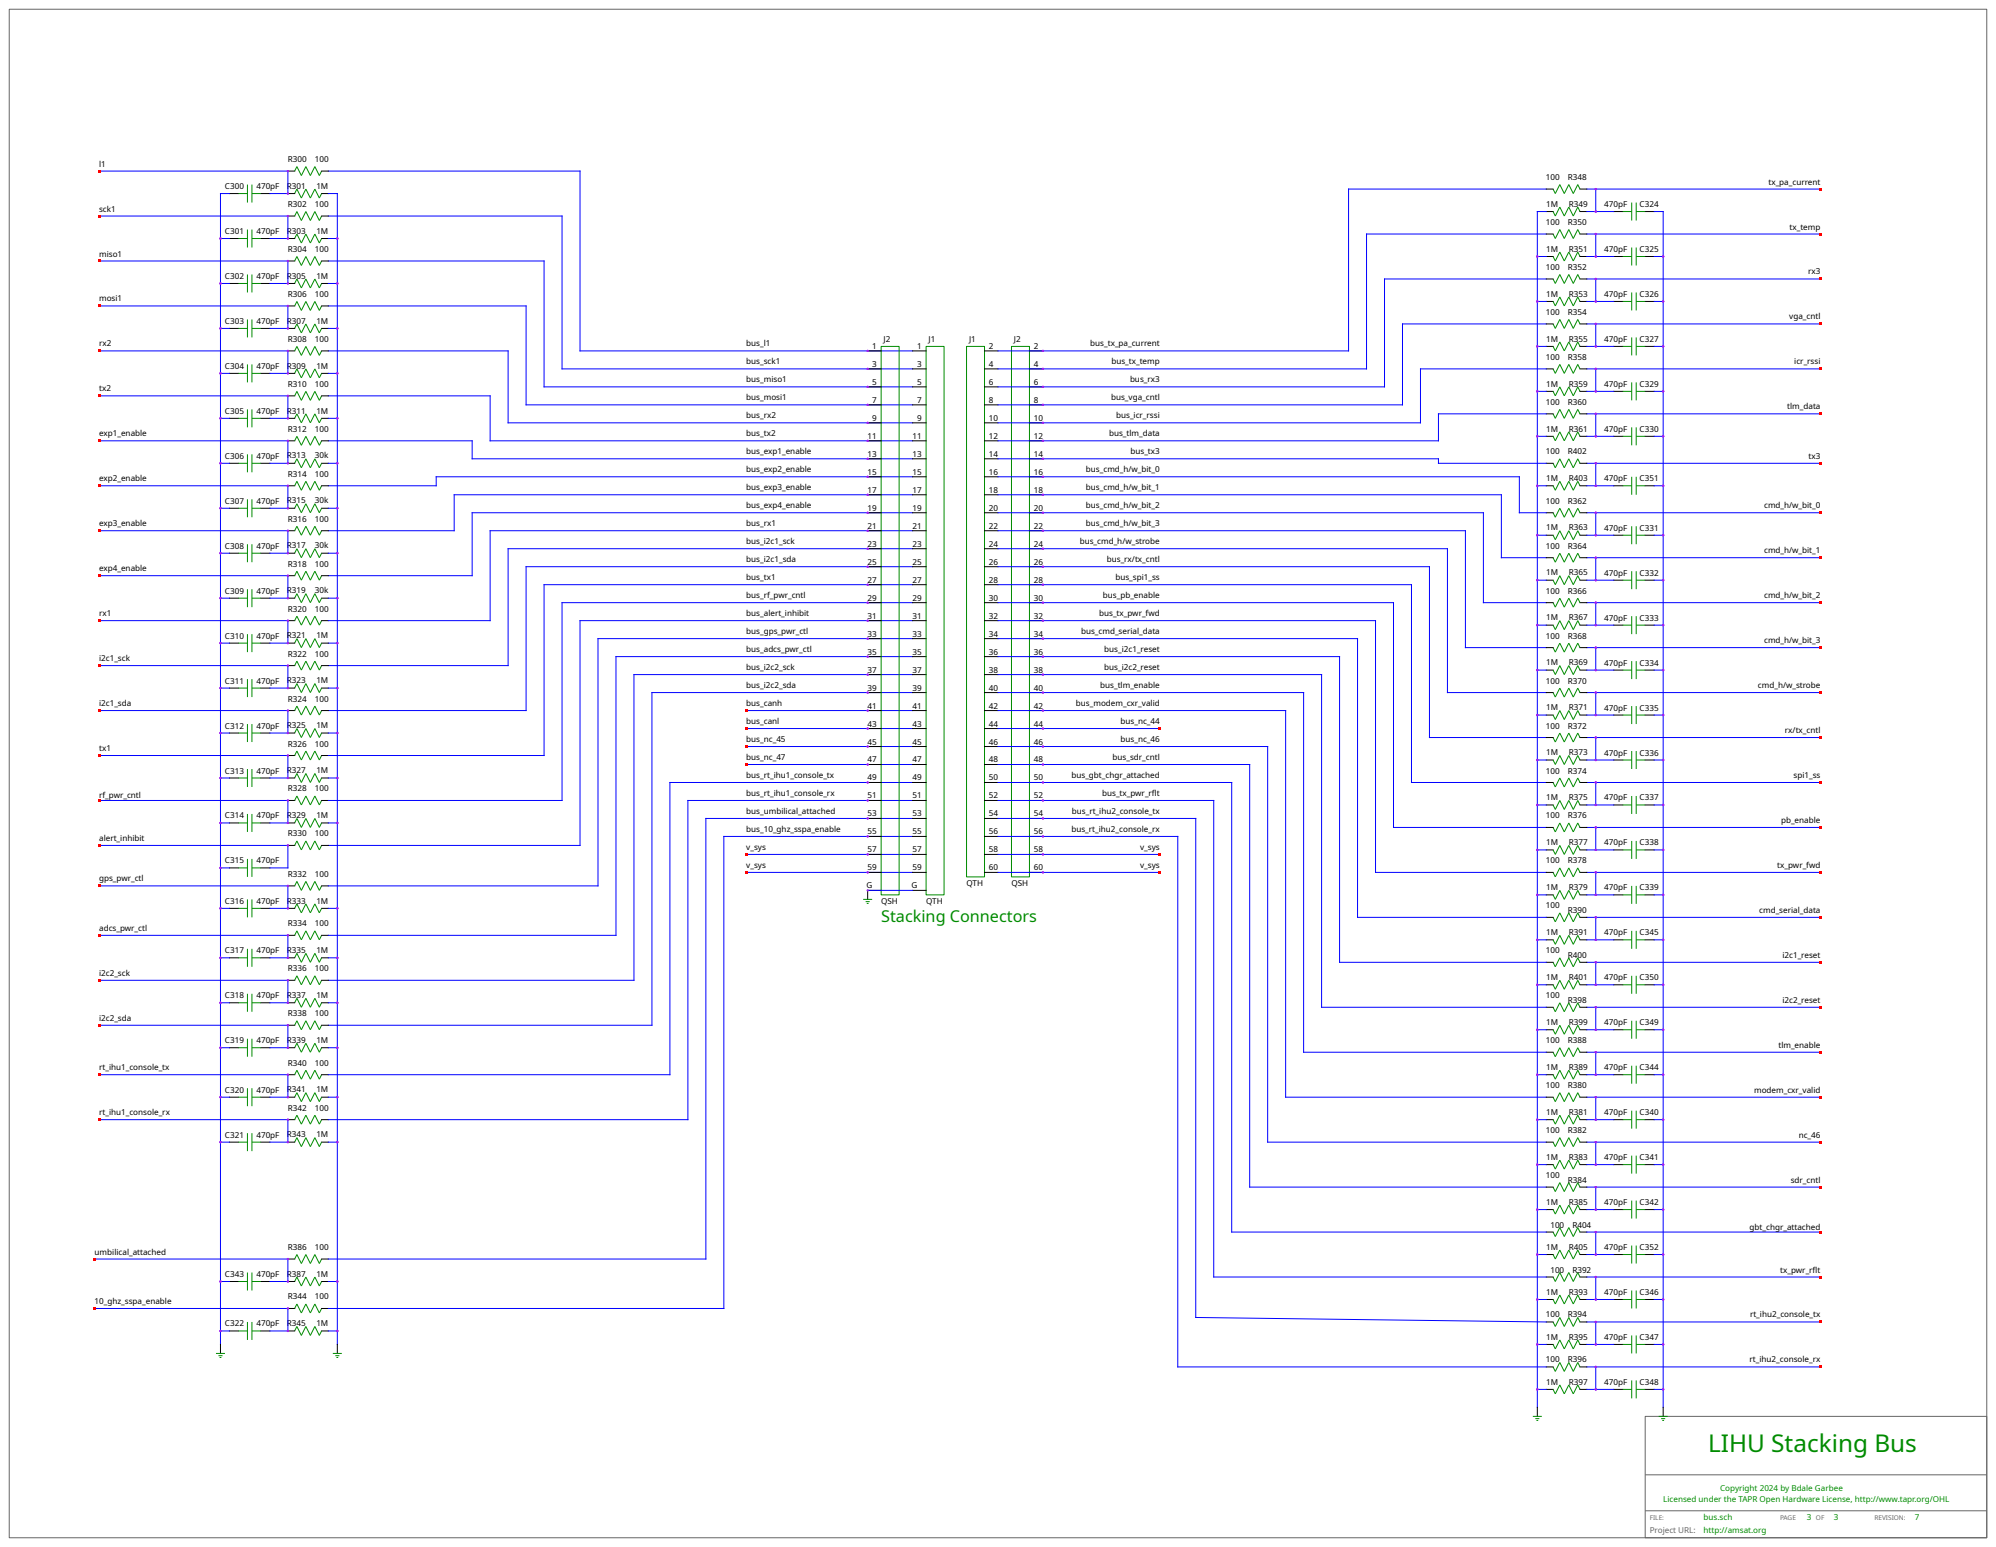
[picture p216: page 3]
