AMSAT-NA/fox-plus/mechanical/Drawings/FOX-ME-204_Adapter_PCB.pdf

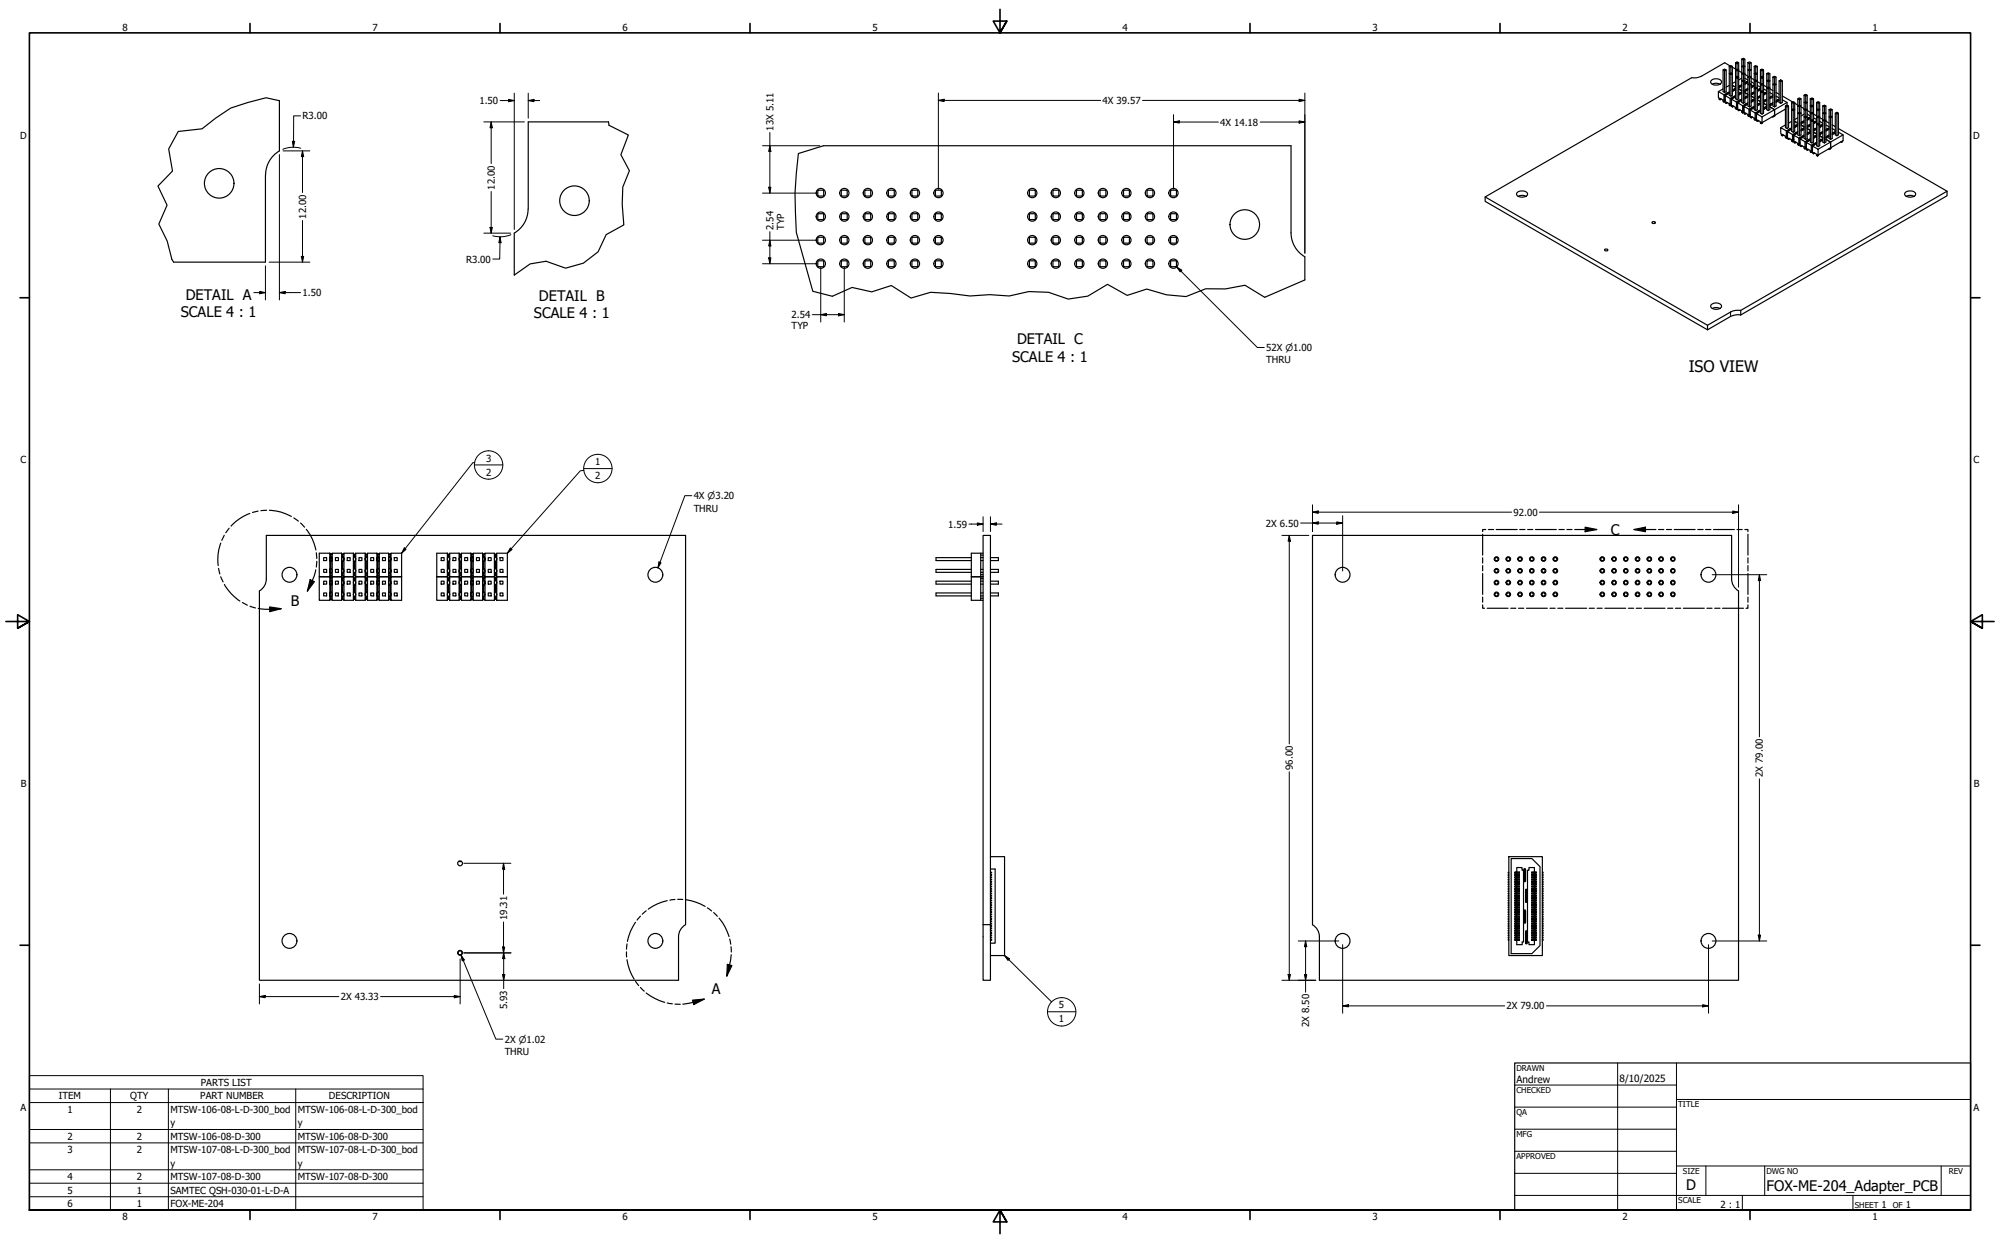
[picture p217: page 1]
DETAIL A SCALE 4 : 1; DETAIL B SCALE 4 : 1; DETAIL C SCALE 4 : 1; PARTS LIST; SHEET 1 OF 1; ISO VIEW

DRAWN Andrew | 8/10/2025

CHECKED

ITEM | QTY | PART NUMBER | DESCRIPTION
1 | 2 | MTSW-106-08-L-D-300_bod y | MTSW-106-08-L-D-300_bod y

3 | 2 | MTSW-107-08-L-D-300_bod y | MTSW-107-08-L-D-300_bod y

SIZE D | DWG NO FOX-ME-204_Adapter_PCB | REV

4 | 2 | MTSW-107-08-D-300 | MTSW-107-08-D-300
5 | 1 | SAMTEC QSH-030-01-L-D-A
