AMSAT-NA/fox-plus/systems_engineering/Compliance + Testing/spec_dwgs_rev13cds.pdf

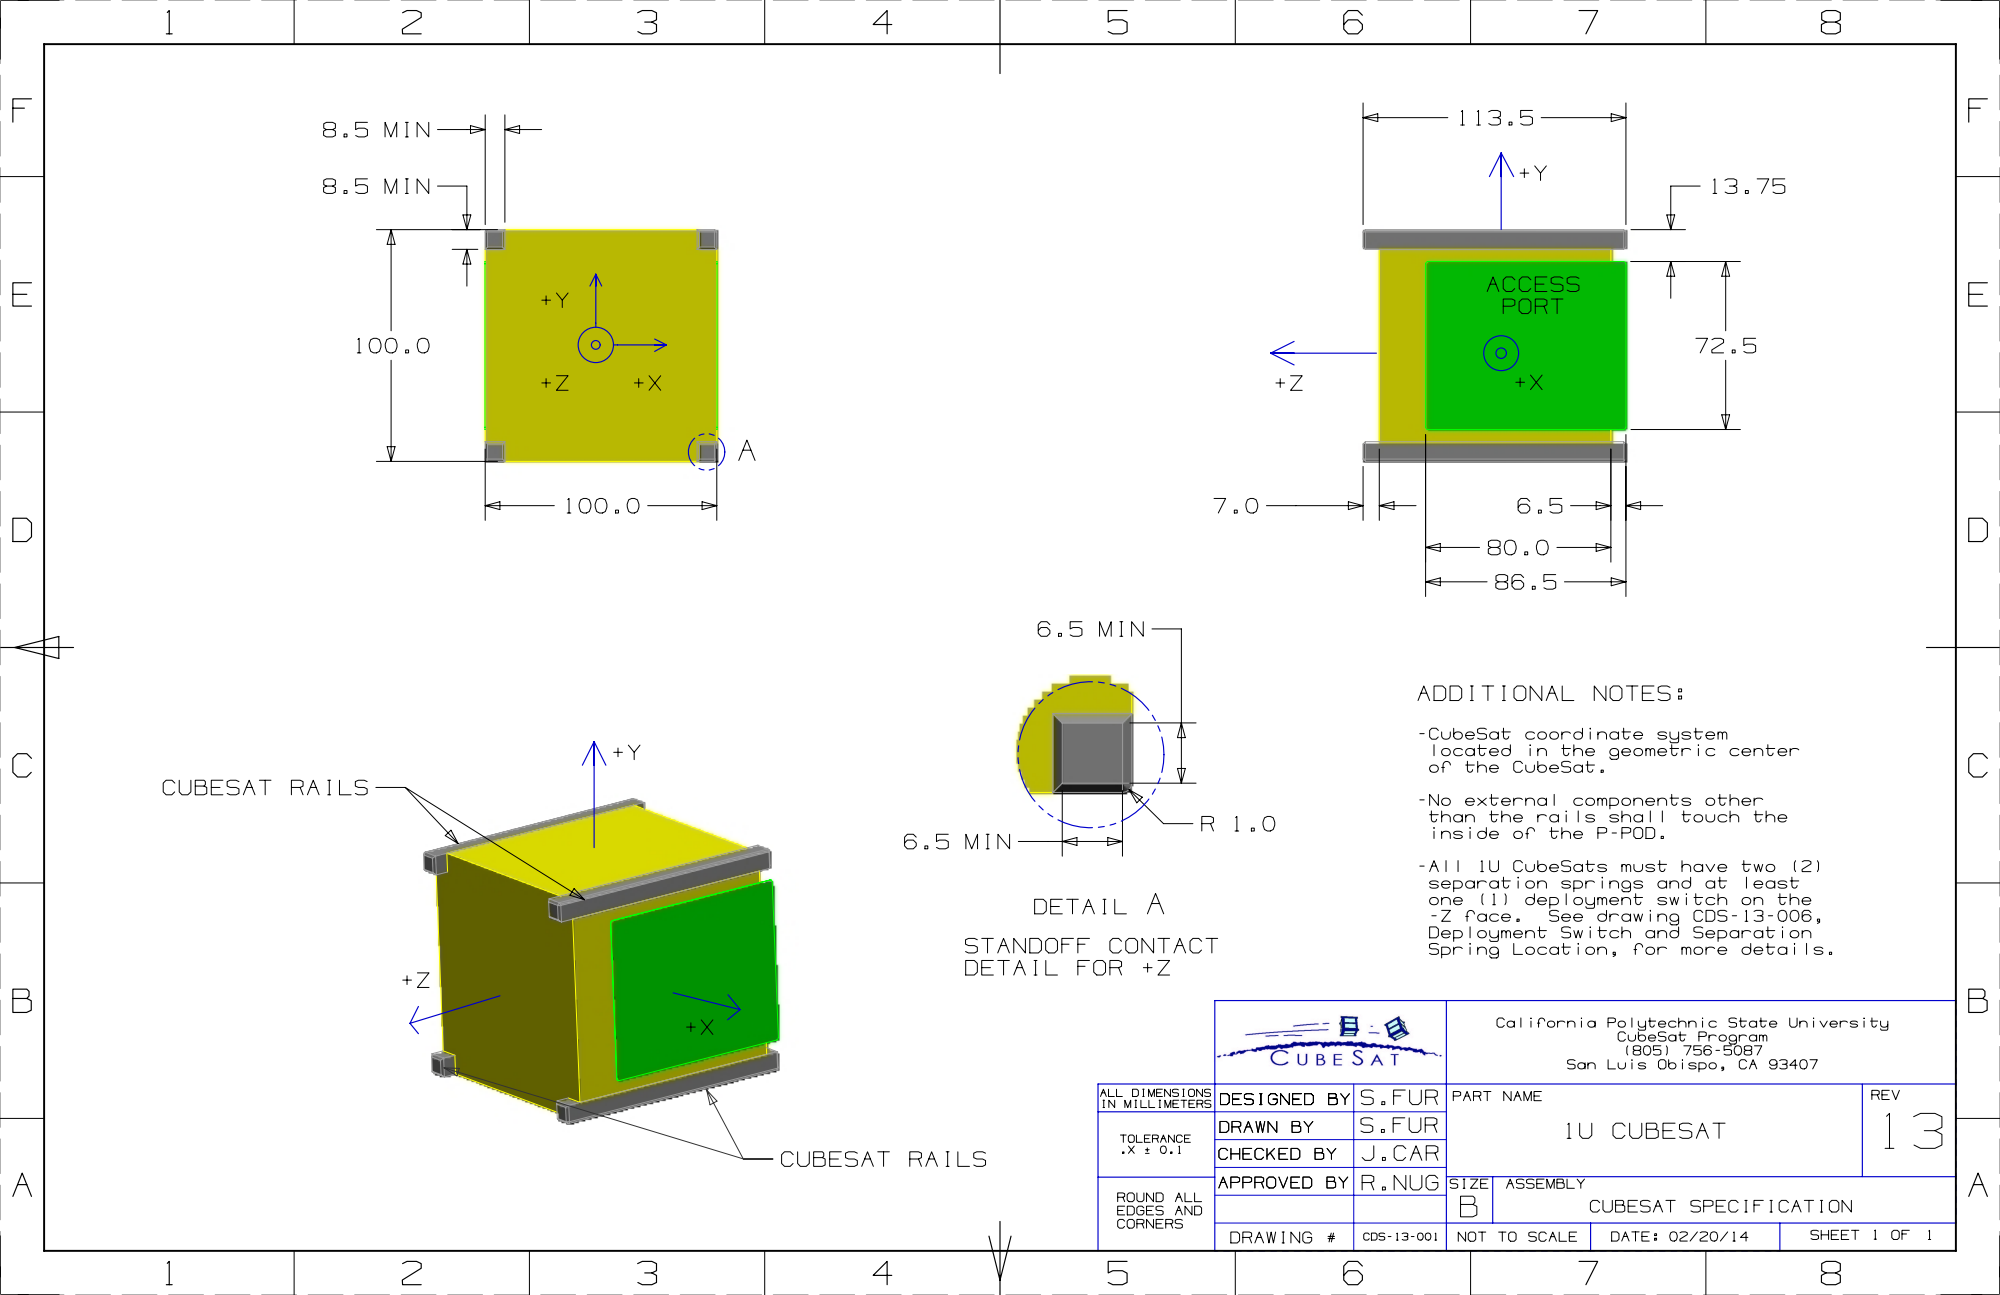
[picture p218: page 1]

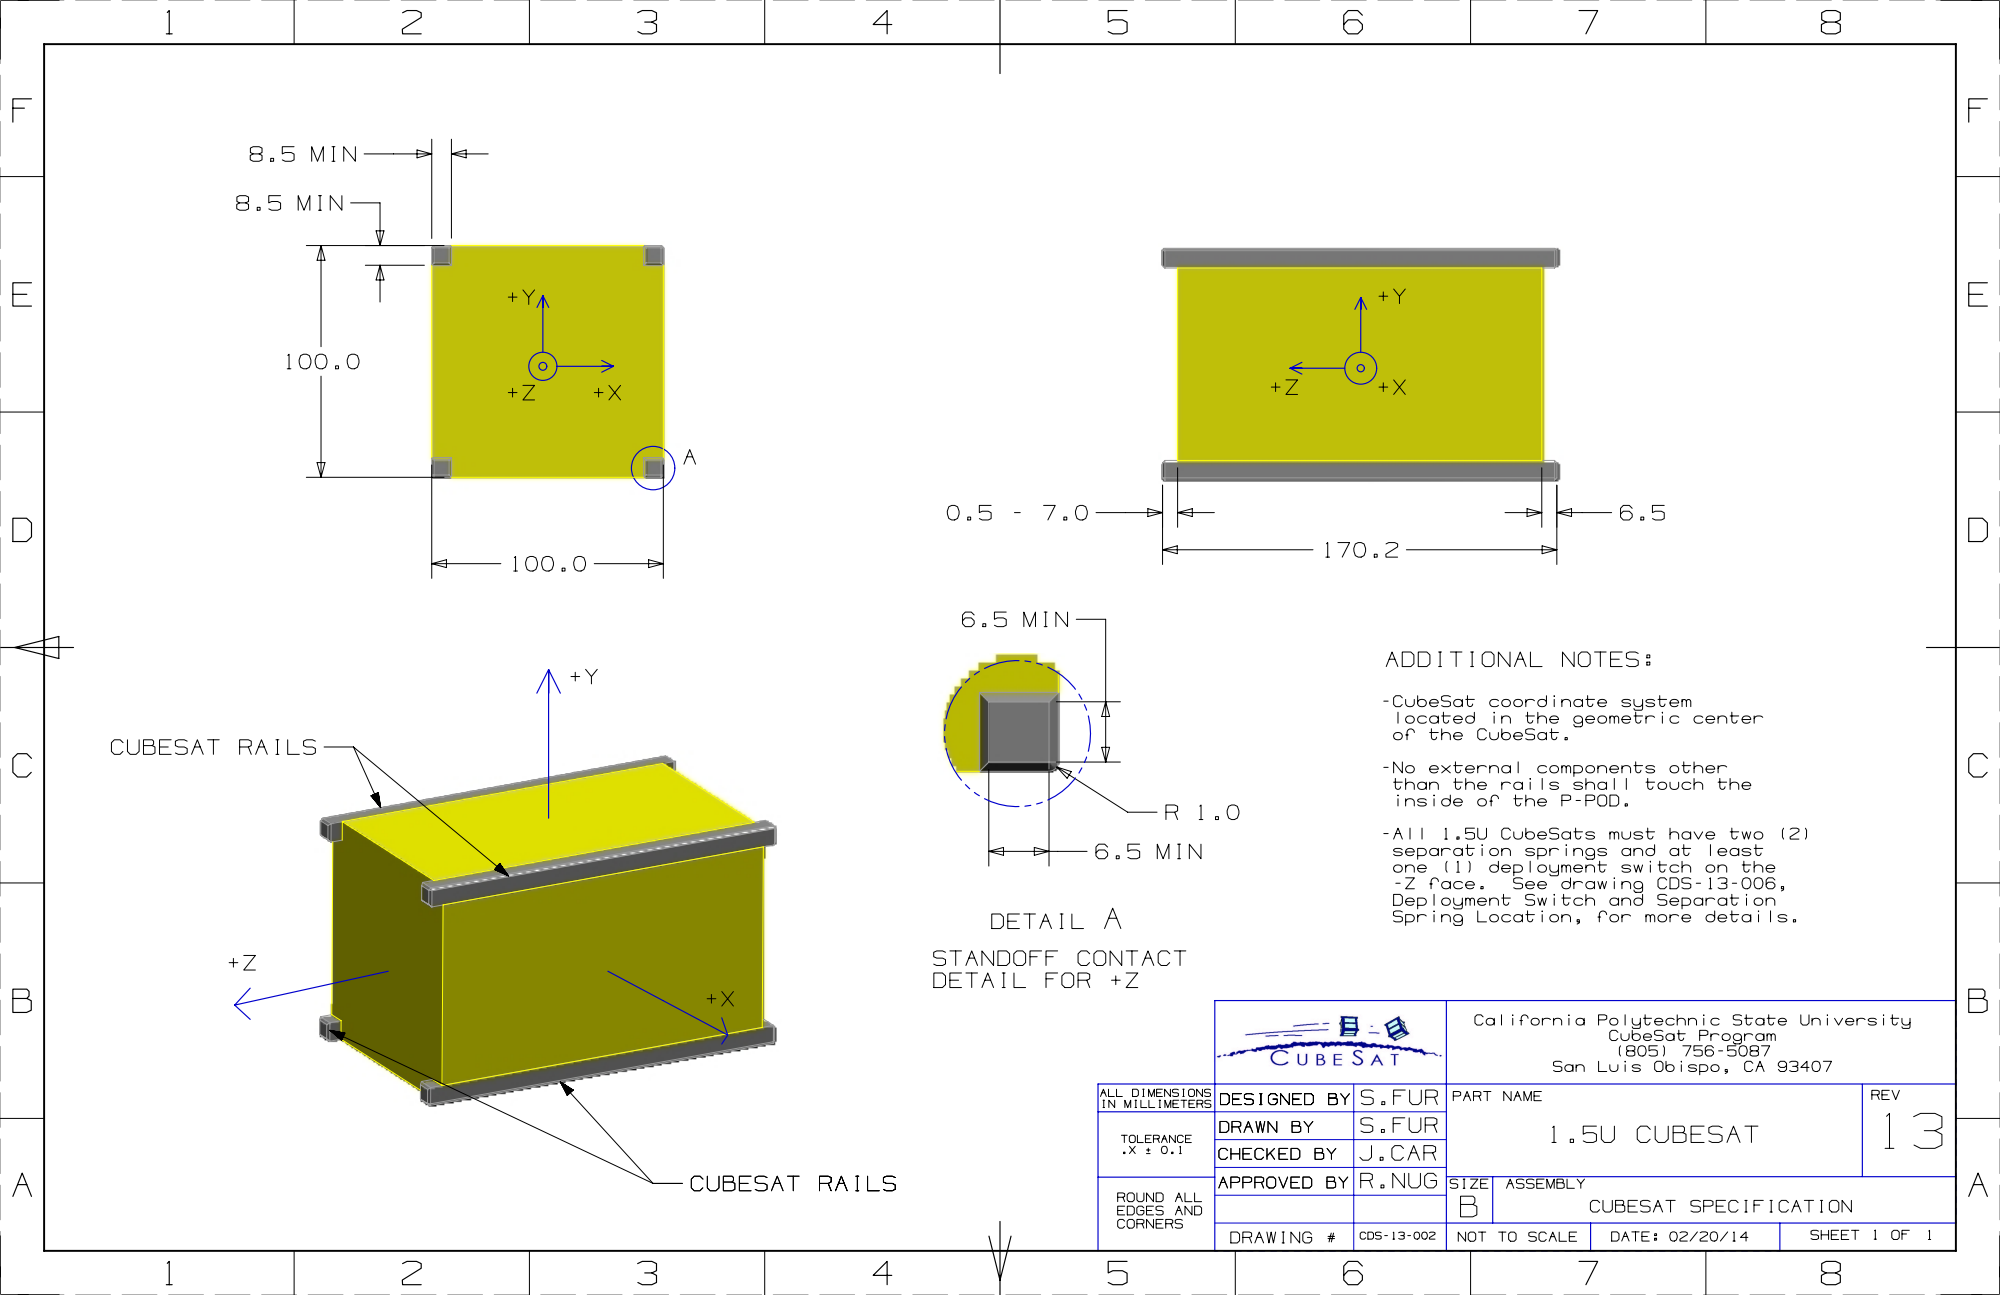
[picture p219: page 2]

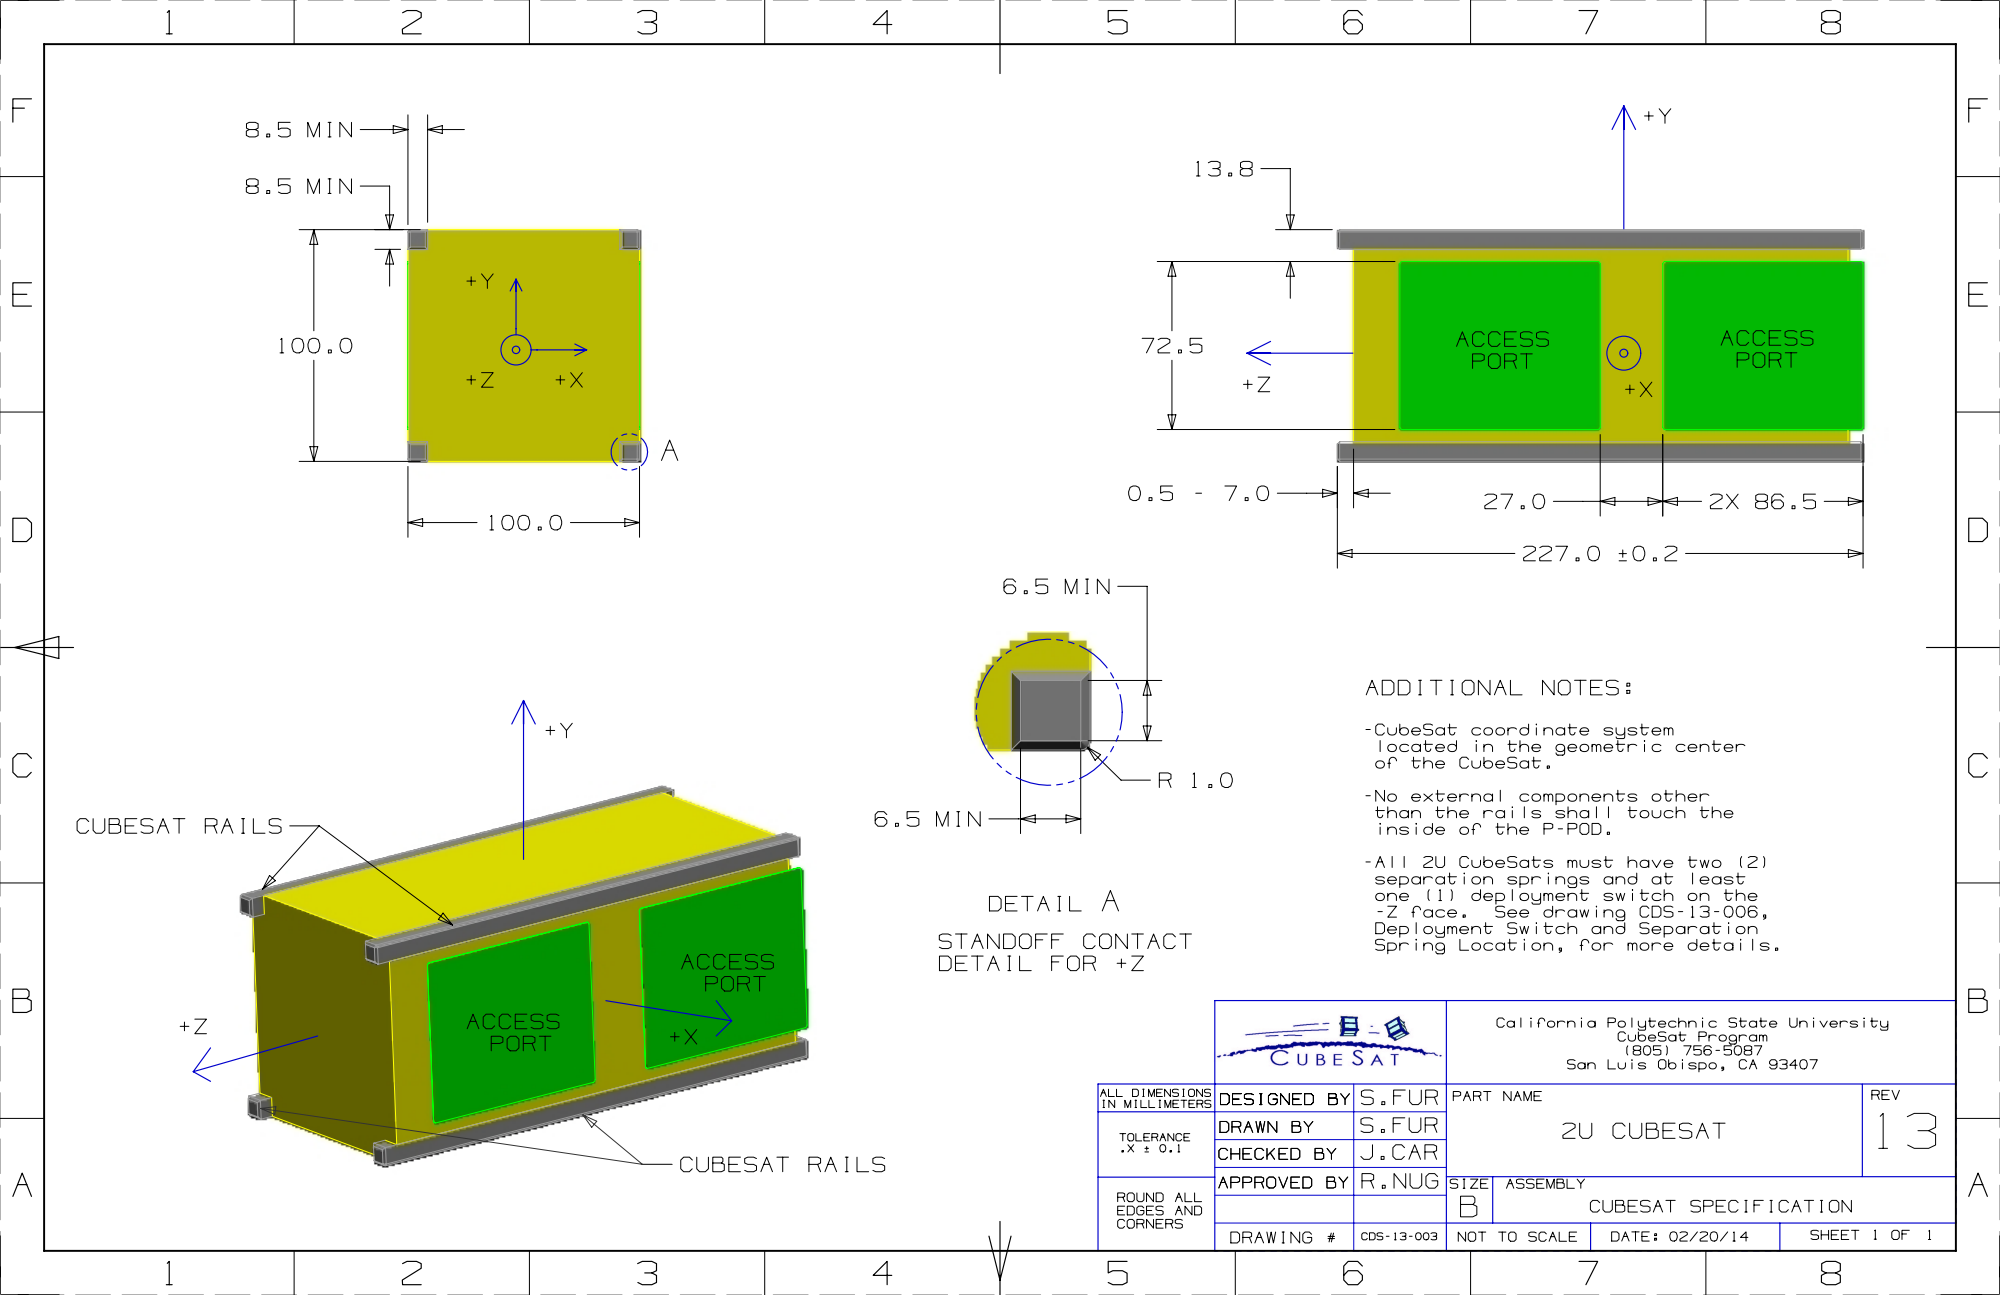
[picture p220: page 3]

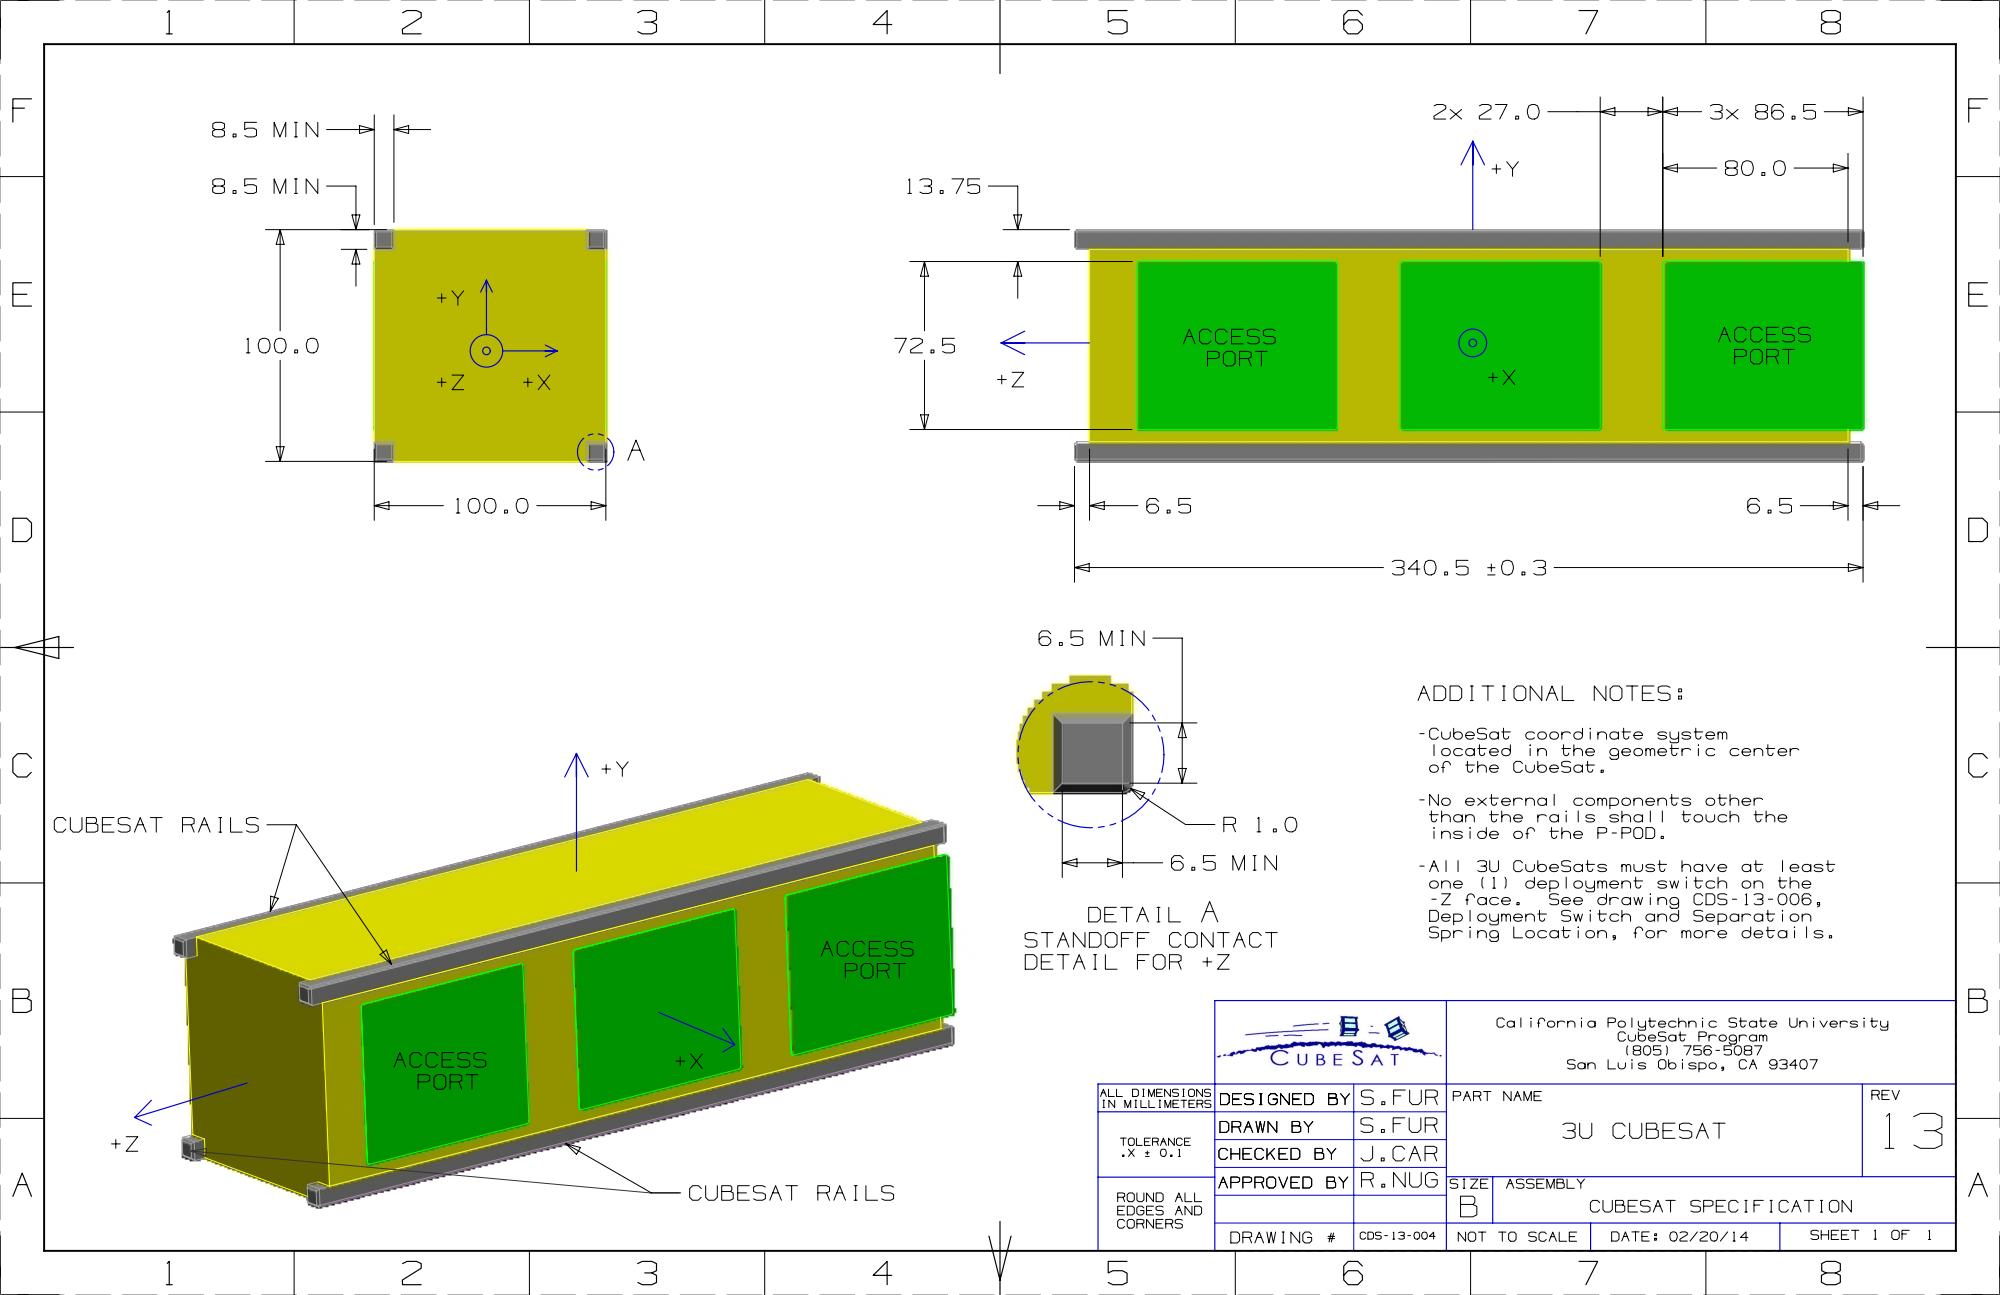
[picture p221: page 4]

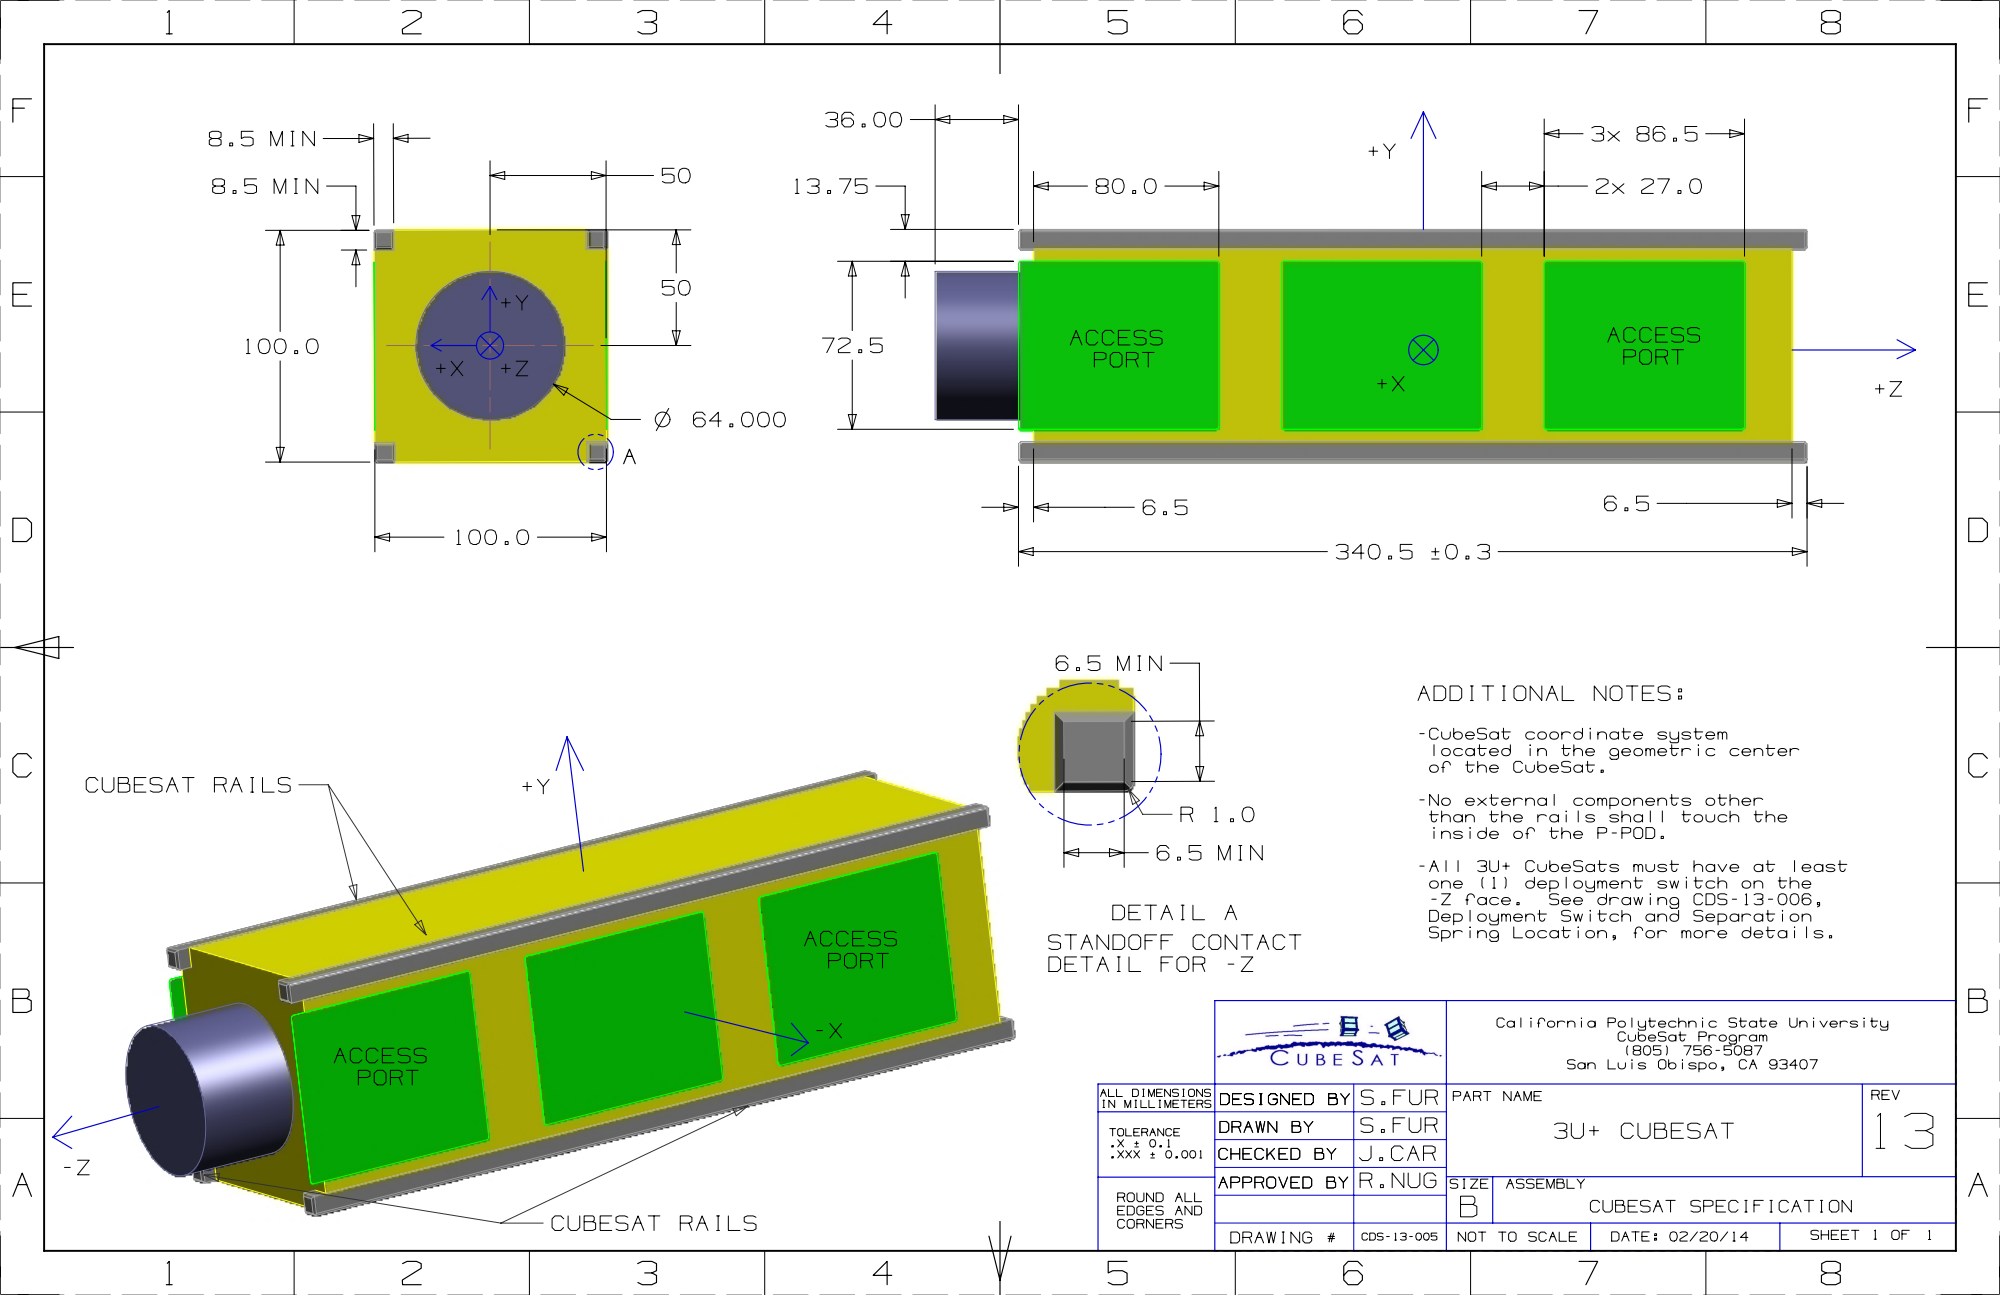
[picture p222: page 5]
