AMSAT-NA/fox-plus/(commit log)

2022-09-02 Add fox-plus structure files, engineering meeting presentations, and initial requirements spec
    [0805_generic.ipt, 1.5U - Fox+.SLDPRT, 1.5U_CubeSat_Specification.SLDASM, 1.5U_RailSystem.SLDPRT, 1.5U_Volume.SLDPRT, 1U_CubeSat_Specification.SLDASM, 1U_RailSystem.SLDPRT, 1U_Volume.SLDPRT]
2022-09-29 Periodic update
    [1UEnvelopePt1_A.SLDPRT, 1UEnvelopePt2_A.SLDPRT, 1U_CubeSat_Specficiation-A.SLDASM, 1U_CubeSat_Specification-broken.SLDASM]
2022-12-07 Add weekly engineering presentations & structure model
    [1U_4_Stack.iam, 3U_generic_Mar1_4 Stack.iam, 3U_sq_tube_amsat.iam, 90318A201_ULP_SHLDR_SCREW_1-8_4-40.ipt, 90910A682_lpbhtorx_2-56_1-4.ipt, 90910A781_lpbhtorx_2-56_1-8.ipt, 90945A710_NAS620C4L_flat_washer.ipt, 90945A713_NAS620C5_flat_washer.ipt]
2023-02-16 Weekly engineering slides, FoxPlus-A power budget
    [FoxPlus-A Power Budget.ods]
2023-02-19 Update 1U structure adapter. Add block diagram. Add ISISPACE options sheets
    [1U_4_Stack.0142.iam, 1U_4_Stack.iam, RT-IHU_heatsink STANDOFF-MAR1.0030.ipt, RT-IHU_heatsink STANDOFF-MAR1.ipt]
2023-03-16 Add new weekly presentations, draft buss diagrams, bug ICR BOM
    [Fox-Plus Bus draft.ods, ICR FM v2.1 BOM (v1.5) ver LM Feb 15 2023.xls, LIHU FM v2.1 PC-104 Pin Assignments.ods]
2023-03-16 Depending on Git rather than version numbers in filename
    [Fox-Plus Bus.ods]
2023-03-16 Update Fox-Plus bus
    [Fox-Plus Bus.ods]
2023-04-04 Add files via upload
    Fox-1E docs
    [NASA VCLS ELaNa XX Mass Properties.xlsx, RadFxSat-2 Bakeout manual log.xlsx, RadFxSat-2 Venting.xls, RadFxSat-2 mass measurements.xlsx, RadFxSat-2 shock.xlsx]
2023-05-05 Add weekly engineering presentation and 1U frame update
    [1Ufullsystem.iam, BRACKET_KS_007A.0001.ipt, BRACKET_KS_007A.ipt, BRACKET_KS_007B.0001.ipt, BRACKET_KS_007B.ipt, BUSJE_001.0001.ipt, BUSJE_001.ipt, HELICOIL_M3_1_5D.0001.ipt]
2023-06-10 Add more weekly engineering presentations and update Fox-Plus structure model
    [1Ufullsystem.0010.iam, 1Ufullsystem.iam, 91292A112_18-8 Stainless Steel Socket Head Screw.ipt, 92125A132_18-8 Stainless Steel Hex Drive Flat Head Screw.ipt, 93655A419_Male-Female Threaded Hex Standoff.ipt, 93655A704_Male-Female Threaded Hex Standoff (1).ipt, BRACKET_KS_007A.0001.ipt, BRACKET_KS_007A.ipt]
2024-04-21 Add assembly model and associated part models
    [ANTS1_TOPPANEL.ipt, BRACKET_KS_007A.ipt, BRACKET_KS_007B.ipt, BUSJE_001.ipt, Fox_Plus_AssemblyModel.iam, HELICOIL_M3_1_5D.ipt, INTEGRATED_SIDE_FRAME_007B_ASM.iam, ISIS CubeSat STS PC104 Skeleton.iam]
2024-04-24 Add MEL and Coordinate Document strawman.
    [FoxPlusMEL.xlsx]
2024-04-24 Update SV Model with ISISpace EPS.
    [Fox_Plus_AssemblyModel.iam]
2024-10-15 Added Fox Mechanical List and FOX-ME-201 drawing
    [Fox Mechanical List.xls]
2025-08-02 Added initial release of Adapter PCB drawing
2025-08-02 FOX-ME-204 added to drawing list
    [Fox Mechanical List.xls]
2025-08-09 Update Fox Mechanical List.xls
    [Fox Mechanical List.xls]
2025-08-10 FOX-ME-204 Adapter PCB drawing added
    [Fox Mechanical List.xls]
2025-08-10 Update to Coordinate System PPT
    [Fox Mechanical List.xls]
2025-08-10 Mechanical folder cleanup - deleted duplicate PPT and out-of-date model
    [ANTS1_TOPPANEL.ipt, BRACKET_KS_007A.ipt, BRACKET_KS_007B.ipt, BUSJE_001.ipt, Fox_Plus_AssemblyModel.iam, HELICOIL_M3_1_5D.ipt, INTEGRATED_SIDE_FRAME_007B_ASM.iam, ISIS CubeSat STS PC104 Skeleton.iam]
2025-08-18 Learning git upload, first timer
2025-08-30 Added info and tracker for recent mechanical orders
    [FoxPlusFabricationTracker.xlsx]
2025-09-01 Update FOX-ME-204 adapter drawing
    [Fox Mechanical List.xls]
2025-11-05 Corrected schematic
2025-11-22 New spreadsheet for FoxPlus-A Cables & Connectors
2025-12-01 4 layer PSA board pdf and KiCad zip
2025-12-01 deleting files superseded by new version
    [adapter card v2.kicad_pcb, adapter card v2.kicad_sch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]
2025-12-10 Deleted rather than archived past versions of PSA board
2025-12-13 v1.3 only differs from v1.2 in that the resistors and capacitors are 0805
2026-03-04 Delete PowerSig_Adapter/PowerSig_Adapter_v1.3.zip
    This file no longer valid
2026-03-12 Add files via upload
    Harwin 26p Connector
2026-03-17 Delete PowerSig_Adapter/PowerSigAdapter_v1.2.pdf
    Obsolete - new version posted
2026-09-28 Add files via upload
    Cables listing for FoxPlus-A with the latest USB umbilical included
2026-09-28 USB-C for umbilical cable
